TactileImages/TactilePrinterOne-P4/Imprimanta 2 Metal A3/30 Injectomat/syringe-100ml-1.snapshot.1/Syringe_100ml.jpg

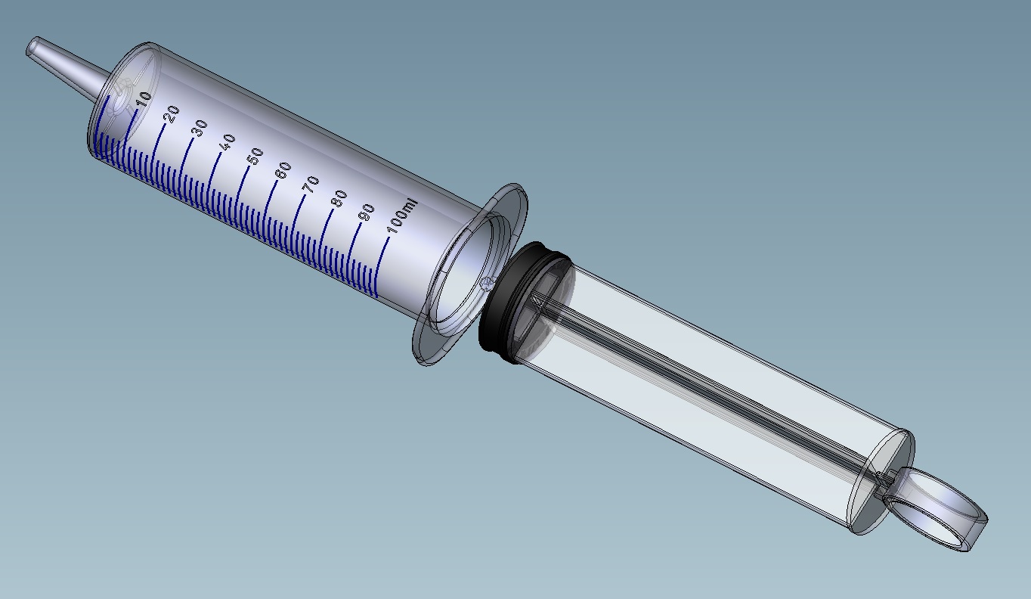
Imprimanta 2 Metal A3/30 Injectomat/syringe-100ml-1.snapshot.1/Syringe_100ml.jpg
