TactileImages/TactilePrinterOne-P4/Imprimanta 2 Metal A3/10 Mecanic/Seringa/medical-syringe-for-single-use-50ml-1.snapshot.3/Spritze-leer.JPG

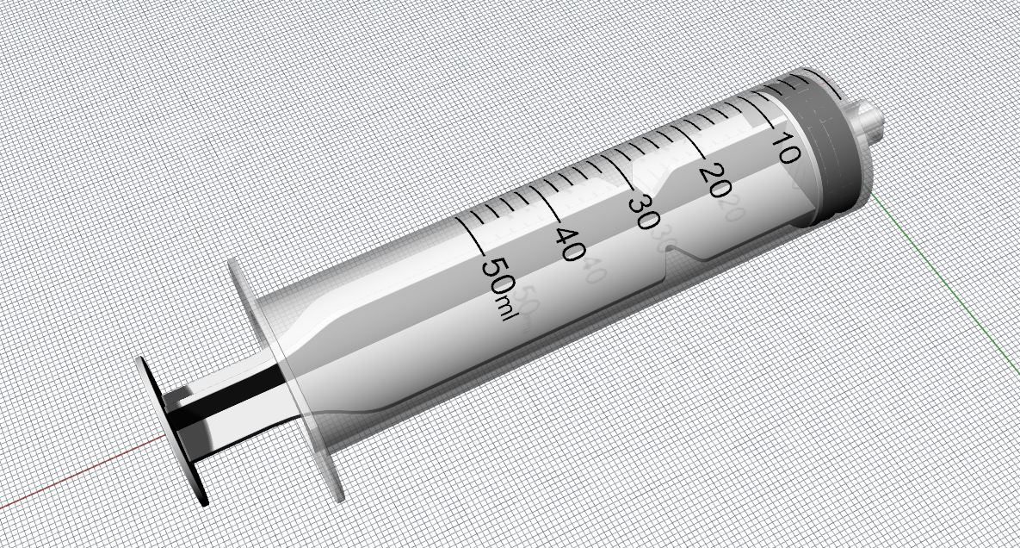
Imprimanta 2 Metal A3/10 Mecanic/Seringa/medical-syringe-for-single-use-50ml-1.snapshot.3/Spritze-leer.JPG
