TactileImages/TactilePrinterOne-P4/Imprimanta 2 Metal A3/10 Mecanic/Seringa/medical-syringe-for-single-use-50ml-1.snapshot.3/Spritze-voll.JPG

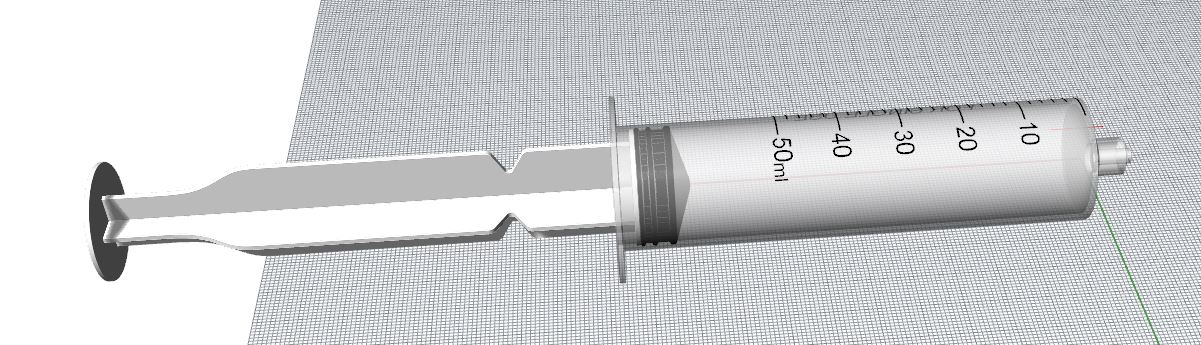
Imprimanta 2 Metal A3/10 Mecanic/Seringa/medical-syringe-for-single-use-50ml-1.snapshot.3/Spritze-voll.JPG
