TactileImages/TactilePrinterOne-P4/Imprimanta 2 Metal A3/10 Mecanic/Seringa/parametric-50ml-single-use-syringe-1.snapshot.1/Syringe 50ml v10.png

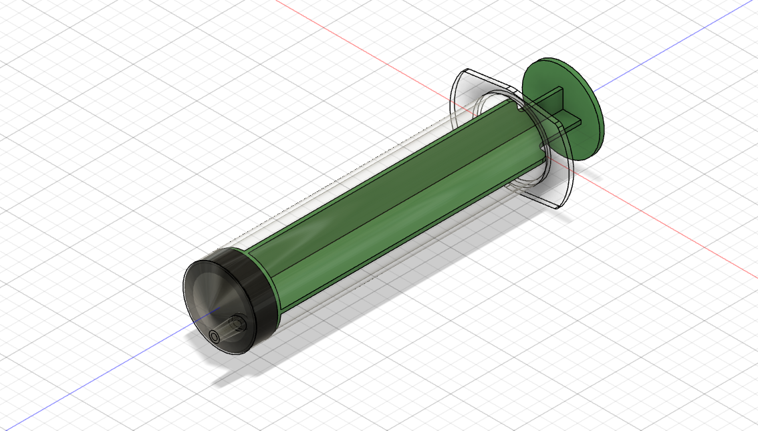
Imprimanta 2 Metal A3/10 Mecanic/Seringa/parametric-50ml-single-use-syringe-1.snapshot.1/Syringe 50ml v10.png
