TactileImages/TactilePrinterOne-P4/Imprimanta_1_Lemn/10 Mecanic/Seringa/21-gauge-needle-1.snapshot.2/Needle.png

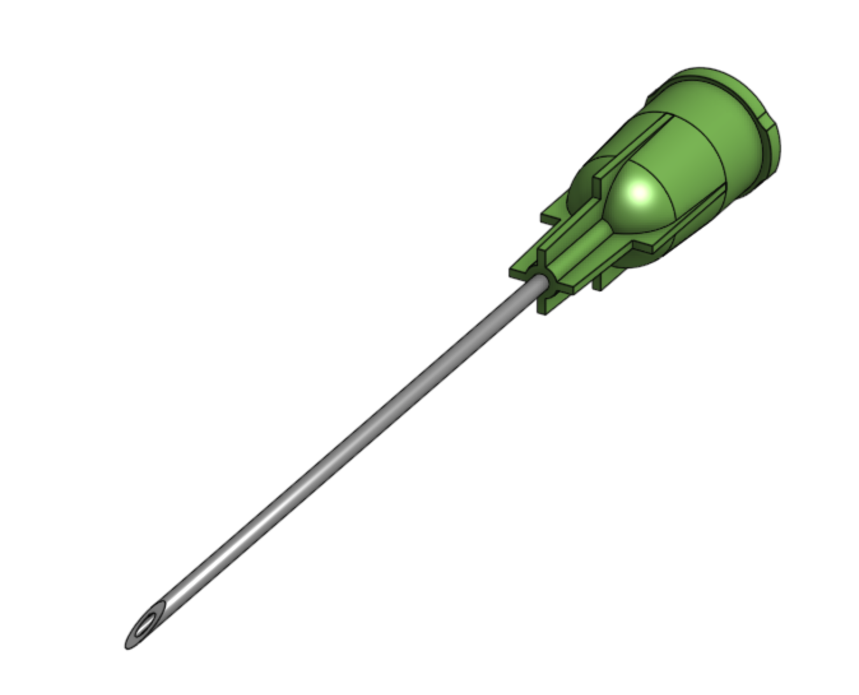
Imprimanta_1_Lemn/10 Mecanic/Seringa/21-gauge-needle-1.snapshot.2/Needle.png
