TactileImages/TactilePrinterOne-P4/Imprimanta_1_Lemn/10 Mecanic/Seringa/Renderings/syringe 20ml plastipak.png

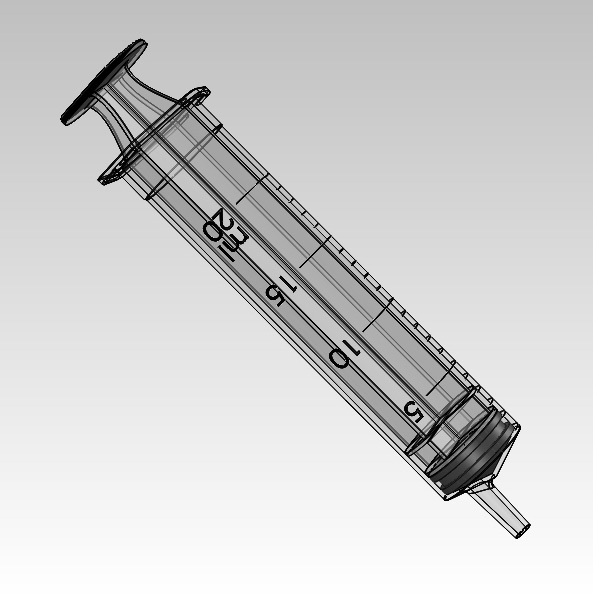
Imprimanta_1_Lemn/10 Mecanic/Seringa/Renderings/syringe 20ml plastipak.png
