TactileImages/TactilePrinterOne-P4/Imprimanta_1_Lemn/10 Mecanic/Seringa/Renderings/Syringe.jpg

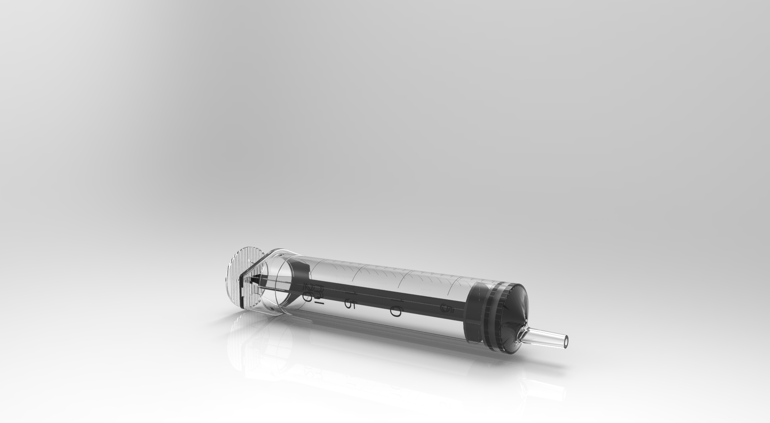
Imprimanta_1_Lemn/10 Mecanic/Seringa/Renderings/Syringe.jpg
