TactileImages/TactilePrinterOne-P4/Imprimanta_1_Lemn/10 Mecanic/Seringa/View 1.JPG

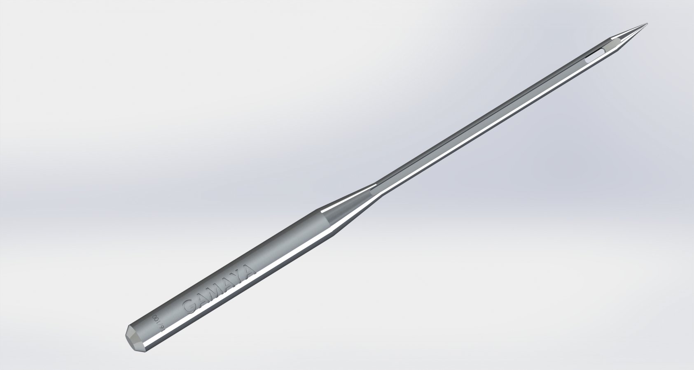
Imprimanta_1_Lemn/10 Mecanic/Seringa/View 1.JPG
