TactileImages/TactilePrinterOne-P4/Imprimanta_1_Lemn/10 Mecanic/Seringa/View 2.JPG

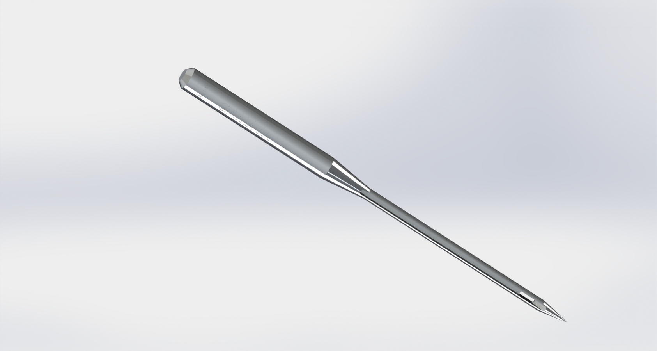
Imprimanta_1_Lemn/10 Mecanic/Seringa/View 2.JPG
