TactileImages/TactilePrinterOne-P4/Imprimanta 3 A4 Lemn Platf Fixa/BOM/BOM 3D Printer Unstructured Parts List.pdf

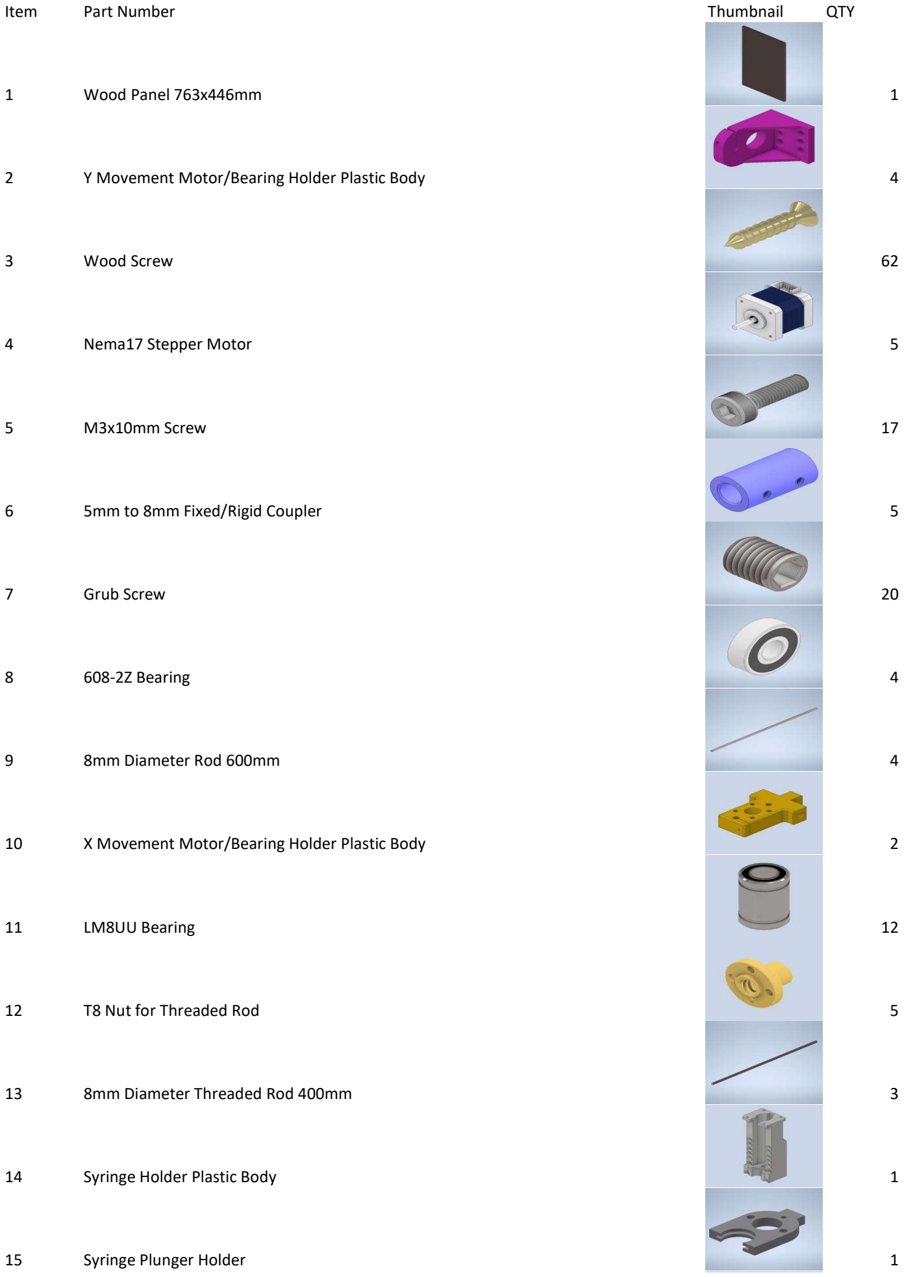
[picture p12: figure]
Item; Part Number; Thumbnail; QTY; Wood Panel 763x446mm; Wood Screw; Nema17 Stepper Motor; M3x10mm Screw; 5mm to 8mm Fixed/Rigid Coupler; Grub Screw; 608-2Z Bearing; 8mm Diameter Rod 600mm; LM8UU Bearing; T8 Nut for Threaded Rod; 8mm Diameter Threaded Rod 400mm; Syringe Holder Plastic Body; Syringe Plunger Holder

2 | Y Movement Motor/Bearing Holder Plastic Body | 4
10 | X Movement Motor/Bearing Holder Plastic Body | 2

16 | Syringe Press | 1
17 | Holder Z Movement Spacer | 1
18 | 8mm Diameter Threaded Rod 90mm | 1
19 | M3x25mm Threaded Rod | 2
20 | M3 Knurled Nut | 3
21 | Holder Z Movement Plastic Body | 1
22 | Extruder Carrier Plastic Body | 1
23 | Stepper Motor Spacer | 1
24 | Plastic Rod Screw Holder | 1
25 | Extruder Carrier Plastic Protective Cover | 1
26 | 8mm Diameter Rod 155mm | 2
27 | 8mm Diameter Threaded Rod 150mm | 1
28 | Long Wood Screw | 4
29 | M3x35mm Threaded Rod | 4
30 | M3 Nylon Lock Nut | 6
31 | M4x10mm Grub Screw | 4

32 | M3 Washer | 18
33 | Z Movement Limit Switch Screw Plastic Body | 1
34 | M3x15mm Internal Thread Spacer | 1
35 | M3x35mm Internal Thread Spacer | 1
36 | M3 Nut | 29
37 | M3x100mm Threaded Rod | 1
38 | M3x12mm Screw | 4
39 | Arduino MEGA 2560 and RAMPS Shield | 1
40 | Arduino Case Body | 1
41 | M3x10mm Internal Thread Plastic Spacer | 6
42 | Arduino Case Cover | 1
43 | 40x40x10mm 12V Fan | 1
44 | Fan Grill for 40mm Fan | 1
45 | M3x16mm Screw | 4
46 | M3 Washer | 12
47 | M3x20mm Screw | 8

48 | M3 Spring Washer | 8
49 | M3x6mm Countersunk Screw | 6
50 | M3x6mm Plastic Screw | 6
51 | Power Supply S-360-12 | 1
52 | Connector Case Body | 1
53 | Connector Case Cover | 1
54 | Power Connector with integrated Switch | 1
55 | M3x10mm Countersunk Screw | 2
56 | 25x25mm Metal Angle Bracket | 1
57 | M3x25mm Screw | 2
58 | M4 Washer | 36
59 | M4 Spring Washer | 6
60 | M4 Nut | 6
61 | M4x12mm Screw | 1
62 | M4x25mm Screw | 5
63 | M4x20mm Screw | 4

64 | Heated Bed Driver | 1
65 | M4x30mm Screw | 4
66 | M4 Nylon Lock Nut | 12
67 | Heating Element Board | 1
68 | Heated Bed Aluminum Plate | 1
69 | Temperature Sensor | 1
70 | Temperature Sensor Bracket/Press | 1
71 | M3 Isolator/Plastic Washer | 17
72 | M3x8mm Screw | 7
73 | M3x6mm Screw | 4
74 | Spring | 4
75 | M4x40mm Screw | 4
76 | M4 Wing Nut | 4
77 | Needle Parking Plastic Body | 1
78 | Bottle Cap | 1
79 | Adhesive Rubber Pad | 6

80 | X Limit Switch Plastic Body | 1
81 | MakerBot Limit Switch Board | 3
82 | Y Limit Switch Plastic Body | 1
83 | M3x30mm Screw | 3
84 | Z Limit Switch Plastic Body | 1
85 | Cable Duct 18x430mm | 1
86 | Cable Duct 18x195mm | 1
87 | Cable Duct 18x394mm | 1
88 | Cable Duct 18x205mm | 1
89 | Cable duct 18x159mm | 1
90 | Cable duct 18x180mm | 1
91 | DRV8825 Stepper Motor Driver | 5
