TactileImages/TactilePrinterOne-P4/Imprimanta 4 A4 Metal/BOM/BOM Aluminum 3D Printer Unstructured Parts List.pdf

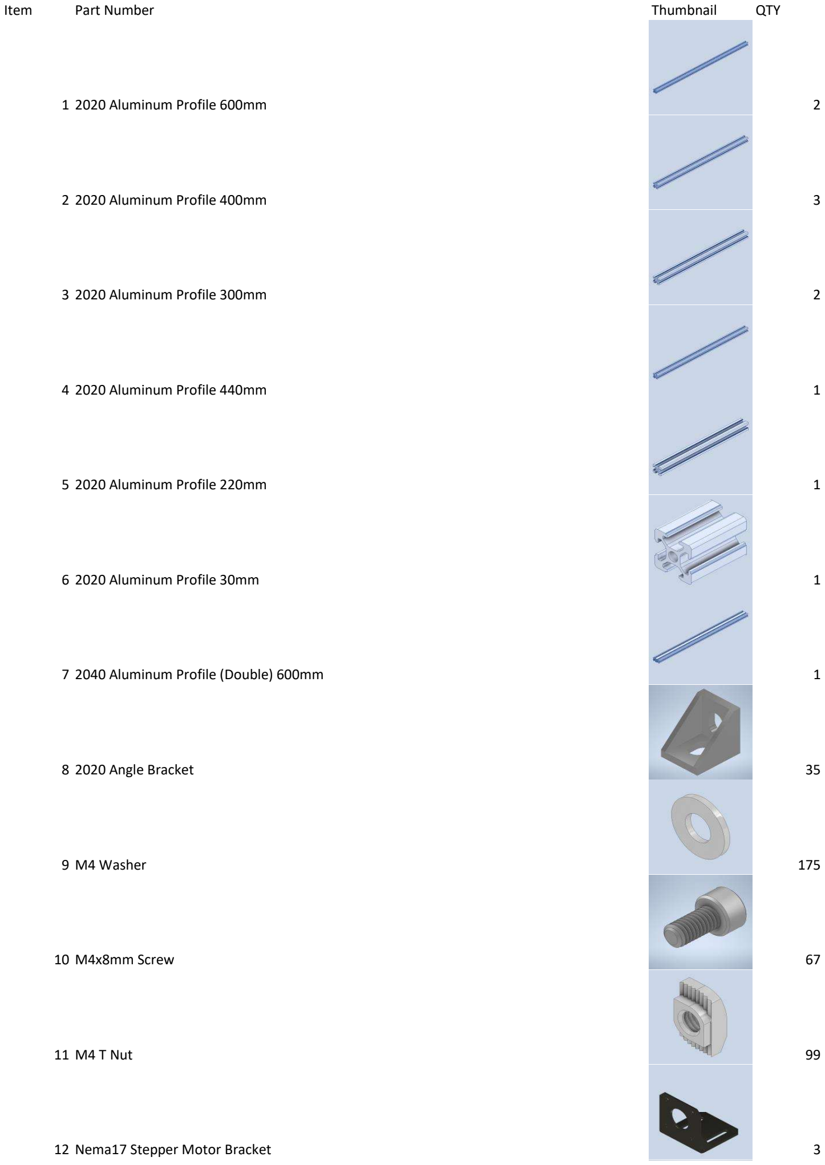
[picture p16: figure]
Item; Part Number; Thumbnail; QTY; 1 2020 Aluminum Profile 600mm; 2 2020 Aluminum Profile 400mm; 3 2020 Aluminum Profile 300mm; 4 2020 Aluminum Profile 440mm; 5 2020 Aluminum Profile 220mm; 6 2020 Aluminum Profile 30mm; 8 2020 Angle Bracket; 9 M4 Washer; 10 M4x8mm Screw; 11 M4 T Nut; 12 Nema17 Stepper Motor Bracket

7 2040 Aluminum Profile (Double) 600mm | 1

13 Nema17 Stepper Motor | 5
14 GT2 Pulley 5mm Bore | 2
15 M3x8mm Screw | 17
16 M4x10mm Grub Screw | 4
17 Arduino MEGA 2560 and RAMPS Shield | 1
18 Arduino Case Body | 1
19 M3x10mm Internal Thread Plastic Spacer | 6
20 Arduino Case Cover | 1
21 40x40x10mm 12V Fan | 1
22 Fan Grill for 40mm Fan | 1
23 Printer Logo Plate | 1
24 M3 Nut | 39

25 M3x16mm Screw | 4
26 M3 x 20mm Screw | 23
27 M3 Spring Washer | 59
28 M3x6mm Countersunk Screw | 6
29 M3x6mm Plastic Screw | 10
30 Connector Case Body | 1
31 Connector Case Cover | 1
32 Power Connector with integrated Switch | 1
33 M3x10mm Countersunk Screw | 6
34 M3 Washer | 80
35 25x25mm Metal Angle Bracket | 14
36 SK8 Vertical Rod Support Fastener | 6

37 8mm Diameter Rod 600mm | 2
38 M4x12mm Screw | 38
39 Heated Bed Aluminum Carrier Plate | 1
40 SC8UU Polyamide Bearing | 6
41 M4x20mm Screw | 23
42 M4 Nylon Lock Nut | 6
43 Y Movement Tensioner Belt Holder | 1
44 30x30mm Metal Angle Bracket | 1
45 Threaded Aluminum Block for Limit Switch Screws | 2
46 M3x10mm Screw | 19
47 M3x40mm Screw | 2
48 M3 Knurled Nut | 4

49 Custom 25x25mm Metal Angle Bracket for Y Movement Belt Tensioner | 2
50 M4x40mm Screw | 11
51 Spring 20h 2p 6d | 2
52 M4 Wing Nut | 4
53 Y Movement Belt Holder on the Motor Side | 1
54 Spring 20h 4p 8d | 4
55 Heating Element Board | 1
56 Heated Bed Aluminum Plate | 1
57 Temperature Sensor | 1
58 Temperature Sensor Bracket/Press | 1
59 M3 Isolator/Plastic Washer | 3
60 M3x6mm Screw | 4

61 M4x35mm Screw | 6
62 M4 Knurled Nut | 4
63 Belt Tensioner Plate (Creality 3D X Axis Passive Block) | 2
64 M5x20mm Washer | 14
65 M5 Nylon Lock Nut | 4
66 GT2 Idler 5mm Bore | 2
67 M5x25 Slotted Screw | 4
68 M5 Nut | 14
69 M4 Spring Washer | 31
70 M4x16mm Screw | 5
71 M4 Nut | 29
72 M4x10mm Screw | 13

73 5mm to 8mm Fixed/Rigid Coupler | 3
74 Grub Screw | 16
75 SK8 Vertical Rod Support Fastener with one mounting hole (the other one is cut) | 4
76 8mm Diameter Rod 250mm | 2
77 8mm Diameter Threaded Rod 200mm | 2
78 KP08 Bearing with one mounting hole (the other one is cut) | 2
79 X Movement Motor Holder Plate | 1
80 T8 Nut Housing | 2
81 T8 Nut for Threaded Rod | 3
82 M4x25mm Screw | 4
83 Z Movement Wheel Holder Plate | 2
84 V Wheel Ø24.4mm | 8

85 M5 Washer | 12
86 Syringe Barrel Press | 1
87 Syringe Barrel Holder | 1
88 Plastic Backplate | 1
89 Syringe Plunger Holder | 1
90 Syringe Barrel Holder Spacer | 1
91 Stepper Motor Holder | 1
92 Stepper Motor Spacer | 1
93 Syringe Barrel Flange Press | 1
94 Wheels Screws Mounting Plate | 1
95 Syringe Plunger Flange Press | 1
96 8mm Rod 136mm | 2

97 8mm Threaded Rod 133mm | 1
98 Wheels Screws Mounting Aluminum Backplate | 1
99 M5x8mm Spacer | 8
100 M3x12mm Screw | 12
101 M3x25mm Screw | 5
102 LM8UU Linear Bearing | 2
103 M3x30mm Screw | 4
104 M3x50mm Threaded Rod | 4
105 M3 Nylon Lock Nut | 4
106 M4x100mm Threaded Rod | 2
107 M4x30mm Screw | 3
108 Wood Screw | 13

109 X Movement Belt Holder | 2
110 M4 Knurled Slim Nut | 2
111 MakerBot Limit Switch Board | 3
112 M3 Plastic Nut | 4
113 M3x6mm Internal and External Thread Plastic Spacer | 4
114 Custom 30x30mm Metal Angle Bracket for X Movement Limit Switch | 1
115 Custom SK8 Plastic Vertical Rod Support Fastener | 1
116 Heated Bed Driver | 1
117 M4 Plastic/Isolator Washer | 4
118 8mm Diameter Rod 85mm | 1
119 Needle Parking Plastic Body | 1
120 Bottle Cap | 1

121 Wire Cover Case Body | 1
122 Wire Cover Case Bracket | 1
123 M3x35mm Internal Thread Spacer | 1
124 Power Supply S-240-12 | 1
125 M5x40mm Screw | 6

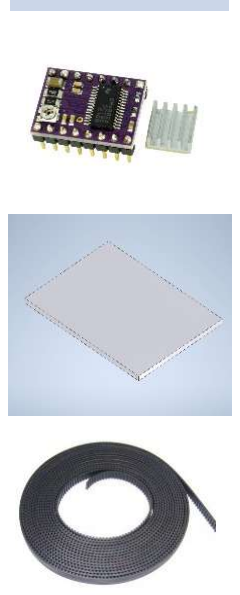
[picture p17: figure]

126 DRV8825 Stepper Motor Driver | 4
127 Wood Panel 600x440mm | 1
128 GT2 Belt 6mm Width, 3m length | 1
