TactileImages/TactilePrinterOne-P4/Imprimanta_1_Lemn/0005-00-00 Partlist.xls

Sheet: 00-00
 |  | General Assemble
Subject | Number Of pce | Description | Weight | Width | Thickness | Length | Material | Produced/Buyed | Status | Price for PCE | Total Price
10–01 | 1 | Skeleton
10-02 | 1 | X axis
10-03 | 1 | Y Axis
10-04 | 1 | Z axis and extruder
20 | 1 | Electric components

Sheet: 10-01
 |  | Skeleton
Subject | Number Of pce | Description | Weight | Width | Thickness | Length | Material | Produced/Buyed | Status | Price for PCE | Total Price
001 | 1 |  | 3.586 kg | 420 | 20 | 640 | wood
017 | 1 |  | 0.667 kg | 380 | 20 | 420 | wood
024 | 2 |  | 1.066 kg | 200 | 20 | 400 | wood
026 | 1 |  | 0.010 kg | 54.5 | 8 | 66 | wood
10-1022 | 21 | Cross recessed countersunk (flat) head tapping screws (common head style) | 0.028 kg
10-1023 | 4 | Hexagon head screws. Product grade C | 0.022 kg
10-1027 | 2 | Cross recessed countersunk (flat) head tapping screws (common head style) | 0.004 kg

Sheet: 10-02
 |  | X axis
Subject | Number Of pce | Description | Weight | Width | Thickness | Length | material | Produced/Buyed | Status | Price for PCE | Total Price
011 | 1 |  | 0.029 kg | 66 | 8 | 89.5 | wood
012 | 2 |  | 0.052 kg | 66 | 8 | 150 | wood
015 | 4 |  | 0.015 kg | 30 | 20 | 45 | Wood
018 | 1 |  | 0.014 kg | 30 | 30 | 30 | Wood
023 | 1 |  | 0.019 kg | 65 | 8 | 80 | Wood
027 | 1 |  | 0.028 kg | 66 | 8 | 87.5 | Wood
10-1001 | 1 | Nema 17 stepper | 0.067 kg
10-1007 | 2 |  | 0.030 kg
10-1009 | 4
10-1010 | 1
10-1011 | 1
10-1013 | 64 | Plain washers - Normal series - Product grade A | 0.000 kg
10-014 | 32 | Hexagon nuts, style 1 - Product grades A and B | 0.001 kg
10-1015 | 1 | GT 2 Belt | 0.005 kg
10-1020 | 4 | Plain washers - Normal series - Product grade A | 0.000 kg
10-1024 | 14 | Hexagon head screws | 0.005 kg
10-1032 | 4 | Cylinder Head Cap Screw | 0.001 kg
10-1033 | 4 | Hexagon Socket Set Screw | 0.001 kg
10-1045 | 16 | Cross recessed countersunk (flat) head tapping screws (common head style) | 0.002 kg
10-1046 | 16 | Hex-Head Bolt | 0.006 kg
10-1047 | 2 | Hex-Head Bolt | 0.007 kg
10-1048 | 1 | Hex-Head Bolt | 0.005 kg

Sheet: 10-03
 |  | Y Axis
Subject | Number Of pce | Description | Weight | Width | Thickness | Length | Material | Produced/Buyed | Status | Price for PCE | Total Price
013 | 1 |  | 0.605 kg | 230 | 3 | 325 | Aluminium
014 | 1 |  | 0.308 kg | 230 | 8 | 325 | Wood
015 | 4 |  | 0.015 kg | 30 | 20 | 45 | Wood
019 | 1 |  | 0.021 kg | 30 | 30 | 30 | Wood
020 | 1 |  | 0.015 kg | 40 | 8 | 50 | Wood
025 | 1 | Sensor activator | 0.009 kg | 25 | 20 | 50 | Wood
10-1001 | 1 |  | 0.067 kg
10-1008 | 2 |  | 0.045 kg
10-1009 | 4
10-1010 | 1 | belt wheel 20 teeth GT2
10-1011 | 1 | belt wheel
10-1013 | 4 | Plain washers - Normal series - Product grade A | 0.000 kg
10-1014 | 2 | Hexagon nuts, style 1 - Product grades A and B | 0.001 kg
10-1016 | 1 |  | 0.007 kg
10-1020 | 4 | Plain washers - Normal series - Product grade A | 0.000 kg
10-1027 | 3 | Cross recessed countersunk (flat) head tapping screws (common head style) | 0.004 kg
10-1032 | 4 | Cylinder Head Cap Screw | 0.001 kg
10-1033 | 4 | Hexagon Socket Set Screw | 0.001 kg
10-1035 | 1 | Hex Nut | 0.001 kg
10-1036 | 2 | Washer | 0.000 kg
10-1037 | 4 | Wing Nut | 0.003 kg
10-1045 | 2 | Cross recessed countersunk (flat) head tapping screws (common head style) | 0.002 kg
10-1047 | 2 | Hex-Head Bolt | 0.007 kg
10-1048 | 1 | Hex-Head Bolt | 0.005 kg
10-1049 | 4 | Hexagon socket countersunk head cap screws | 0.004 kg
10-1040 | 4 | Compress spring | 0.000 kg
wire necklace | 8 |  | 0.001 kg

Sheet: 10-04
 |  | Z axis and extruder
Subject | Number Of pce | Description | Weight | Width | Thickness | Length | Material | Produced/Buyed | Status | Price for PCE | Total Price
002 | 1 |  | 0.012 kg | 32 | 8 | 60 | wood
003 | 1 |  | 0.014 kg | 45 | 8 | 65 | wood
004 | 1 |  | 0.007 kg | 30 | 8 | 45 | wood
005 | 1 |  | 0.026 kg | 60 | 8 | 73 | wood
006 | 2 |  | 0.005 kg | 30 | 8 | 30 | wood
007 | 1 |  | 0.026 kg | 54.5 | 8 | 66 | wood
008 | 2 |  | 0.029 kg | 35 | 8 | 155 | wood
009 | 1 |  | 0.051 kg | 65 | 8 | 97 | wood
010 | 1 |  | 0.037 kg | 73.5 | 8 | 85 | wood
016 | 1 |  | 0.022 kg | 42 | 8 | 66 | wood
021 | 1 |  | 0.009 kg | 30 | 8 | 45 | wood
10-1000 | 1 | Lm 8 Bearing | 0.0 kg
10-1001 | 2 | Nema 17 Stepper | 0.067 kg
10-1002 | 2 | Hub cupling from 5mm to 8 mm | 0.003 kg
10-1003 | 2 | t8 axis | 0.008 kg
10-1004 | 2 | t8 nut | 10.321 g
10-1005 | 2 | Rolling bearings - Instrument precision bearings | 0.012 kg
10-1006 | 2 | 10 mm axis | 0.104 kg
10-1009 | 4 | Lm 10 uu Bearing | 0.013 lbmass
10-1018 | 1 | 8 mm axis | 0.066 kg
10-1019 | 8 | Hexagon Socket Head Cap Screw M3 x 30 | 0.002 kg
10-1020 | 44 | Plain washers - Normal series ISO 7089-3 | 0.000 kg
10-1021 | 20 | Hexagon nuts,ISO 4032-M3 | 0.000 kg
10-1032 | 11 | Cylinder Head Cap Screw DIN 7984-M3x16 | 0.001 kg
10-1033 | 4 | Hexagon Socket Set Screw DIN 914 M5 x 10 | 0.001 kg
10-1043 | 4 | Hexagon socket countersunk head cap screws M3 x 25 | 0.001 kg
10-1045 | 12 | Cross recessed countersunk (flat) head tapping screws (common head style) | 0.002 kg
10-1052 | 4 | Cross recessed countersunk (flat) head tapping screws (common head style) | 0.001 kg
10-1053 | 4 | Hexagon Socket Head Cap Screw M3 x 25 | 0.002 kg
syringe | 1 | Syringe 20 ml
Needle | 1
wire necklace | 8

Sheet: 20 Electric
 |  | Electric components
Subiect | nr Buc | Description | Weight | Width | Thickness | Length | Material | Produced/Buyed | Status | Price for PCE | Total Price
20-1001 | 1 | Arduino mega | 0.102 lbmass |  |  |  | cumparat |  |  |  | 0
20-1003 | 3 | Limit swich | 0.004 lbmass |  |  |  | cumparat |  |  |  | 0
20-1004 | 1 | 12 Volt Power suply |  |  |  |  | cumparat |  |  |  | 0
20-1005 | 1 | AC in |  |  |  |  | cumparat |  |  |  | 0
20-1006 | 1 | Ramps 1.4 |  |  |  |  | cumparat |  |  |  | 0
20-1007 | 4 | Stepper driver A4988 |  |  |  |  | cumparat |  |  |  | 0
20-10008 | 4 | cablu nema |  |  |  |  | cumparat |  |  |  | 0
20-10009 | 2 | Pat cablu |  |  |  | 1000 | cumparat |  |  |  | 0
 |  |  |  |  |  |  |  |  |  | 0
