TactileImages/TactilePrinterOne-P4/Imprimanta 2 Metal A3/0008-00-00 Partlist.xls

Sheet: 00-00
 |  | General Assemble |  |  |  |  |  |  |  |  | total imprimanta | 3925.78
Subject | Number Of pce | Description | Weight | Width | Thickness | Length | Material | Produced/Buyed | Status | Price for PCE | Total Price |  | 79.7
10-01 | 1 | Skeleton |  |  |  |  |  |  |  |  | 2737.55
10-02 | 1 | X axis
10-03 | 1 | Y Axis
10-04 | 1 | Z axis
10-10 | 1 | Injectomat
20-00 | 1 | Electric Part |  |  |  |  |  |  |  |  | 588.23
026 | 1 | Suport cutie Arduino | 0.077 kg |  |  |  |  | Produced
027 | 1 | Cutie Arduino | 0.129 kg |  |  |  |  | Produced | Printare | 16 | 16
028 | 1 | Cutie mofset | 0.068 kg |  |  |  |  | Produced
029 | 1 | Capac Arduino | 0.066 kg |  |  |  |  | Produced
038 | 1 | Carcasa fata Display | 0.022 kg |  |  |  |  | Produced | Printat | 5.5 | 5.5
039 | 1 | Carcasa spate Display | 0.065 kg |  |  |  |  | Produced | Printare | 10.2 | 10.2
040 | 1 | Buton de urgenta | 0.000 kg |  |  |  |  | Produced
41 | 1 | Ciuperca | 0.001 kg |  |  |  |  | Produced
42 | 1 | Joistic | 0.002 kg |  |  |  |  | Produced
43 | 1 | Suport display | 0.020 kg |  |  |  |  | Produced
44 | 1 | Suport display | 0.018 kg |  |  |  |  | Produced
45 | 1 | Suport display | 0.021 kg |  |  |  |  | Produced
49 | 1 | Capac mofset | 0.049 kg |  |  |  |  | Produced
50 | 1 | Capac priza | 0.019 kg |  |  |  |  | Produced
51 | 1 | Cutie priza | 0.165 kg |  |  |  |  | Produced |  | 16 | 16
2001 | 3 | DIN 934 M4 x0,7 | 0.001 kg |  |  |  |  | Buyed
2002 | 6 | DIN 125-A4,3 | 0.000 kg |  |  |  |  | Buyed
2004 | 8 | DIN 7984- M3 x 20 | 0.001 kg |  |  |  |  | Buyed
2005 | 16 | DIN 125 A3,2 | 0.000 kg |  |  |  |  | Buyed
2006 | 8 | DIN 7984 - M3x16 | 0.001 kg |  |  |  |  | Buyed
2010 | 8 | Piulita de canal M5 | 0.004 lbmass |  |  |  |  | Buyed |  | 4 | 32
2011 | 6 | Cylinder Head Cap Screw M5 x16 | 0.004 kg |  |  |  |  | Buyed
2012 | 6 | Washer 5,3 | 0.000 kg |  |  |  |  | Buyed
2015 | 2 | Cylinder Head Cap Screw M5x8 | 0.003 kg |  |  |  |  | Buyed
2028 | 3 | Cylinder Head Cap Screw M4X12 | 0.002 kg |  |  |  |  | Buyed
2029 | 2 | Hex-Head Bolt M8 X55 | 0.027 kg |  |  |  |  | Buyed
2030 | 6 | Wing Nut M8 | 0.017 kg |  |  |  |  | Buyed
2032 | 4 | Washer 8.4 | 0.002 kg |  |  |  |  | Buyed
2033 | 4 | Cylinder Head Cap Screw M8 X80 | 0.036 kg |  |  |  |  | Buyed
2034 | 10 | Hexagon socket countersunk head cap screws M3X25 | 0.001 kg |  |  |  |  | Buyed
2035 | 2 | Hexagon socket countersunk head cap screws M4 X25 | 0.003 kg |  |  |  |  | Buyed
2036 | 2 | Cylinder Head Cap Screw | 0.015 kg |  |  |  |  | Buyed
2037 | 2 | Washer 6.3 | 0.001 kg |  |  |  |  | Buyed
2038 | 2 | Hex Nut M6 | 0.003 kg |  |  |  |  | Buyed

Sheet: 10-01
 |  | Skeleton |  |  |  |  |  |  |  |  | 916.14
Subject | Number Of pce | Description | Weight | Width | Thickness | Length | Material | Produced/Buyed | Status | Price for PCE | Total Price
022 | 1 | Placa rigidizare | 3.962 kg |  |  |  |  | Buyed |  | 130 | 130
023 | 4 | Suport L | 0.030 kg |  |  |  |  | Produced | Printat | 3.5 | 14
024 | 4 | Ranforsare | 0.093 kg |  |  |  |  | Produced | Printare | 10.55 | 42.2
030 | 4 | Suport L | 0.015 kg |  |  |  |  | Produced | printat | 1.75 | 7
031 | 2 | Suport | 0.069 kg |  |  |  |  | Produced | Printat | 8.78 | 17.56
032 | 2 | Suport cadru | 0.043 kg |  |  |  |  | Produced | printat | 7.21 | 14.42
033 | 1 | Suport Axa Z | 0.108 kg |  |  |  |  | Produced | printat | 12.5 | 12.5
035 | 1 | Suport Axa Z | 0.108 kg |  |  |  |  | Produced | Printat | 12.5 | 12.5
053 | 4 | Picior imprimanta | 0.002 kg |  |  |  |  | Produced | Printare | 0.5 | 2
1018 | 3 | Profil Aluminiu | 0.208 kg | 20 | 40 | 700 |  | Buyed | Comandat | 343.96 | 343.96
1019 | 2 | Profil ALuminiu | 0.196 kg | 20 | 40 | 660 |  | Buyed | Comandat
1020 | 2 | Profil ALuminiu | 0.434 kg | 20 | 40 | 540 |  | Buyed | Comandat
1021 | 2 | Profil ALuminiu | 0.056 kg | 20 | 40 | 70 |  | Buyed | Comandat
2010 | 80 | Piulita de canal M5 | 0.004 lbmass |  |  |  |  | Buyed | Comandat | 4 | 320
2011 | 52 | Cylinder Head Cap Screw M5 x16 | 0.004 kg |  |  |  |  | Buyed
2012 | 68 | Washer 5,3 | 0.000 kg |  |  |  |  | Buyed
2013 | 8 | Cylinder Head Cap Screw M5x20 | 0.004 kg |  |  |  |  | Buyed
2014 | 8 | Cylinder Head Cap Screw M5 x25 | 0.005 kg |  |  |  |  | Buyed
2015 | 12 | Cylinder Head Cap Screw M5 x8 | 0.003 kg |  |  |  |  | Buyed

Sheet: 10-02
 |  | X axis |  |  |  |  |  |  |  |  | 486.49
Subject | Number Of pce | Description | Weight | Width | Thickness | Length | material | Produced/Buyed | Status | Price for PCE | Total Price
006 | 1 | Suport Injectomat | 0.330 kg |  |  |  |  | Produced
007 | 1 | Contra suport | 0.602 kg |  |  |  |  | Produced
008 | 1 | Suport Axa X | 0.328 kg |  |  |  |  | Produced | Printat | 40 | 40
009 | 1 | Supăort Axa X | 0.295 kg |  |  |  |  | Produced | Printare | 31.13 | 31.13
010 | 6 | Fixare Axa | 0.009 kg |  |  |  |  | Produced | Printare | 1.2 | 7.2
011 | 2 | Fixare Axa mijloc | 0.016 kg |  |  |  |  | Produced | Printat | 1.2 | 2.4
012 | 1 | Intinzator X | 0.009 kg |  |  |  |  | Produced |  |  | 0
013 | 2 | Suport Piulita Z | 0.017 kg |  |  |  |  | Produced | Printat | 2.5 | 5
046 | 1 | Fixare Axa si portcablu | 0.038 kg |  |  |  |  | Produced | Printare | 5 | 5
1001 | 1 | Motor Nema 17 | 0.180 kg |  |  |  |  | Buyed |  | 45.76 | 45.76
1011 | 1 | Roata curea Motor | 0.010 lbmass |  |  |  |  | Buyed |  | 17.67 | 17.67
1004 | 2 | Piulita T8 | 10.321 g |  |  |  |  | Buyed |  | Inclus in axa Z
1008 | 3 | Bara 10 | 0.351 kg |  |  | 600 |  | Buyed |  | 28.56 | 85.68
1009 | 5 | Rulment LM 10 | 0.013 lbmass |  |  |  |  | Buyed |  | 8.84 | 44.2
1012 | 1 | Roata curea intinzator | 0.001 lbmass |  |  |  |  | Buyed |  | 9.9 | 9.9
1013 | 4 | Rulment LMK 10 | 0.019 lbmass |  |  |  |  | Buyed |  | 23.99 | 95.96
1023 | 2 | Arc intinzator |  |  |  |  |  | Buyed |  | 1.18 | 2.36
1024 | 1 | Curea GT2 | 0.002 kg |  |  |  |  | Buyed |  | 14.73 | 14.73
1025 | 2 | Lant Portcablu | 0.034 kg |  |  |  |  | Buyed |  | 39.75 | 79.5
2000 | 16 | DIN6912 M4x25 | 0.003 kg |  |  |  |  | Buyed
2002 | 120 | DIN 125-A4,3 | 0.000 kg |  |  |  |  | Buyed
2001 | 60 | DIN 934 M4 x0,7 | 0.001 kg |  |  |  |  | Buyed
2003 | 10 | DIN 6912 - M4x35 | 0.004 kg |  |  |  |  | Buyed
2005 | 10 | DIN 125 A3,2 | 0.000 kg |  |  |  |  | Buyed
2004 | 4 | DIN 7984- M3 x 20 | 0.001 kg |  |  |  |  | Buyed
2006 | 10 | DIN 7984 – M3x16 Cap innecat | 0.001 kg |  |  |  |  | Buyed
2009 | 14 | DIN 555-5 M3x0,5 | 0.000 kg |  |  |  |  | Buyed
2012 | 1 | Washer 5,3 | 0.000 kg |  |  |  |  | Buyed
2018 | 24 | DIN 912 - M4 x 40 | 0.005 kg |  |  |  |  | Buyed
2019 | 10 | DIN 6912 - M4 x 50 | 0.006 kg |  |  |  |  | Buyed
2020 | 6 | DIN 7991 - M3 x 16 | 0.001 kg |  |  |  |  | Buyed
2021 | 1 | DIN 7984 - M5 x 30 | 0.006 kg |  |  |  |  | Buyed
2022 | 1 | DIN 934 - M5 | 0.001 kg |  |  |  |  | Buyed
20-1003 | 1 | STEP AP214 | 0.004 lbmass |  |  |  |  | Buyed

Sheet: 10-03
 |  | Y Axis |  |  |  |  |  |  |  |  | 661.84
Subject | Number Of pce | Description | Weight | Width | Thickness | Length | Material | Produced/Buyed | Status | Price for PCE | Total Price
017 | 1 | Pat incalzit | 1.129 kg |  |  |  |  | Produced |  | 120 | 120
018 | 1 | SUport Pat | 0.813 kg |  |  |  |  | Produced |  | 120 | 120
019 | 2 | Suport Axa | 0.017 kg |  |  |  |  | Produced
020 | 3 | Suport Axa | 0.016 kg |  |  |  |  | Produced
036 | 1 | Intinzator Y | 0.010 kg |  |  |  |  | Produced
037 | 1 | Suport Intinzator | 0.059 kg |  |  |  |  | Produced
047 | 1 | Suport rulment si CUrea | 0.028 kg |  |  |  |  | Produced
048 | 1 | Suport Nema | 0.032 kg |  |  |  |  | Produced
052 | 1 | Suport Axa + Senzor | 0.030 kg |  |  |  |  | Produced
054 | 1 | Suport Doking | 0.030 kg |  |  |  |  | Produced
055 | 1 | Doking | 0.086 kg |  |  |  |  | Produced
1001 | 1 | Motor Nema 17 | 0.180 kg |  |  |  |  | Buyed |  | 45.76 | 45.76
20-1007 | 2 | Element incalzitor | 0.202 lbmass |  |  |  |  | Buyed | Comandat | Vezi electric
1011 | 1 | Roata curea Motor | 0.010 lbmass |  |  |  |  | Buyed |  | 17.67 | 17.67
1012 | 1 | Roata curea intinzator | 0.001 lbmass |  |  |  |  | Buyed |  | 13.12 | 13.12
1016 | 5 | Rulment SC 10 UU | 0.063 lbmass |  |  |  |  | Buyed |  | 19.7 | 98.5
1017 | 3 | Bara 10 | 0.432 kg |  |  | 700 |  | Buyed |  | 33.32 | 99.96
1023 | 6 | Arc intinzator | 0.000 kg |  |  |  |  | Buyed |  | 1.18 | 7.08
1026 | 1 | Lant Portcablu | 0.047 kg |  |  |  |  | Buyed |  | 39.75 | 39.75
1027 | 1 | Curea Gt2 x 6 mm | 0.003 kg |  |  |  |  | Buyed |  | 28 | 28
2000 | 26 | DIN6912 M4x25 | 0.003 kg |  |  |  |  | Buyed
2001 | 5 | DIN 934 M4 x0,7 | 0.001 kg |  |  |  |  | Buyed
2002 | 30 | DIN 125-A4,3 | 0.000 kg |  |  |  |  | Buyed
2005 | 4 | DIN 125 A3,2 | 0.000 kg |  |  |  |  | Buyed
2006 | 4 | DIN 7984 - M3x16 | 0.001 kg |  |  |  |  | Buyed
2010 | 18 | Piulita de canal M5 | 0.004 lbmass |  |  |  |  | Buyed | Comandat | 4 | 72
2011 | 16 | Cylinder Head Cap Screw M5 x16 | 0.004 kg |  |  |  |  | Buyed
2012 | 18 | Washer 5,3 | 0.000 kg |  |  |  |  | Buyed
2016 | 8 | Wing Nut | 0.003 kg |  |  |  |  | Buyed
2017 | 2 | DIN 7991 - M4x20 | 0.002 kg |  |  |  |  | Buyed
2018 | 3 | DIN 912 - M4 x 40 | 0.005 kg |  |  |  |  | Buyed
2024 | 4 | DIN 7991 - M4 x 35 | 0.004 kg |  |  |  |  | Buyed
20-1003 | 1 | STEP AP214 Lim it sweich | 0.004 lbmass |  |  |  |  | Buyed

Sheet: 10-04
 |  | Z axis |  |  |  |  |  |  |  |  | 326.32
Subject | Number Of pce | Description | Weight | Width | Thickness | Length | Material | Produced/Buyed | Status | Price for PCE | Total Price
015 | 2 | Roata GT2 | 0.071 kg |  |  |  |  | Produced
016 | 1 | Suport Motor Z L | 0.086 kg |  |  |  |  | Produced
021 | 1 | Suport Motor Z R | 0.086 kg |  |  |  |  | Produced
034 | 2 | Suport Rulment | 0.007 kg |  |  |  |  | Produced
056 | 1 | Suport Senzor | 0.012 kg |  |  |  |  | Produced
1001 | 2 | Motor Nema 17 | 0.180 kg |  |  |  |  | Buyed |  | 45.76 | 91.52
1005 | 4 | Rolling bearings - Instrument precision bearings | 0.006 kg |  |  |  |  | Buyed |  | 7.07 | 28.28
1010 | 2 | Bara 10 | 0.364 kg |  |  | 600 |  | Buyed |  | 28.56 | 57.12
1011 | 2 | Roata curea Motor | 0.010 lbmass |  |  |  |  | Buyed |  | 17.67 | 35.34
1014 | 2 | Surub T8 | 0.197 kg |  |  |  |  | Buyed |  | 29.99 | 59.98
1015 | 2 | Curea Inchisa GT 2 | 0.000 kg |  |  |  |  | Buyed |  | 11 | 22
1022 | 4 | SHF10 | 0.011 lbmass |  |  |  |  | Buyed |  |  | 0
2000 | 4 | DIN6912 M4x25 | 0.003 kg |  |  |  |  | Buyed |  |  | 0
2001 | 16 | DIN 934 M4 x0,7 | 0.001 kg |  |  |  |  | Buyed |  |  | 0
2002 | 24 | DIN 125-A4,3 | 0.000 kg |  |  |  |  | Buyed |  |  | 0
2003 | 8 | DIN 6912 - M4x35 | 0.004 kg |  |  |  |  | Buyed |  |  | 0
2005 | 8 | DIN 125 A3,2 | 0.000 kg |  |  |  |  | Buyed |  |  | 0
2006 | 10 | DIN 7984 - M3x16 | 0.001 kg |  |  |  |  | Buyed |  |  | 0
2010 | 8 | Piulita de canal M5 | 0.004 lbmass |  |  |  |  | Buyed |  | 4.01 | 32.08
2011 | 8 | Cylinder Head Cap Screw M5 x16 | 0.004 kg |  |  |  |  | Buyed |  |  | 0
2012 | 8 | Washer 5,3 | 0.000 kg |  |  |  |  | Buyed |  |  | 0
2025 | 4 | Cylinder Head Cap Screw M4X20 | 0.003 kg |  |  |  |  | Buyed |  |  | 0
2026 | 8 | DIN 916 - M4 x 10 | 0.001 kg |  |  |  |  | Buyed |  |  | 0
20-1003 | 1 | STEP AP214 Limit sweich | 0.004 lbmass |  |  |  |  | Buyed |  |  | 0

Sheet: 10-10
 |  | Injectomat |  |  |  |  |  |  |  |  | 267.06
Subject | Number Of pce | Description | Weight | Width | Thickness | Length | Material | Produced/Buyed | Status | Price for PCE | Total Price
001 | 1 | Actionator seringa | 0.061 kg |  |  |  |  | Produce | Printat | 7 | 7
002 | 1 | Corp Injectomat | 0.610 kg |  |  |  |  | Produce | Printat | 99 | 99
003 | 1 | Fixare Cap seringa | 0.005 kg |  |  |  |  | Produce | printat | 2 | 2
004 | 1 | Fixare Seringa | 0.013 kg |  |  |  |  | Produce | printat
005 | 1 | Suport_Rulment | 0.007 kg |  |  |  |  | Produce
1000 | 2 | Rulment LML 8UU | 0.127 lbmass |  |  |  |  | Buyed | Buyed | 19.99 | 39.98
1001 | 1 | Motor Nema 17 | 0.180 kg |  |  |  |  | Buyed |  | 45.76 | 45.76
1002 | 1 | Hub 5-8 | 0.008 kg |  |  |  |  | Buyed |  | 6.45 | 6.45
1003 | 1 | Surub T8 | 0.073 kg |  |  |  |  | Buyed | buyed | 20 | 20
1004 | 1 | Piulita T8 | 10.321 g |  |  |  |  | Buyed | buyed | 8.84 | 8.84
1005 | 1 | Rolling bearings - Instrument precision bearings | 0.006 kg |  |  |  |  | Buyed |  | 7.07 | 7.07
1006 | 4 | STEP AP203 | 0.012 lbmass |  |  |  |  | Buyed | Printare | 1.5 | 6
1007 | 2 | Bara 8 | 0.011 kg |  |  |  |  | Buyed | buyed | 12.48 | 24.96
2000 | 6 | DIN6912 M4x25 | 0.003 kg |  |  |  |  | Buyed |  |  | 0
2001 | 24 | DIN 934 M4 x0,7 | 0.001 kg |  |  |  |  | Buyed |  |  | 0
2002 | 24 | DIN 125-A4,3 | 0.000 kg |  |  |  |  | Buyed |  |  | 0
2003 | 10 | DIN 6912 - M4x35 | 0.004 kg |  |  |  |  | Buyed |  |  | 0
2005 | 12 | DIN 125 A3,2 | 0.000 kg |  |  |  |  | Buyed |  |  | 0
2006 | 8 | DIN 7984 - M3x16 | 0.001 kg |  |  |  |  | Buyed |  |  | 0
2007 | 8 | Cylinder Head Cap Screw M4X16 | 0.002 kg |  |  |  |  | Buyed |  |  | 0
2008 | 4 | Cylinder Head Cap Screw M3X25 | 0.002 kg |  |  |  |  | Buyed |  |  | 0
2009 | 8 | DIN 555-5 M3x0,5 | 0.000 kg |  |  |  |  | Buyed |  |  | 0

Sheet: 20 Electric
 |  | Electric components |  |  |  |  |  |  |  |  | 588.23
Subiect | nr Buc | Description | Weight | Width | Thickness | Length | Material | Produced/Buyed | Status | Price for PCE | Total Price
20-1001 | 1 | Arduino mega | 0.102 lbmass |  |  |  | cumparat | Buyed | for buy | 52.77 | 52.77
20-1003 | 3 | Limit swich | 0.004 lbmass |  |  |  | cumparat | Buyed | buyed | 8.65 | 25.95
20-1004 | 2 | 12 Volt Power suply |  |  |  |  | cumparat | Buyed | for buy | 99 | 198
20-1005 | 2 | Mofset |  |  |  |  | cumparat | Buyed | for buy | 22.28 | 44.56
20-1006 | 1 | Ac in |  |  |  |  | cumparat | Buyed | for buy | 13 | 13
20-1007 | 2 | Rep rap heated bed |  |  |  |  | cumparat | Buyed | Comandat | 45 | 90
20-1010 | 1 | 40 mm Fan |  |  |  |  | cumparat | Buyed | for buy | 12.76 | 12.76
20-1011 | 1 | ReprapDiscountFullGraphicSmartControlle |  |  |  | 1000 | cumparat | Buyed | Comandat | 80 | 80
20-1012 | 1 | Ramps 1.4 |  |  |  |  |  | Buyed | for buy | 28.99 | 28.99
20-1013 | 4 | Stepper driver A4988 |  |  |  |  |  | Buyed | for buy | 10.55 | 42.2
20-2014 | 1 | Spliter nema 17 |  |  |  |  |  | Buyed | For Buy
