TactileImages/TactilePrinterOne-P4/Imprimanta 2 Metal A3/30 Injectomat/0008-30-00 Partlist.xls

 |  | General Assemble |  |  |  |  |  |  |  |  | total imprimanta | 600
Subject | Number Of pce | Description | Weight | Width | Thickness | Length | Material | Produced/Buyed | Status | Price for PCE | Total Price |  | 0
001 | 1 | Actionator seringa | 0.032 kg
002 | 1 | Corp Injectomat | 0.565 kg
004 | 1 |  | 0.022 kg
005 | 1 |  | 0.095 kg
006 | 1 |  | 0.006 kg
007 | 1 |  | 0.003 kg
008 | 2 |  | 0.002 kg
009 | 1 |  | 0.014 kg
010 | 1 |  | 0.037 kg
011 | 1 |  | 0.203 kg
012 | 1 |  | 0.126 kg
013 | 1 |  | 0.027 kg
014 | 1 |  | 0.132 kg
015 | 1 | Roata GT2 | 0.056 kg
1000 | 2 | Rulment LML 8UU | 0.127 lbmass
1001 | 1 | Motor Nema 17 | 0.180 kg
1003 | 1 | Surub T8 | 0.083 kg
1004 | 1 | Piulita T8 | 10.321 g
1005 | 2 | Rolling bearings - Instrument precision bearings | 0.004 kg
1006 | 2 | STEP AP203 | 0.012 lbmass
1007 | 2 | Bara 8 | 0.013 kg
1008 | 1 |  | 0.001 kg
1009 | 1 |  | 0.038 kg
1011 | 1 | Roata curea Motor | 0.010 lbmass
1012 | 1 | Roata curea intinzator | 0.001 lbmass
1100 | 1 | Sincronization Belt
2000 | 4 | DIN6912 M4x25 | 0.003 kg
2001 | 14 | DIN 934 M4 x0,7 | 0.001 kg
2002 | 23 | DIN 125-A4,3 | 0.000 kg
2003 | 6 | Hexagon socket countersunk head cap screws | 0.002 kg
2004 | 6 | DIN 7984- M3 x 20 | 0.001 kg
2005 | 26 | DIN 125 A3,2 | 0.000 kg
2006 | 18 | DIN 7984 - M3x16 | 0.001 kg
2008 | 2 | Cylinder Head Cap Screw | 0.002 kg
2009 | 24 | DIN 555-5 M3x0,5 | 0.000 kg
2016 | 1 | Wing Nut | 0.003 kg
2019 | 5 | DIN 6912 - M4 x 50 | 0.006 kg
2030 | 1 | Hexagon socket set screw with cup point | 0.000 kg
