TactileImages/TactilePrinterOne-P4/Imprimanta 2 Metal A3/10 Mecanic/Seringa/syringe-57.snapshot.2/SYRINGE (SOLIDWORK)/Assembly Syringe.SLDASM

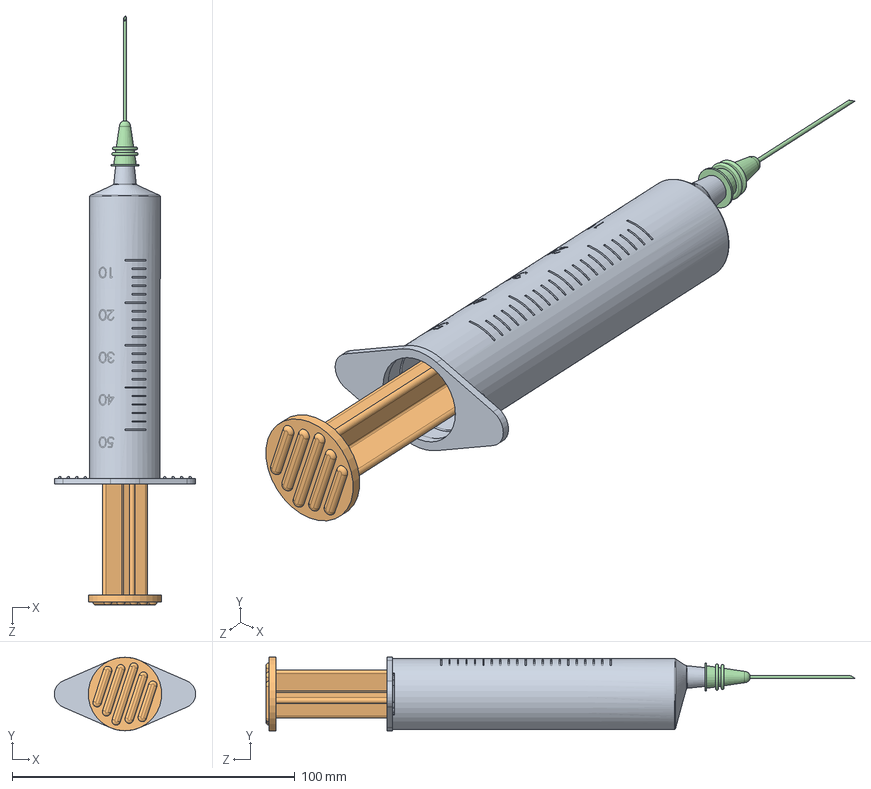
[picture p18: CAD file, 2021-09-20]
Imprimanta 2 Metal A3/10 Mecanic/Seringa/syringe-57.snapshot.2/SYRINGE (SOLIDWORK)/Assembly Syringe.SLDASM
50.0 x 26.0 x 208.2 mm
