TactileImages/TactilePrinterOne-P4/Imprimanta 2 Metal A3/10 Mecanic/Prelucrari/0008-10-058.stl

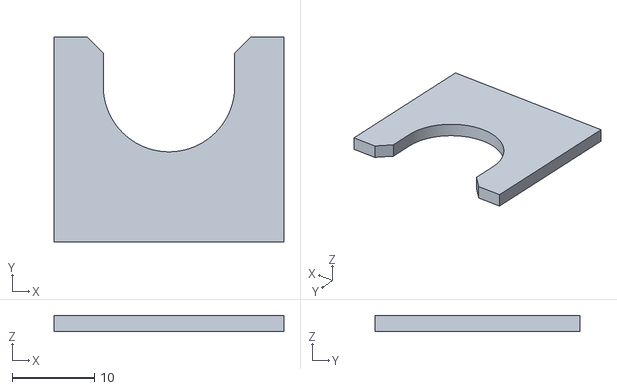
[picture p19: CAD file, 2021-09-20]
Imprimanta 2 Metal A3/10 Mecanic/Prelucrari/0008-10-058.stl
28.0 x 25.0 x 2.00
