TactileImages/TactilePrinterOne-P4/Imprimanta 2 Metal A3/10 Mecanic/Prelucrari/New folder/0008-10-033.stl

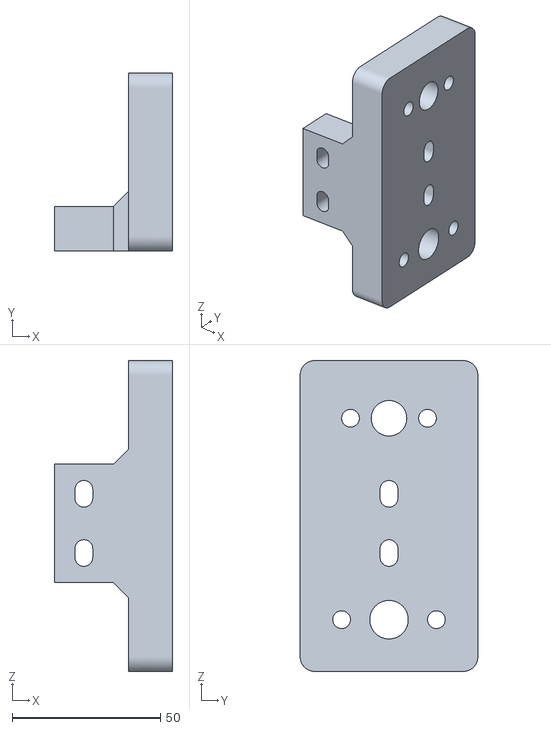
[picture p20: CAD file, 2021-09-20]
Imprimanta 2 Metal A3/10 Mecanic/Prelucrari/New folder/0008-10-033.stl
40.0 x 60.0 x 105.0
