TactileImages/TactilePrinterOne-P4/Imprimanta 2 Metal A3/10 Mecanic/Seringa/medical-syringe-for-single-use-50ml-1.snapshot.3/Syringe-50ml.stp

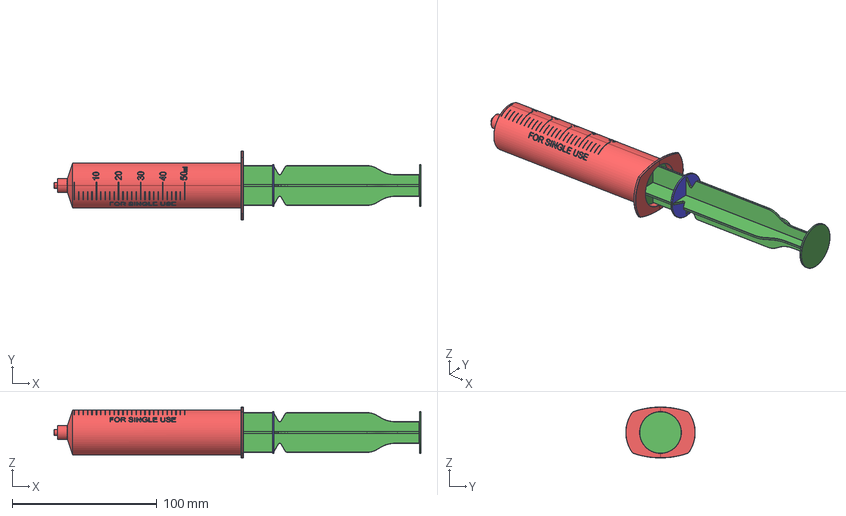
[picture p21: CAD file, 2021-09-20]
Imprimanta 2 Metal A3/10 Mecanic/Seringa/medical-syringe-for-single-use-50ml-1.snapshot.3/Syringe-50ml.stp
253.4 x 48.0 x 35.2 mm
