TactileImages/TactilePrinterOne-P4/Imprimanta 2 Metal A3/10 Mecanic/Seringa/syringe-57.snapshot.2/SYRINGE (SOLIDWORK)/Plunger Rubber.SLDPRT

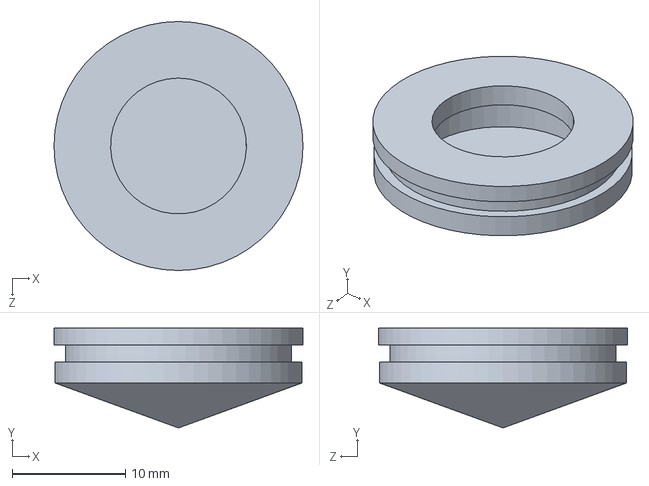
[picture p22: CAD file, 2021-09-20]
Imprimanta 2 Metal A3/10 Mecanic/Seringa/syringe-57.snapshot.2/SYRINGE (SOLIDWORK)/Plunger Rubber.SLDPRT
22.0 x 8.83 x 22.0 mm
