TactileImages/TactilePrinterOne-P4/Imprimanta 2 Metal A3/30 Injectomat/Prelucrari/0008-30-007.stl

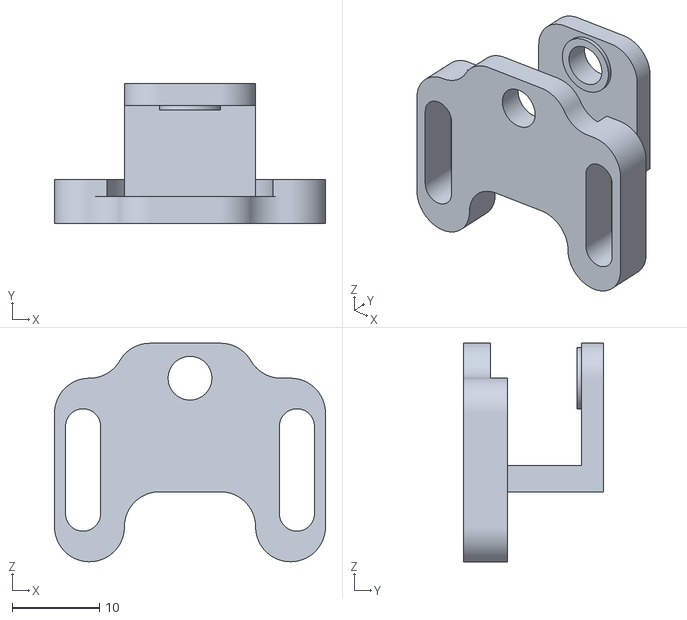
[picture p23: CAD file, 2021-09-20]
Imprimanta 2 Metal A3/30 Injectomat/Prelucrari/0008-30-007.stl
31.0 x 16.0 x 25.0
