TactileImages/TactilePrinterOne-P4/Imprimanta 2 Metal A3/30 Injectomat/syringe-100ml-1.snapshot.1/Syringe_100ml.STP

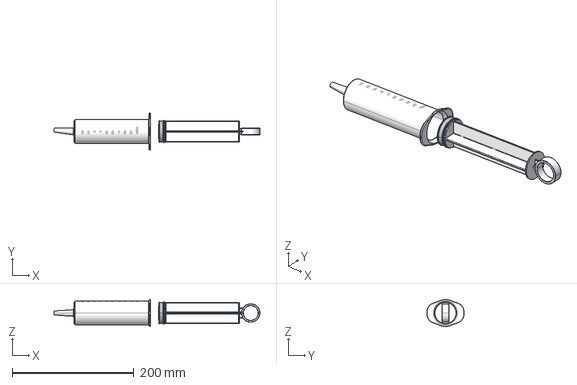
[picture p24: CAD file, 2021-09-20]
Imprimanta 2 Metal A3/30 Injectomat/syringe-100ml-1.snapshot.1/Syringe_100ml.STP
339.1 x 61.3 x 44.5 mm
