TactileImages/TactilePrinterOne-P4/Imprimanta 2 Metal A3/Software/Piese Test/Buna SUnt Metal.stl

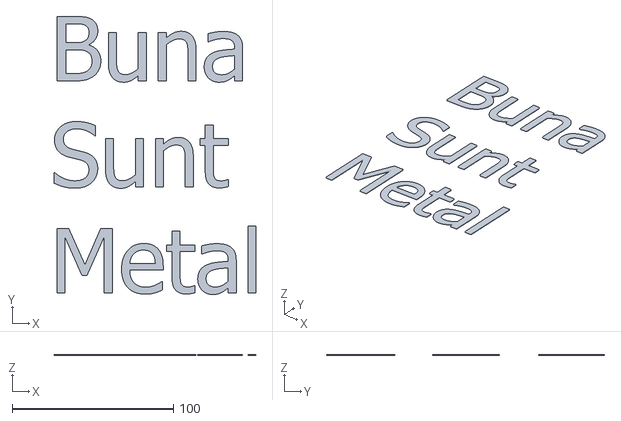
[picture p25: CAD file, 2021-09-20]
Imprimanta 2 Metal A3/Software/Piese Test/Buna SUnt Metal.stl
125.4 x 172.6 x 0.8
