TactileImages/TactilePrinterOne-P4/Imprimanta 3 A4 Lemn Platf Fixa/Exported STL files/Arduino Case/Arduino Case.stl

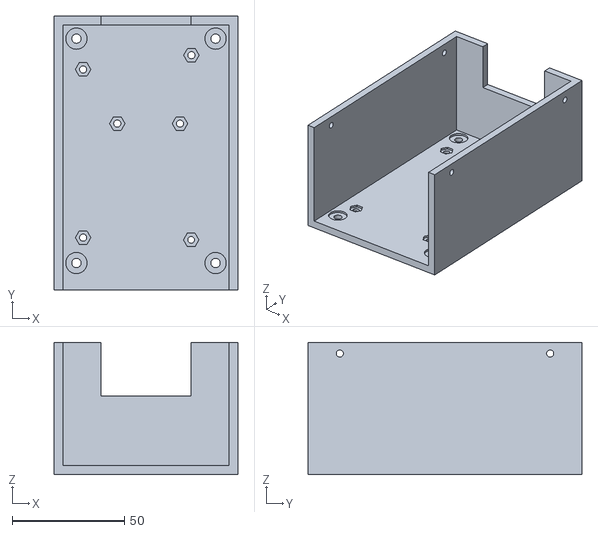
[picture p26: CAD file, 2021-09-20]
Imprimanta 3 A4 Lemn Platf Fixa/Exported STL files/Arduino Case/Arduino Case.stl
82.0 x 121.9 x 59.0
