TactileImages/TactilePrinterOne-P4/Imprimanta 3 A4 Lemn Platf Fixa/Exported STL files/Extruder/Holder Z Movement Plastic Body.stl

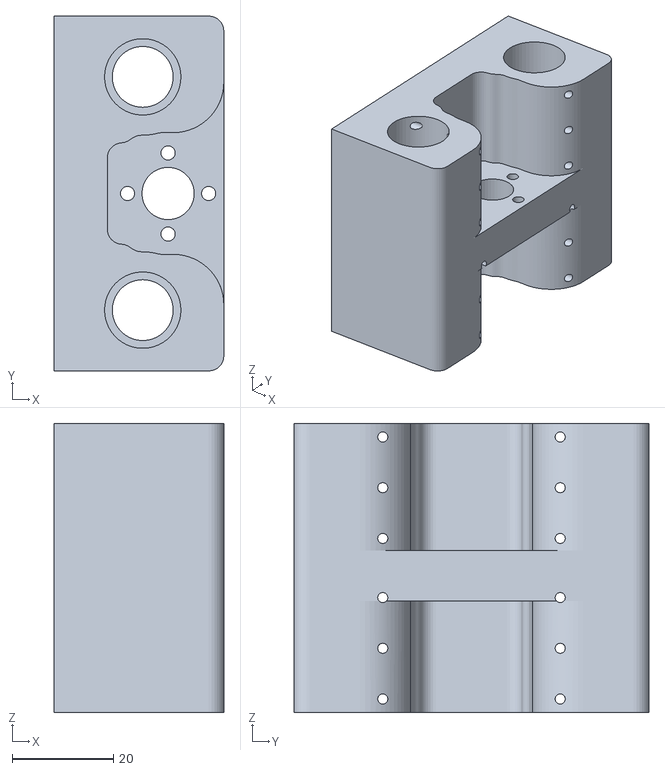
[picture p27: CAD file, 2021-09-20]
Imprimanta 3 A4 Lemn Platf Fixa/Exported STL files/Extruder/Holder Z Movement Plastic Body.stl
33.5 x 70.0 x 57.0
