TactileImages/TactilePrinterOne-P4/Imprimanta 3 A4 Lemn Platf Fixa/Exported STL files/Limit Switches/X Limit Switch Plastic Body.stl

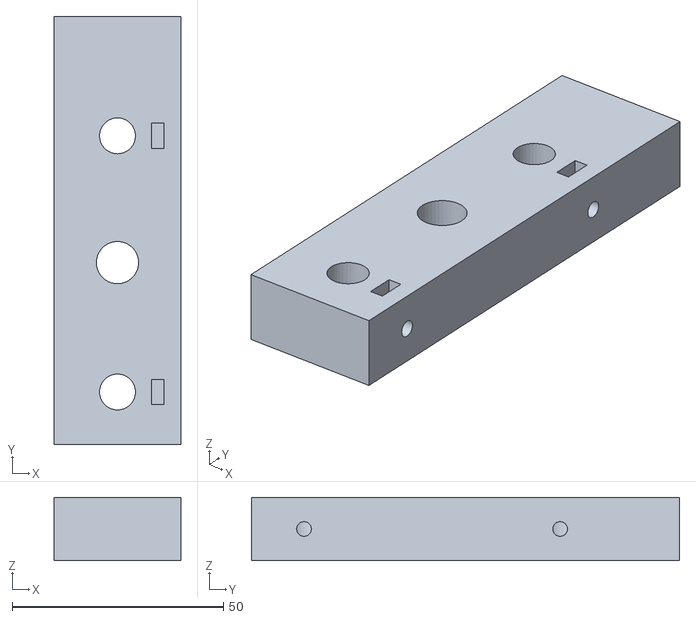
[picture p28: CAD file, 2021-09-20]
Imprimanta 3 A4 Lemn Platf Fixa/Exported STL files/Limit Switches/X Limit Switch Plastic Body.stl
30.0 x 101.3 x 15.0
