TactileImages/TactilePrinterOne-P4/Imprimanta 3 A4 Lemn Platf Fixa/Exported STL files/Motor and Bearing Holders/X Movement Motor or Bearing Holder Plastic Body.stl

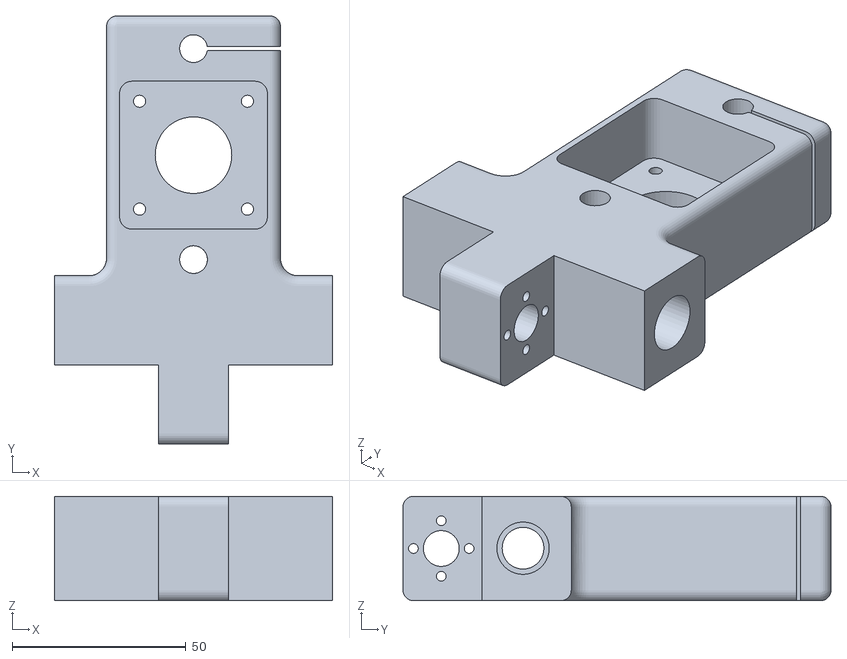
[picture p29: CAD file, 2021-09-20]
Imprimanta 3 A4 Lemn Platf Fixa/Exported STL files/Motor and Bearing Holders/X Movement Motor or Bearing Holder Plastic Body.stl
80.0 x 123.0 x 30.0
