TactileImages/TactilePrinterOne-P4/Imprimanta 3 A4 Lemn Platf Fixa/Exported STL files/Needle Parking/Needl Parking Plastic Body.stl

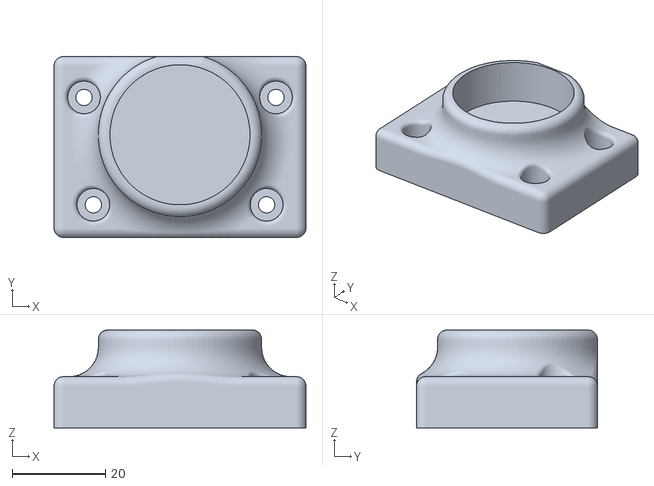
[picture p30: CAD file, 2021-09-20]
Imprimanta 3 A4 Lemn Platf Fixa/Exported STL files/Needle Parking/Needl Parking Plastic Body.stl
54.0 x 38.8 x 21.0
