TactileImages/TactilePrinterOne-P4/Imprimanta 3 A4 Lemn Platf Fixa/Exported STL files/Power Connector and Switch Case/Connector Case.stl

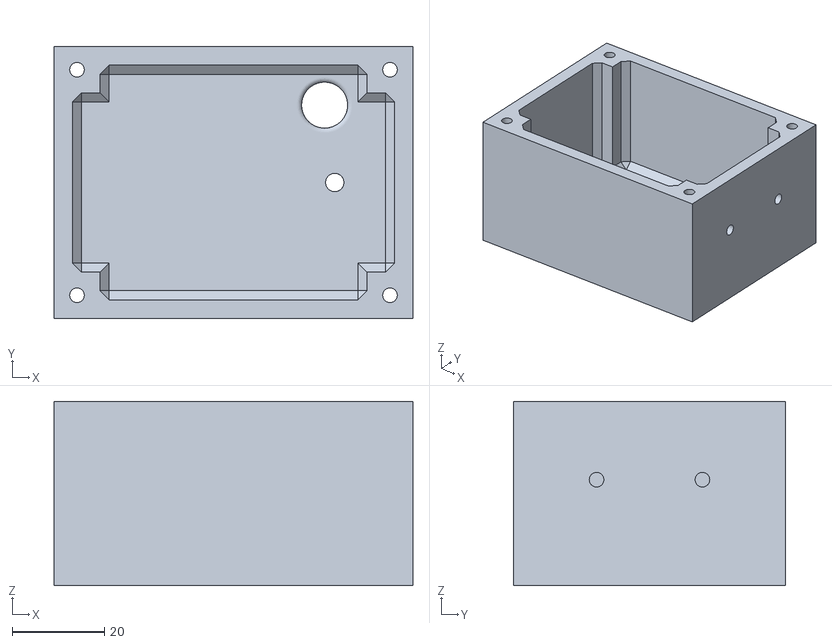
[picture p31: CAD file, 2021-09-20]
Imprimanta 3 A4 Lemn Platf Fixa/Exported STL files/Power Connector and Switch Case/Connector Case.stl
78.0 x 59.0 x 40.0
