TactileImages/TactilePrinterOne-P4/Imprimanta 4 A4 Metal/Exported STL files/Arduino Case/Wire Cover Case Bracket.stl

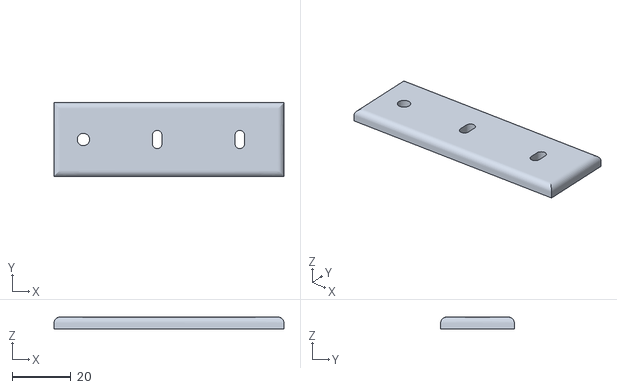
[picture p32: CAD file, 2021-09-20]
Imprimanta 4 A4 Metal/Exported STL files/Arduino Case/Wire Cover Case Bracket.stl
78.0 x 25.0 x 4.00
