TactileImages/TactilePrinterOne-P4/Imprimanta 4 A4 Metal/Exported STL files/Extruder/Syringe Plunger Holder.stl

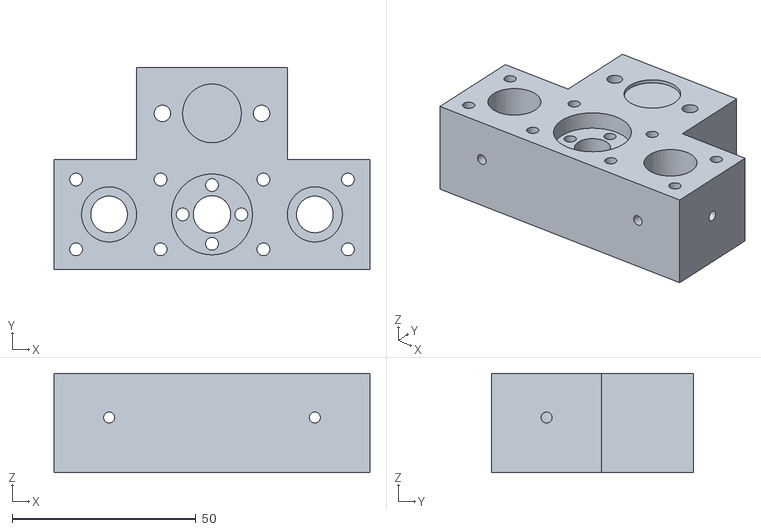
[picture p33: CAD file, 2021-09-20]
Imprimanta 4 A4 Metal/Exported STL files/Extruder/Syringe Plunger Holder.stl
86.0 x 55.0 x 27.0
