TactileImages/TactilePrinterOne-P4/Imprimanta 4 A4 Metal/Exported STL files/Needle Parking/Needle Parking Plastic Body.stl

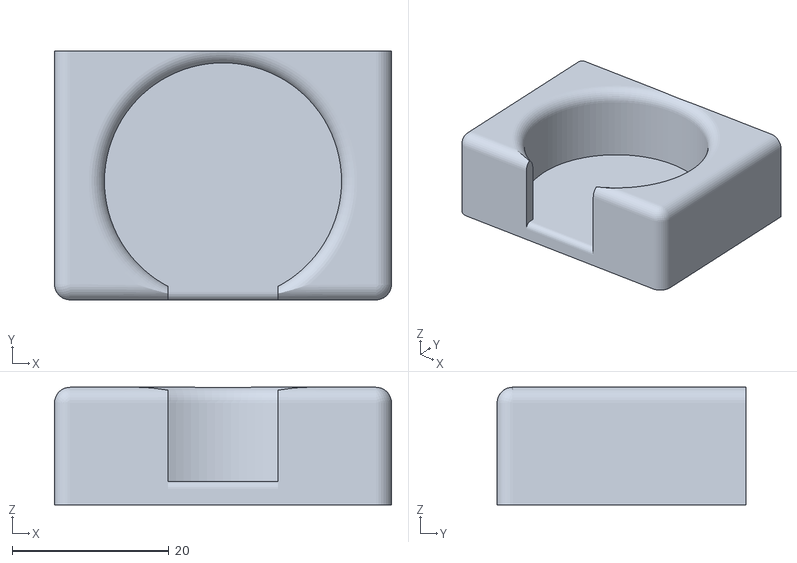
[picture p34: CAD file, 2021-09-20]
Imprimanta 4 A4 Metal/Exported STL files/Needle Parking/Needle Parking Plastic Body.stl
43.0 x 31.8 x 15.0
