TactileImages/TactilePrinterOne-P4/Imprimanta 4 A4 Metal/Exported STL files/Z Movement/Z Movement Wheel Holder Plate.stl

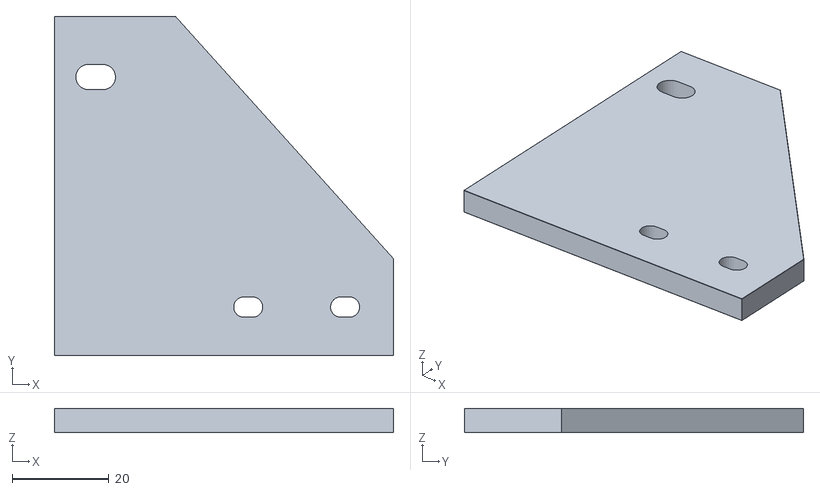
[picture p35: CAD file, 2021-09-20]
Imprimanta 4 A4 Metal/Exported STL files/Z Movement/Z Movement Wheel Holder Plate.stl
70.0 x 70.0 x 5.00
