TactileImages/TactilePrinterOne-P4/Imprimanta_1_Lemn/10 Mecanic/Seringa/21-gauge-needle-1.snapshot.2/Needle.step

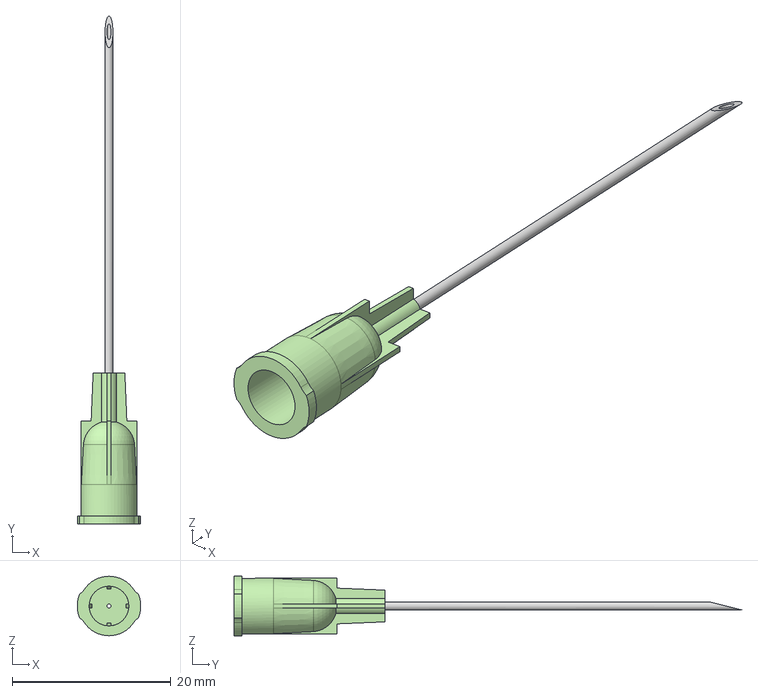
[picture p36: CAD file, 2021-09-20]
Imprimanta_1_Lemn/10 Mecanic/Seringa/21-gauge-needle-1.snapshot.2/Needle.step
7.99 x 64.0 x 7.50 mm
