TactileImages/TactilePrinterOne-P4/Imprimanta_1_Lemn/Teste/Patrat.stl

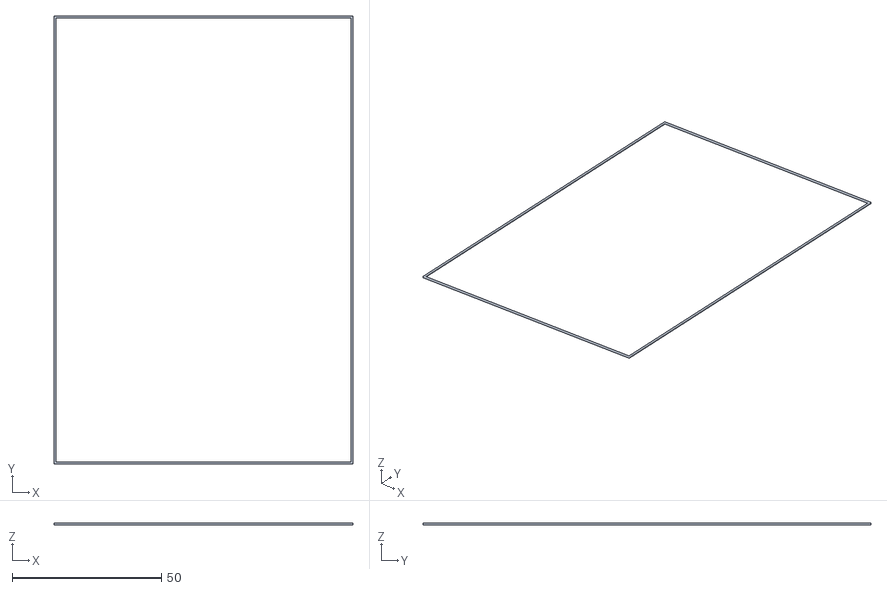
[picture p37: CAD file, 2021-09-20]
Imprimanta_1_Lemn/Teste/Patrat.stl
100.0 x 150.0 x 0.6
