TactileImages/TactilePrinterOne-P4/Imprimanta 2 Metal A3/10 Mecanic/Prelucrari/0008-10-005 Suport_Rulment.stl

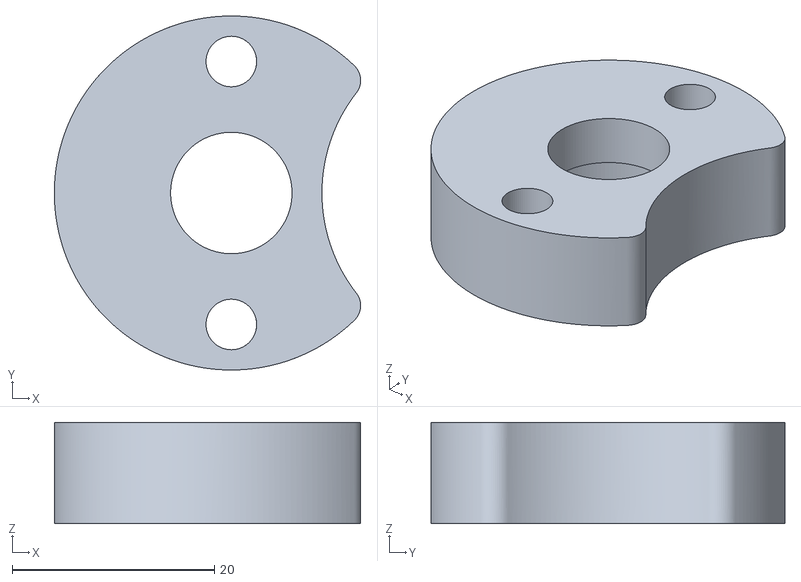
[picture p38: CAD file, 2021-09-20]
Imprimanta 2 Metal A3/10 Mecanic/Prelucrari/0008-10-005 Suport_Rulment.stl
30.3 x 35.0 x 10.0
