TactileImages/TactilePrinterOne-P4/Imprimanta 2 Metal A3/10 Mecanic/Seringa/syringe-57.snapshot.2/SYRINGE (SOLIDWORK)/Plunger.SLDPRT

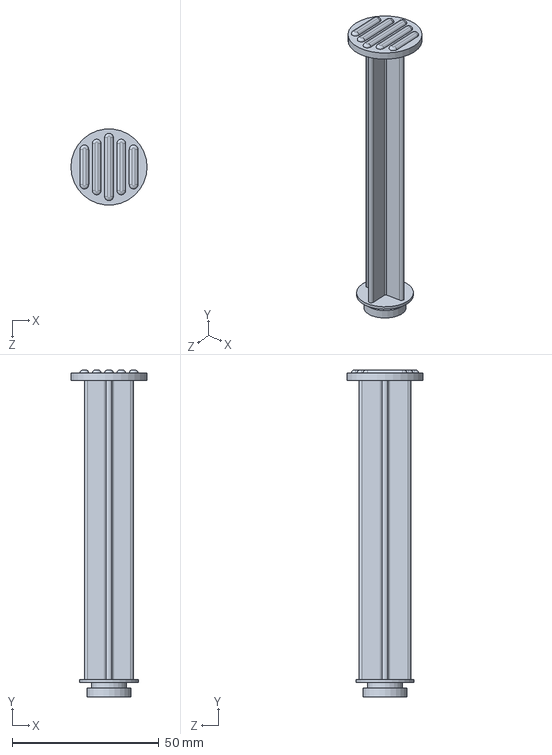
[picture p39: CAD file, 2021-09-20]
Imprimanta 2 Metal A3/10 Mecanic/Seringa/syringe-57.snapshot.2/SYRINGE (SOLIDWORK)/Plunger.SLDPRT
26.0 x 111.5 x 25.9 mm
