TactileImages/TactilePrinterOne-P4/Imprimanta 2 Metal A3/30 Injectomat/Prelucrari/0008-30-012.stl

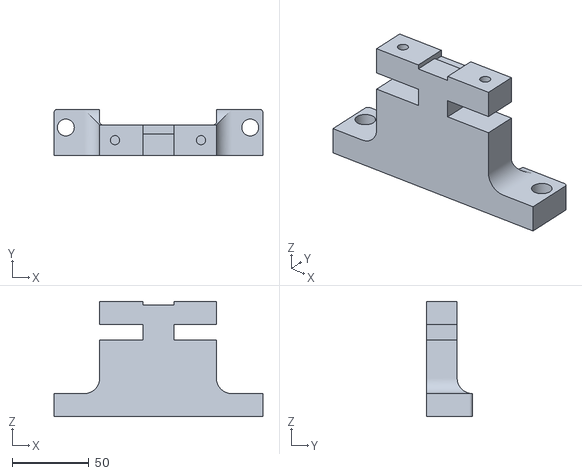
[picture p40: CAD file, 2021-09-20]
Imprimanta 2 Metal A3/30 Injectomat/Prelucrari/0008-30-012.stl
136.0 x 30.0 x 75.0
