TactileImages/TactilePrinterOne-P4/Imprimanta 2 Metal A3/Software/Piese Test/Orange.stl

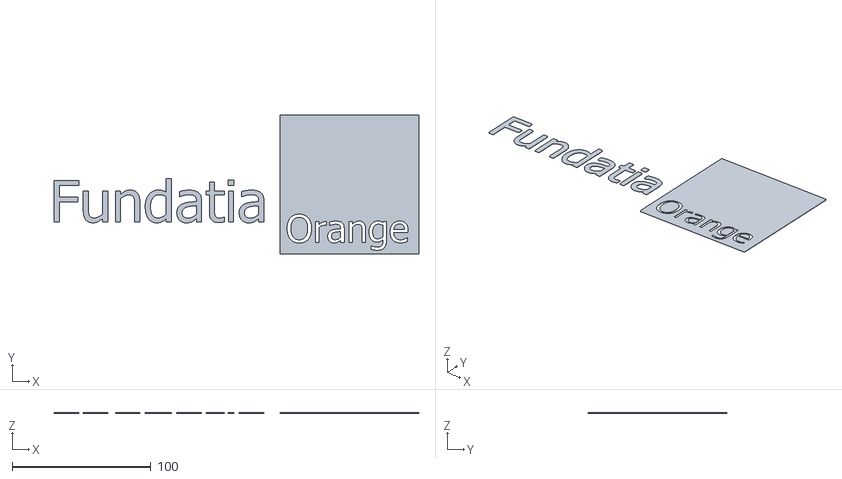
[picture p41: CAD file, 2021-09-20]
Imprimanta 2 Metal A3/Software/Piese Test/Orange.stl
263.0 x 100.0 x 0.8
