TactileImages/TactilePrinterOne-P4/Imprimanta 3 A4 Lemn Platf Fixa/Exported STL files/Arduino Case/Arduino Case Cover.stl

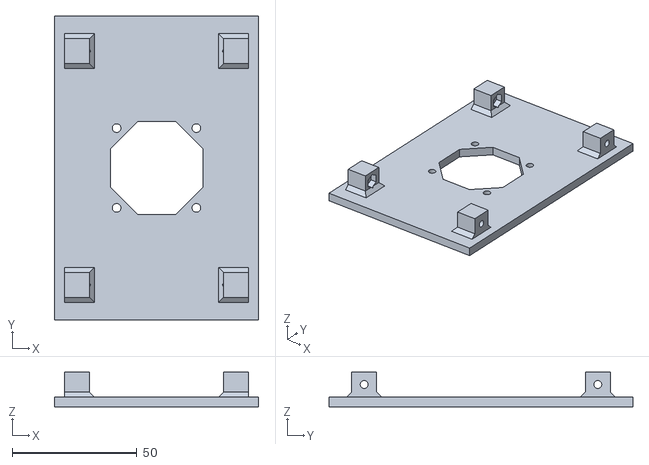
[picture p42: CAD file, 2021-09-20]
Imprimanta 3 A4 Lemn Platf Fixa/Exported STL files/Arduino Case/Arduino Case Cover.stl
82.0 x 121.9 x 14.0
