TactileImages/TactilePrinterOne-P4/Imprimanta 3 A4 Lemn Platf Fixa/Exported STL files/Limit Switches/Z Limit Switch Plastic Body.stl

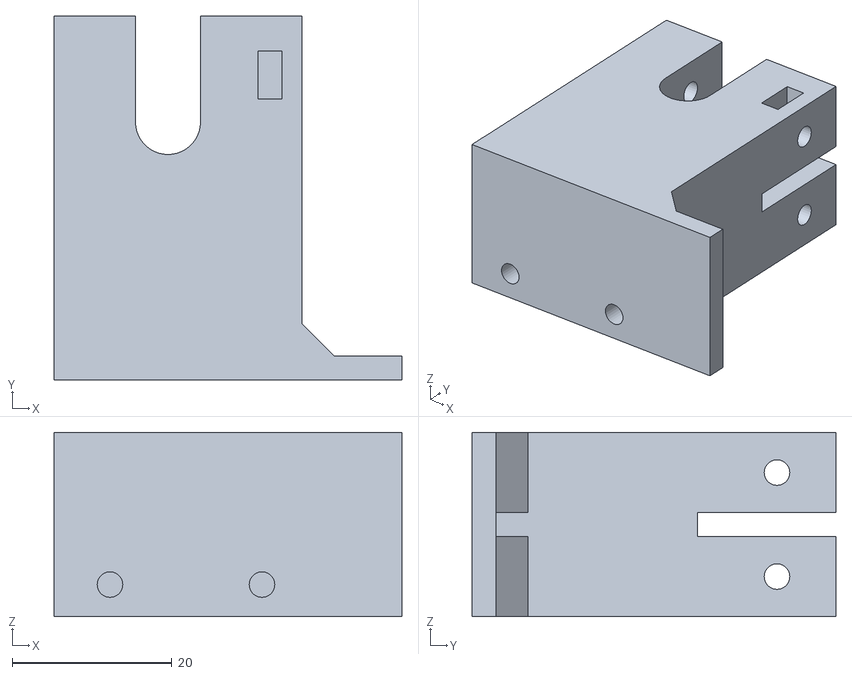
[picture p43: CAD file, 2021-09-20]
Imprimanta 3 A4 Lemn Platf Fixa/Exported STL files/Limit Switches/Z Limit Switch Plastic Body.stl
43.5 x 45.5 x 23.0
