TactileImages/TactilePrinterOne-P4/Imprimanta 3 A4 Lemn Platf Fixa/Exported STL files/Motor and Bearing Holders/Y Movement Motor or Bearing Holder Plastic Body.stl

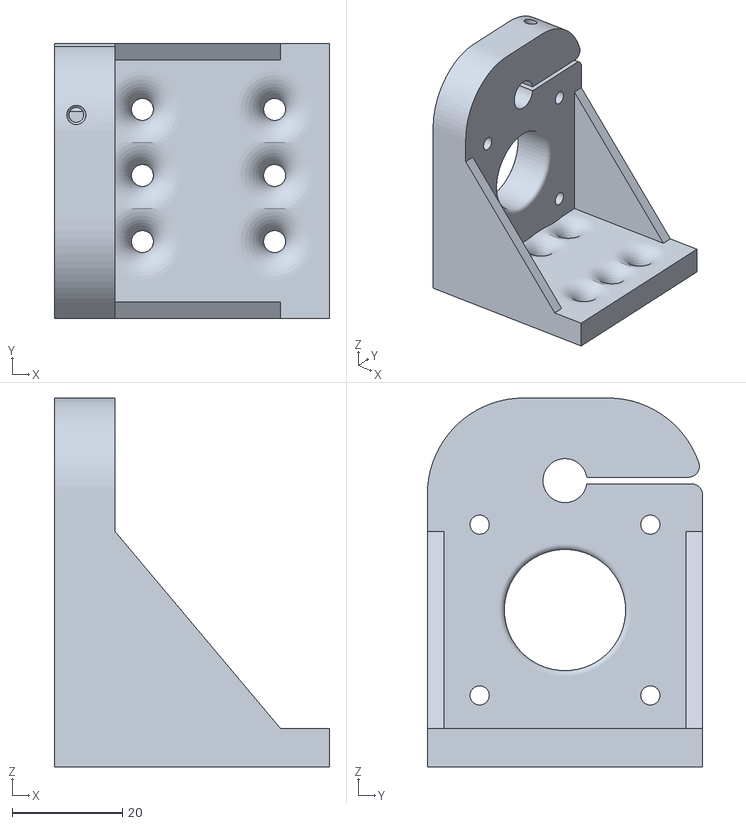
[picture p44: CAD file, 2021-09-20]
Imprimanta 3 A4 Lemn Platf Fixa/Exported STL files/Motor and Bearing Holders/Y Movement Motor or Bearing Holder Plastic Body.stl
50.0 x 50.0 x 67.0
