TactileImages/TactilePrinterOne-P4/Imprimanta 3 A4 Lemn Platf Fixa/Exported STL files/Power Connector and Switch Case/Connector Case Cover.stl

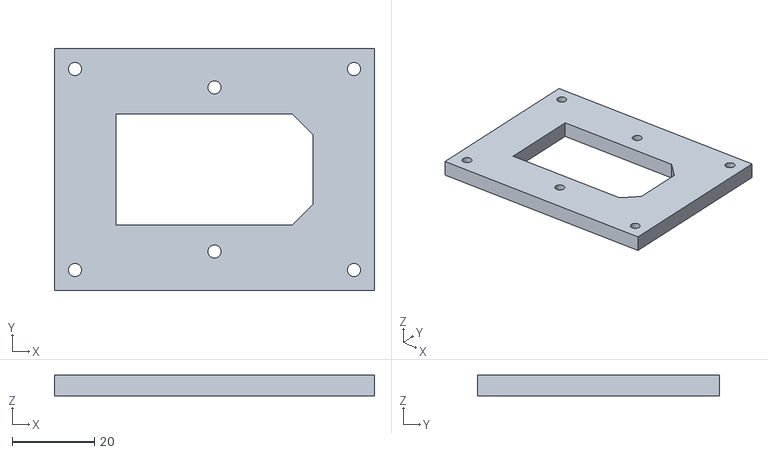
[picture p45: CAD file, 2021-09-20]
Imprimanta 3 A4 Lemn Platf Fixa/Exported STL files/Power Connector and Switch Case/Connector Case Cover.stl
78.0 x 59.0 x 5.00
