TactileImages/TactilePrinterOne-P4/Imprimanta 4 A4 Metal/Exported STL files/Extruder/Plastic Backplate.stl

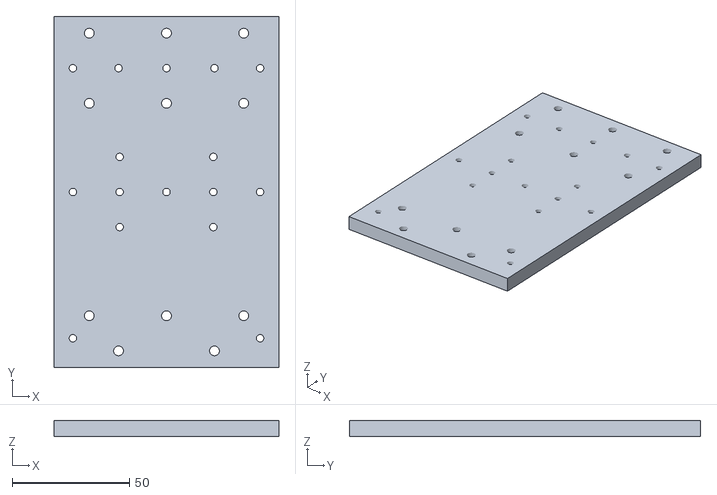
[picture p46: CAD file, 2021-09-20]
Imprimanta 4 A4 Metal/Exported STL files/Extruder/Plastic Backplate.stl
96.0 x 150.0 x 7.00
