TactileImages/TactilePrinterOne-P4/Imprimanta_1_Lemn/Teste/Tactile image.stl

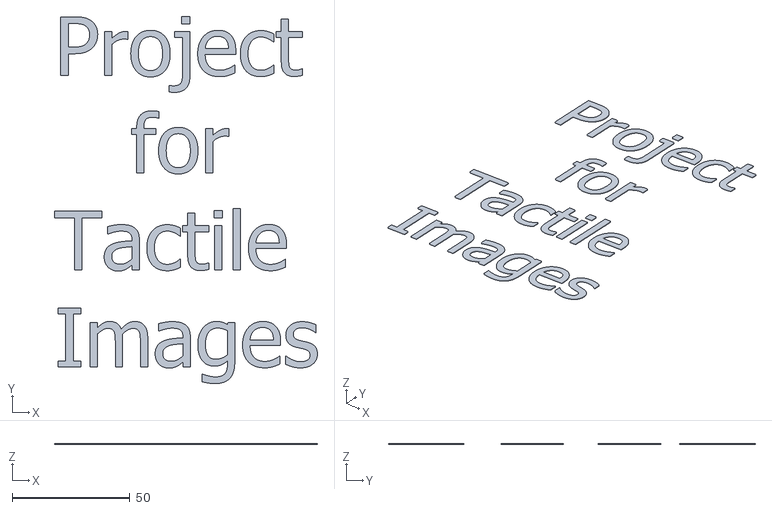
[picture p47: CAD file, 2021-09-20]
Imprimanta_1_Lemn/Teste/Tactile image.stl
111.5 x 155.7 x 0.6
