TactileImages/TactilePrinterOne-P4/Imprimanta 2 Metal A3/10 Mecanic/Prelucrari/0008-10-011 Fixare AxaX Mijloc.stl

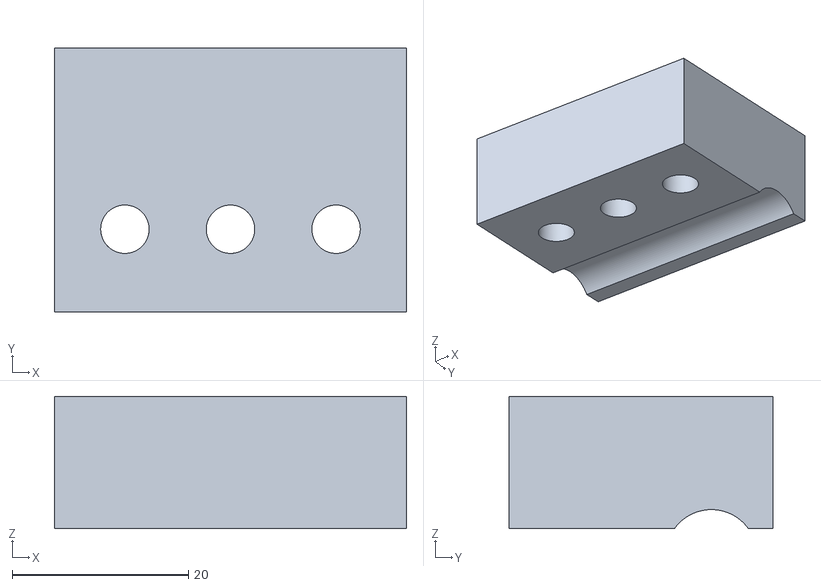
[picture p48: CAD file, 2021-09-20]
Imprimanta 2 Metal A3/10 Mecanic/Prelucrari/0008-10-011 Fixare AxaX Mijloc.stl
40.0 x 30.0 x 15.0
