TactileImages/TactilePrinterOne-P4/Imprimanta 2 Metal A3/10 Mecanic/Prelucrari/New folder/0008-10-013 Supaort Piulita Axa Z.stl

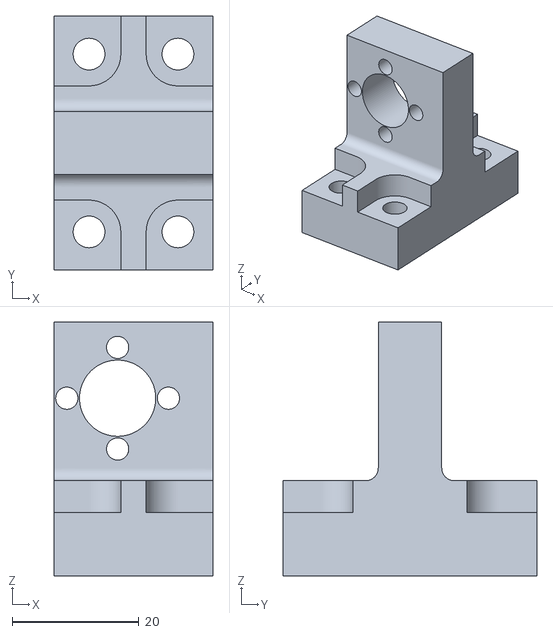
[picture p49: CAD file, 2021-09-20]
Imprimanta 2 Metal A3/10 Mecanic/Prelucrari/New folder/0008-10-013 Supaort Piulita Axa Z.stl
25.0 x 40.0 x 40.0
