TactileImages/TactilePrinterOne-P4/Imprimanta 2 Metal A3/10 Mecanic/Seringa/syringe-57.snapshot.2/SYRINGE (SOLIDWORK)/Body Syringe.SLDPRT

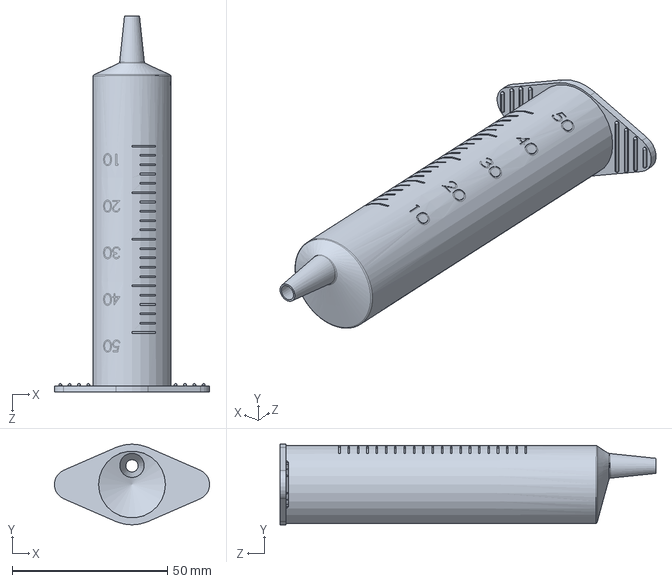
[picture p50: CAD file, 2021-09-20]
Imprimanta 2 Metal A3/10 Mecanic/Seringa/syringe-57.snapshot.2/SYRINGE (SOLIDWORK)/Body Syringe.SLDPRT
49.9 x 26.0 x 121.0 mm
