TactileImages/TactilePrinterOne-P4/Imprimanta 2 Metal A3/30 Injectomat/Prelucrari/0008-30-005.stl

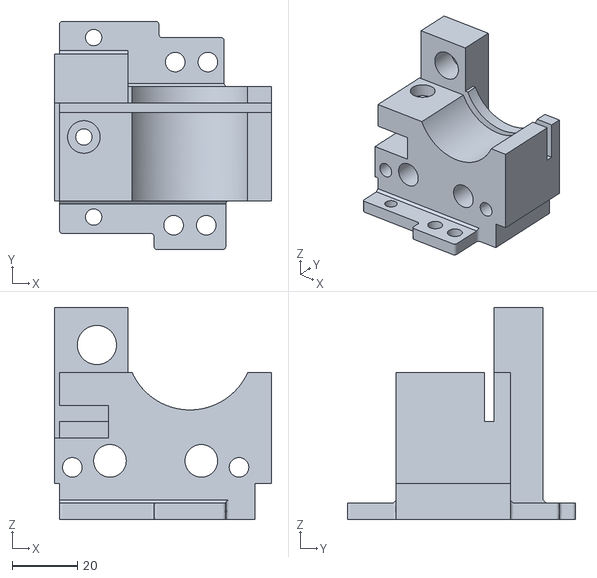
[picture p51: CAD file, 2021-09-20]
Imprimanta 2 Metal A3/30 Injectomat/Prelucrari/0008-30-005.stl
66.5 x 70.0 x 65.0
