TactileImages/TactilePrinterOne-P4/Imprimanta 3 A4 Lemn Platf Fixa/Exported STL files/Extruder/Extruder Carrier Plastic Body.stl

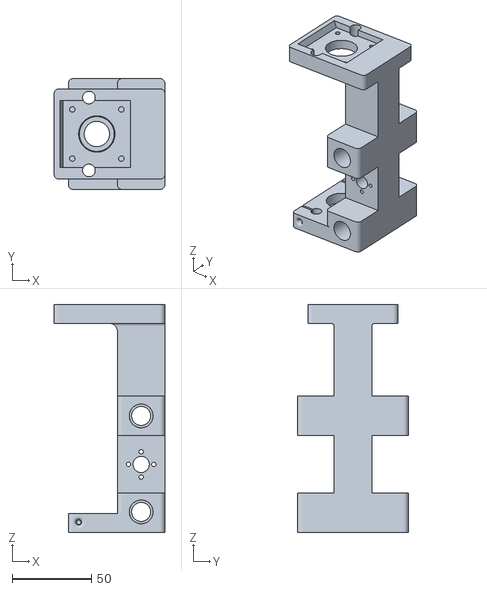
[picture p52: CAD file, 2021-09-20]
Imprimanta 3 A4 Lemn Platf Fixa/Exported STL files/Extruder/Extruder Carrier Plastic Body.stl
70.0 x 70.0 x 144.0
