TactileImages/TactilePrinterOne-P4/Imprimanta 3 A4 Lemn Platf Fixa/Exported STL files/Limit Switches/Y Limit Switch Plastic Body.stl

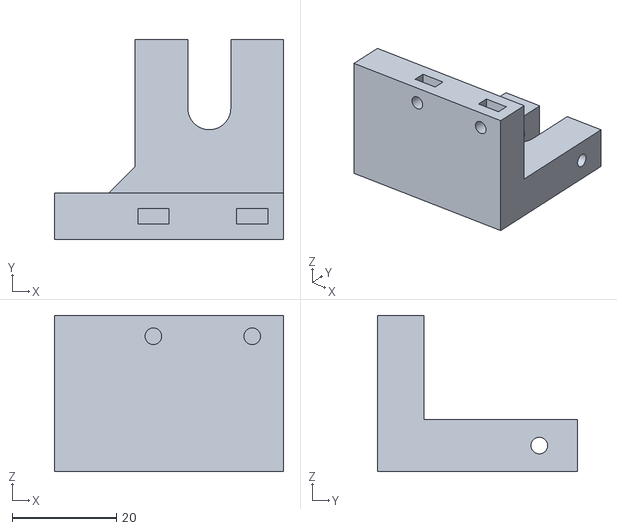
[picture p53: CAD file, 2021-09-20]
Imprimanta 3 A4 Lemn Platf Fixa/Exported STL files/Limit Switches/Y Limit Switch Plastic Body.stl
44.0 x 38.5 x 30.0
