TactileImages/TactilePrinterOne-P4/Imprimanta 4 A4 Metal/Exported STL files/Arduino Case/Printer Logo Plate.stl

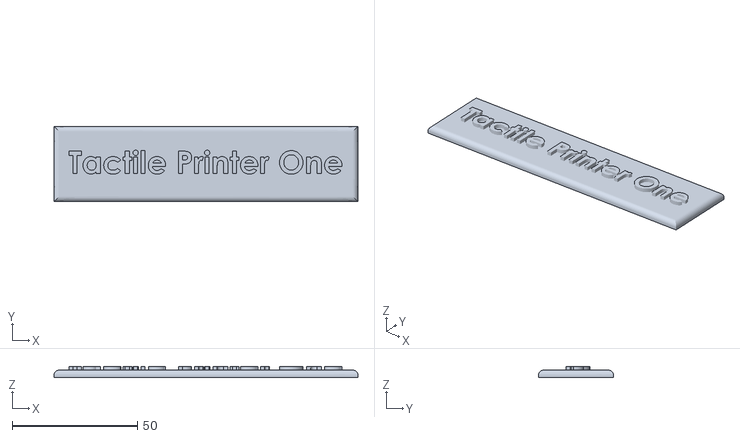
[picture p54: CAD file, 2021-09-20]
Imprimanta 4 A4 Metal/Exported STL files/Arduino Case/Printer Logo Plate.stl
121.4 x 30.0 x 4.50
