TactileImages/TactilePrinterOne-P4/Imprimanta_1_Lemn/Teste/Fundatia orange.stl

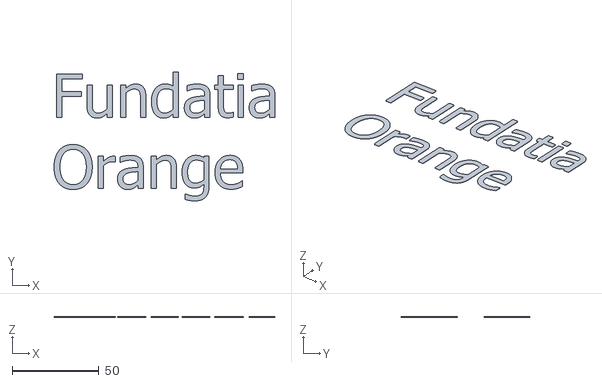
[picture p55: CAD file, 2021-09-20]
Imprimanta_1_Lemn/Teste/Fundatia orange.stl
127.5 x 74.4 x 0.6
