TactileImages/TactilePrinterOne-P4/Imprimanta 2 Metal A3/10 Mecanic/Prelucrari/0008-10-045.stl

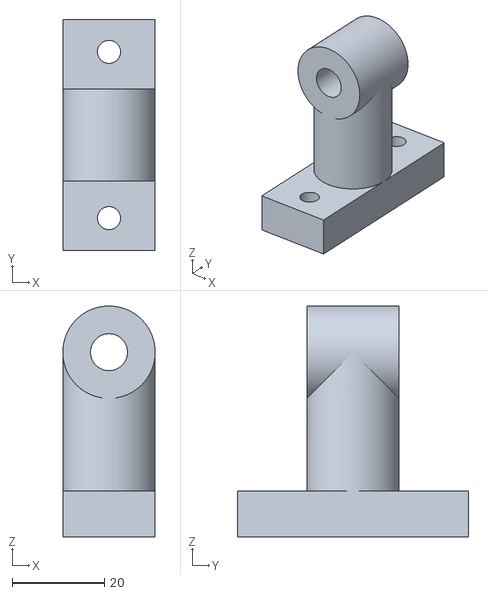
[picture p56: CAD file, 2021-09-20]
Imprimanta 2 Metal A3/10 Mecanic/Prelucrari/0008-10-045.stl
20.0 x 50.0 x 50.0
