TactileImages/TactilePrinterOne-P4/Imprimanta 2 Metal A3/30 Injectomat/Prelucrari/0008-30-1006 SHF8.stl

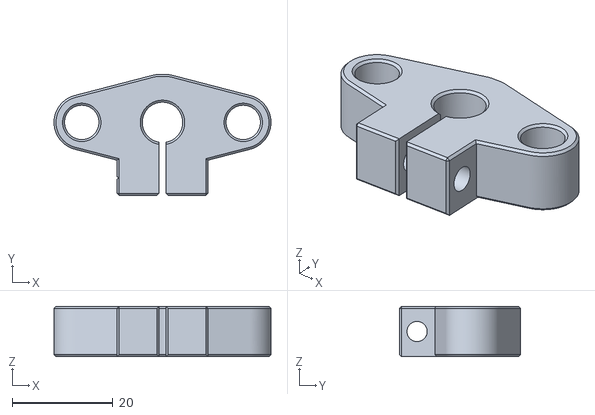
[picture p57: CAD file, 2021-09-20]
Imprimanta 2 Metal A3/30 Injectomat/Prelucrari/0008-30-1006 SHF8.stl
43.0 x 24.0 x 10.0
