TactileImages/TactilePrinterOne-P4/Imprimanta 3 A4 Lemn Platf Fixa/Exported STL files/Extruder/Syringe Plunger Holder.stl

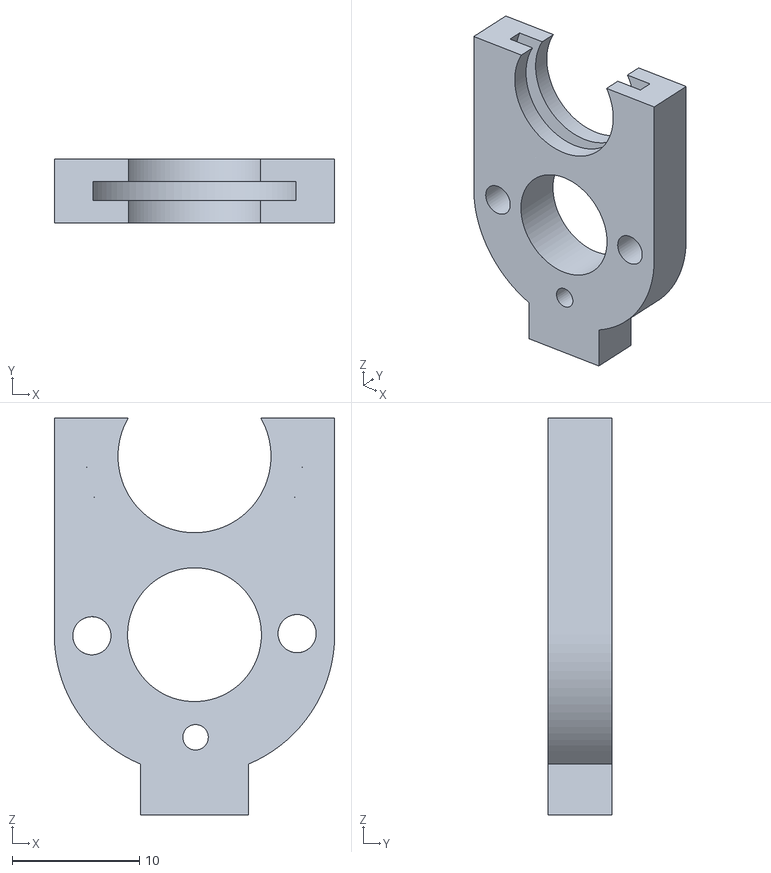
[picture p58: CAD file, 2021-09-20]
Imprimanta 3 A4 Lemn Platf Fixa/Exported STL files/Extruder/Syringe Plunger Holder.stl
22.0 x 5.00 x 31.1
