TactileImages/TactilePrinterOne-P4/Imprimanta 4 A4 Metal/Exported STL files/Arduino Case/Wire Cover Case Body.stl

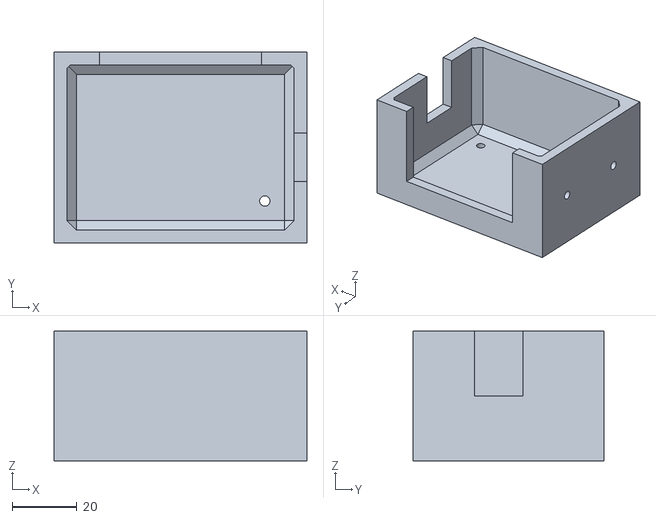
[picture p59: CAD file, 2021-09-20]
Imprimanta 4 A4 Metal/Exported STL files/Arduino Case/Wire Cover Case Body.stl
78.0 x 59.0 x 40.0
