TactileImages/TactilePrinterOne-P4/Imprimanta 4 A4 Metal/Exported STL files/Extruder/Syringe Plunger Flange Press.stl

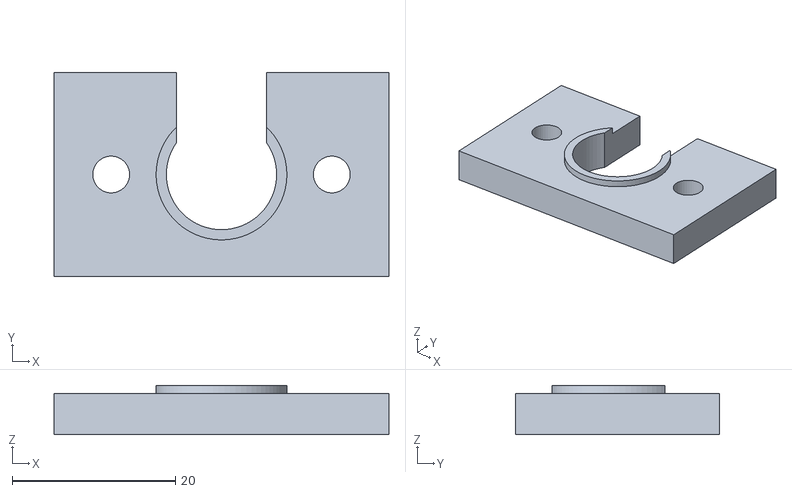
[picture p60: CAD file, 2021-09-20]
Imprimanta 4 A4 Metal/Exported STL files/Extruder/Syringe Plunger Flange Press.stl
41.0 x 25.0 x 6.00
