TactileImages/TactilePrinterOne-P4/Imprimanta_1_Lemn/Teste/Vintage.stl

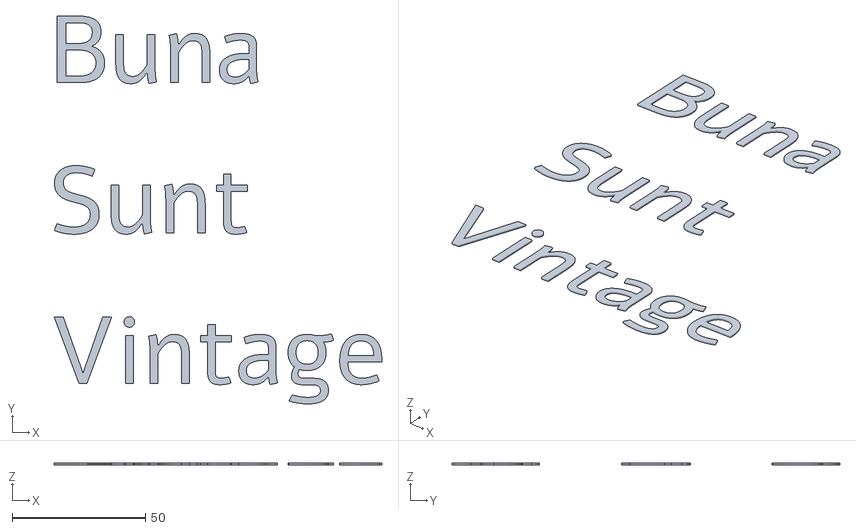
[picture p61: CAD file, 2021-09-20]
Imprimanta_1_Lemn/Teste/Vintage.stl
123.0 x 145.6 x 0.6
