TactileImages/TactilePrinterOne-P4/Imprimanta 2 Metal A3/10 Mecanic/Prelucrari/0008-10-041 Ciuperca.stl

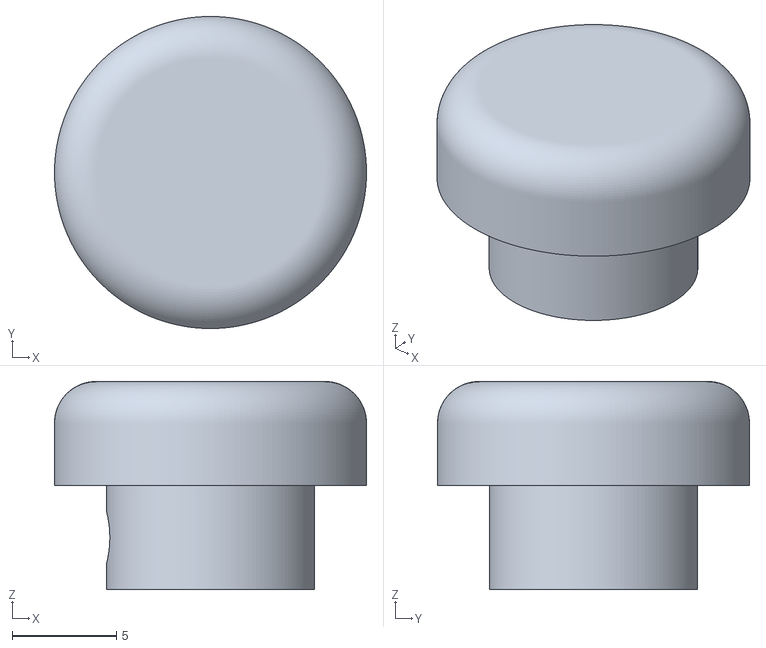
[picture p62: CAD file, 2021-09-20]
Imprimanta 2 Metal A3/10 Mecanic/Prelucrari/0008-10-041 Ciuperca.stl
15.0 x 15.0 x 10.0
