TactileImages/TactilePrinterOne-P4/Imprimanta 2 Metal A3/10 Mecanic/Seringa/syringe-57.snapshot.2/SYRINGE (SOLIDWORK)/Needle.SLDPRT

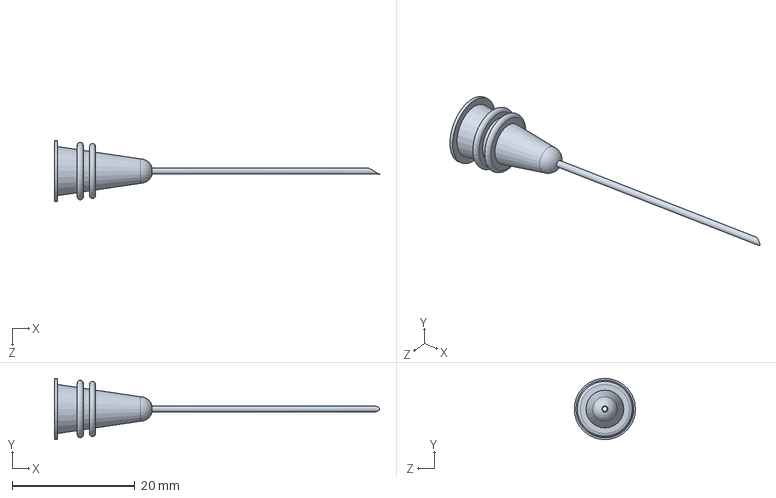
[picture p63: CAD file, 2021-09-20]
Imprimanta 2 Metal A3/10 Mecanic/Seringa/syringe-57.snapshot.2/SYRINGE (SOLIDWORK)/Needle.SLDPRT
53.0 x 9.98 x 9.97 mm
