TactileImages/TactilePrinterOne-P4/Imprimanta 2 Metal A3/30 Injectomat/Prelucrari/0008-30-008.stl

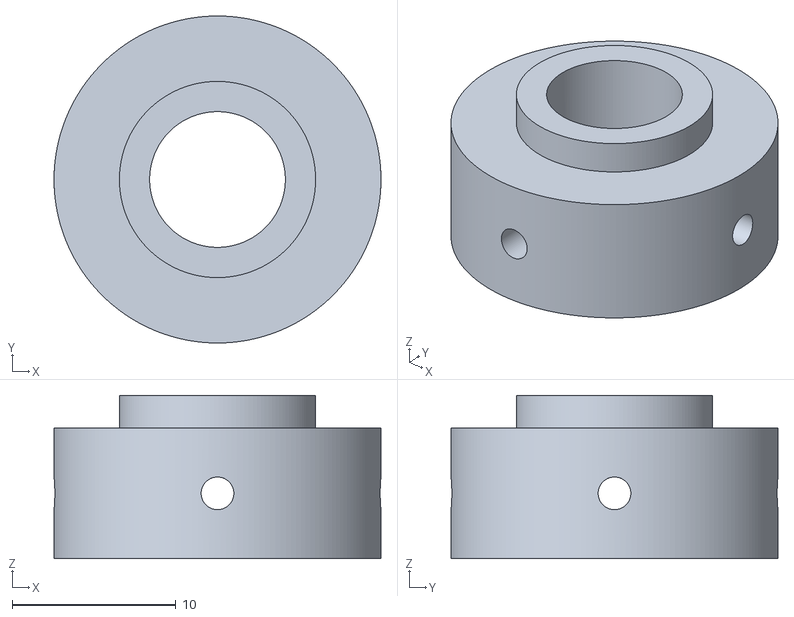
[picture p64: CAD file, 2021-09-20]
Imprimanta 2 Metal A3/30 Injectomat/Prelucrari/0008-30-008.stl
20.0 x 20.0 x 10.0
