TactileImages/TactilePrinterOne-P4/Imprimanta 3 A4 Lemn Platf Fixa/Exported STL files/Extruder/Syringe Press.stl

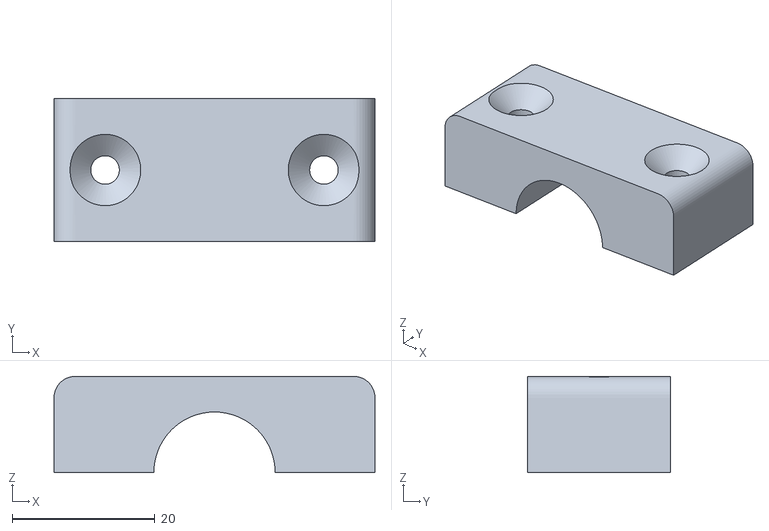
[picture p65: CAD file, 2021-09-20]
Imprimanta 3 A4 Lemn Platf Fixa/Exported STL files/Extruder/Syringe Press.stl
45.0 x 20.0 x 13.5
