TactileImages/TactilePrinterOne-P4/Imprimanta 4 A4 Metal/Exported STL files/Extruder/Syringe Barrel Press.stl

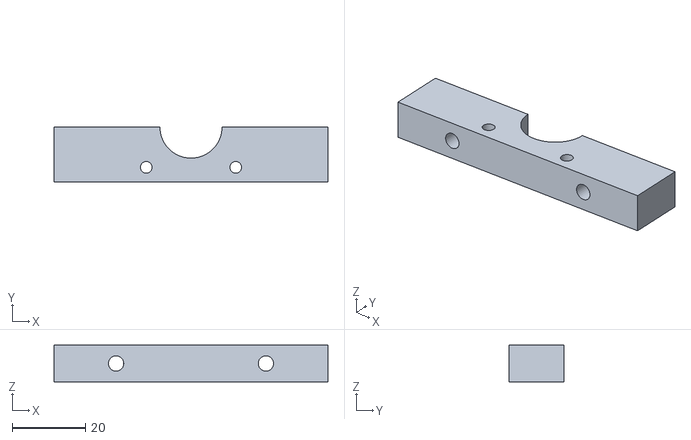
[picture p66: CAD file, 2021-09-20]
Imprimanta 4 A4 Metal/Exported STL files/Extruder/Syringe Barrel Press.stl
75.0 x 15.0 x 10.0
