TactileImages/TactilePrinterOne-P4/Imprimanta 2 Metal A3/30 Injectomat/Prelucrari/0008-30-002 Corp_Injectomat1.stl

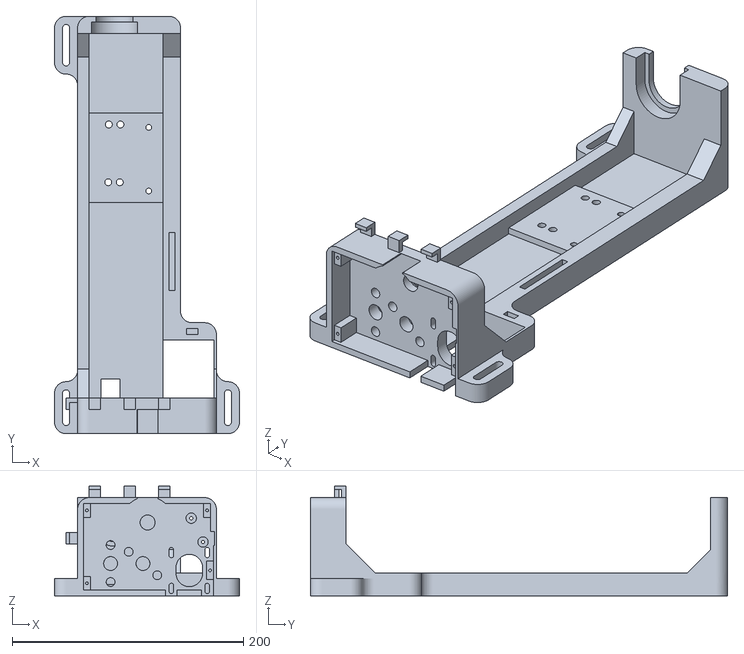
[picture p68: CAD file, 2021-09-20]
Imprimanta 2 Metal A3/30 Injectomat/Prelucrari/0008-30-002 Corp_Injectomat1.stl
160.0 x 361.0 x 95.0
