TactileImages/TactilePrinterOne-P4/Imprimanta 3 A4 Lemn Platf Fixa/Exported STL files/Extruder/Holder Z Movement Spacer.stl

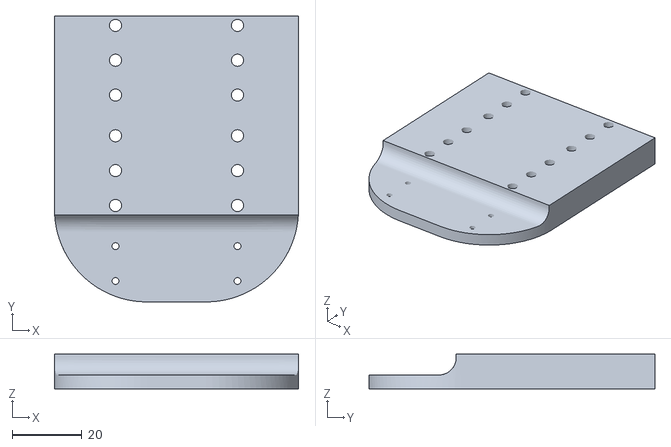
[picture p69: CAD file, 2021-09-20]
Imprimanta 3 A4 Lemn Platf Fixa/Exported STL files/Extruder/Holder Z Movement Spacer.stl
70.0 x 82.0 x 10.0
