TactileImages/TactilePrinterOne-P4/Imprimanta 4 A4 Metal/Exported STL files/Extruder/Syringe Barrel Holder Spacer.stl

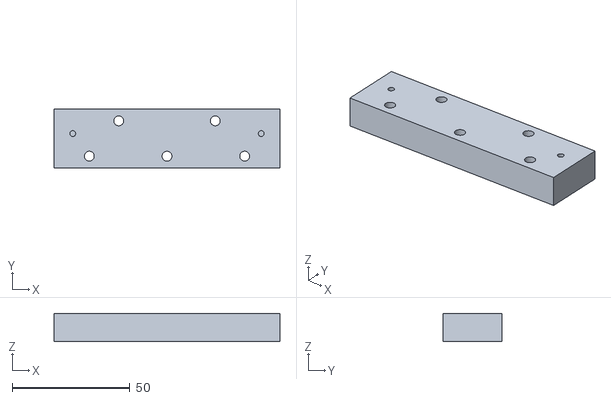
[picture p70: CAD file, 2021-09-20]
Imprimanta 4 A4 Metal/Exported STL files/Extruder/Syringe Barrel Holder Spacer.stl
96.0 x 25.0 x 12.0
