TactileImages/TactilePrinterOne-P4/Imprimanta 3 A4 Lemn Platf Fixa/Exported STL files/Extruder/Extruder Carrier Plastic Protective Cover.stl

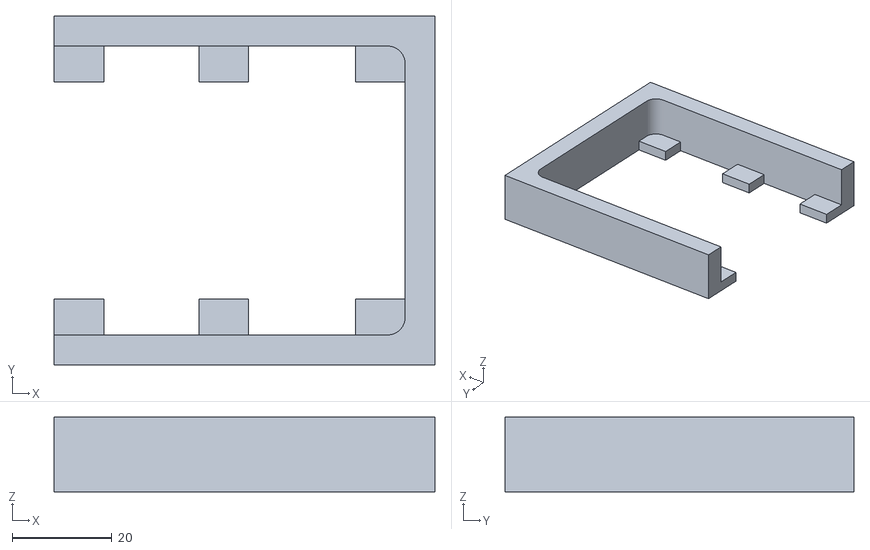
[picture p73: CAD file, 2021-09-20]
Imprimanta 3 A4 Lemn Platf Fixa/Exported STL files/Extruder/Extruder Carrier Plastic Protective Cover.stl
76.5 x 70.0 x 15.0
