TactileImages/TactilePrinterOne-P4/Imprimanta 4 A4 Metal/Exported STL files/Extruder/Syringe Barrel Holder.stl

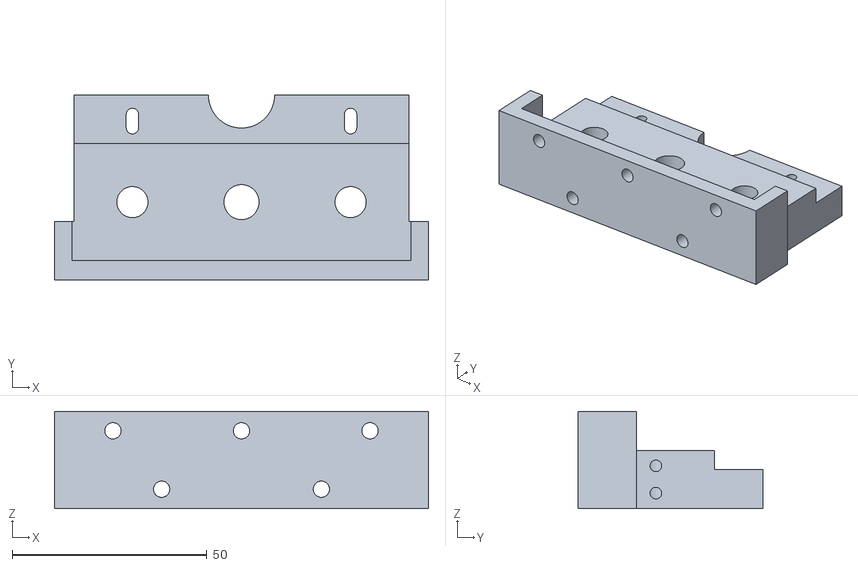
[picture p74: CAD file, 2021-09-20]
Imprimanta 4 A4 Metal/Exported STL files/Extruder/Syringe Barrel Holder.stl
96.0 x 47.5 x 25.0
