TactileImages/TactilePrinterOne-P4/Imprimanta 2 Metal A3/10 Mecanic/Prelucrari/0008-10-038  carcasa Fata.stl

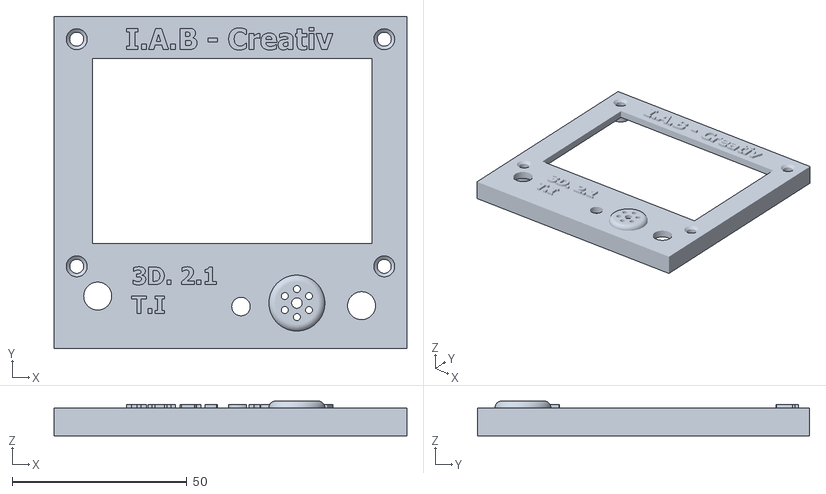
[picture p75: CAD file, 2021-09-20]
Imprimanta 2 Metal A3/10 Mecanic/Prelucrari/0008-10-038 carcasa Fata.stl
101.0 x 95.0 x 10.0
