TactileImages/TactilePrinterOne-P4/Imprimanta 4 A4 Metal/Exported STL files/Extruder/Syringe Barrel Flange Press.stl

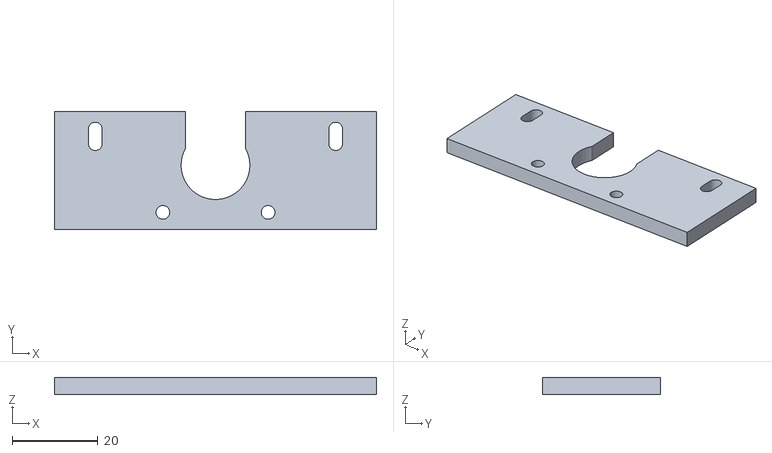
[picture p77: CAD file, 2021-09-20]
Imprimanta 4 A4 Metal/Exported STL files/Extruder/Syringe Barrel Flange Press.stl
75.0 x 27.5 x 4.00
