TactileImages/TactilePrinterOne-P4/Imprimanta 3 A4 Lemn Platf Fixa/Exported STL files/Extruder/Syringe Holder Plastic Body.stl

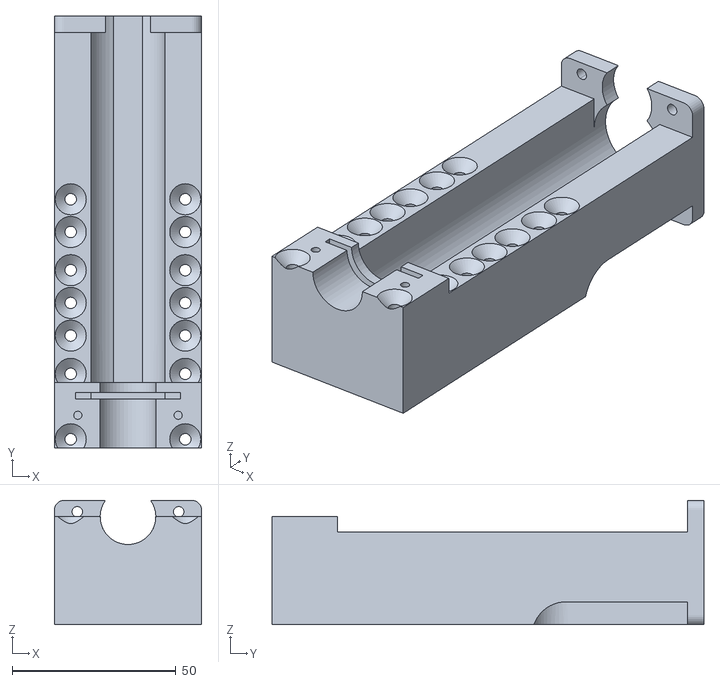
[picture p79: CAD file, 2021-09-20]
Imprimanta 3 A4 Lemn Platf Fixa/Exported STL files/Extruder/Syringe Holder Plastic Body.stl
45.0 x 132.0 x 38.0
