TactileImages/TactilePrinterOne-P4/Imprimanta 4 A4 Metal/Exported STL files/Extruder/Stepper Motor Holder.stl

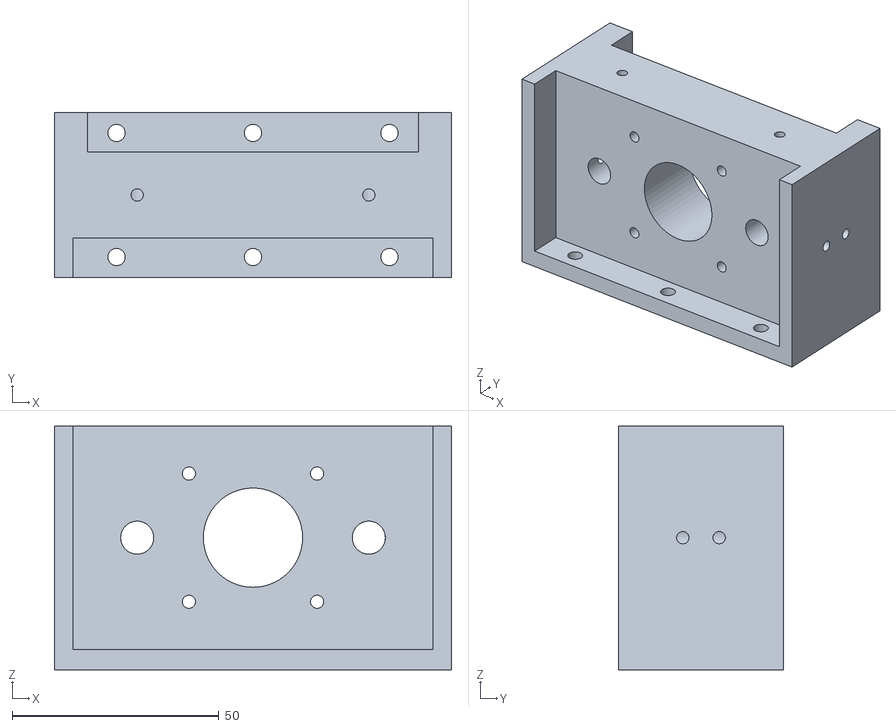
[picture p80: CAD file, 2021-09-20]
Imprimanta 4 A4 Metal/Exported STL files/Extruder/Stepper Motor Holder.stl
96.0 x 40.0 x 59.0
