TactileImages/TactilePrinterOne-P4/Imprimanta 2 Metal A3/10 Mecanic/Prelucrari/0008-10-029 Capac Arduino.stl

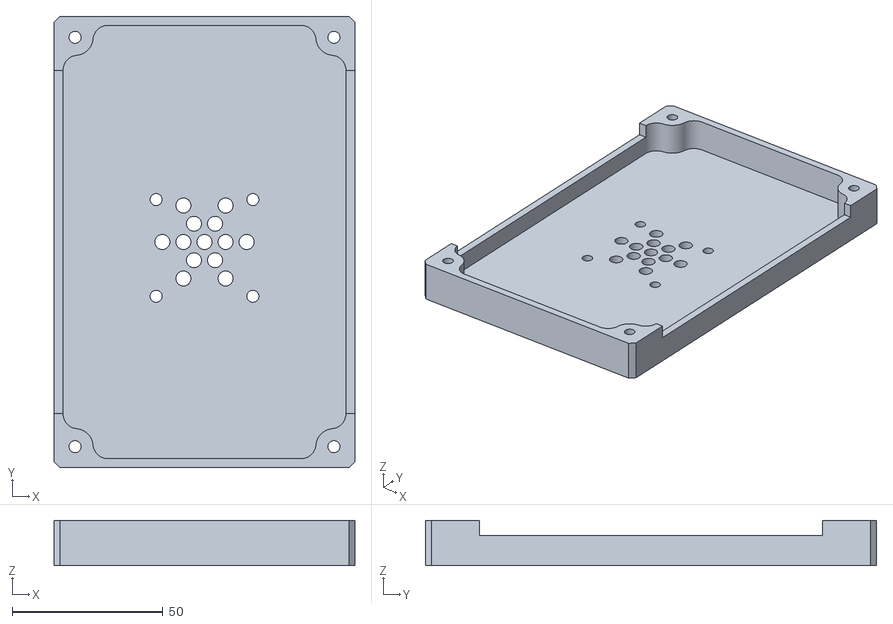
[picture p81: CAD file, 2021-09-20]
Imprimanta 2 Metal A3/10 Mecanic/Prelucrari/0008-10-029 Capac Arduino.stl
100.0 x 150.0 x 15.0
