TactileImages/TactilePrinterOne-P4/Imprimanta 3 A4 Lemn Platf Fixa/Exported STL files/Extruder/Stepper Motor Spacer.stl

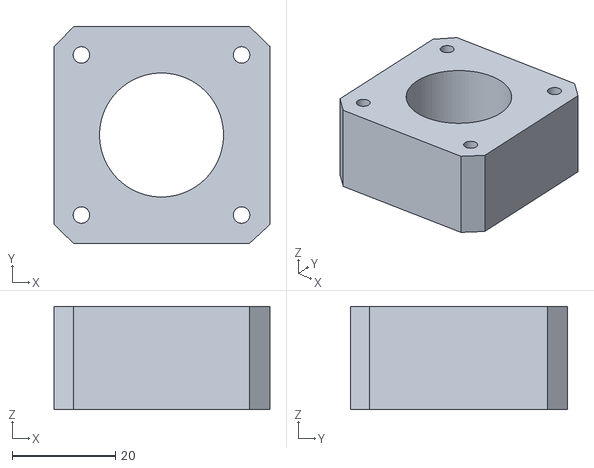
[picture p83: CAD file, 2021-09-20]
Imprimanta 3 A4 Lemn Platf Fixa/Exported STL files/Extruder/Stepper Motor Spacer.stl
41.8 x 42.0 x 20.0
