TactileImages/TactilePrinterOne-P4/Imprimanta 2 Metal A3/10 Mecanic/Prelucrari/0008-10-032 Suport cadru si axa Z.stl

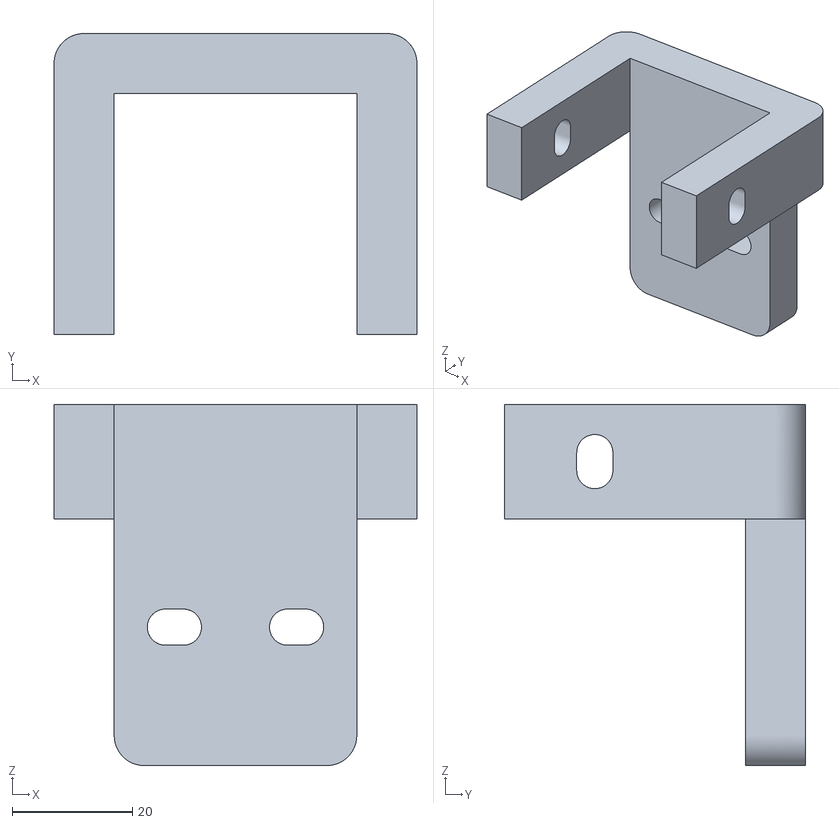
[picture p84: CAD file, 2021-09-20]
Imprimanta 2 Metal A3/10 Mecanic/Prelucrari/0008-10-032 Suport cadru si axa Z.stl
60.3 x 50.0 x 60.0
