TactileImages/TactilePrinterOne-P4/Imprimanta 2 Metal A3/30 Injectomat/Prelucrari/0008-30-015 roata condusa GT2_V2.stl

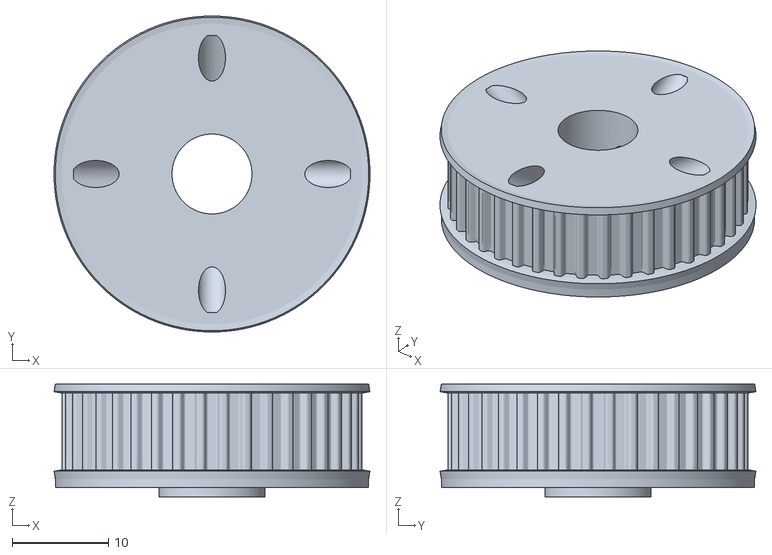
[picture p85: CAD file, 2021-09-20]
Imprimanta 2 Metal A3/30 Injectomat/Prelucrari/0008-30-015 roata condusa GT2_V2.stl
32.8 x 32.8 x 11.7
