TactileImages/TactilePrinterOne-P4/Imprimanta 2 Metal A3/10 Mecanic/Prelucrari/0008-10-019 Suport Axa Y.stl

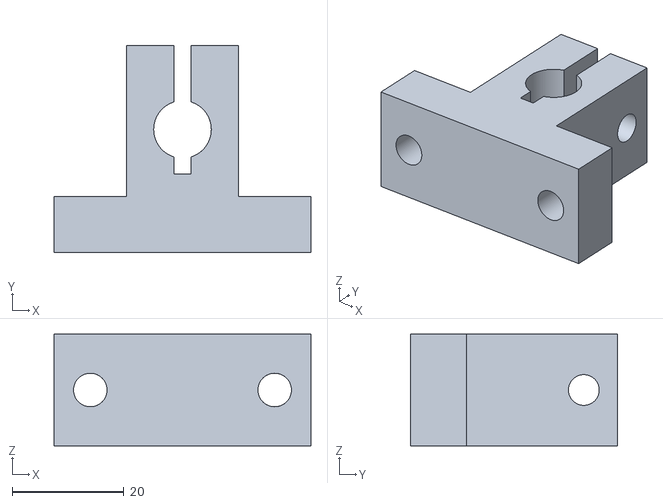
[picture p86: CAD file, 2021-09-20]
Imprimanta 2 Metal A3/10 Mecanic/Prelucrari/0008-10-019 Suport Axa Y.stl
46.0 x 37.0 x 20.0
