TactileImages/TactilePrinterOne-P4/Imprimanta 2 Metal A3/30 Injectomat/Prelucrari/0008-30-015 roata condusa GT2.stl

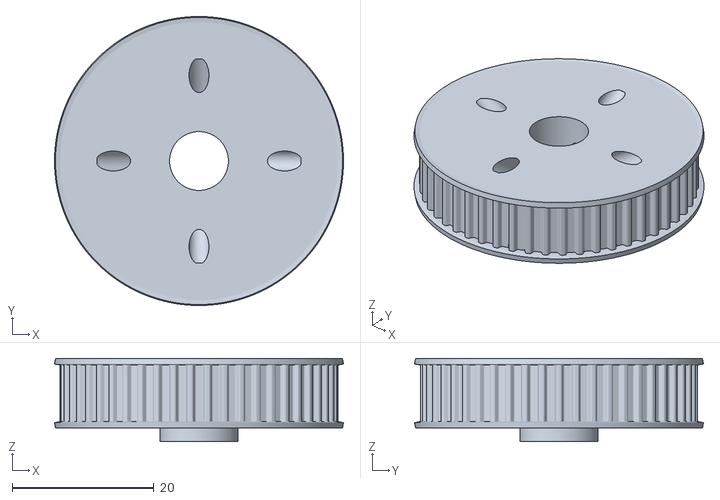
[picture p87: CAD file, 2021-09-20]
Imprimanta 2 Metal A3/30 Injectomat/Prelucrari/0008-30-015 roata condusa GT2.stl
40.8 x 40.8 x 11.7
