TactileImages/TactilePrinterOne-P4/Imprimanta 2 Metal A3/10 Mecanic/Prelucrari/0008-10-009 X Axis suport.stl

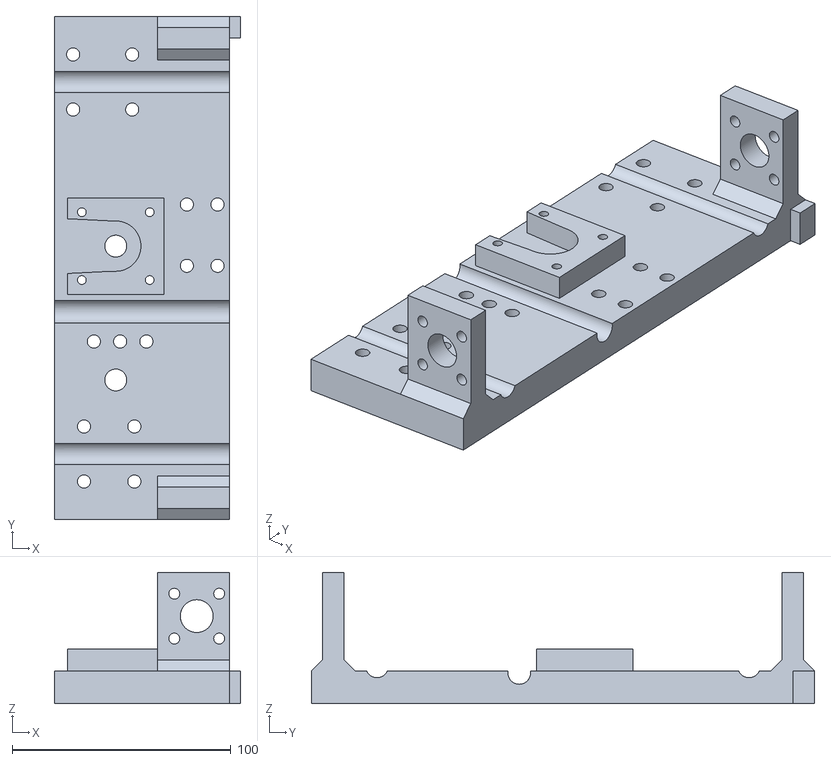
[picture p88: CAD file, 2021-09-20]
Imprimanta 2 Metal A3/10 Mecanic/Prelucrari/0008-10-009 X Axis suport.stl
85.0 x 230.0 x 60.0
