TactileImages/TactilePrinterOne-P4/Imprimanta 2 Metal A3/10 Mecanic/Prelucrari/0008-10-027 Cutie Arduino.stl

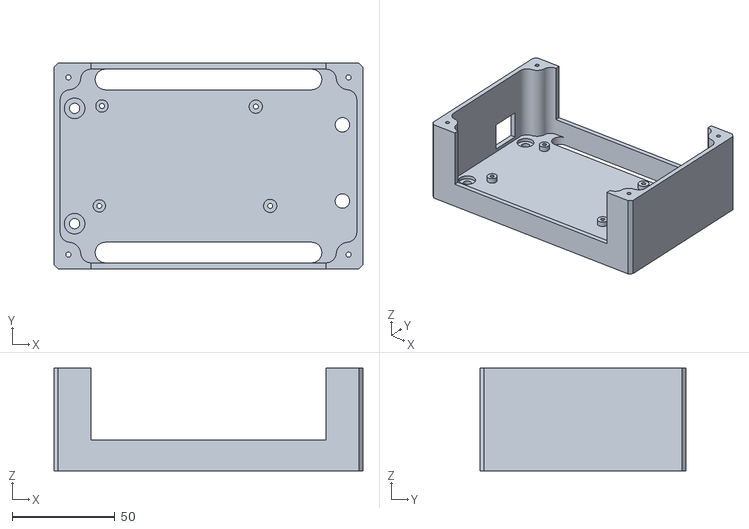
[picture p90: CAD file, 2021-09-20]
Imprimanta 2 Metal A3/10 Mecanic/Prelucrari/0008-10-027 Cutie Arduino.stl
150.0 x 100.0 x 50.0
