TactileImages/TactilePrinterOne-P4/Imprimanta 2 Metal A3/10 Mecanic/Prelucrari/0008-10-024 Ranforsare.stl

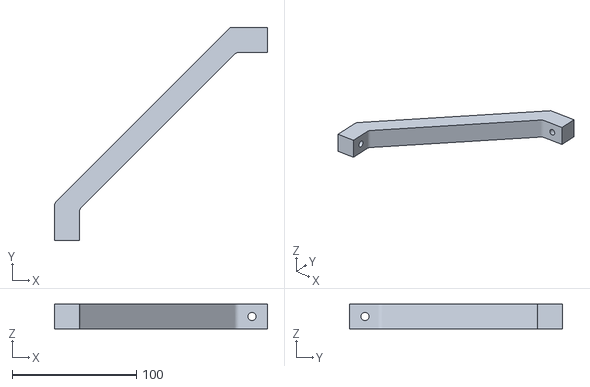
[picture p92: CAD file, 2021-09-20]
Imprimanta 2 Metal A3/10 Mecanic/Prelucrari/0008-10-024 Ranforsare.stl
171.4 x 171.4 x 20.0
