TactileImages/TactilePrinterOne-P4/Imprimanta 2 Metal A3/10 Mecanic/Prelucrari/0008-10-040 Buotn_Urgenta.stl

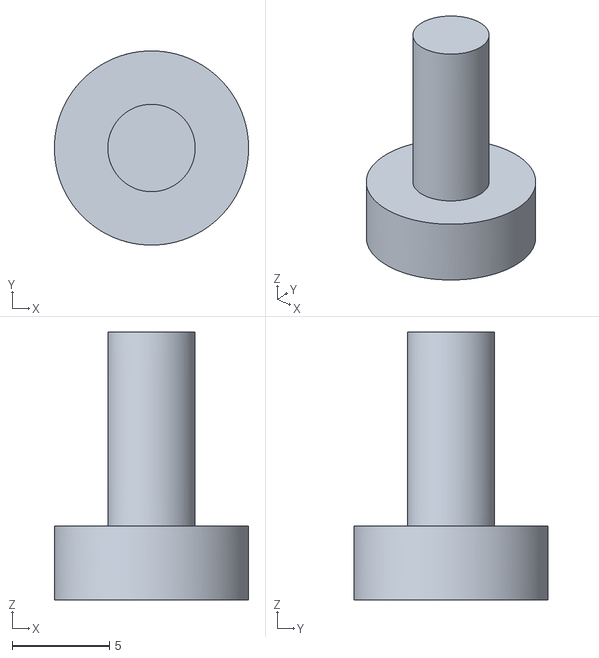
[picture p94: CAD file, 2021-09-20]
Imprimanta 2 Metal A3/10 Mecanic/Prelucrari/0008-10-040 Buotn_Urgenta.stl
10.0 x 10.00 x 13.8
