TactileImages/TactilePrinterOne-P4/(list of files, cad)

Other CAD files:
Imprimanta 2 Metal A3/10 Mecanic/0008-10-033.stl
Imprimanta 2 Metal A3/30 Injectomat/Drawings/30-01.dwg
Imprimanta 2 Metal A3/Drawings/0008-10-014.dwg
Imprimanta 2 Metal A3/Drawings/New folder/0008-10-058P.dwg
Imprimanta 2 Metal A3/Drawings/Prelucrari ELectric Steel/0008-10-022 Tabla suport.dwg
Imprimanta 4 A4 Metal/Exported STL files/Power Connector Case/Connector Case Body.stl
Imprimanta_1_Lemn/20 Electric/Templates/English/ANSI (in).dwg
Imprimanta_1_Lemn/20 Electric/Templates/Metric/DIN.dwg
Imprimanta_1_Lemn/20 Electric/Templates/Standard.dwg
Imprimanta_1_Lemn/Drawings/0005-00-05.dwg
Imprimanta 2 Metal A3/10 Mecanic/Prelucrari/New folder/0008-10-035.stl
Imprimanta 2 Metal A3/30 Injectomat/Drawings/30-11 Piece parts.dwg
Imprimanta 2 Metal A3/Drawings/0008-10-037.dwg
Imprimanta 2 Metal A3/Drawings/New folder/0008-10-059P.dwg
Imprimanta 2 Metal A3/Drawings/Prelucrari ELectric Steel/0008-10-017 Heated bed_Pentru DWG.dwg
Imprimanta 4 A4 Metal/Exported STL files/Arduino Case/Arduino Case Body.stl
Imprimanta_1_Lemn/20 Electric/Templates/Metric/GB.dwg
Imprimanta 2 Metal A3/30 Injectomat/Drawings/30-08 Piece parts.dwg
Imprimanta 2 Metal A3/Drawings/New folder/0008-10-066P.dwg
Imprimanta 2 Metal A3/Drawings/Prelucrari ELectric Steel/0008-10-018 Suport Heated Bed.dwg
Imprimanta_1_Lemn/20 Electric/Templates/Metric/ANSI (mm).dwg
Imprimanta_1_Lemn/Drawings/0005-00-11.dwg
Imprimanta 2 Metal A3/30 Injectomat/Drawings/30-15 Piece parts.dwg
Imprimanta 2 Metal A3/Drawings/0008-10-060.dwg
Imprimanta 2 Metal A3/Drawings/New folder/0008-10-063P.dwg
Imprimanta_1_Lemn/20 Electric/Templates/Metric/JIS.dwg
Imprimanta_1_Lemn/Drawings/0005-20-00 Electric 1.dwg
Imprimanta 2 Metal A3/30 Injectomat/Drawings/30-07 Piece parts.dwg
Imprimanta 2 Metal A3/Drawings/0008-10-018.dwg
Imprimanta 2 Metal A3/Drawings/New folder/0008-10-060P.dwg
Imprimanta_1_Lemn/20 Electric/Templates/Metric/GOST.dwg
Imprimanta_1_Lemn/Drawings/0005-00-07.dwg
Imprimanta 2 Metal A3/30 Injectomat/Drawings/30-12 Piece parts.dwg
Imprimanta 2 Metal A3/Drawings/0008-10-032.dwg
Imprimanta 2 Metal A3/Drawings/New folder/0008-10-062P.dwg
Imprimanta_1_Lemn/20 Electric/Templates/Metric/ISO.dwg
Imprimanta_1_Lemn/Drawings/0005-00-00 Ansamblu General.dwg
Imprimanta 2 Metal A3/30 Injectomat/Drawings/30-00 Injectomat suplimentar Asamblare imprimanta.dwg
Imprimanta 2 Metal A3/Drawings/0008-10-058.dwg
Imprimanta 2 Metal A3/Drawings/New folder/0008-10-061P.dwg
Imprimanta_1_Lemn/20 Electric/Templates/Metric/BSI.dwg
Imprimanta_1_Lemn/Drawings/0005-00-03.dwg
Imprimanta 2 Metal A3/30 Injectomat/Drawings/30-09 Piece parts.dwg
Imprimanta 2 Metal A3/Drawings/0008-10-071.dwg
Imprimanta 2 Metal A3/Drawings/New folder/0008-10-064P.dwg
Imprimanta_1_Lemn/Drawings/0005-00-01.dwg
Imprimanta 2 Metal A3/10 Mecanic/Prelucrari/0008-10-035.stl
Imprimanta 2 Metal A3/30 Injectomat/Drawings/30-14 Piece parts.dwg
Imprimanta 2 Metal A3/Drawings/New folder/0008-10-057P.dwg
Imprimanta_1_Lemn/Drawings/0005-00-17.dwg
Imprimanta 2 Metal A3/30 Injectomat/Drawings/30-13 Piece parts.dwg
Imprimanta 2 Metal A3/Drawings/0008-10-017.dwg
Imprimanta 2 Metal A3/Drawings/New folder/0008-10-065P.dwg
Imprimanta_1_Lemn/Drawings/0005-00-06.dwg
Imprimanta 2 Metal A3/30 Injectomat/Drawings/30-04 Piece parts.dwg
Imprimanta 2 Metal A3/Drawings/0008-10-047.dwg
Imprimanta_1_Lemn/Drawings/0005-00-09.dwg
Imprimanta 2 Metal A3/30 Injectomat/Drawings/30-06 Piece parts.dwg
Imprimanta 2 Metal A3/Drawings/0008-10-002.dwg
Imprimanta 2 Metal A3/30 Injectomat/Drawings/30-05 Piece parts.dwg
Imprimanta_1_Lemn/Drawings/0005-00-04.dwg
Imprimanta 2 Metal A3/Drawings/0008-10-030.dwg
Imprimanta_1_Lemn/Drawings/0005-00-21.dwg
Imprimanta 2 Metal A3/30 Injectomat/Drawings/30-02 Piece parts.dwg
Imprimanta 2 Metal A3/Drawings/0008-10-013.dwg
Imprimanta_1_Lemn/Drawings/0005-00-12.dwg
Imprimanta 2 Metal A3/30 Injectomat/Drawings/30-10 Piece parts.dwg
Imprimanta 2 Metal A3/10 Mecanic/0008-10-001.ipt
Imprimanta 2 Metal A3/10 Mecanic/0008-10-002 Corp_Injectomat1.ipt
Imprimanta 2 Metal A3/10 Mecanic/0008-10-003.ipt
Imprimanta 2 Metal A3/10 Mecanic/0008-10-004 Fixare seringa.ipt
Imprimanta 2 Metal A3/10 Mecanic/0008-10-005 Suport_Rulment.ipt
Imprimanta 2 Metal A3/10 Mecanic/0008-10-006 suport injectomat.ipt
Imprimanta 2 Metal A3/10 Mecanic/0008-10-007 Contra suport injectomat.ipt
Imprimanta 2 Metal A3/10 Mecanic/0008-10-008 X Axis suport.ipt
Imprimanta 2 Metal A3/10 Mecanic/0008-10-009 X Axis suport.ipt
Imprimanta 2 Metal A3/10 Mecanic/0008-10-01 Sckeleton.iam
Imprimanta 2 Metal A3/10 Mecanic/0008-10-01 Sckeleton.ipn
Imprimanta 2 Metal A3/10 Mecanic/0008-10-010 Fixare AxaX.ipt
Imprimanta 2 Metal A3/10 Mecanic/0008-10-011 Fixare AxaX Mijloc.ipt
Imprimanta 2 Metal A3/10 Mecanic/0008-10-012 Intinzator X.ipt
Imprimanta 2 Metal A3/10 Mecanic/0008-10-013 Supaort Piulita Axa Z.ipt
Imprimanta 2 Metal A3/10 Mecanic/0008-10-013 Supaort Piulita Axa Z1.ipt
Imprimanta 2 Metal A3/10 Mecanic/0008-10-013 Supaort Piulita Axa Z2.ipt
Imprimanta 2 Metal A3/10 Mecanic/0008-10-015 roata condusa GT2.ipt
Imprimanta 2 Metal A3/10 Mecanic/0008-10-016 Suport Motor Z.ipt
Imprimanta 2 Metal A3/10 Mecanic/0008-10-017 Heated bed.ipt
Imprimanta 2 Metal A3/10 Mecanic/0008-10-018 Suport Heated Bed.ipt
Imprimanta 2 Metal A3/10 Mecanic/0008-10-019 Suport Axa Y.ipt
Imprimanta 2 Metal A3/10 Mecanic/0008-10-02 X Axis.iam
Imprimanta 2 Metal A3/10 Mecanic/0008-10-02 X Axis.ipn
Imprimanta 2 Metal A3/10 Mecanic/0008-10-02 X Axis/Design Accelerator/OldVersions/Synchronous Belt1.0001.ipt
Imprimanta 2 Metal A3/10 Mecanic/0008-10-02 X Axis/Design Accelerator/Synchronous Belt1.ipt
Imprimanta 2 Metal A3/10 Mecanic/0008-10-020 Suport Axa Y.ipt
Imprimanta 2 Metal A3/10 Mecanic/0008-10-021 Suport Motor Z R.ipt
Imprimanta 2 Metal A3/10 Mecanic/0008-10-022 Tabla suport.ipt
Imprimanta 2 Metal A3/10 Mecanic/0008-10-023 Suport L.ipt
Imprimanta 2 Metal A3/10 Mecanic/0008-10-024 Ranforsare.ipt
Imprimanta 2 Metal A3/10 Mecanic/0008-10-025 Ranforsare 2.ipt
Imprimanta 2 Metal A3/10 Mecanic/0008-10-026 Suport cutie.ipt
Imprimanta 2 Metal A3/10 Mecanic/0008-10-027 Cutie Arduino.ipt
Imprimanta 2 Metal A3/10 Mecanic/0008-10-028 Cutie Elemente incalzire.ipt
Imprimanta 2 Metal A3/10 Mecanic/0008-10-029 Capac Arduino.ipt
Imprimanta 2 Metal A3/10 Mecanic/0008-10-03 YAxis.iam
Imprimanta 2 Metal A3/10 Mecanic/0008-10-03 YAxis.ipn
Imprimanta 2 Metal A3/10 Mecanic/0008-10-03 YAxis/Design Accelerator/OldVersions/Synchronous Belt1.0001.ipt
Imprimanta 2 Metal A3/10 Mecanic/0008-10-03 YAxis/Design Accelerator/OldVersions/Synchronous Belts Transmission1.0002.iam
Imprimanta 2 Metal A3/10 Mecanic/0008-10-03 YAxis/Design Accelerator/Synchronous Belt1.ipt
Imprimanta 2 Metal A3/10 Mecanic/0008-10-03 YAxis/Design Accelerator/Synchronous Belts Transmission1.iam
Imprimanta 2 Metal A3/10 Mecanic/0008-10-030 Suport L.ipt
Imprimanta 2 Metal A3/10 Mecanic/0008-10-031 Suport L + placa.ipt
Imprimanta 2 Metal A3/10 Mecanic/0008-10-032 Suport cadru si axa Z.ipt
Imprimanta 2 Metal A3/10 Mecanic/0008-10-033.ipt
Imprimanta 2 Metal A3/10 Mecanic/0008-10-034 Suport_Rulment.ipt
Imprimanta 2 Metal A3/10 Mecanic/0008-10-035.ipt
Imprimanta 2 Metal A3/10 Mecanic/0008-10-036.ipt
Imprimanta 2 Metal A3/10 Mecanic/0008-10-037.ipt
Imprimanta 2 Metal A3/10 Mecanic/0008-10-038 carcasa Fata.ipt
Imprimanta 2 Metal A3/10 Mecanic/0008-10-039 carcasa spate.ipt
Imprimanta 2 Metal A3/10 Mecanic/0008-10-04 Z axis.iam
Imprimanta 2 Metal A3/10 Mecanic/0008-10-04 Z axis.ipn
Imprimanta 2 Metal A3/10 Mecanic/0008-10-040 Buotn_Urgenta.ipt
Imprimanta 2 Metal A3/10 Mecanic/0008-10-041 Ciuperca.ipt
Imprimanta 2 Metal A3/10 Mecanic/0008-10-042 Joistic.ipt
Imprimanta 2 Metal A3/10 Mecanic/0008-10-043.ipt
Imprimanta 2 Metal A3/10 Mecanic/0008-10-044.ipt
Imprimanta 2 Metal A3/10 Mecanic/0008-10-045.ipt
Imprimanta 2 Metal A3/10 Mecanic/0008-10-046 Fixare axa si port cablu.ipt
Imprimanta 2 Metal A3/10 Mecanic/0008-10-047 Suport Rulment Sc si curea.ipt
Imprimanta 2 Metal A3/10 Mecanic/0008-10-048.ipt
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
