TactileImages/TactilePrinterOne-P4/Imprimanta 3 A4 Lemn Platf Fixa/Drawings/Extuder Assembly.pdf

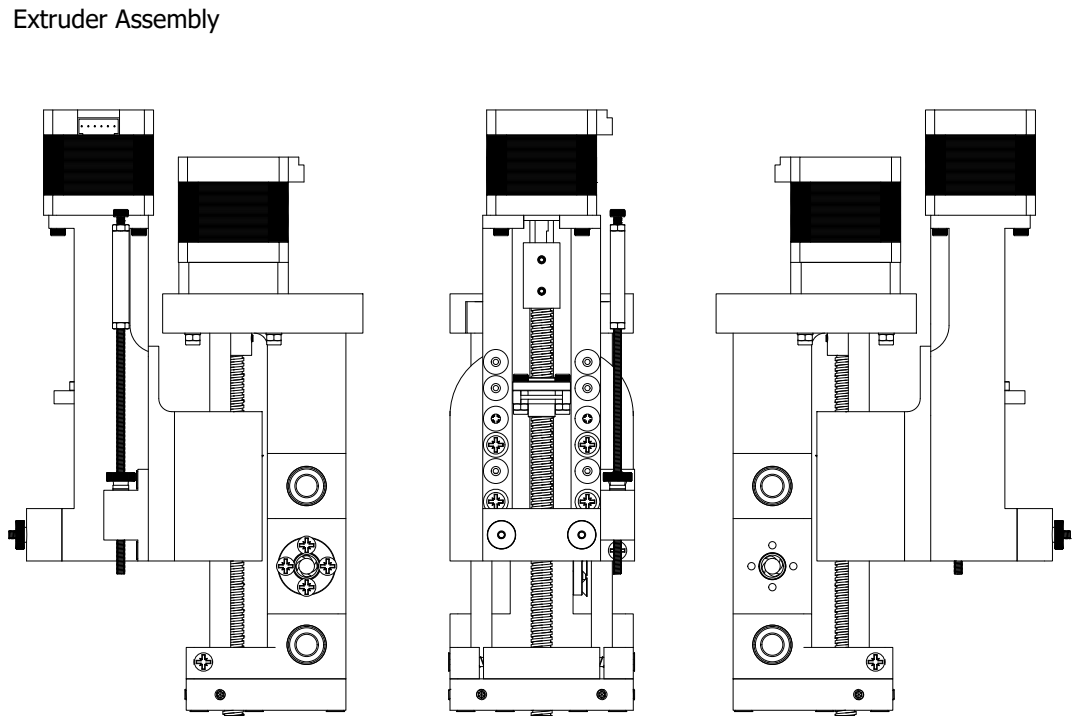
[picture p95: page 1]
Extruder Assembly

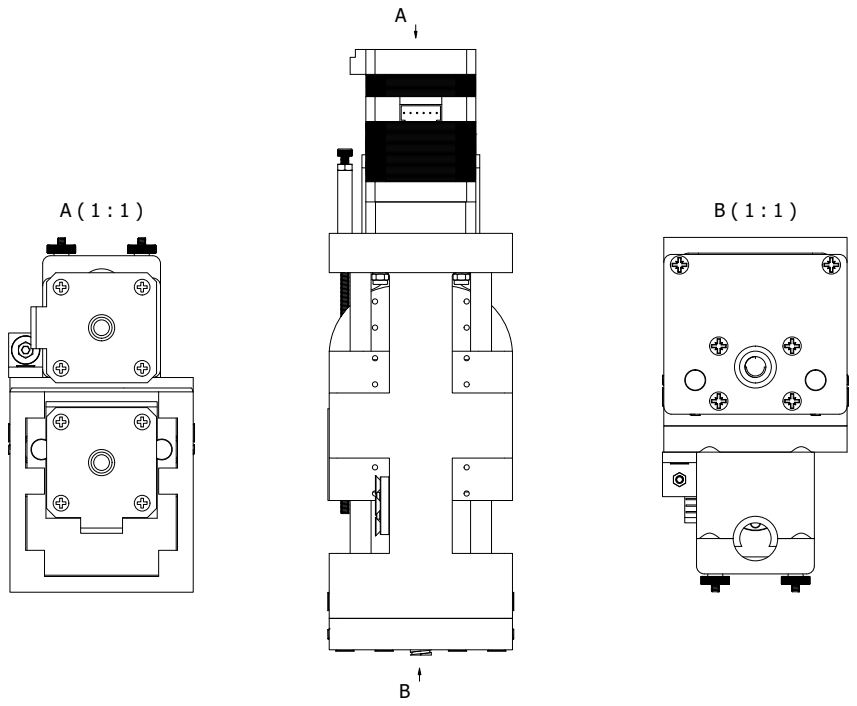
[picture p96: page 2]

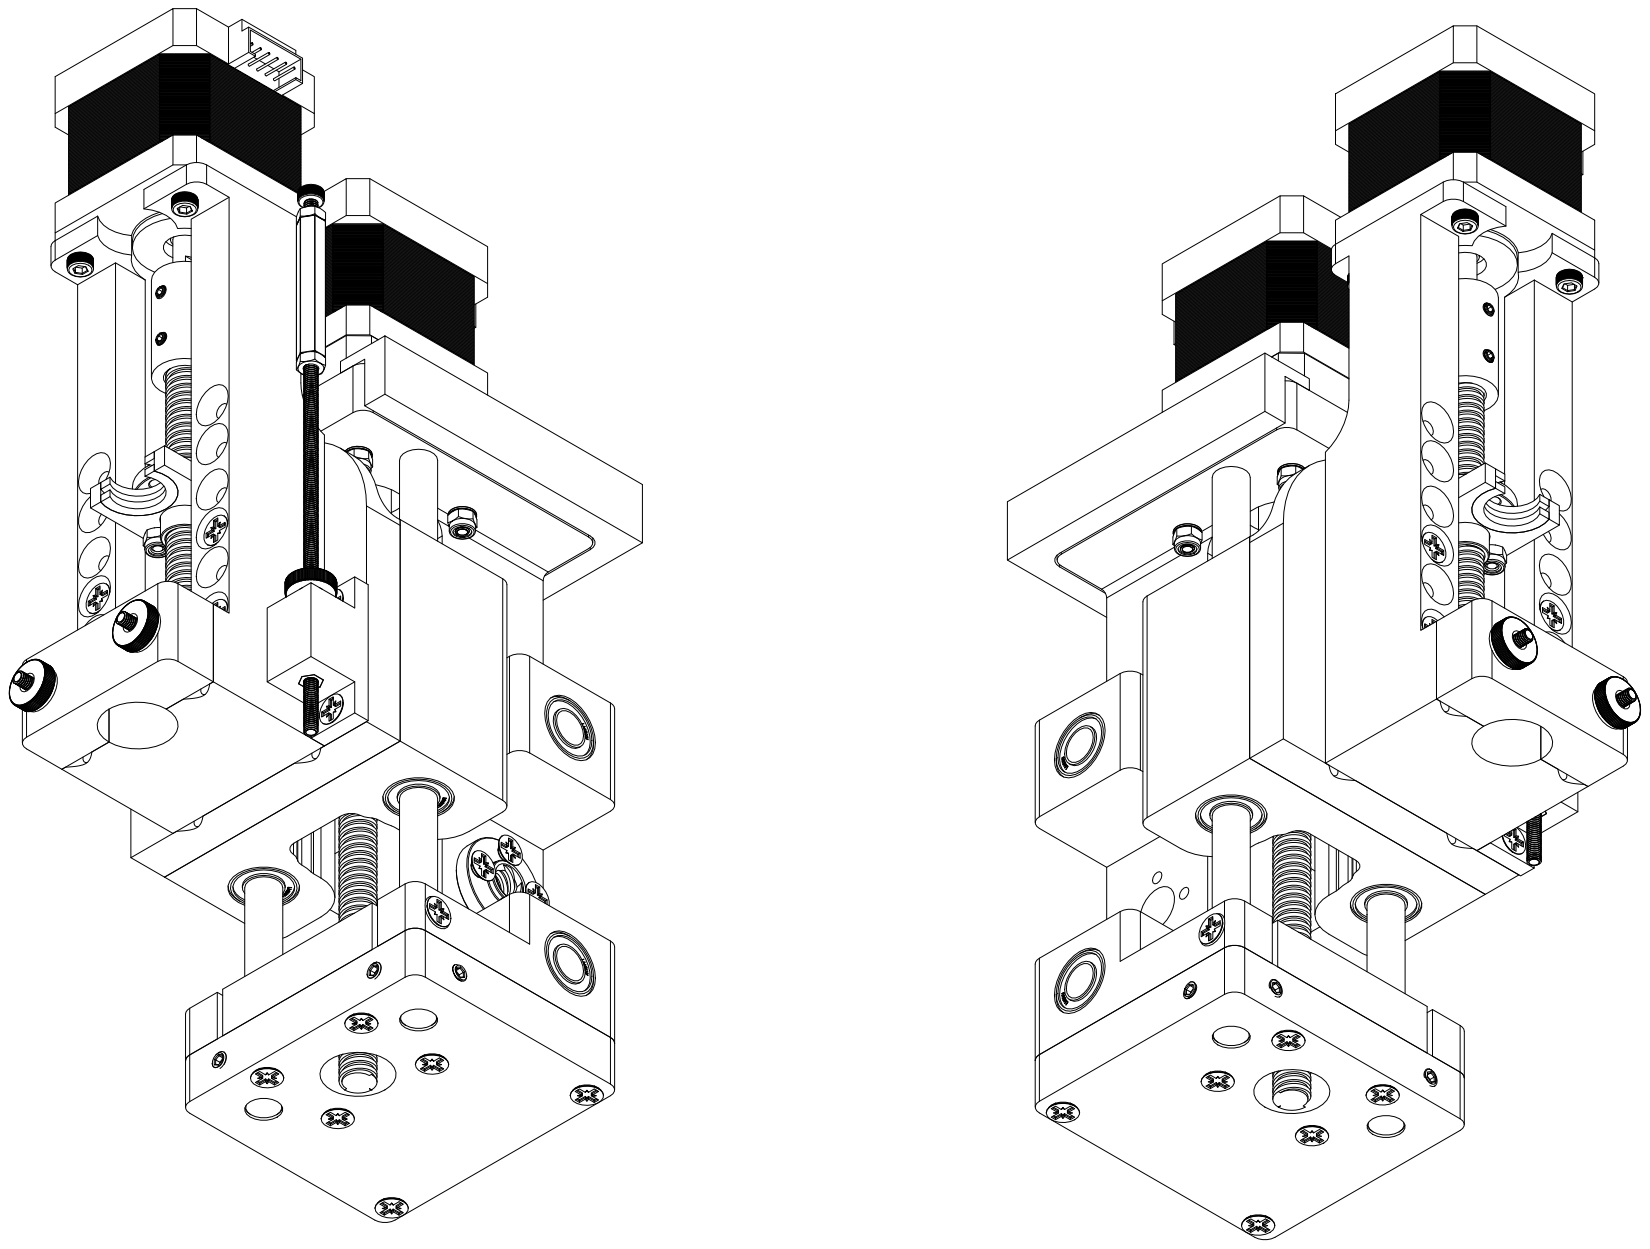
[picture p97: page 3]

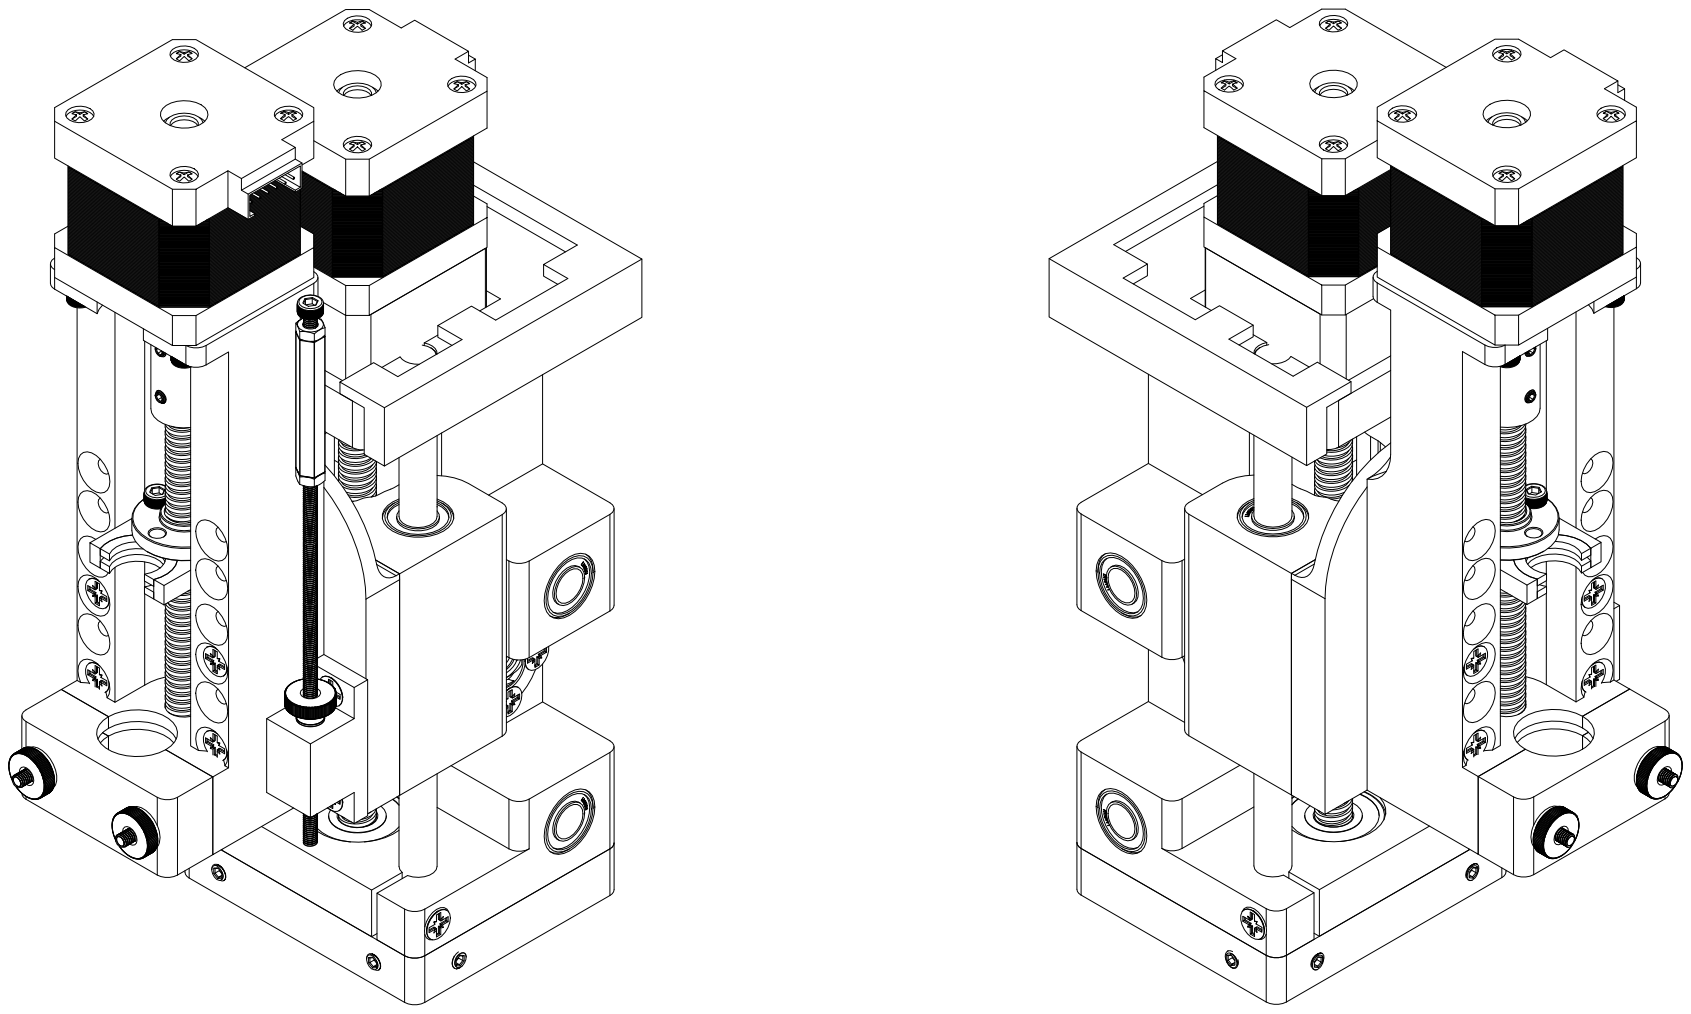
[picture p98: page 4]

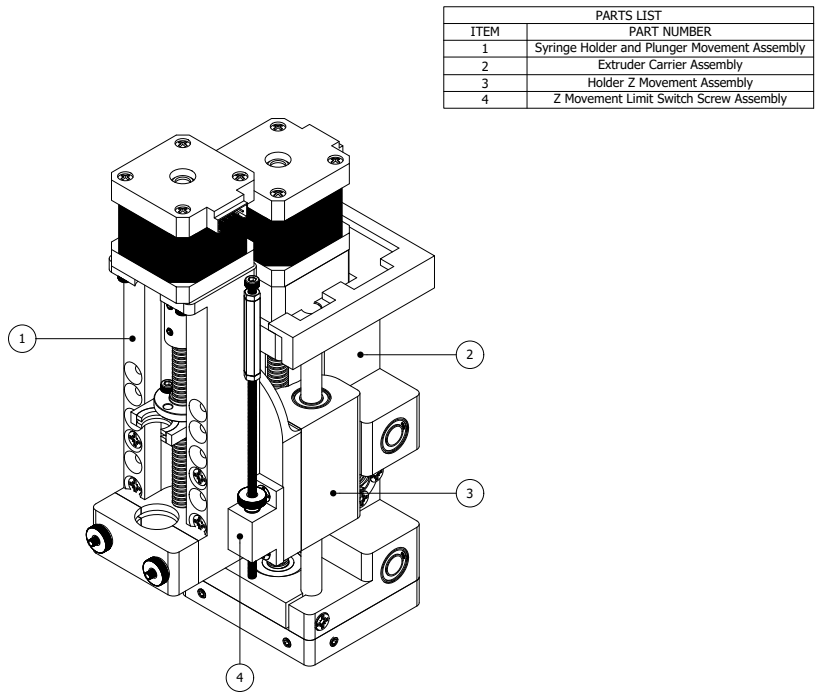
[picture p99: page 5]
PARTS LIST; ITEM; PART NUMBER; Syringe Holder and Plunger Movement Assembly; Extruder Carrier Assembly; Holder Z Movement Assembly; Z Movement Limit Switch Screw Assembly

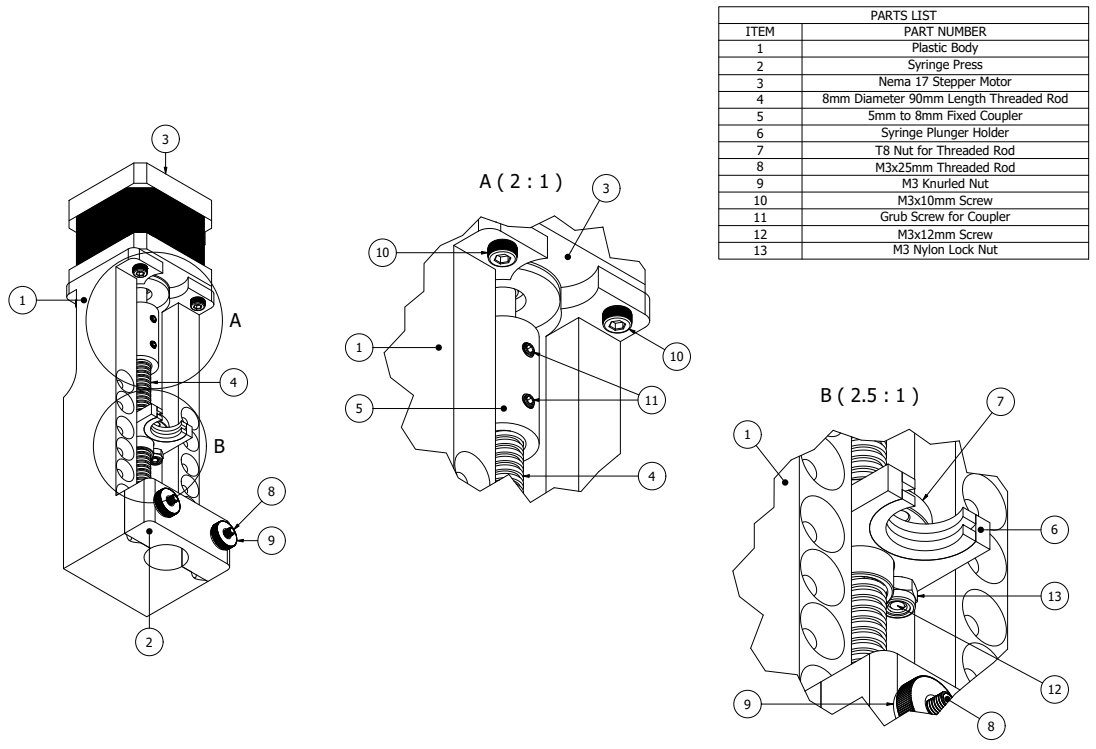
[picture p100: page 6]

Pla s t i c B o d y

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

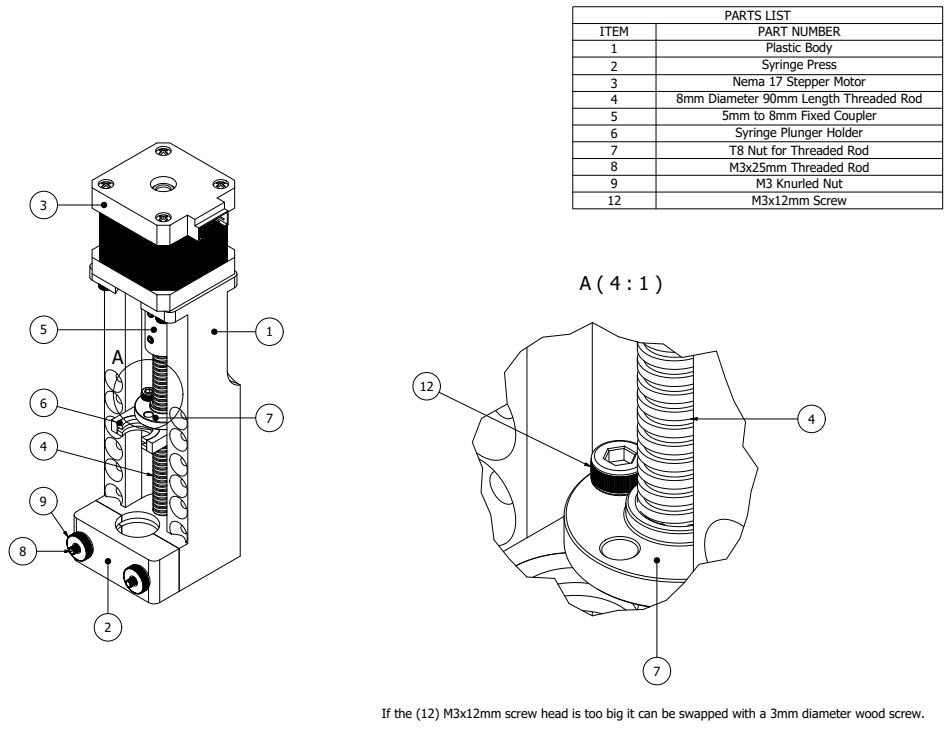
[picture p101: page 7]
PARTS LIST

ITEM | PART NUMBER
1 | Plastic Body
2 | Syringe Press
3 | Nema 17 Stepper Motor
4 | 8mm Diameter 90mm Length Threaded Rod
5 | 5mm to 8mm Fixed Coupler
6 | Syringe Plunger Holder
7 | T8 Nut for Threaded Rod
8 | M3x25mm Threaded Rod
9 | M3 Knurled Nut
12 | M3x12mm Screw

If the (12) M3x12mm screw head is too big it can be swapped with a 3mm diameter wood screw.

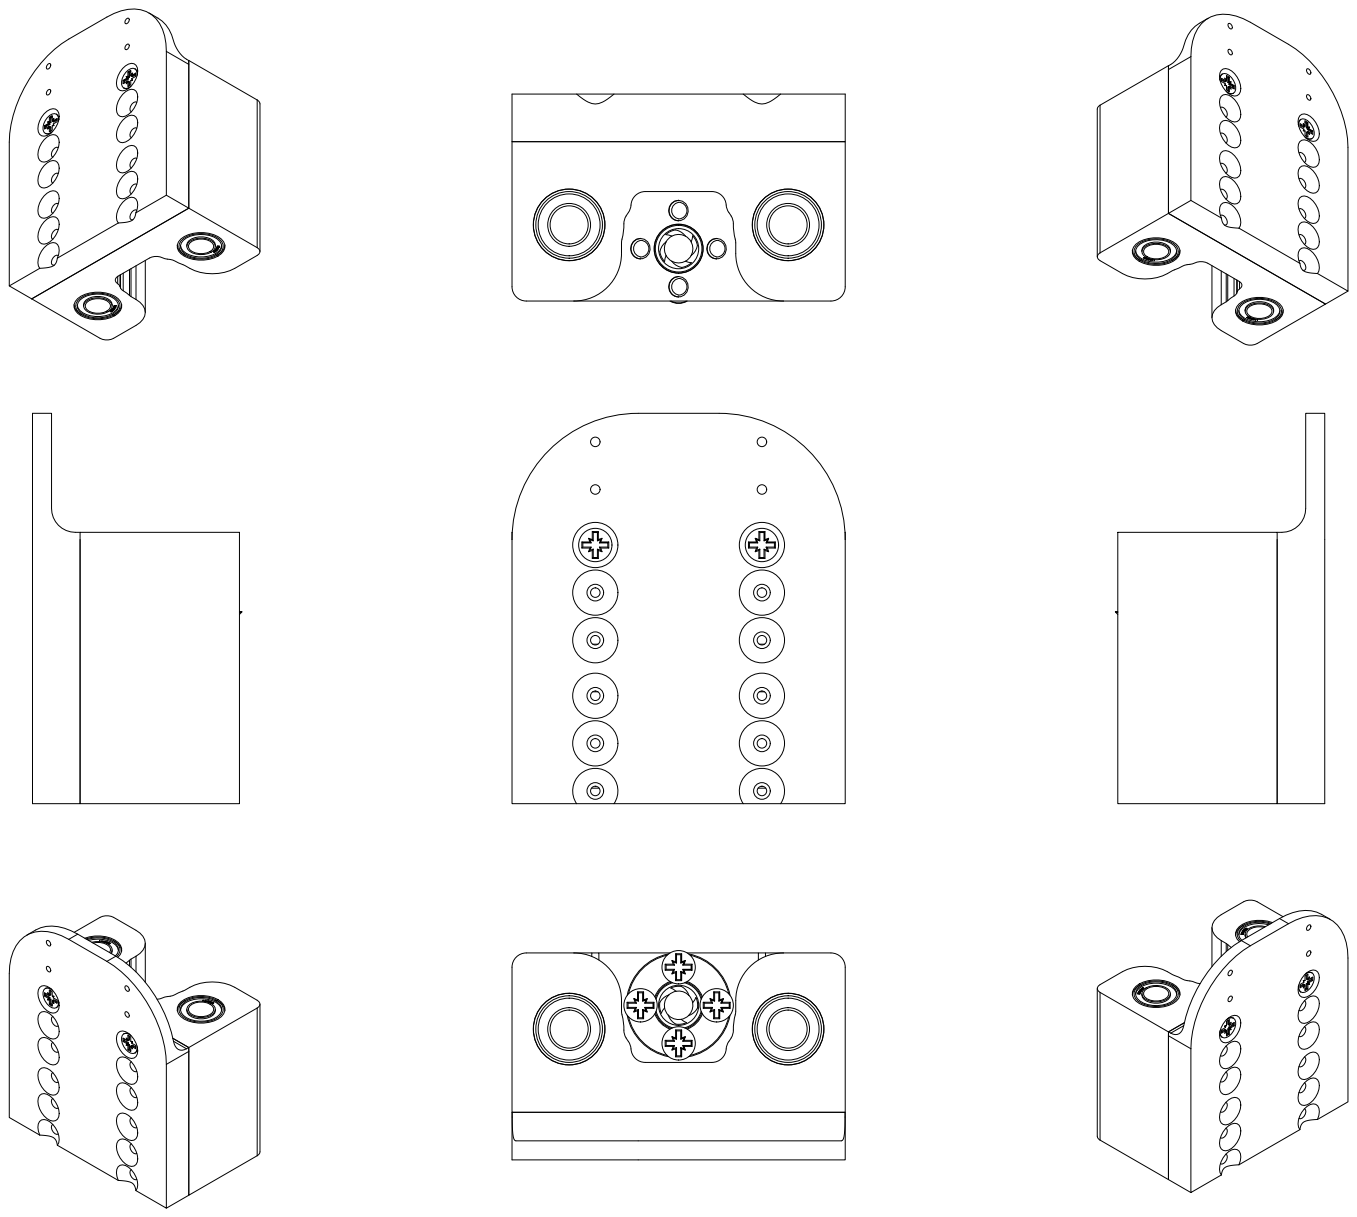
[picture p102: page 8]

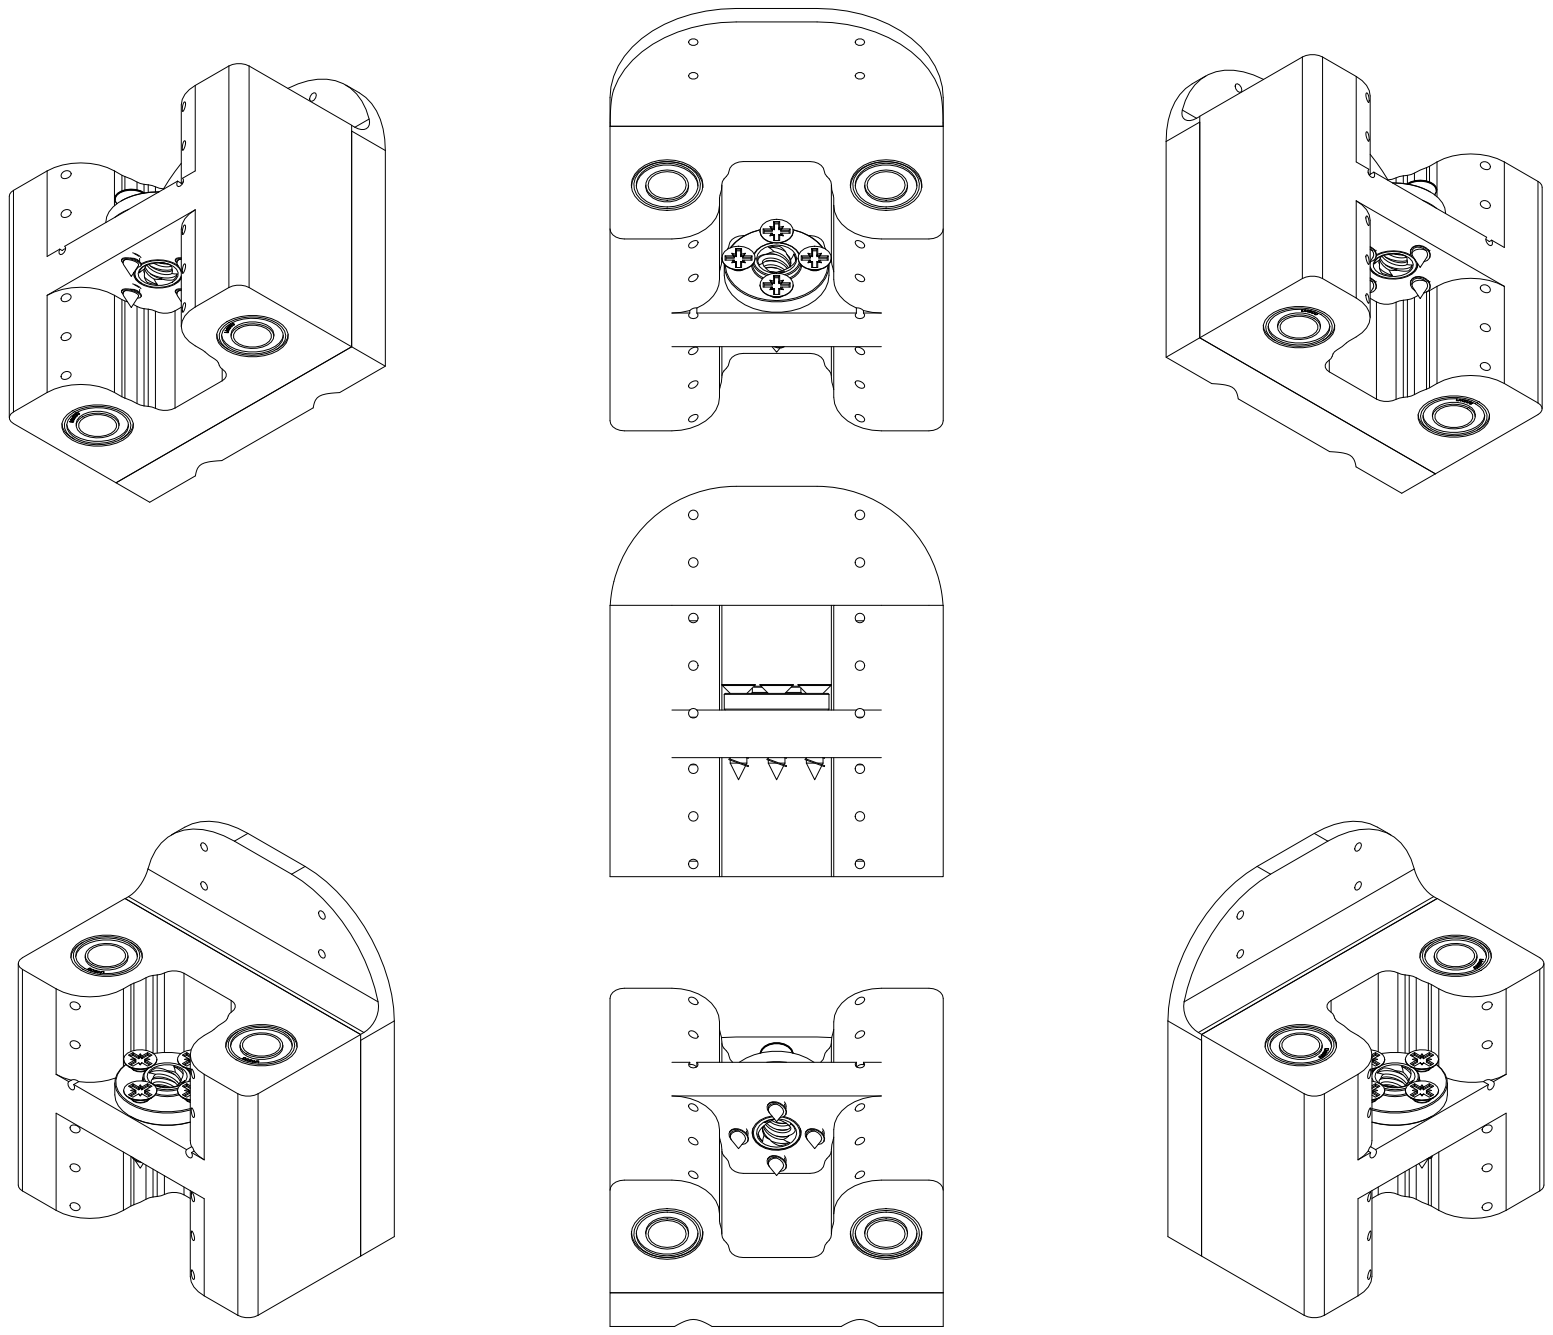
[picture p103: page 9]

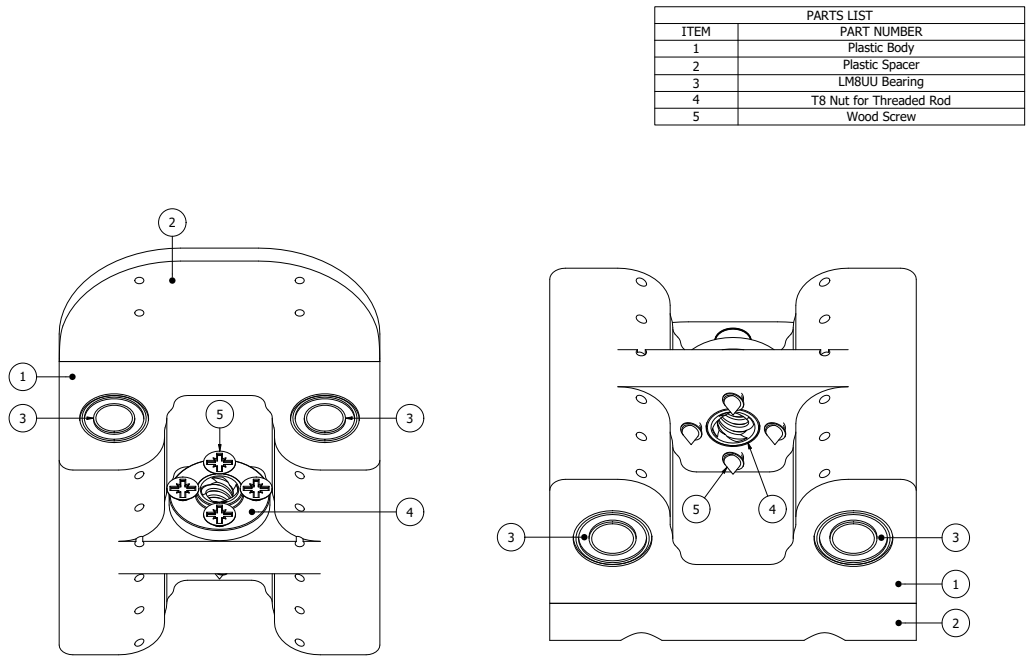
[picture p104: page 10]

Pla s t i c B o d y

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

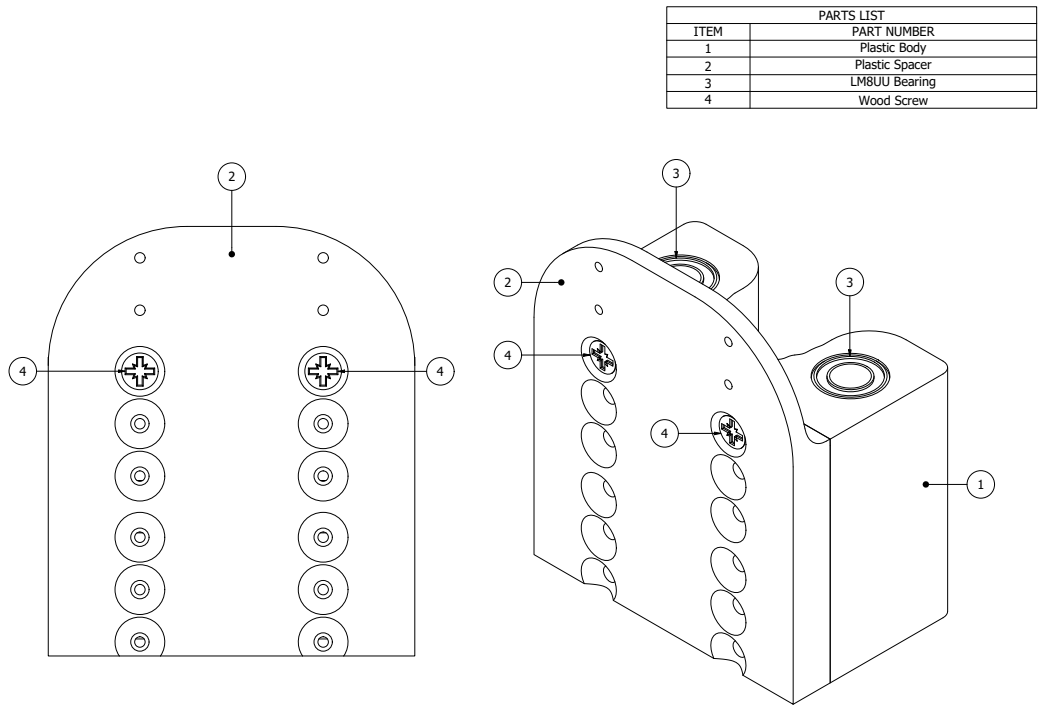
[picture p105: page 11]

Pla s t i c B o d y

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

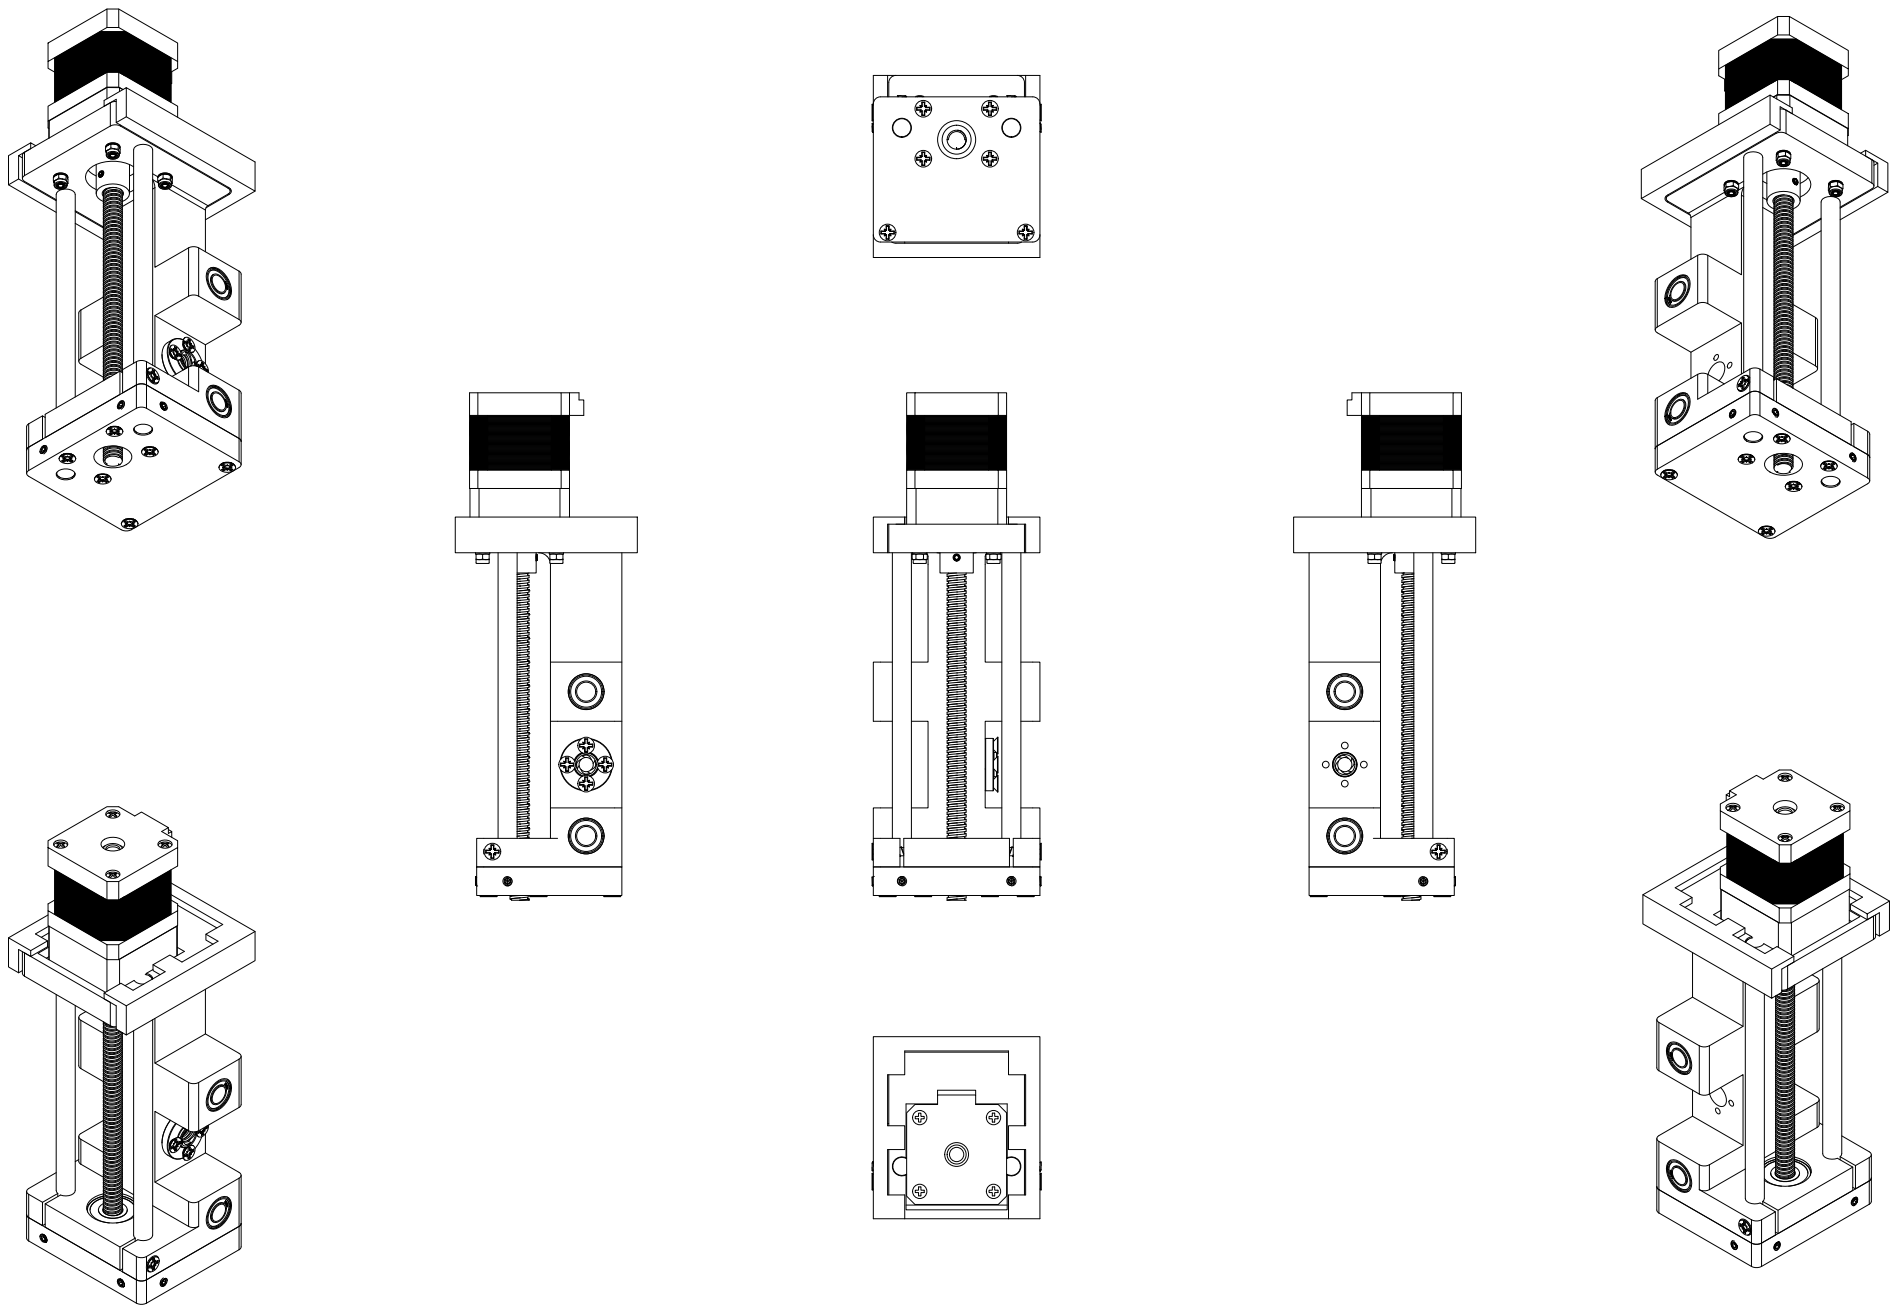
[picture p106: page 12]

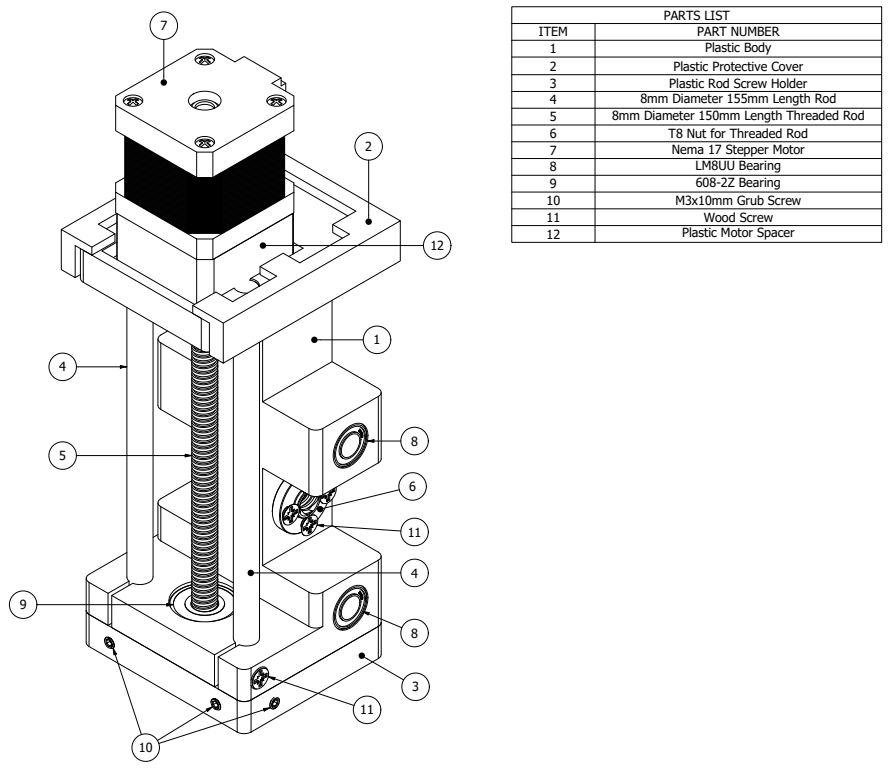
[picture p107: page 13]
PARTS LIST

ITEM | PART NUMBER
1 | Plastic Body
2 | Plastic Protective Cover
3 | Plastic Rod Screw Holder
4 | 8mm Diameter 155mm Length Rod
5 | 8mm Diameter 150mm Length Threaded Rod
6 | T8 Nut for Threaded Rod
7 | Nema 17 Stepper Motor
8 | LM8UU Bearing
9 | 608-2Z Bearing
10 | M3x10mm Grub Screw
11 | Wood Screw
12 | Plastic Motor Spacer

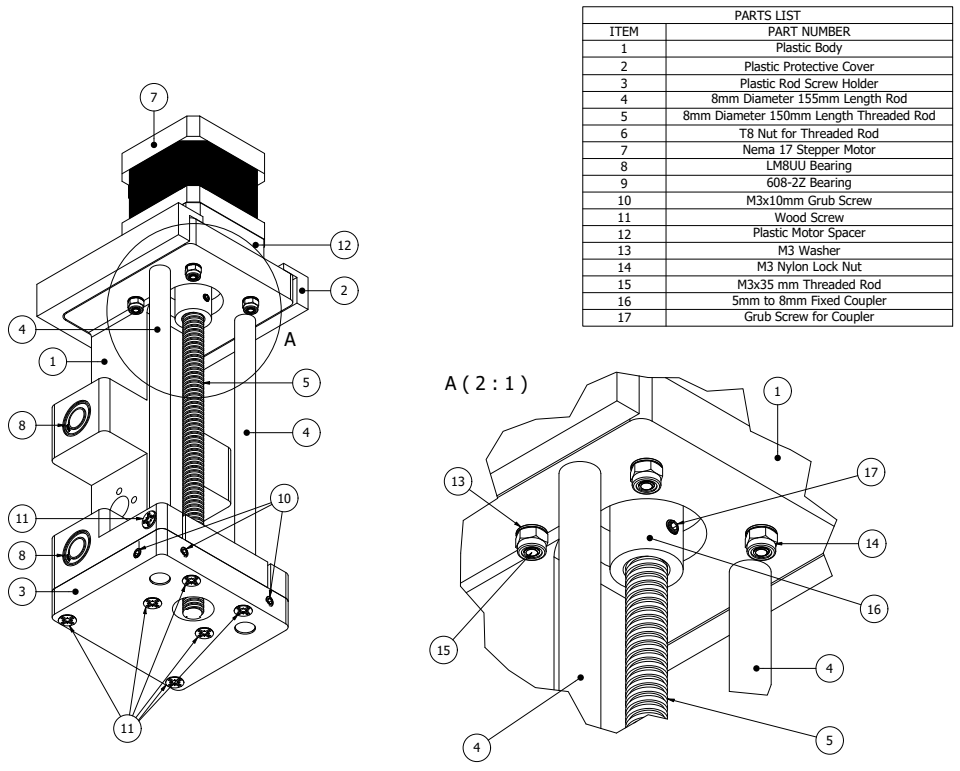
[picture p108: page 14]

Pla s t i c B o d y

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

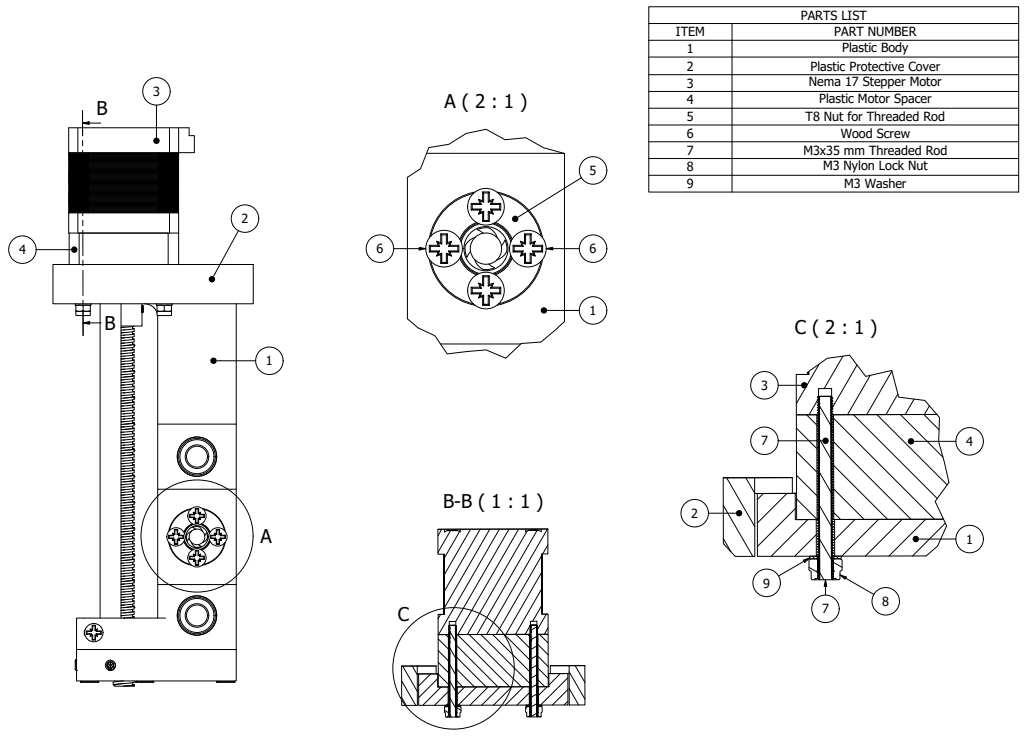
[picture p109: page 15]

Pla s t i c B o d y

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

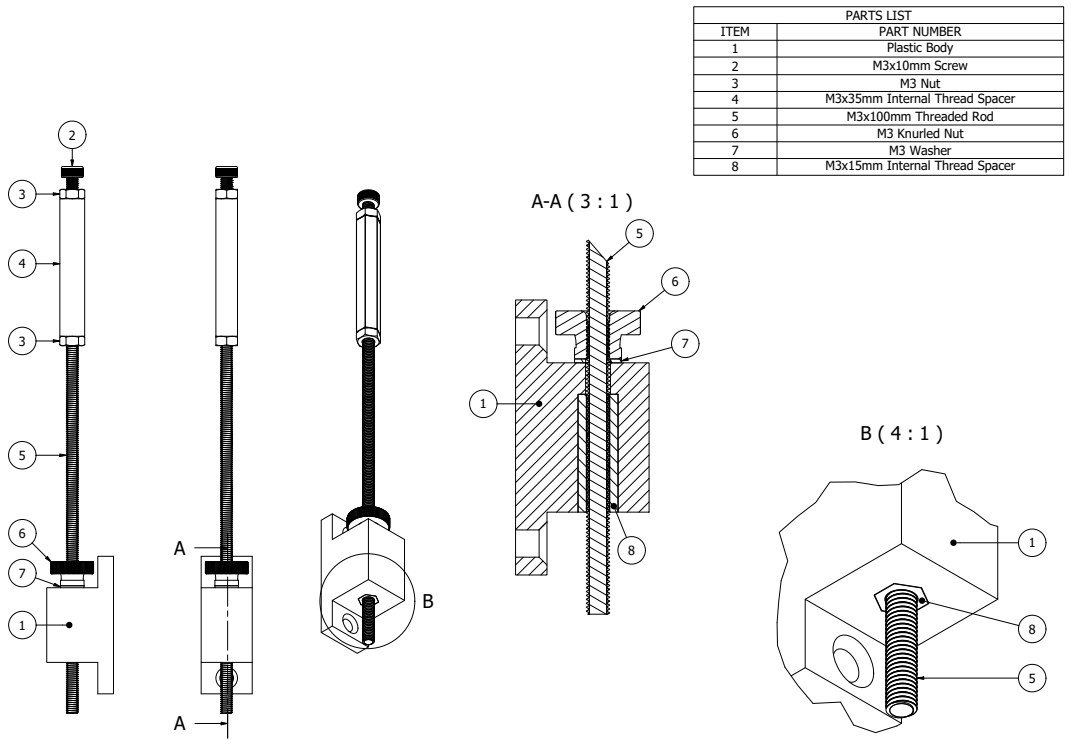
[picture p110: page 16]

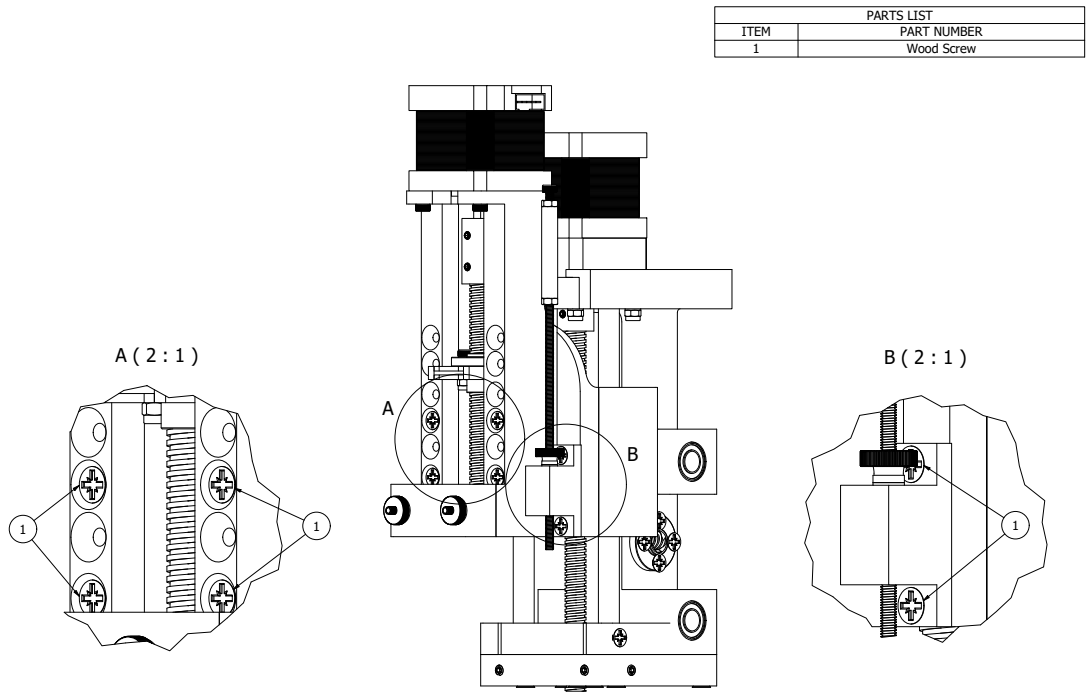
[picture p111: page 17]
PARTS LIST; ITEM; PART NUMBER; Wood Screw
