TactileImages/TactilePrinterOne-P4/Imprimanta 4 A4 Metal/Drawings/Heated Bed Assembly.pdf

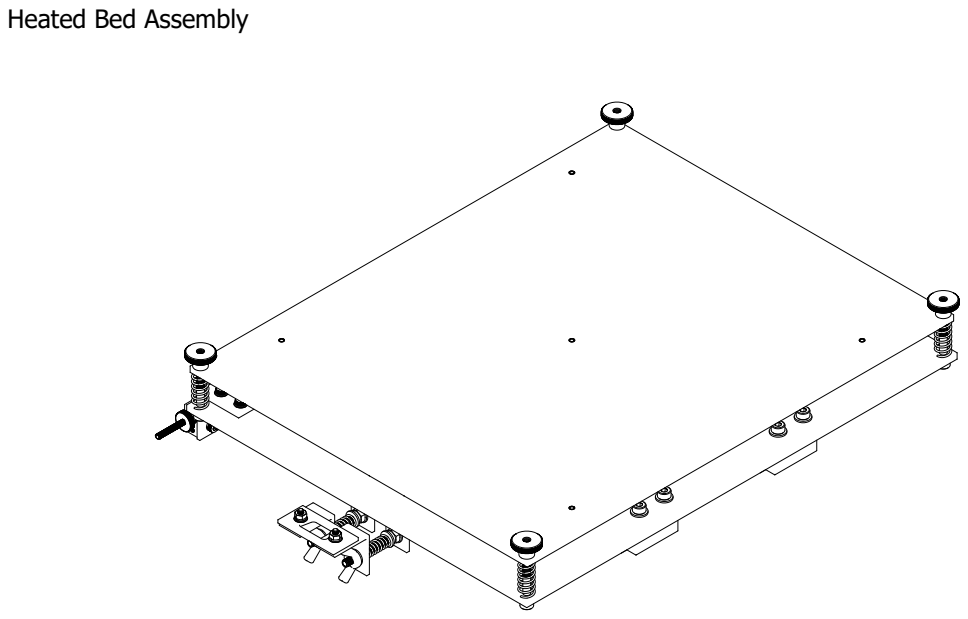
[picture p112: page 1]

Heated Bed Assembly

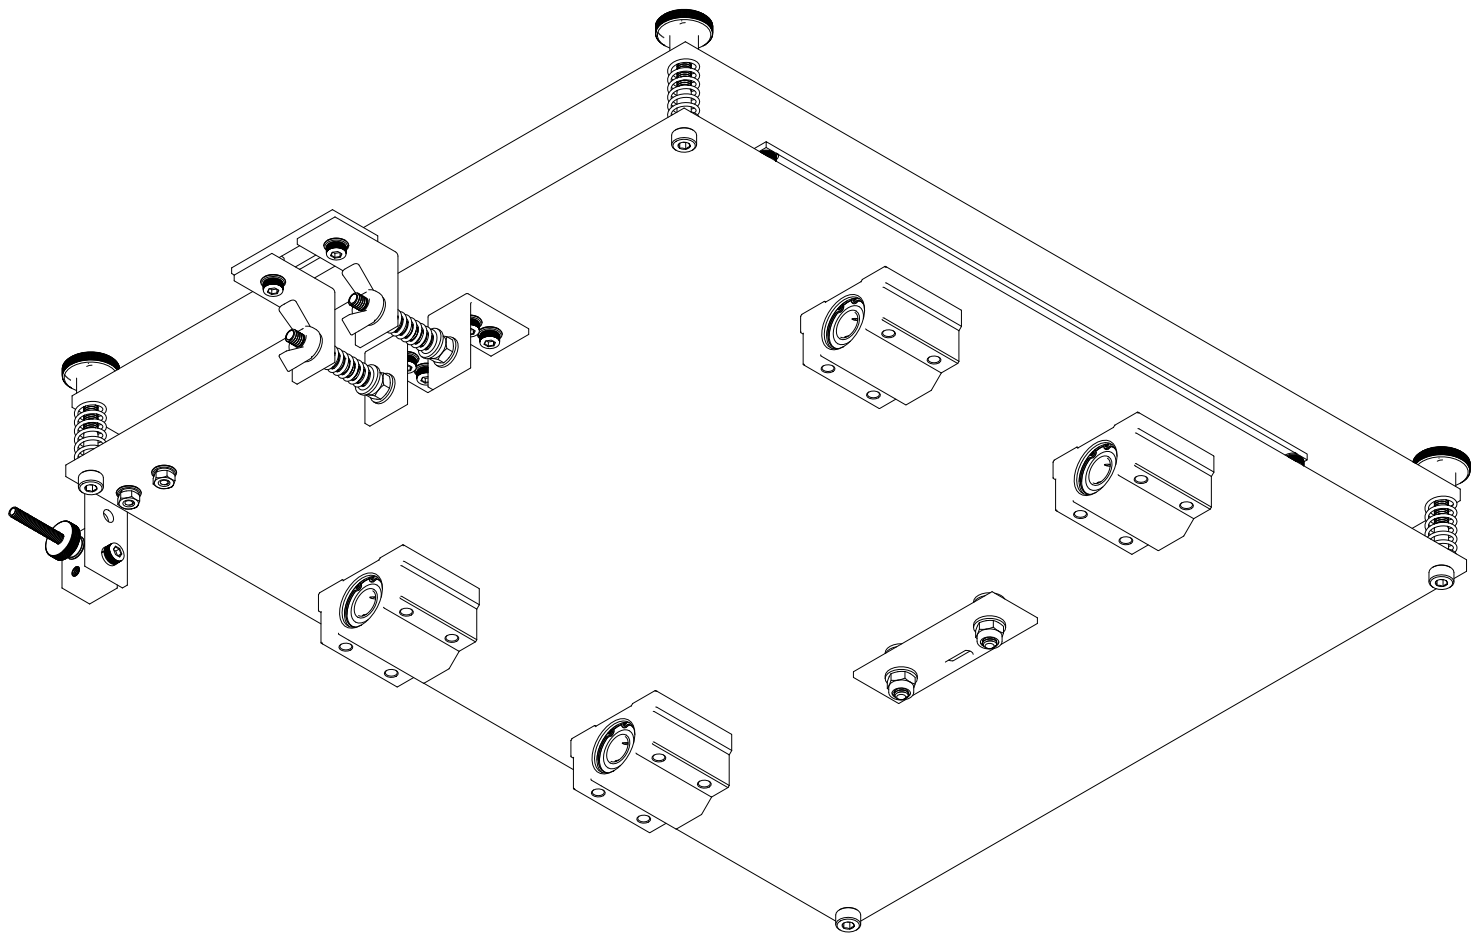
[picture p113: page 2]

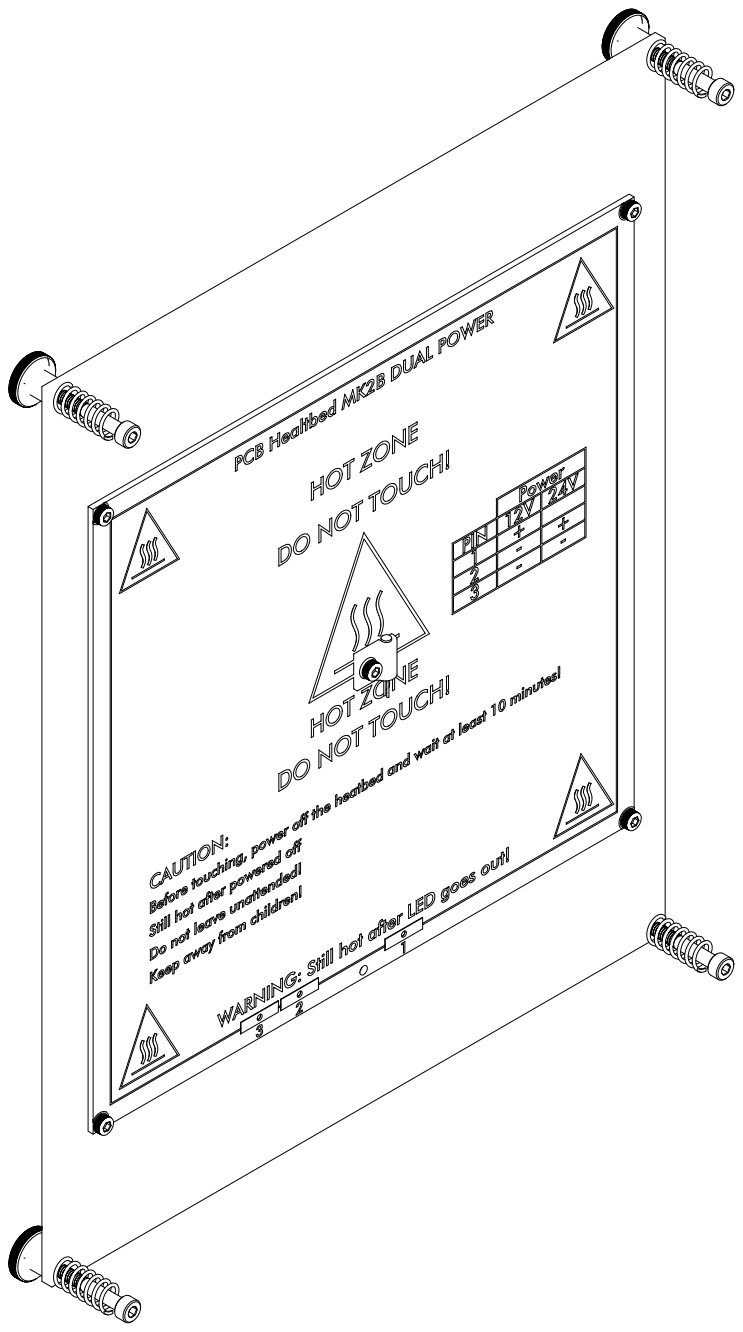
[picture p114: page 3]

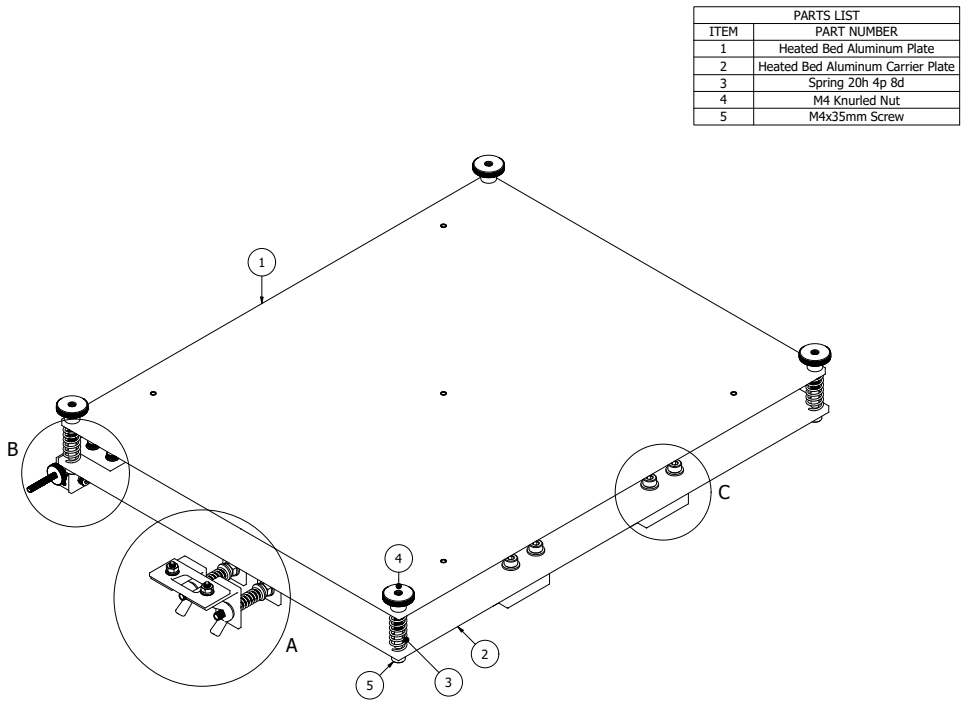
[picture p115: page 4]
PARTS LIST

ITEM | PART NUMBER
1 | Heated Bed Aluminum Plate
2 | Heated Bed Aluminum Carrier Plate
3 | Spring 20h 4p 8d
4 | M4 Knurled Nut
5 | M4x35mm Screw

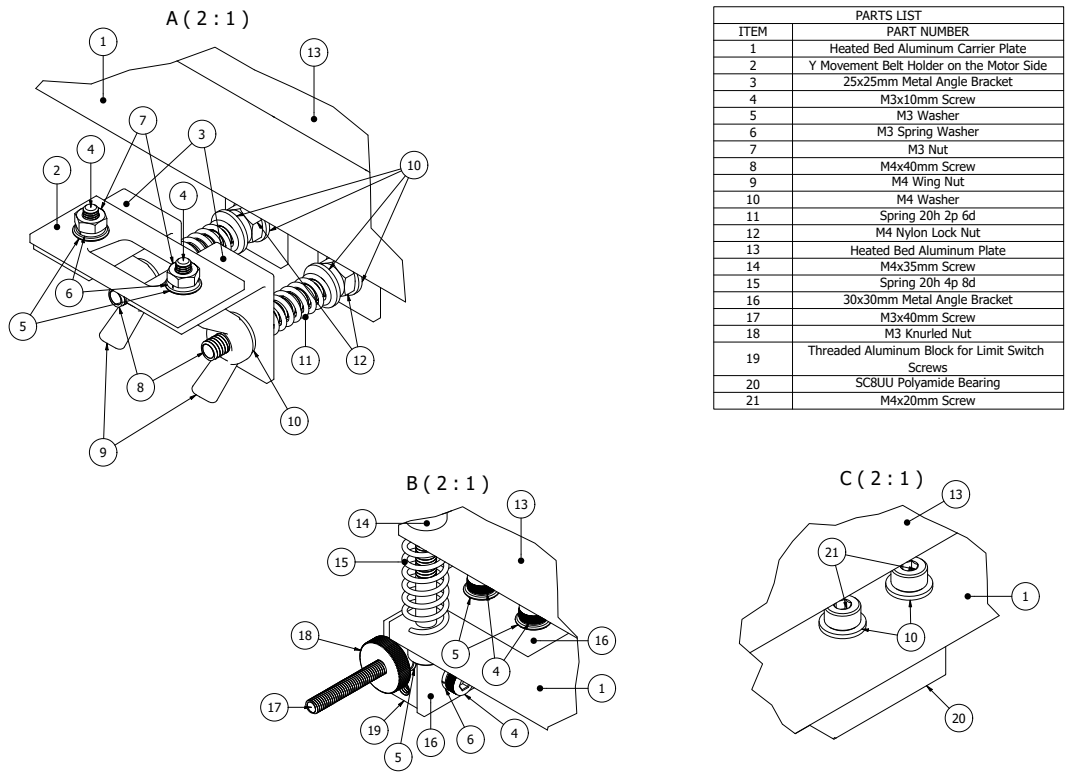
[picture p116: page 5]
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

2 0 | S C 8 U U P oly a m i d e B e a r i n g
2 1 | M 4 x 2 0 m m S c r e w

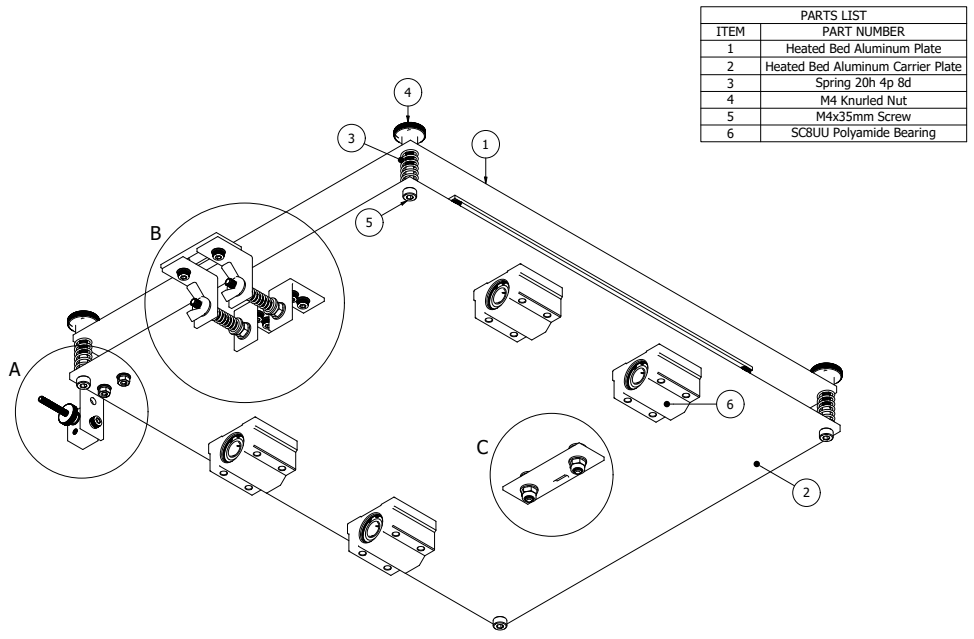
[picture p117: page 6]

H e a t e d B e d Alu m i n u m Pla t e

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

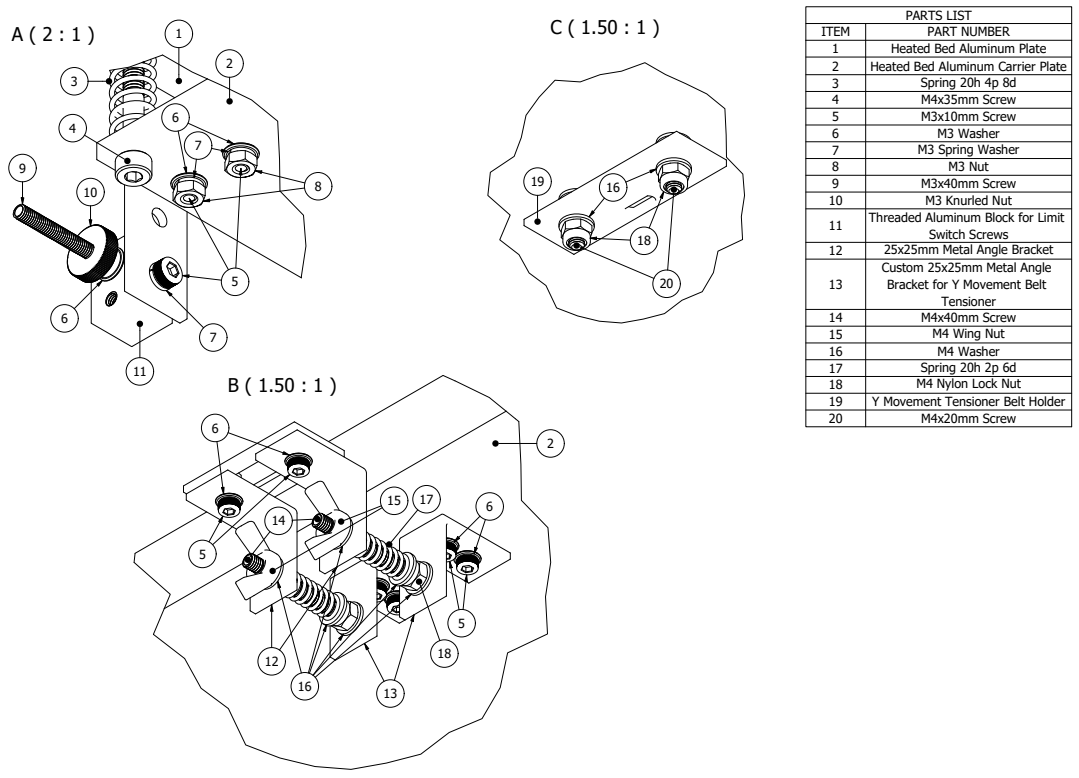
[picture p118: page 7]

H e a t e d B e d Alu m i n u m Pla t e

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

1 4 | M 4 x 4 0 m m S c r e w
1 5 | M 4 W i n g N u t
1 6 | M 4 W a s h e r
1 7 | S p r i n g 2 0 h 2 p 6 d
1 8 | M 4 N ylo n L o c k N u t
1 9 | Y M o v e m e n t T e n s i o n e r B elt H old e r
2 0 | M 4 x 2 0 m m S c r e w

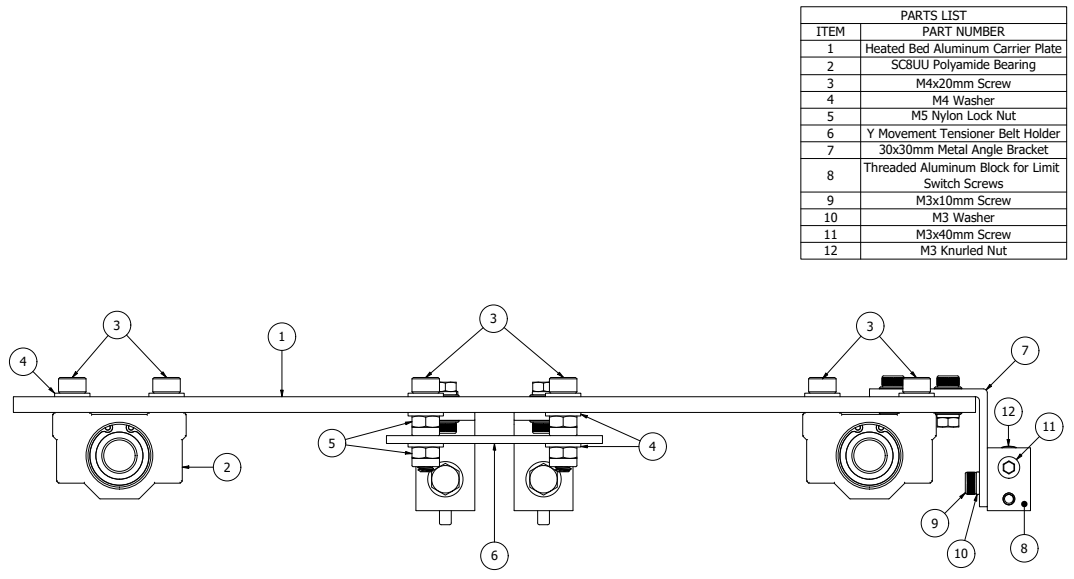
[picture p119: page 8]
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

9 | M 3 x 1 0 m m S c r e w
1 0 | M 3 W a s h e r
1 1 | M 3 x 4 0 m m S c r e w
1 2 | M 3 K n u rle d N u t

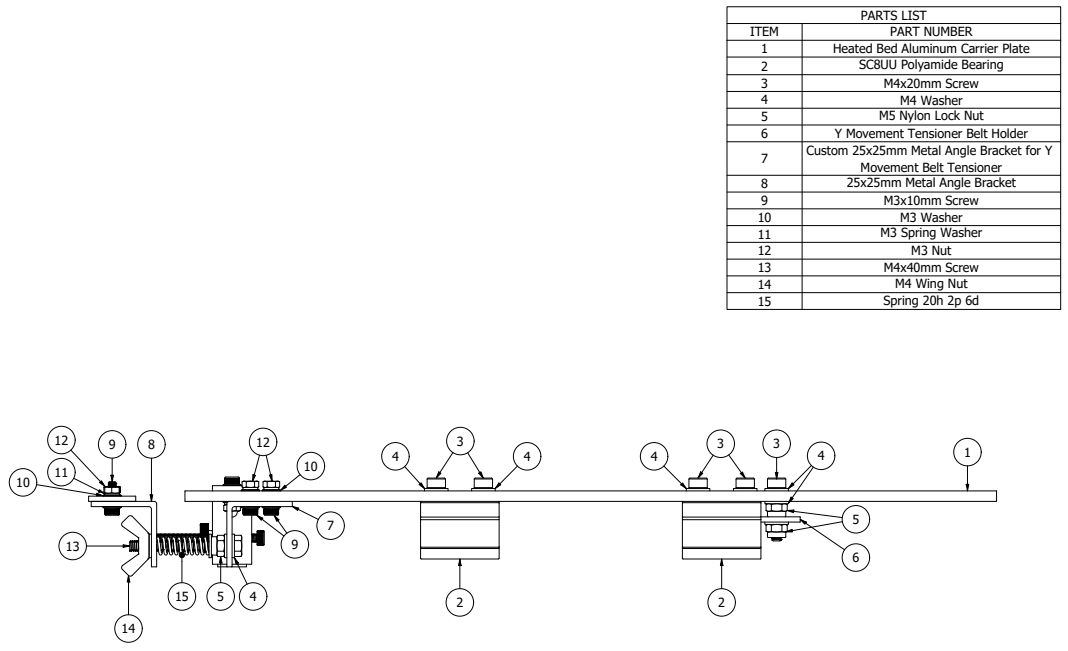
[picture p120: page 9]
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

8 | 2 5 x 2 5 m m M e t al A n gle B r a c k e t
9 | M 3 x 1 0 m m S c r e w
1 0 | M 3 W a s h e r
1 1 | M 3 S p r i n g W a s h e r
1 2 | M 3 N u t
1 3 | M 4 x 4 0 m m S c r e w
1 4 | M 4 W i n g N u t
1 5 | S p r i n g 2 0 h 2 p 6 d

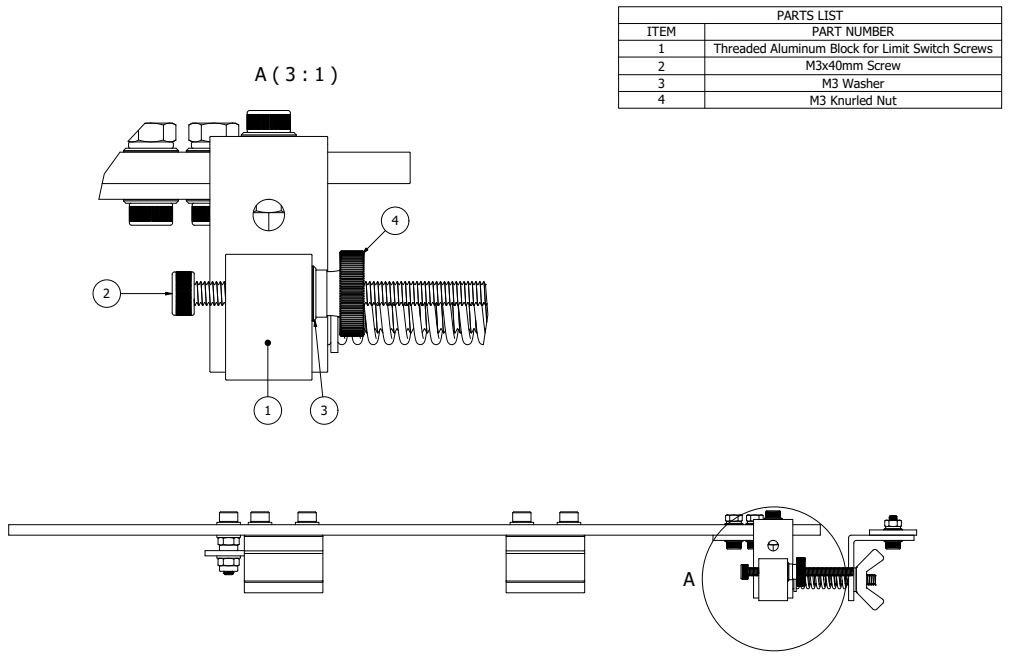
[picture p121: page 10]
PARTS LIST

ITEM | PART NUMBER
1 | Threaded Aluminum Block for Limit Switch Screws
2 | M3x40mm Screw
3 | M3 Washer
4 | M3 Knurled Nut

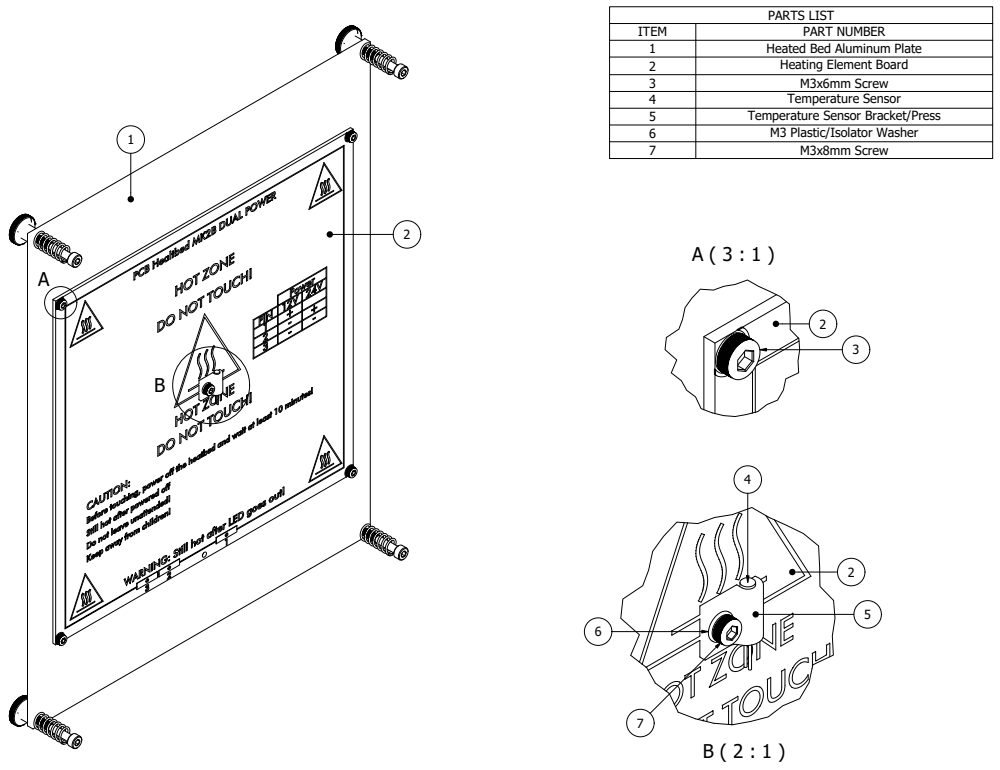
[picture p122: page 11]
PARTS LIST

ITEM | PART NUMBER
1 | Heated Bed Aluminum Plate
2 | Heating Element Board
3 | M3x6mm Screw
4 | Temperature Sensor
5 | Temperature Sensor Bracket/Press
6 | M3 Plastic/Isolator Washer
7 | M3x8mm Screw

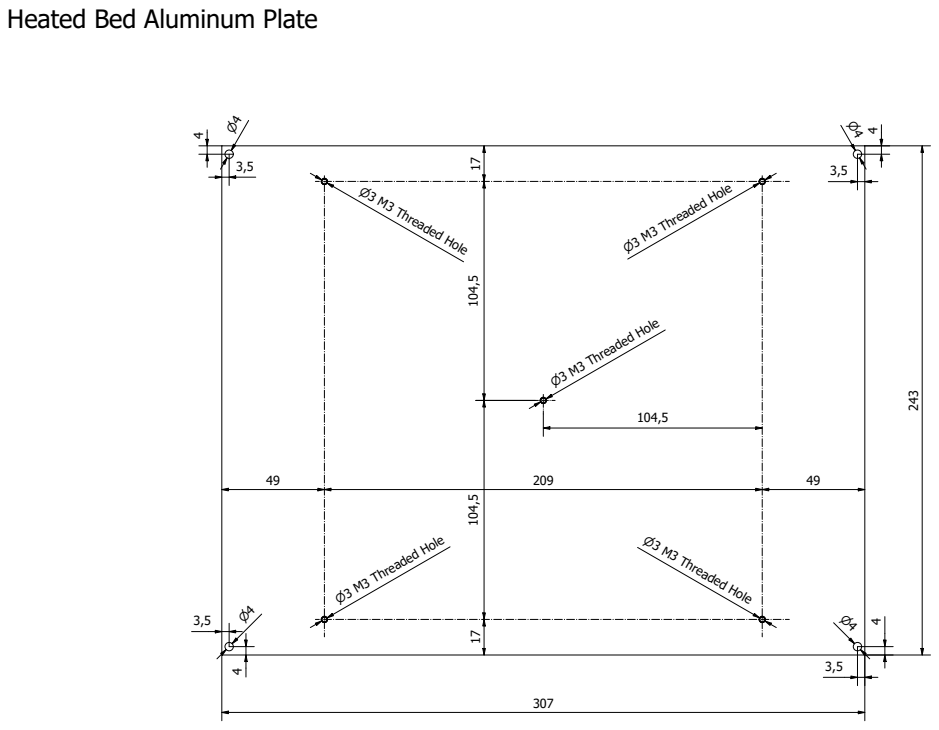
[picture p123: page 12]
⌀3 M3 Threaded Hole

Heated Bed Aluminum Plate

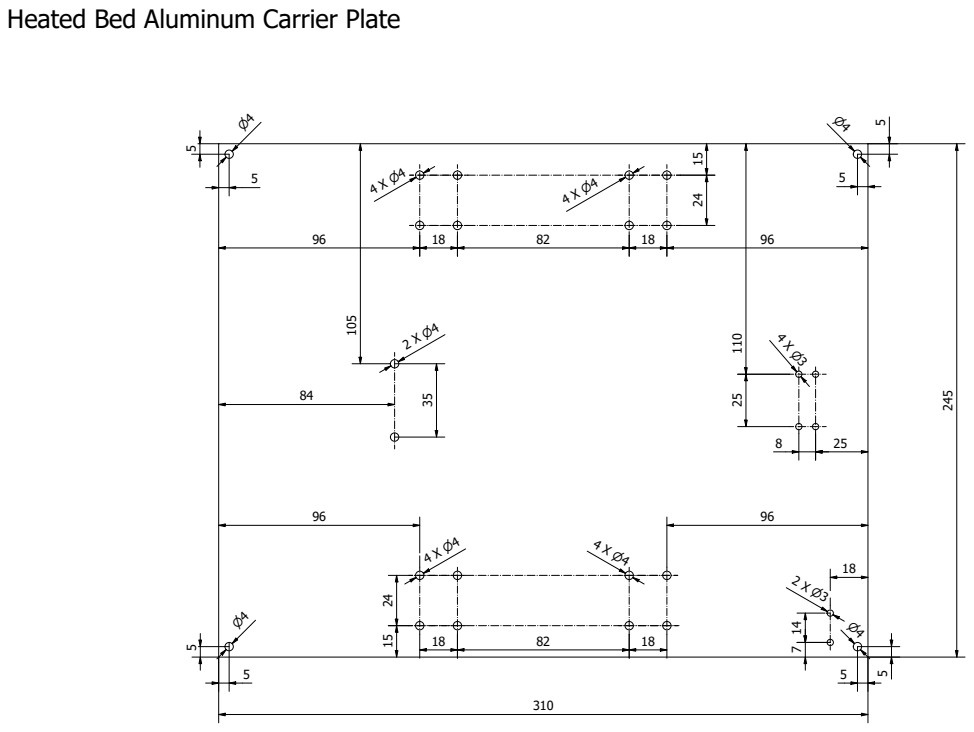
[picture p124: page 13]

Heated Bed Aluminum Carrier Plate

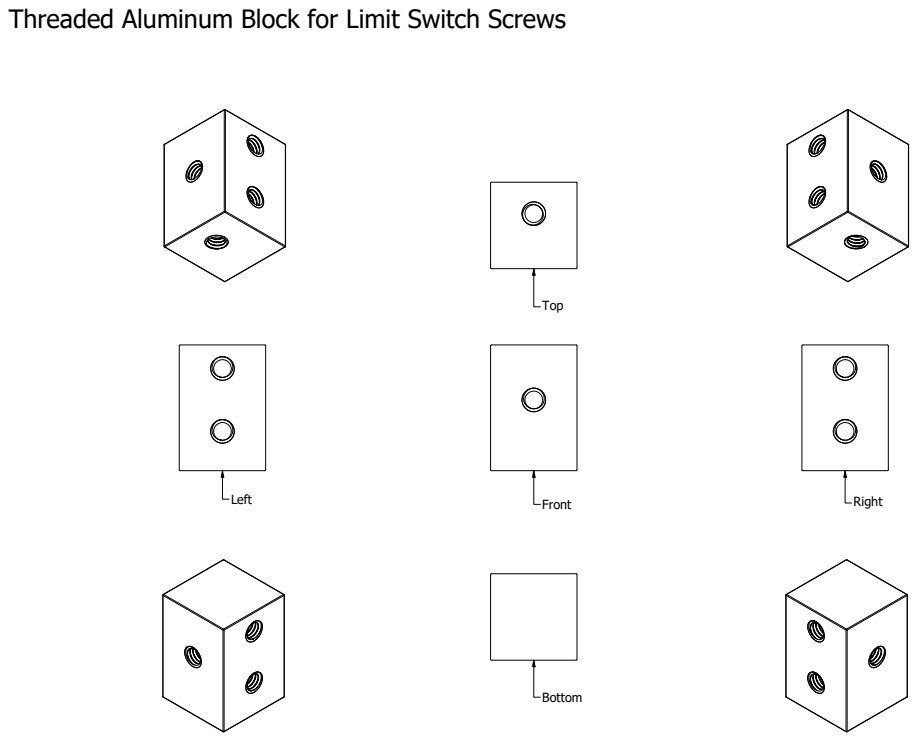
[picture p125: page 14]

Threaded Aluminum Block for Limit Switch Screws

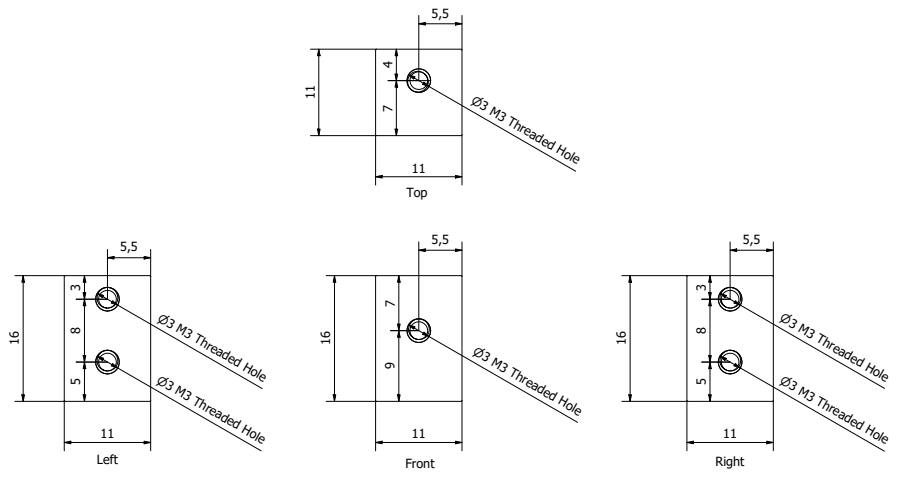
[picture p126: page 15]
M3 Threaded

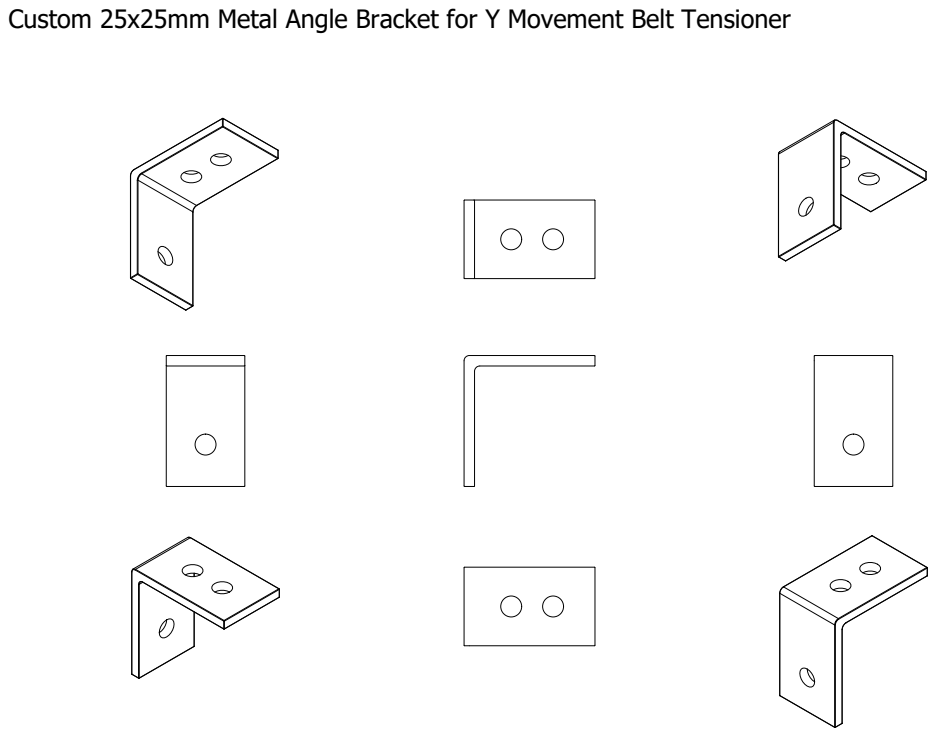
[picture p127: page 16]

Custom 25x25mm Metal Angle Bracket for Y Movement Belt Tensioner

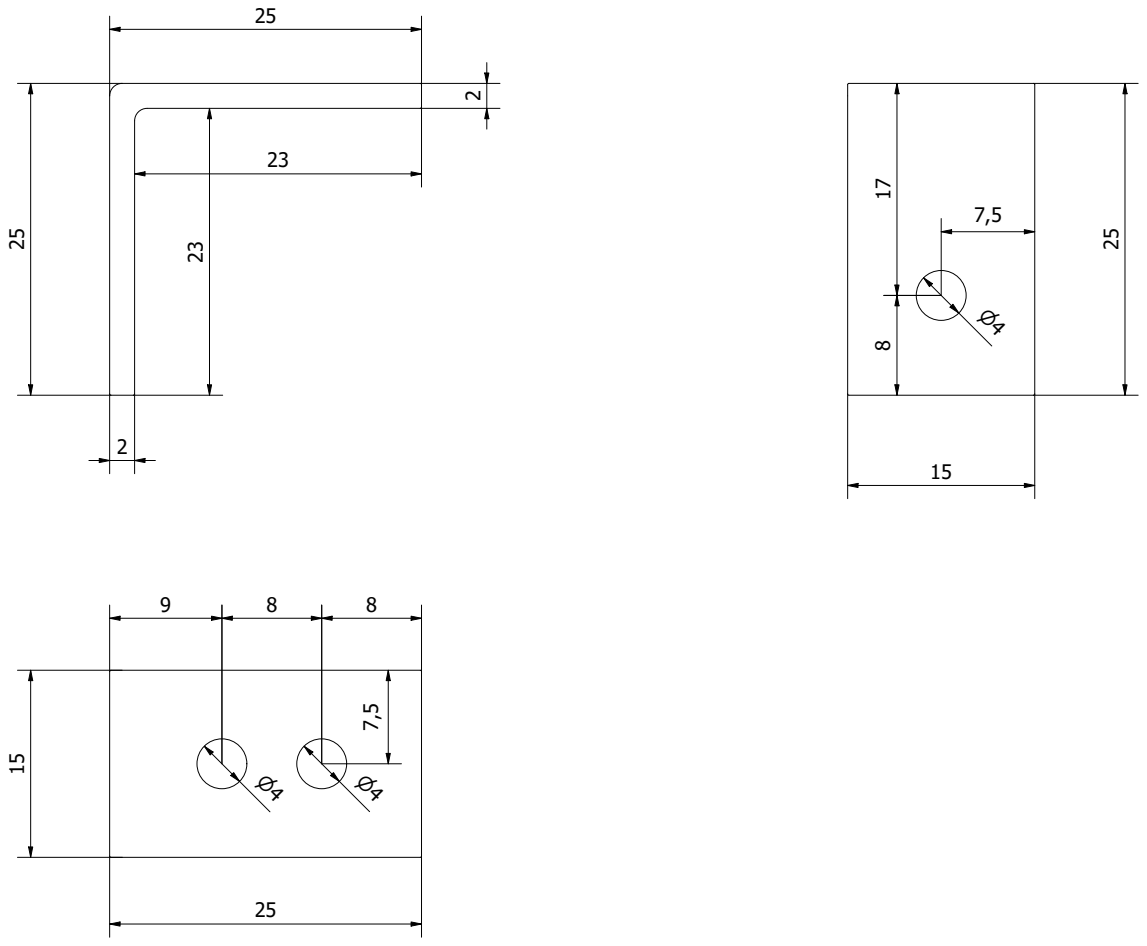
[picture p128: page 17]
