TactileImages/TactilePrinterOne-P4/Imprimanta 3 A4 Lemn Platf Fixa/Drawings/Heated Bed Assembly.pdf

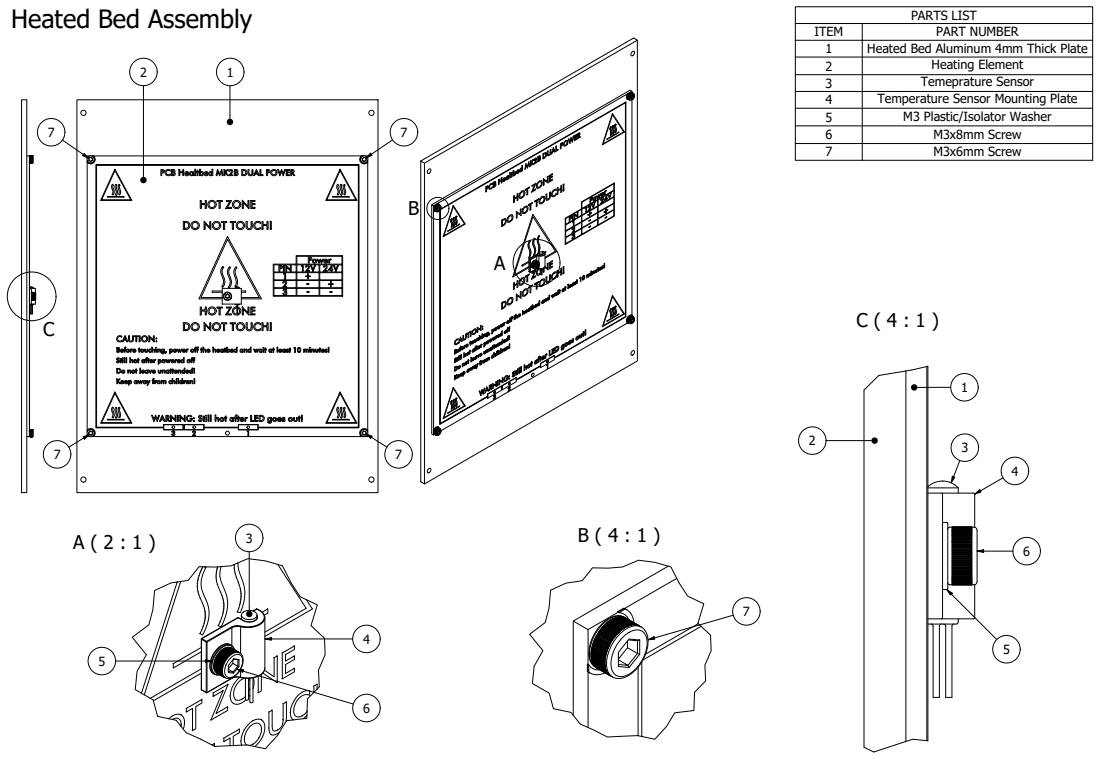
[picture p129: page 1]
PARTS LIST; ITEM; PART NUMBER; Heated Bed Aluminum 4mm Thick Plate; Heating Element; Temeprature Sensor; Temperature Sensor Mounting Plate; M3 Plastic/Isolator Washer; M3x8mm Screw; M3x6mm Screw

Heated Bed Assembly
