TactileImages/TactilePrinterOne-P4/Imprimanta 3 A4 Lemn Platf Fixa/Drawings/Power Connector and Switch Assembly.pdf

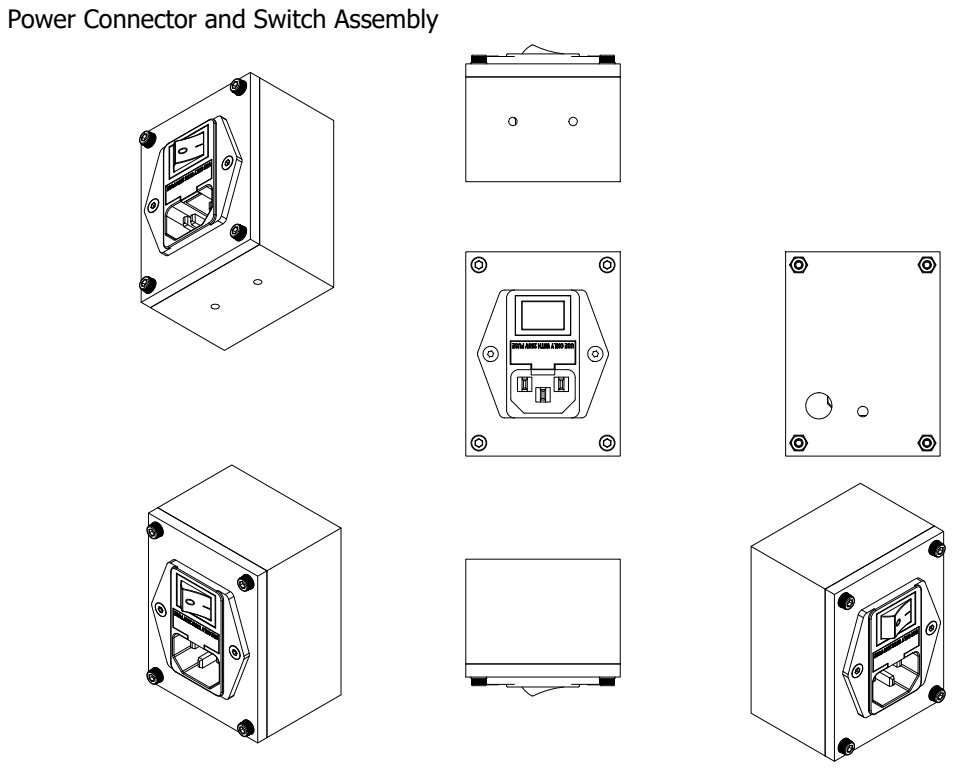
[picture p130: page 1]

Power Connector and Switch Assembly

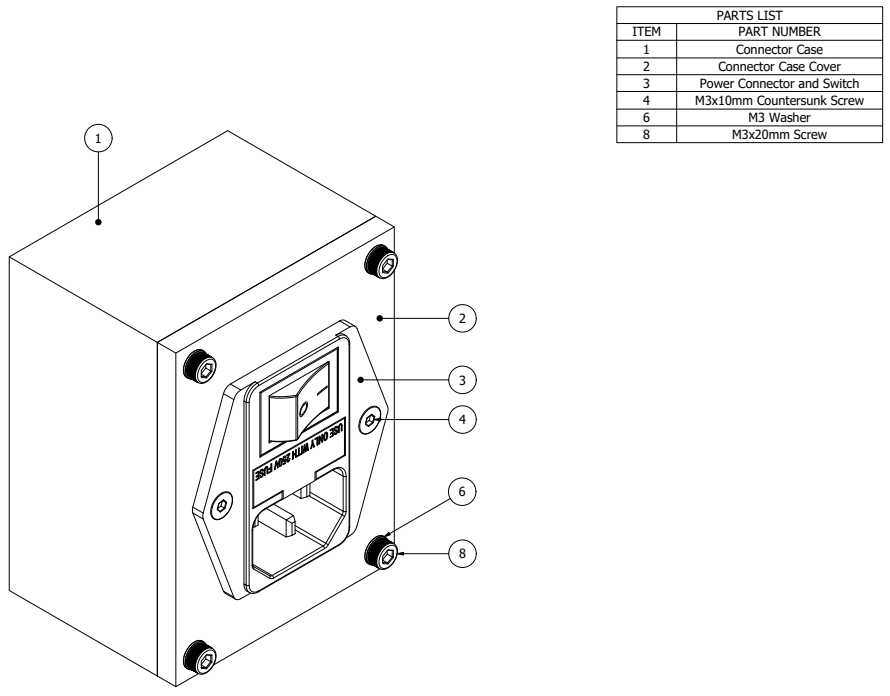
[picture p131: page 2]
PARTS LIST

ITEM | PART NUMBER
1 | Connector Case
2 | Connector Case Cover
3 | Power Connector and Switch
4 | M3x10mm Countersunk Screw
6 | M3 Washer
8 | M3x20mm Screw

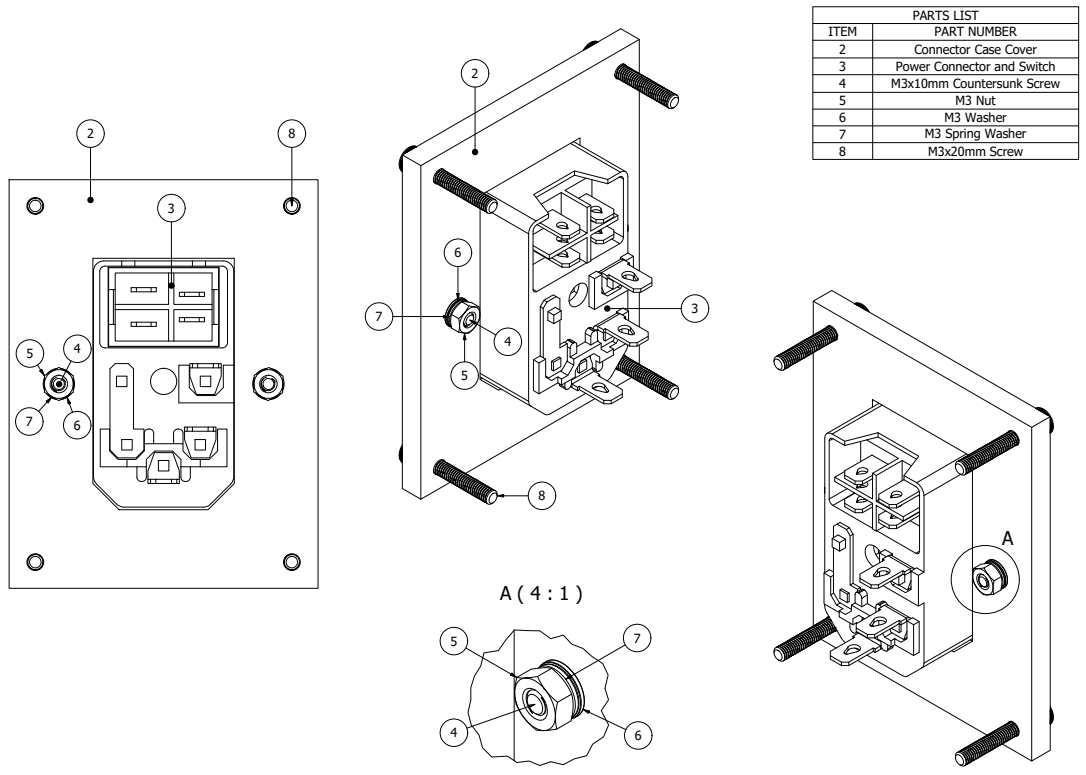
[picture p132: page 3]
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

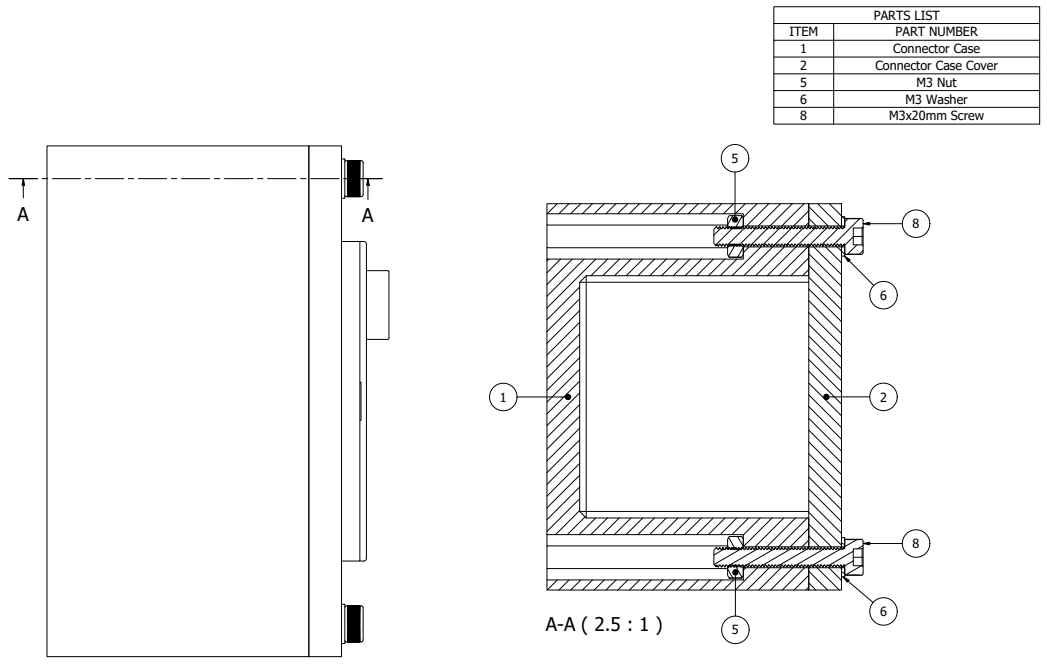
[picture p133: page 4]
PARTS LIST

ITEM | PART NUMBER
1 | Connector Case
2 | Connector Case Cover
5 | M3 Nut
6 | M3 Washer
8 | M3x20mm Screw
