TactileImages/TactilePrinterOne-P4/Imprimanta 3 A4 Lemn Platf Fixa/Drawings/X Limit Switch Assembly.pdf

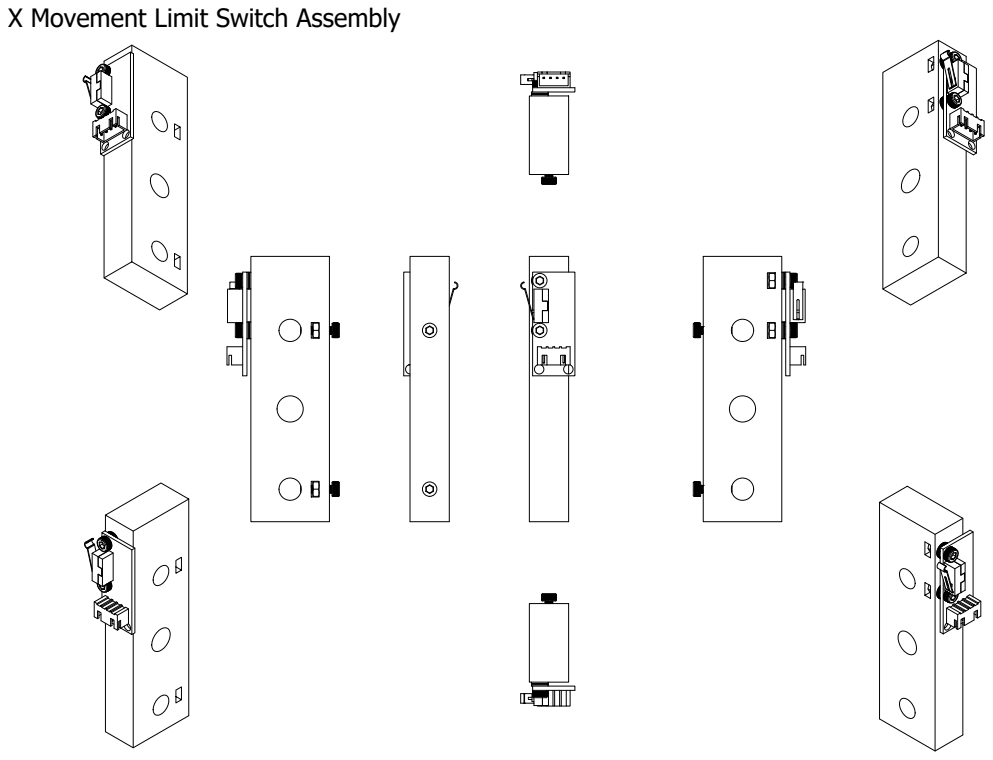
[picture p134: page 1]

X Movement Limit Switch Assembly

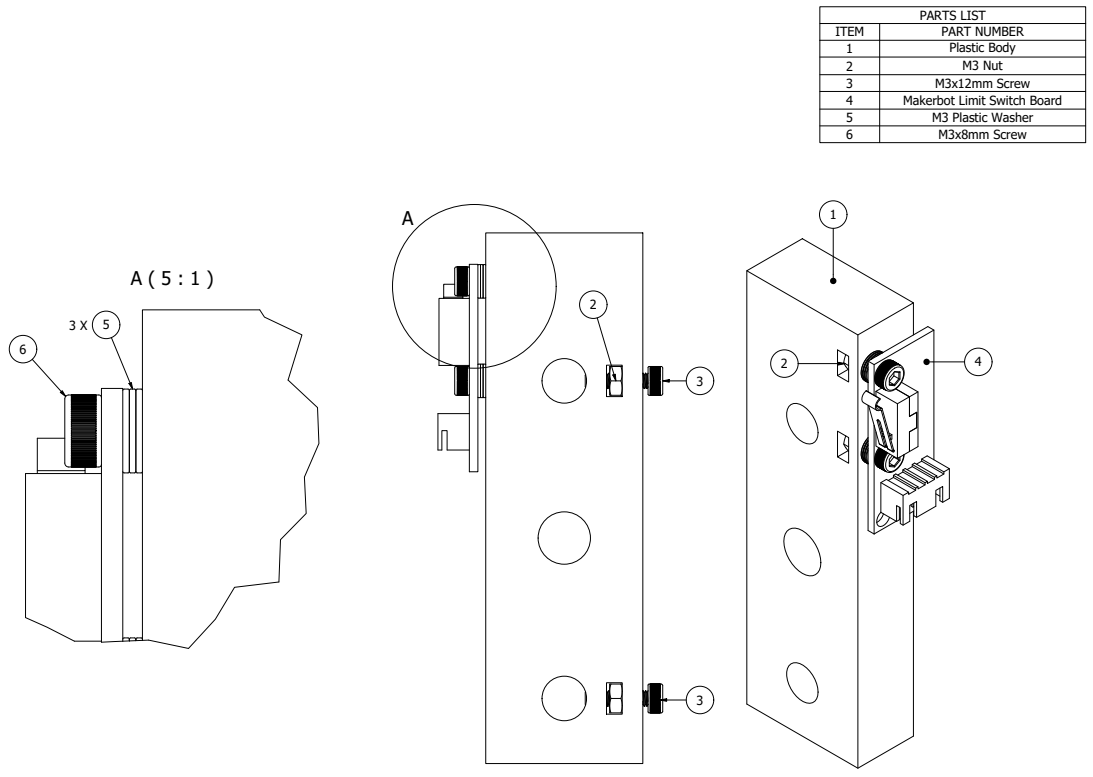
[picture p135: page 2]
PARTS LIST

ITEM | PART NUMBER
1 | Plastic Body
2 | M3 Nut
3 | M3x12mm Screw
4 | Makerbot Limit Switch Board
5 | M3 Plastic Washer
6 | M3x8mm Screw
