TactileImages/TactilePrinterOne-P4/Imprimanta 3 A4 Lemn Platf Fixa/Drawings/X Movement Bearing Assembly.pdf

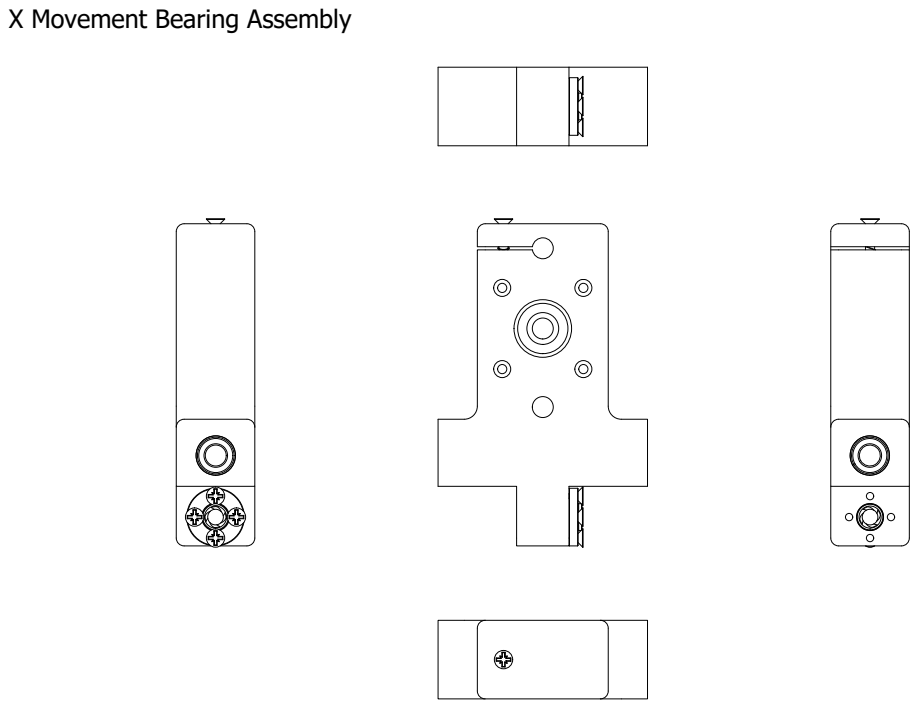
[picture p136: page 1]

X Movement Bearing Assembly

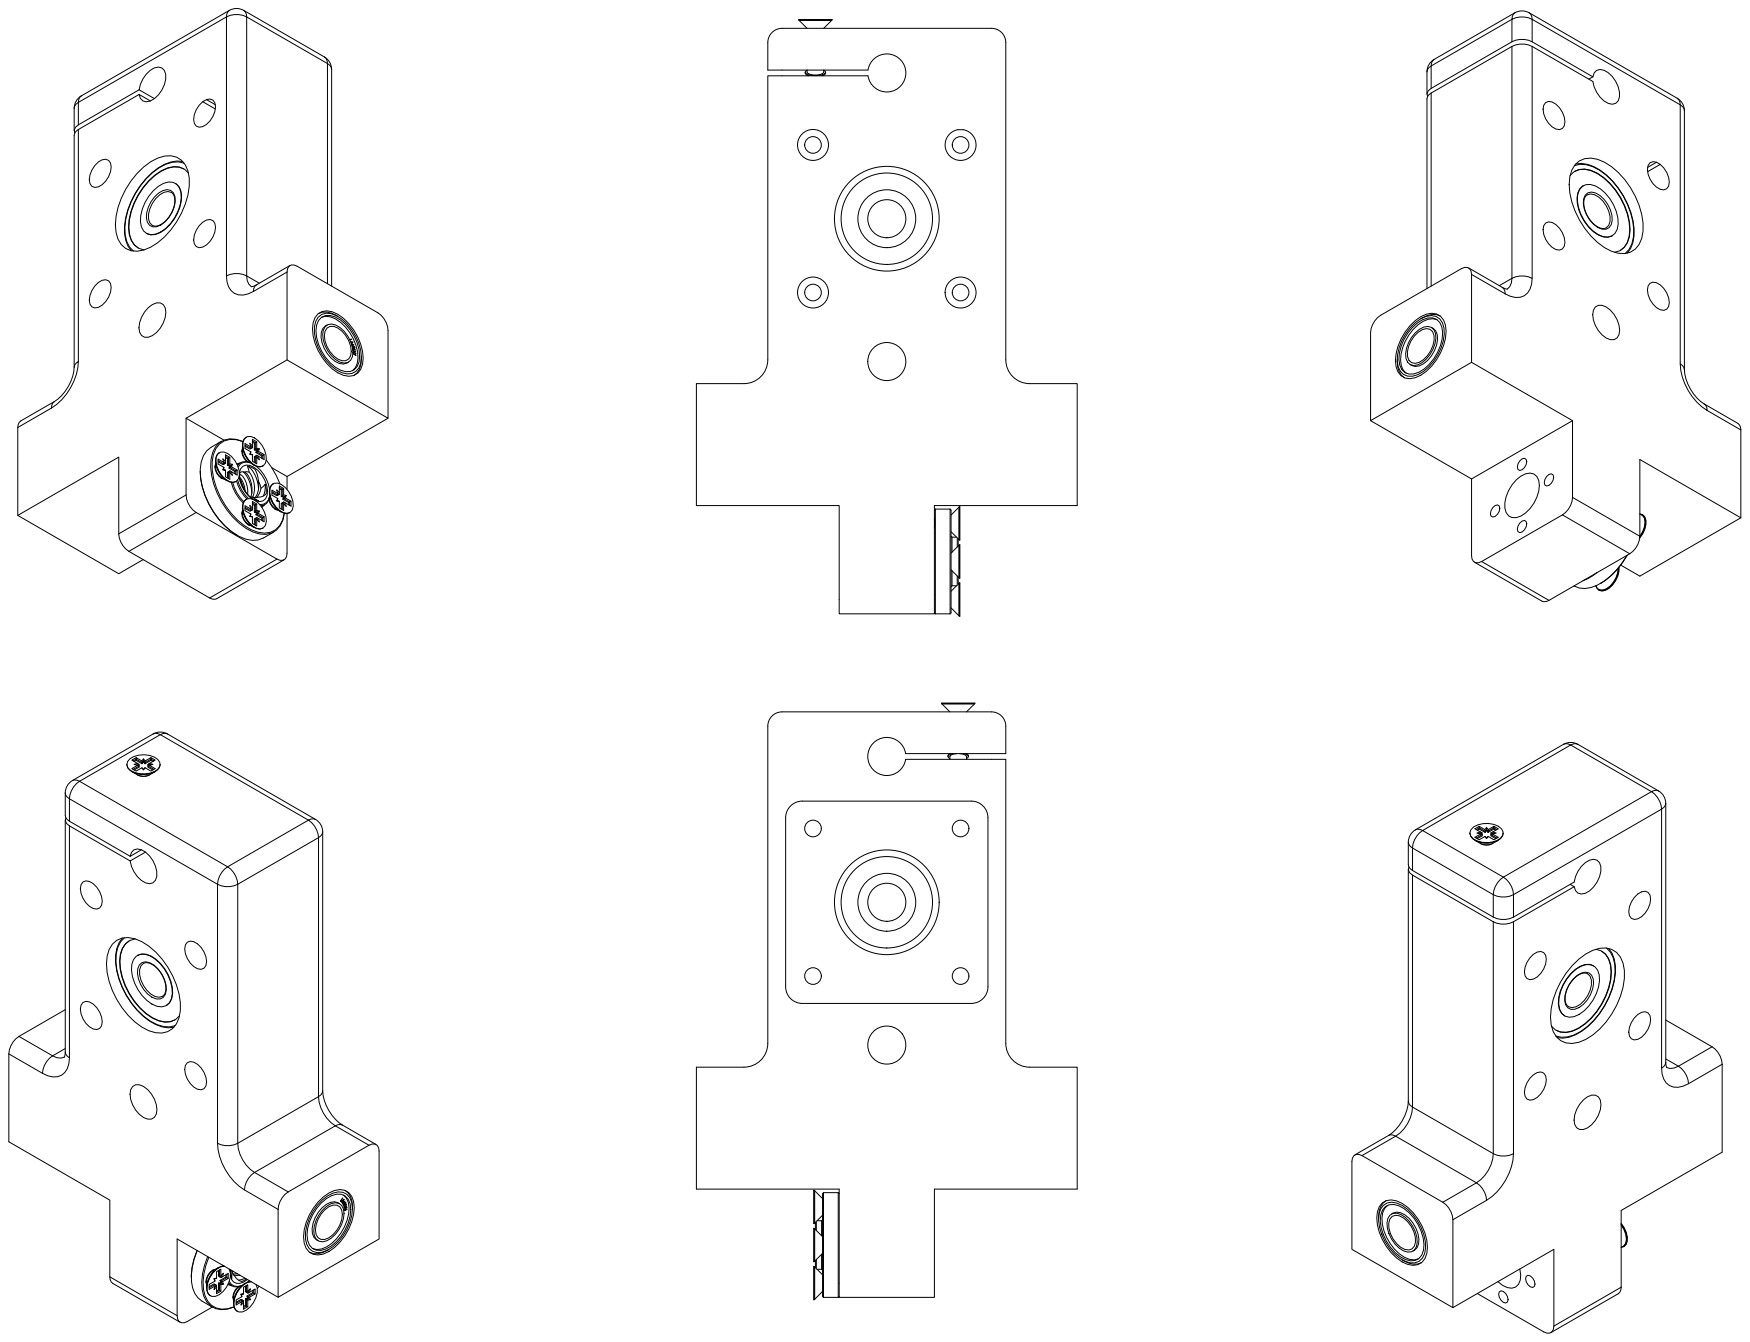
[picture p137: page 2]

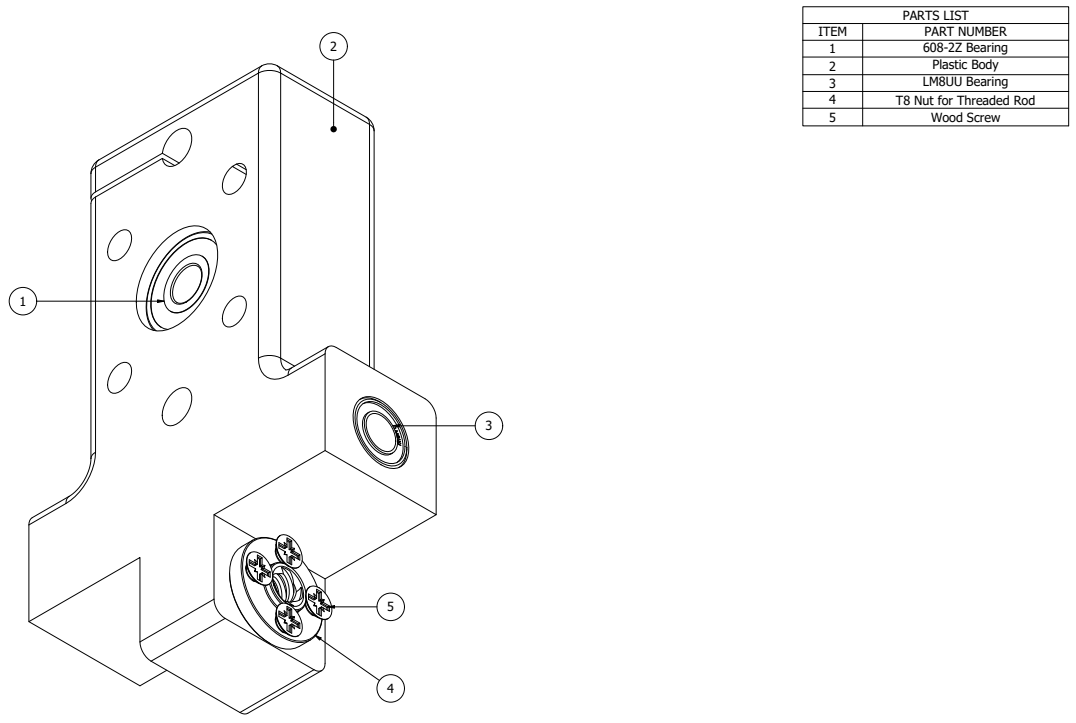
[picture p138: page 3]
PARTS LIST

ITEM | PART NUMBER
1 | 608-2Z Bearing
2 | Plastic Body
3 | LM8UU Bearing
4 | T8 Nut for Threaded Rod
5 | Wood Screw

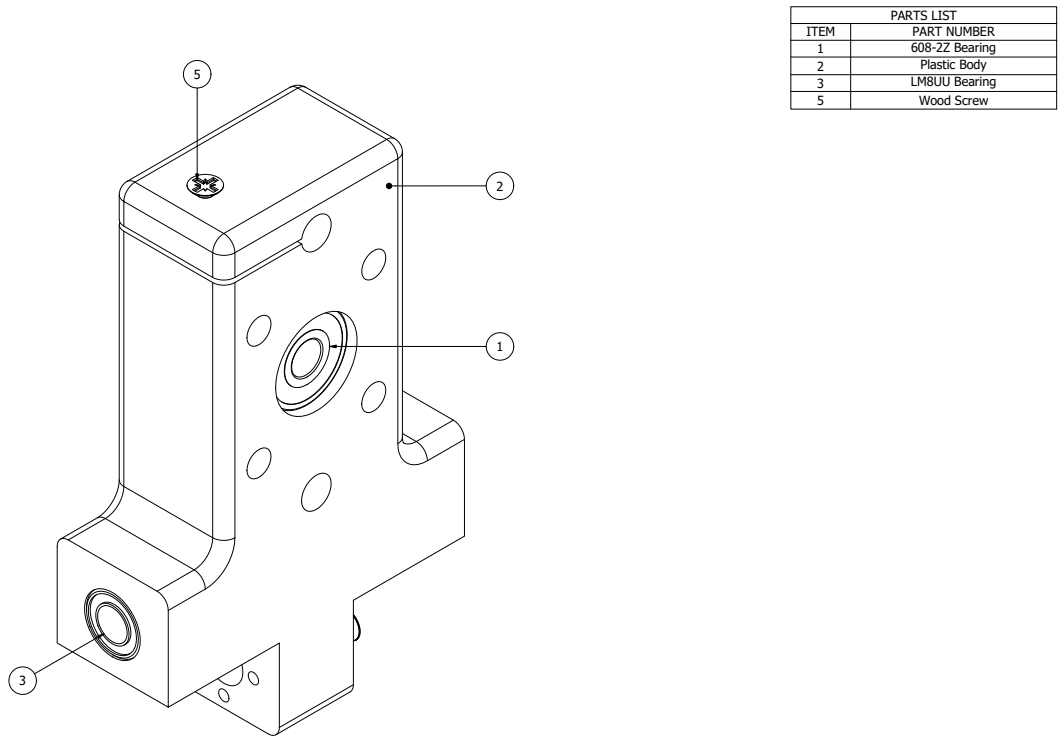
[picture p139: page 4]
PARTS LIST

ITEM | PART NUMBER
1 | 608-2Z Bearing
2 | Plastic Body
3 | LM8UU Bearing
5 | Wood Screw
