TactileImages/TactilePrinterOne-P4/Imprimanta 3 A4 Lemn Platf Fixa/Drawings/X Movement Motor Assembly.pdf

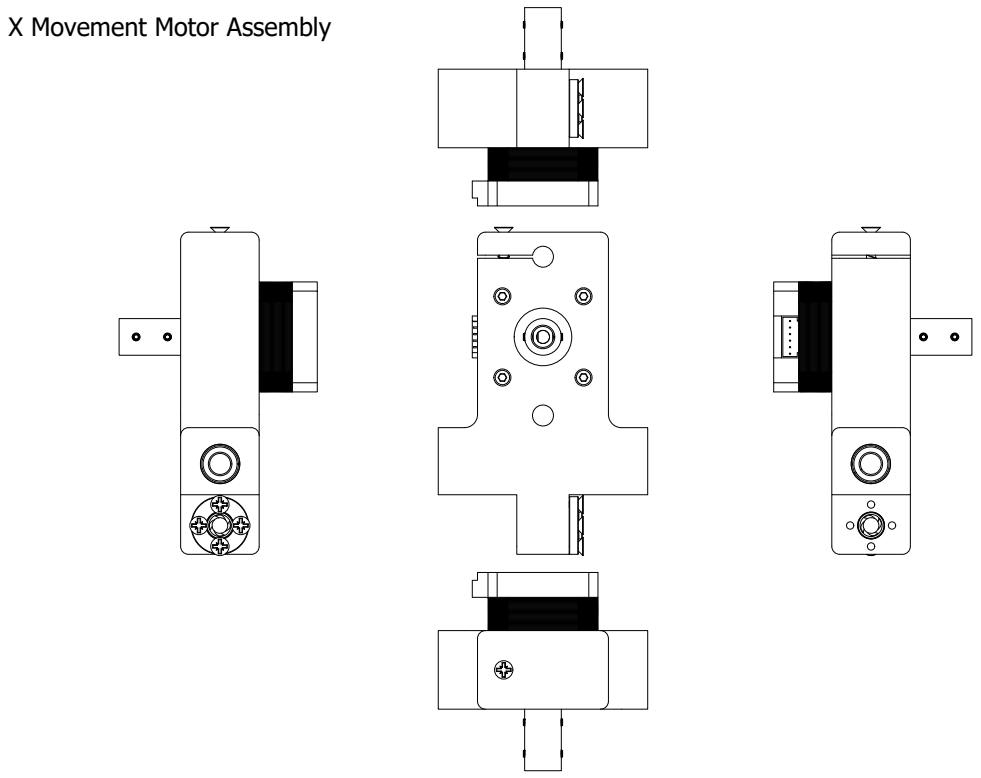
[picture p140: page 1]

X Movement Motor Assembly

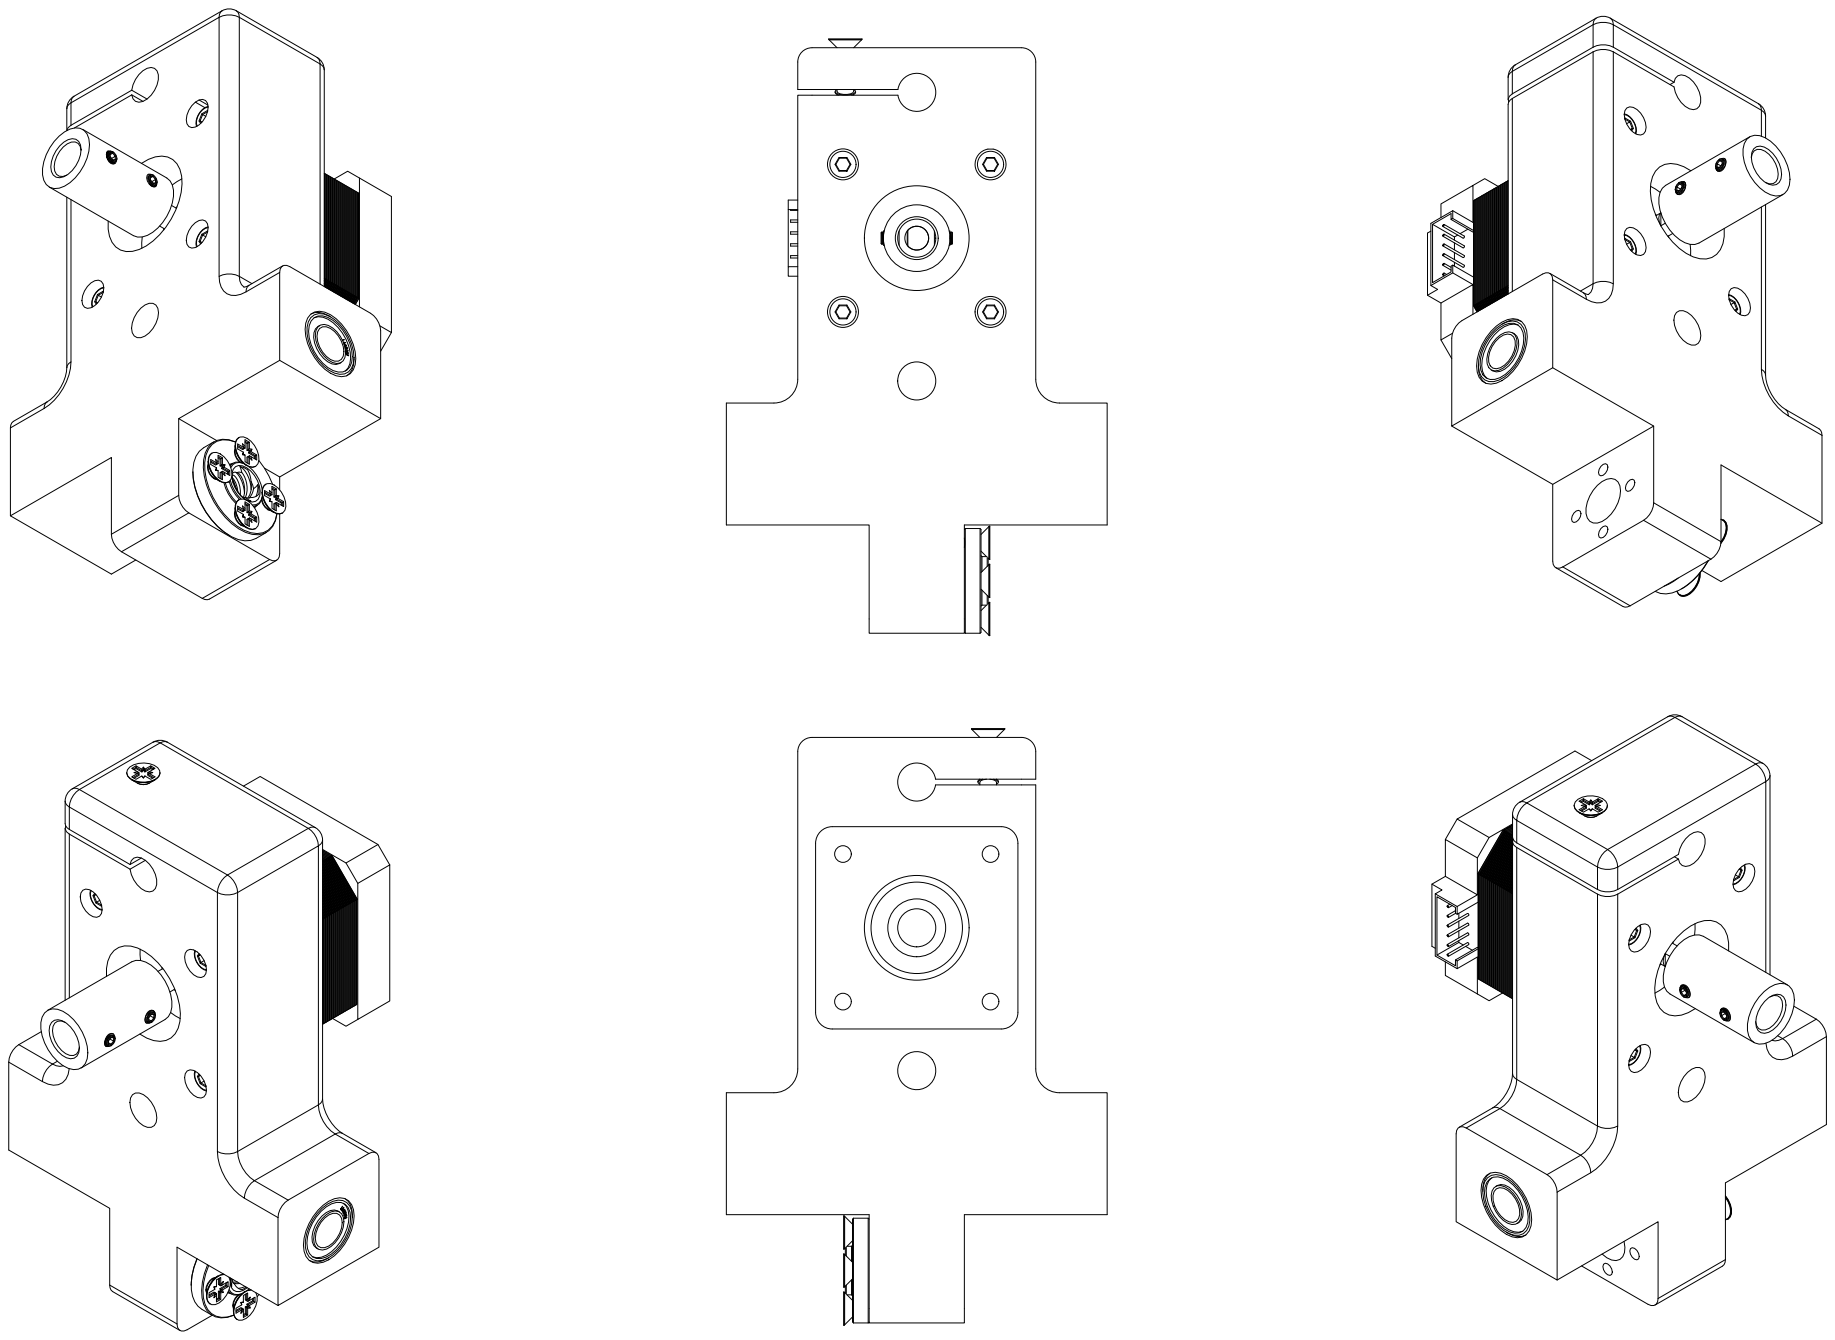
[picture p141: page 2]

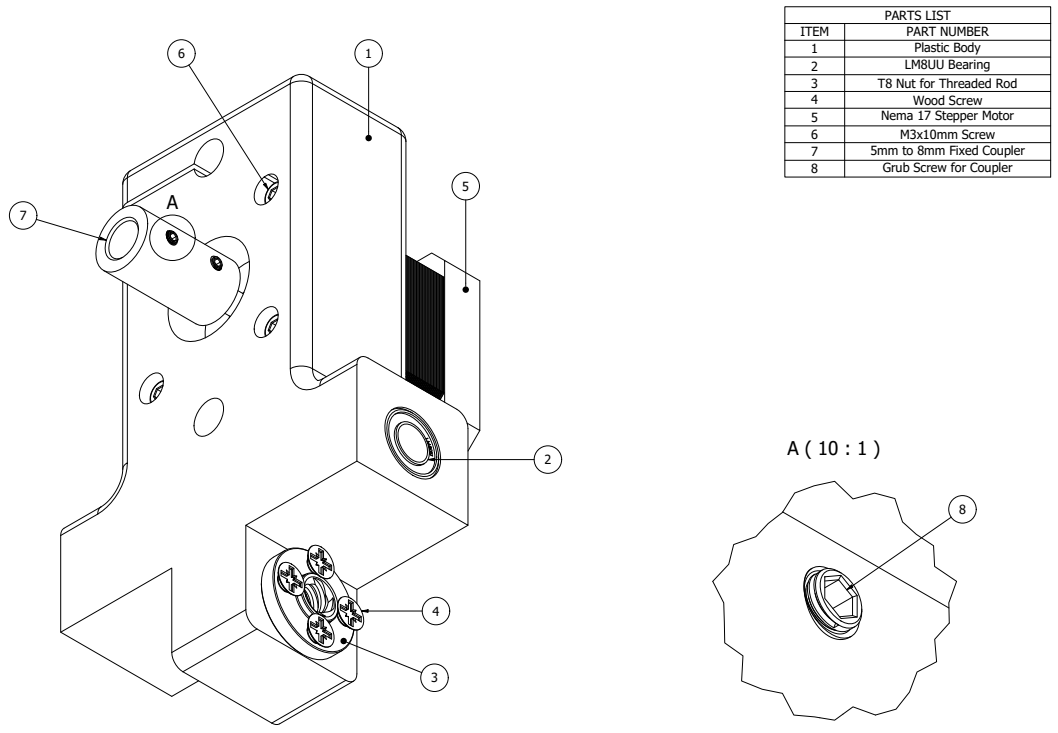
[picture p142: page 3]
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

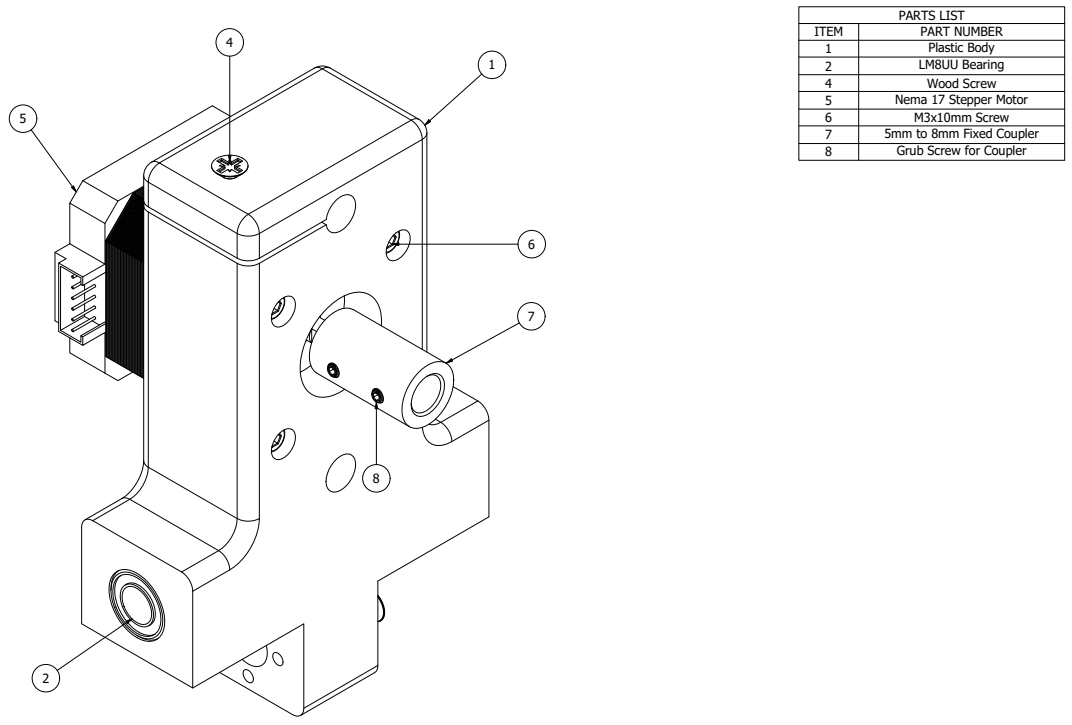
[picture p143: page 4]
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
