TactileImages/TactilePrinterOne-P4/Imprimanta 3 A4 Lemn Platf Fixa/Drawings/Y Limit Switch Assembly.pdf

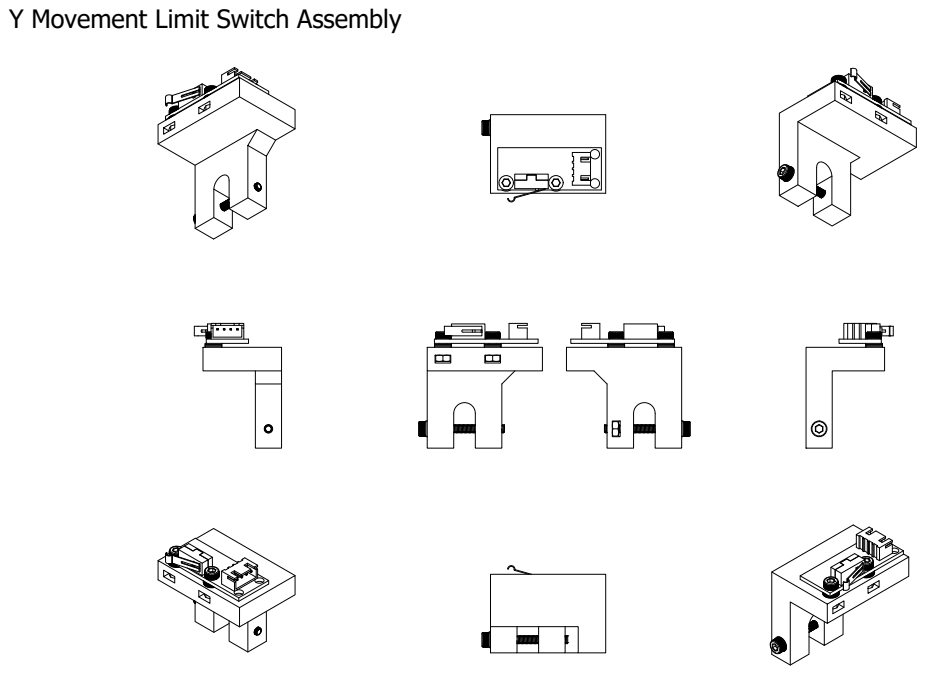
[picture p144: page 1]

Y Movement Limit Switch Assembly

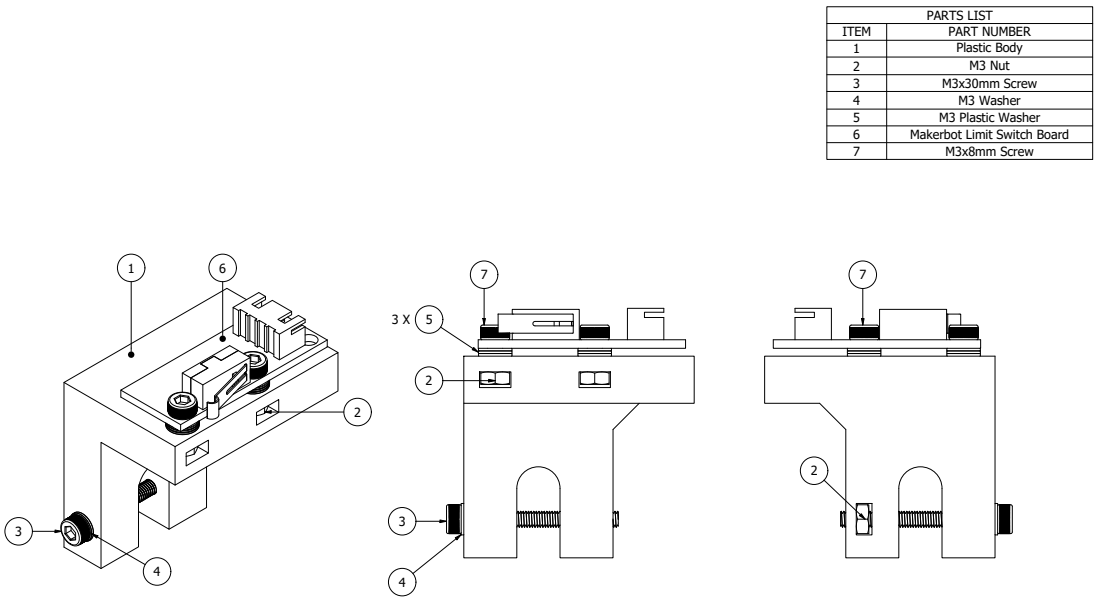
[picture p145: page 2]
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
