TactileImages/TactilePrinterOne-P4/Imprimanta 3 A4 Lemn Platf Fixa/Drawings/Y Movement Bearing Assembly.pdf

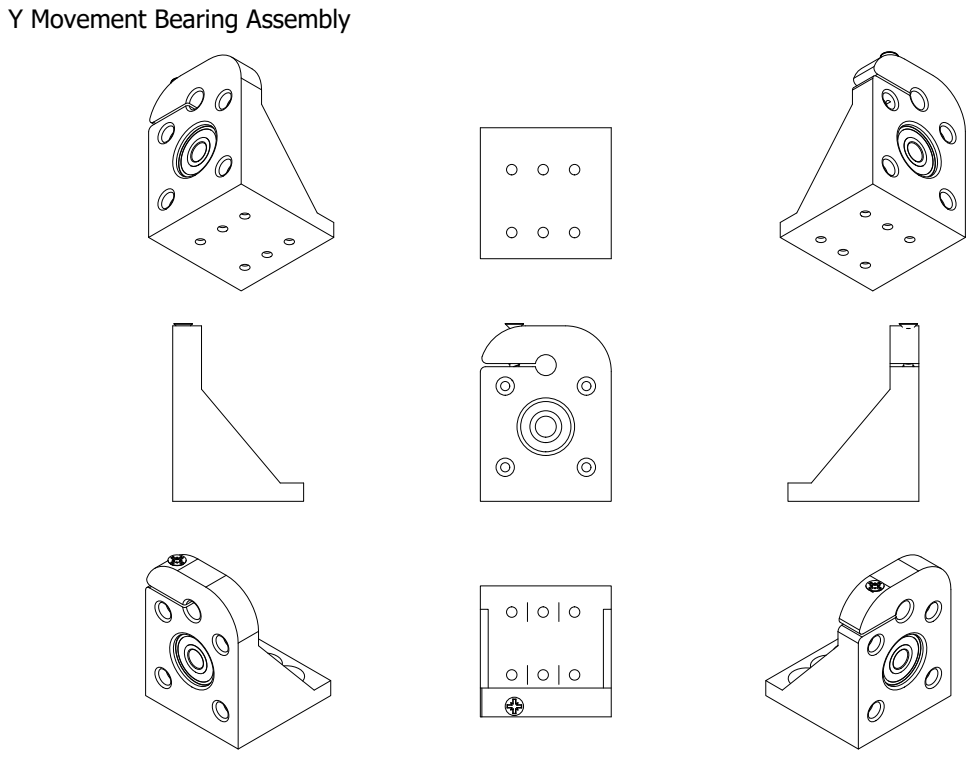
[picture p146: page 1]

Y Movement Bearing Assembly

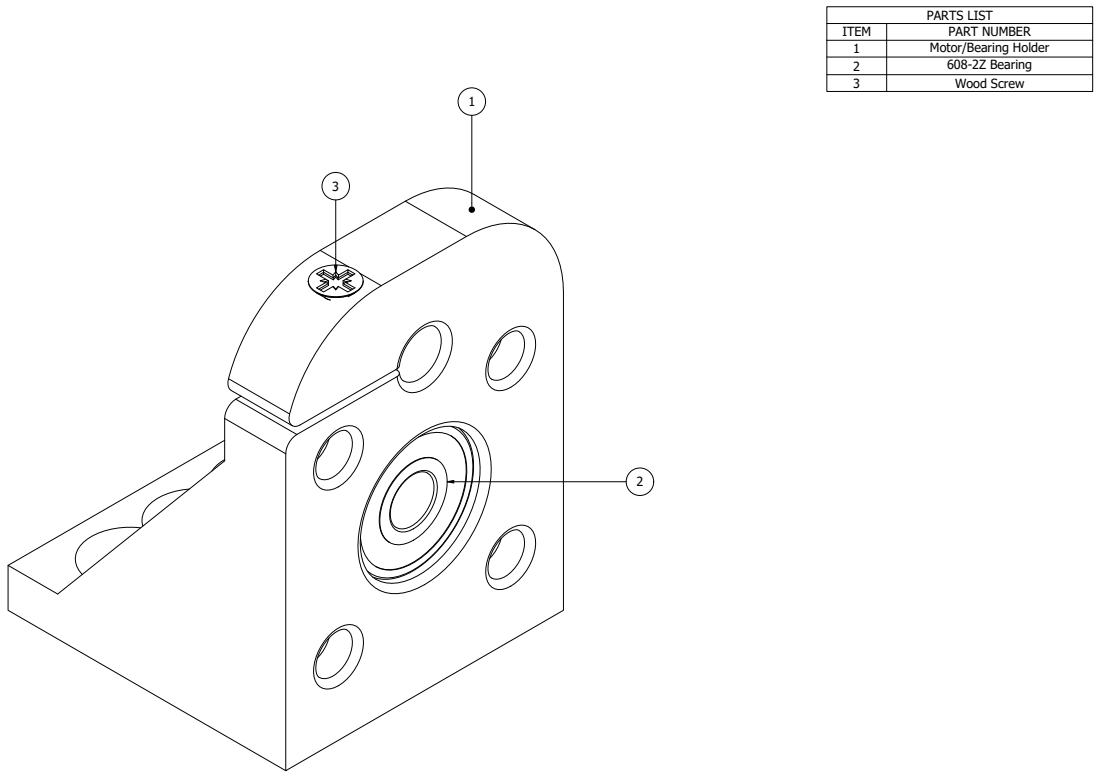
[picture p147: page 2]
PARTS LIST

ITEM | PART NUMBER
1 | Motor/Bearing Holder
2 | 608-2Z Bearing
3 | Wood Screw
