TactileImages/TactilePrinterOne-P4/Imprimanta 3 A4 Lemn Platf Fixa/Drawings/Y Movement Motor Assembly.pdf

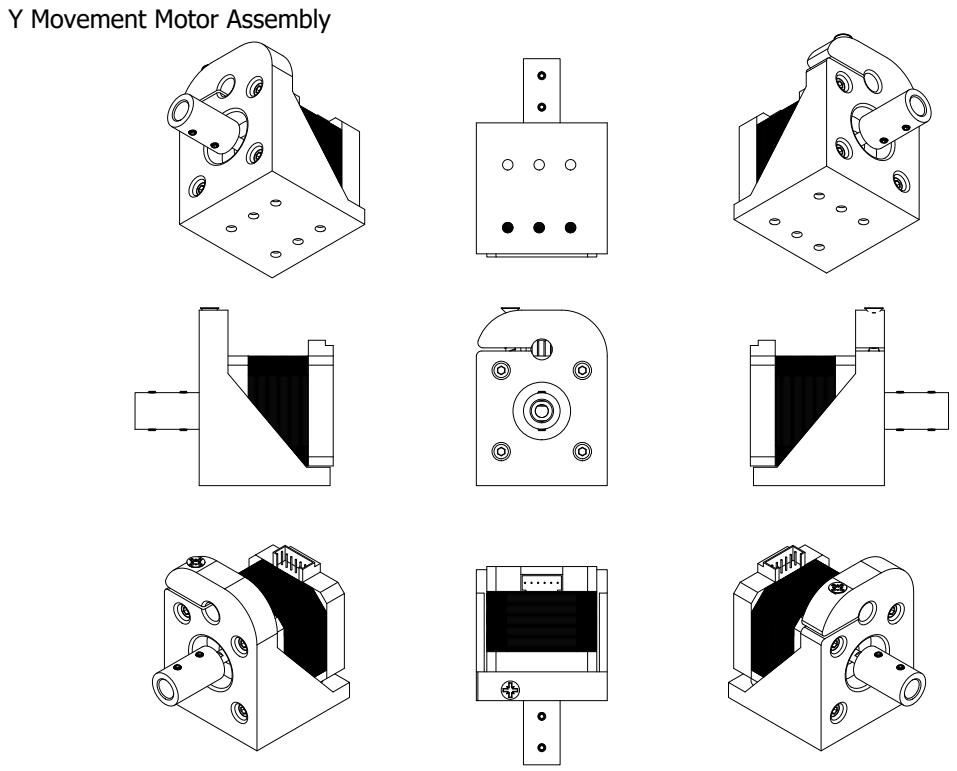
[picture p148: page 1]

Y Movement Motor Assembly

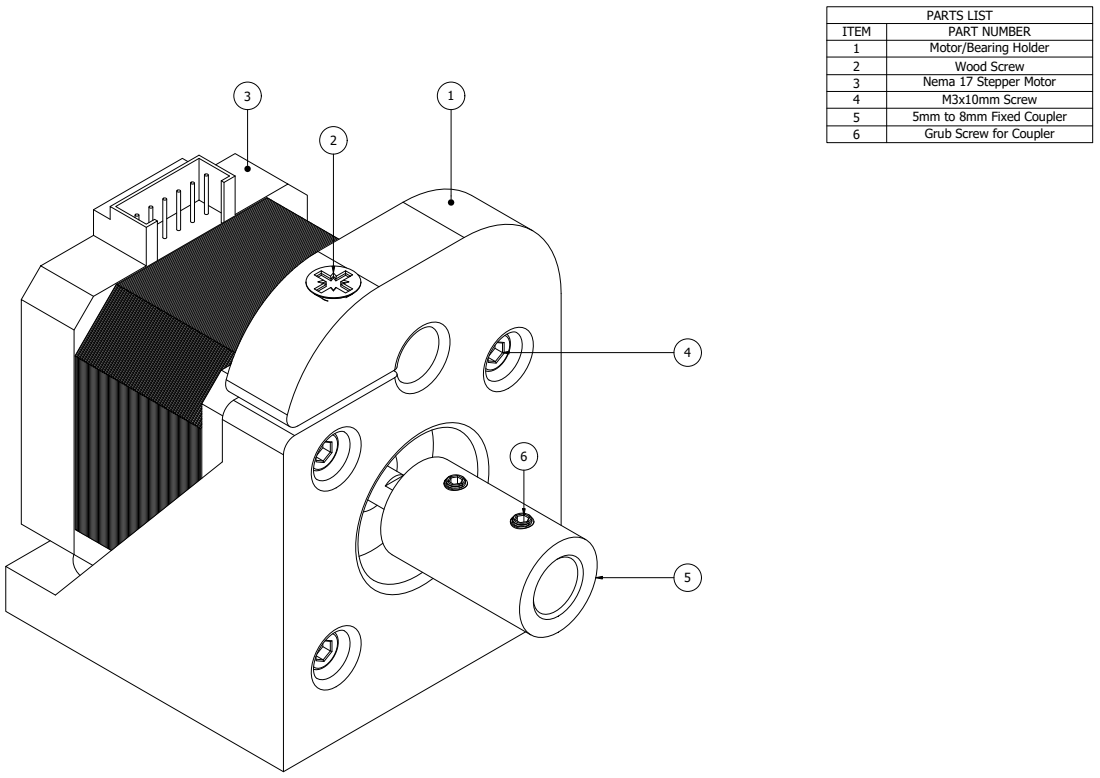
[picture p149: page 2]
PARTS LIST

ITEM | PART NUMBER
1 | Motor/Bearing Holder
2 | Wood Screw
3 | Nema 17 Stepper Motor
4 | M3x10mm Screw
5 | 5mm to 8mm Fixed Coupler
6 | Grub Screw for Coupler
