TactileImages/TactilePrinterOne-P4/Imprimanta 3 A4 Lemn Platf Fixa/Drawings/Z Limit Switch Assembly.pdf

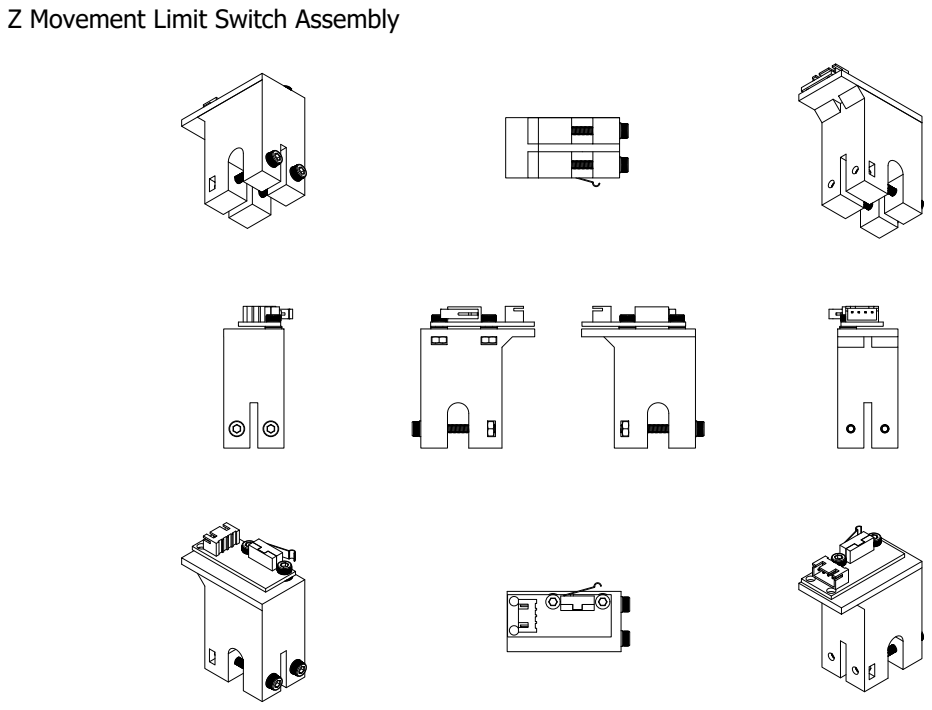
[picture p150: page 1]

Z Movement Limit Switch Assembly

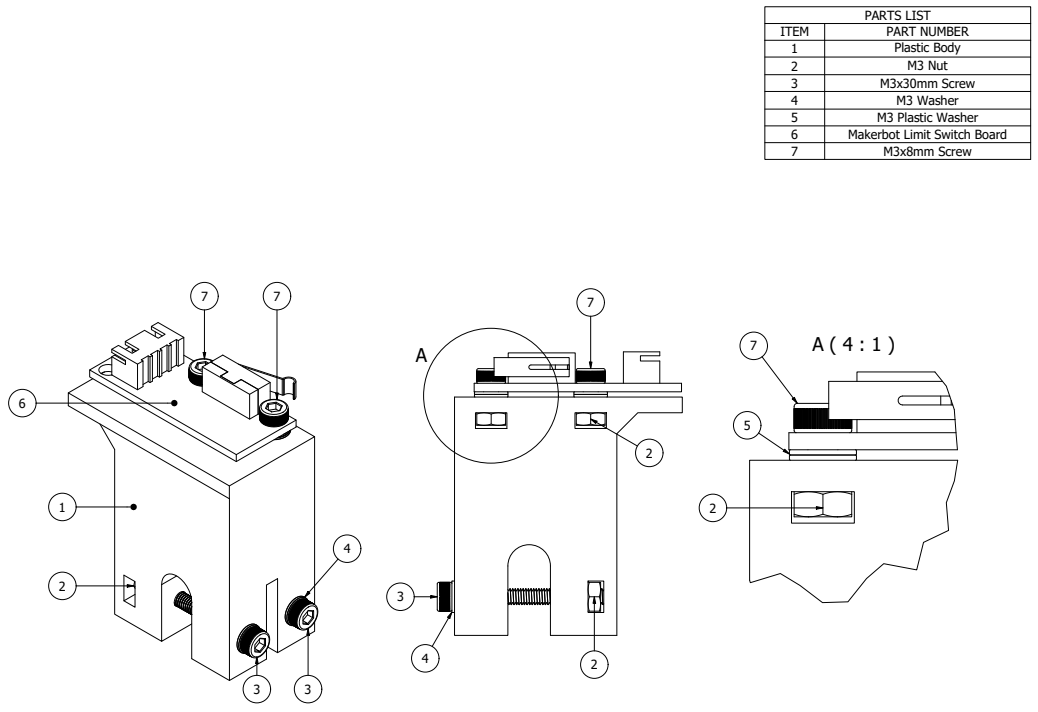
[picture p151: page 2]
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
