TactileImages/TactilePrinterOne-P4/Imprimanta 4 A4 Metal/Drawings/Needle Parking Assembly.pdf

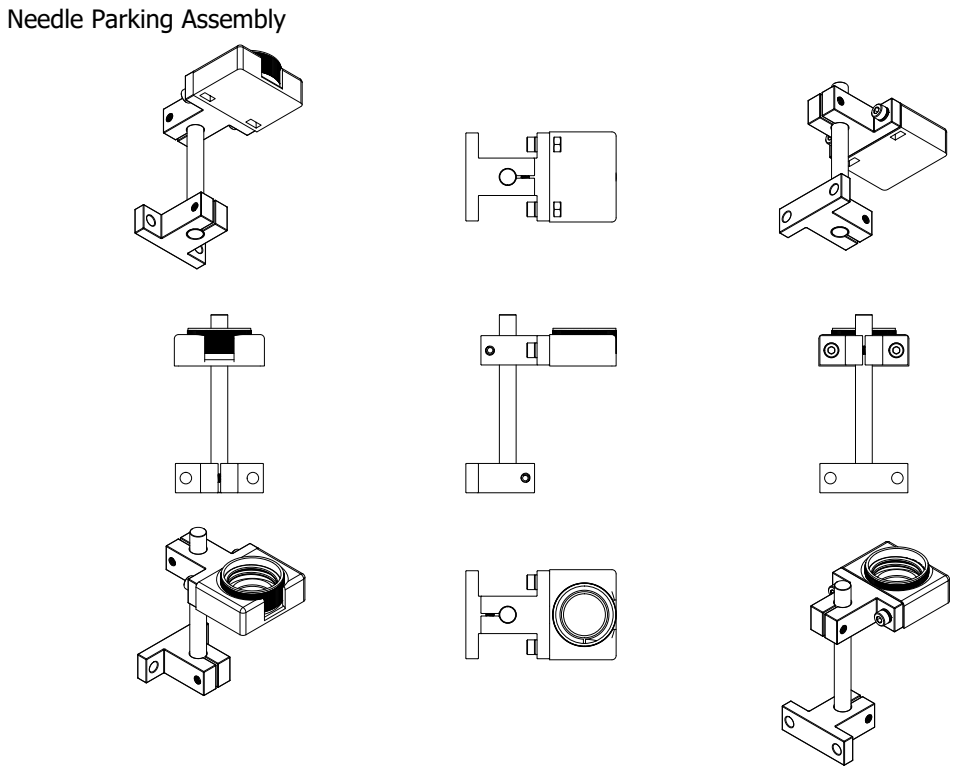
[picture p152: page 1]

Needle Parking Assembly

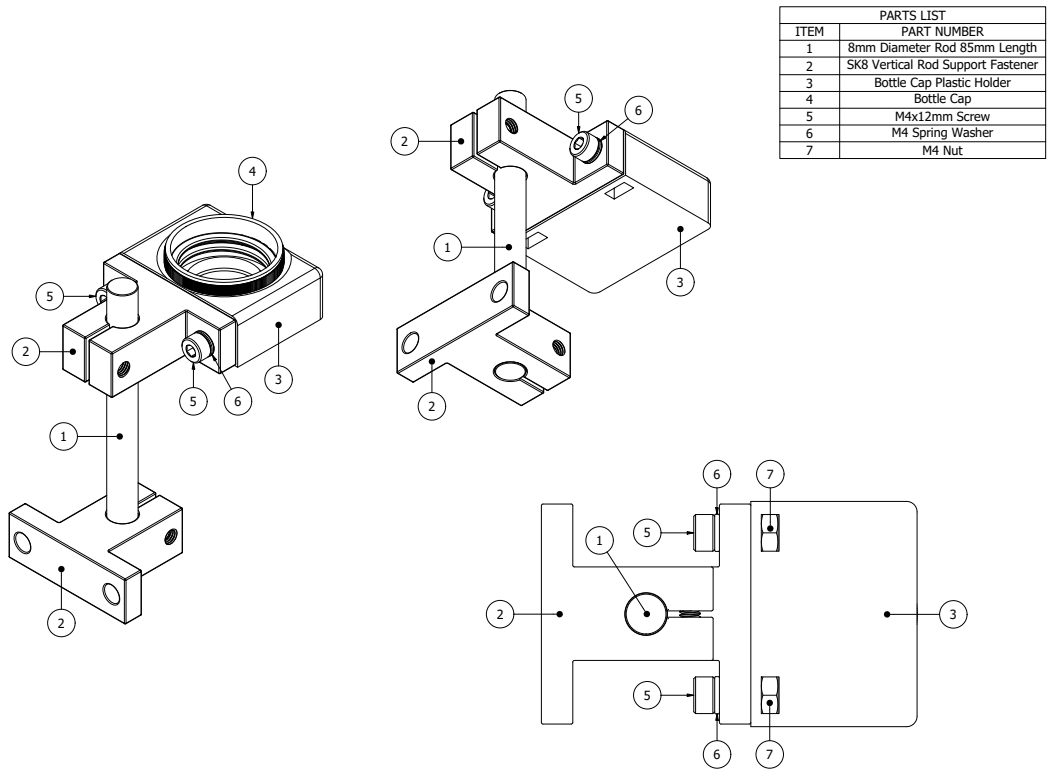
[picture p153: page 2]
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
