TactileImages/TactilePrinterOne-P4/Imprimanta 4 A4 Metal/Drawings/Power Connector and Switch Assembly.pdf

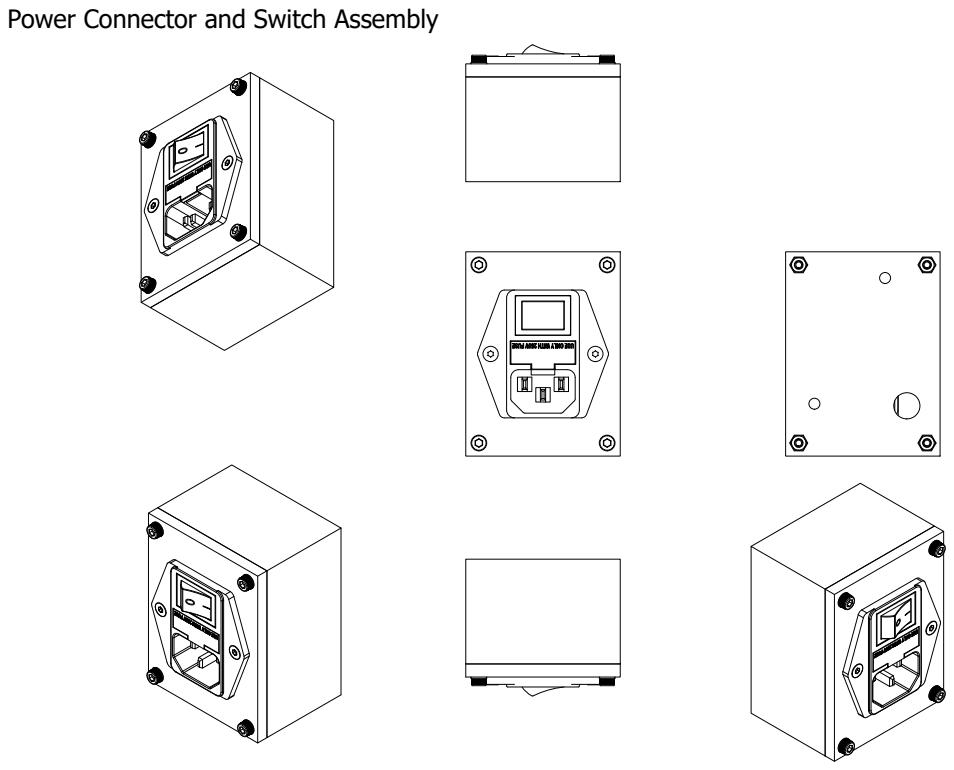
[picture p154: page 1]

Power Connector and Switch Assembly

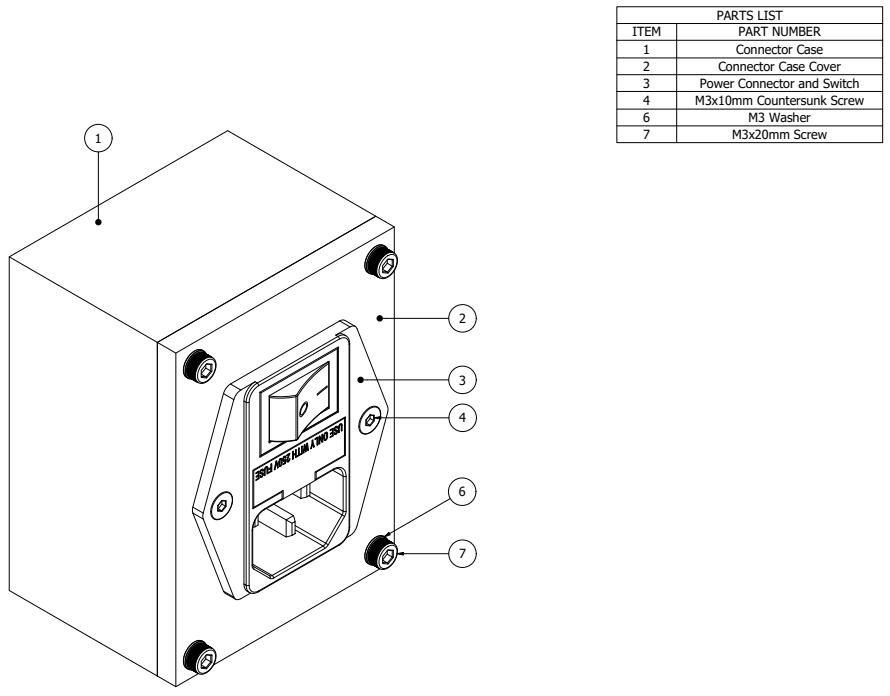
[picture p155: page 2]
PARTS LIST

ITEM | PART NUMBER
1 | Connector Case
2 | Connector Case Cover
3 | Power Connector and Switch
4 | M3x10mm Countersunk Screw
6 | M3 Washer
7 | M3x20mm Screw

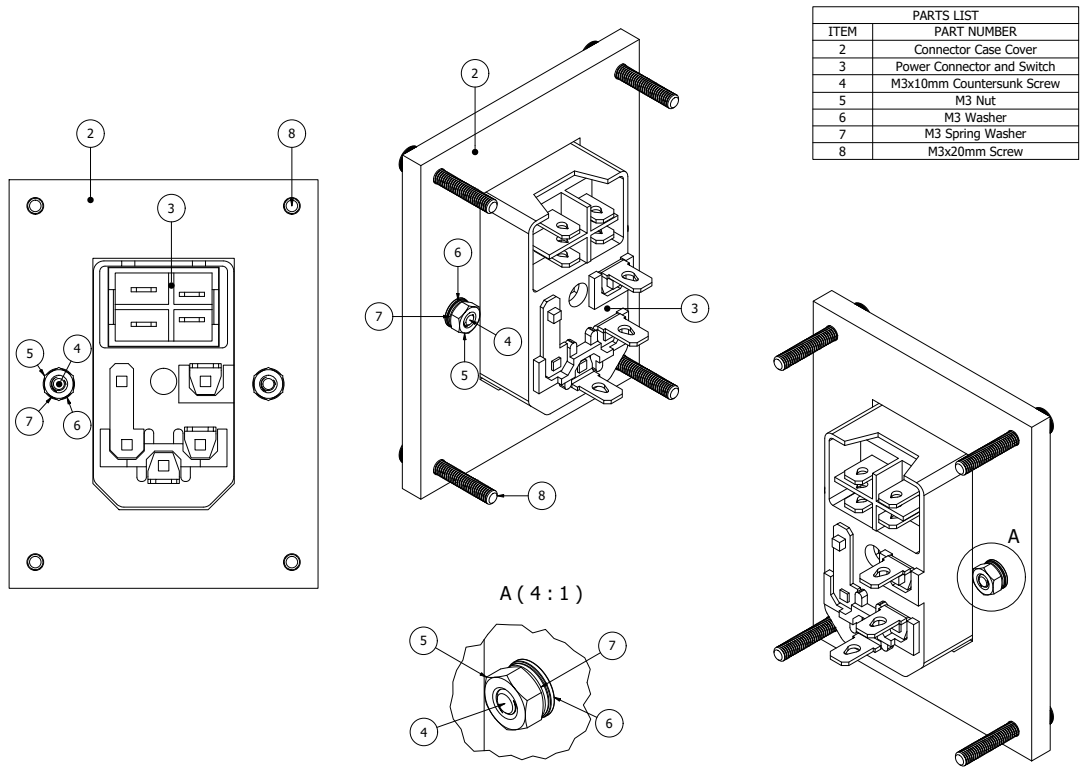
[picture p156: page 3]
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

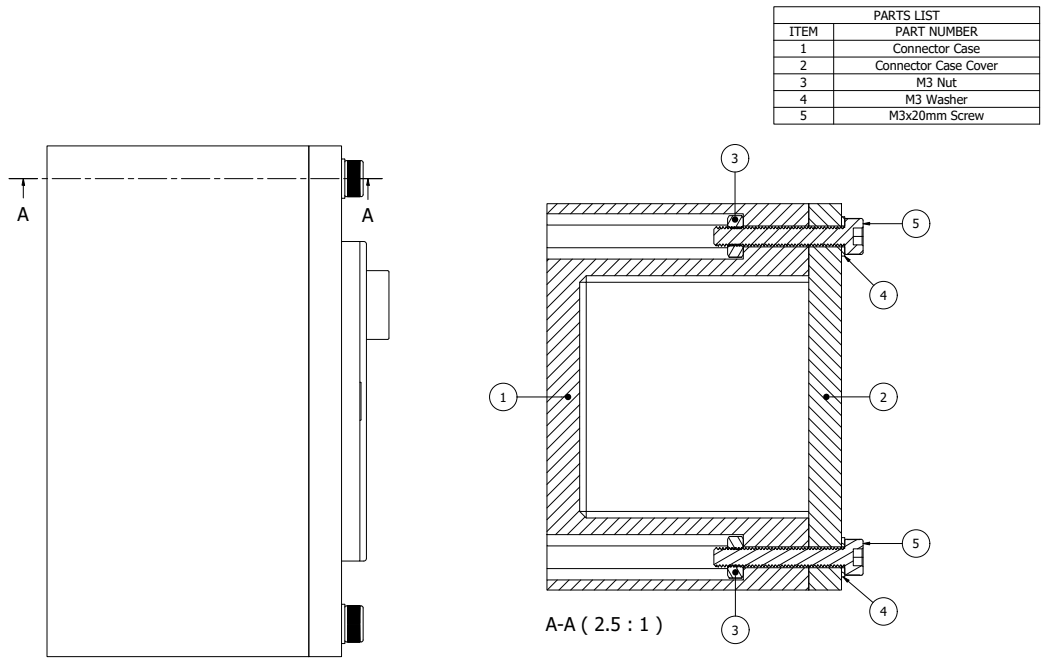
[picture p157: page 4]

1 | Connector Case
2 | Connector Case Cover
3 | M3 Nut
4 | M3 Washer
5 | M3x20mm Screw

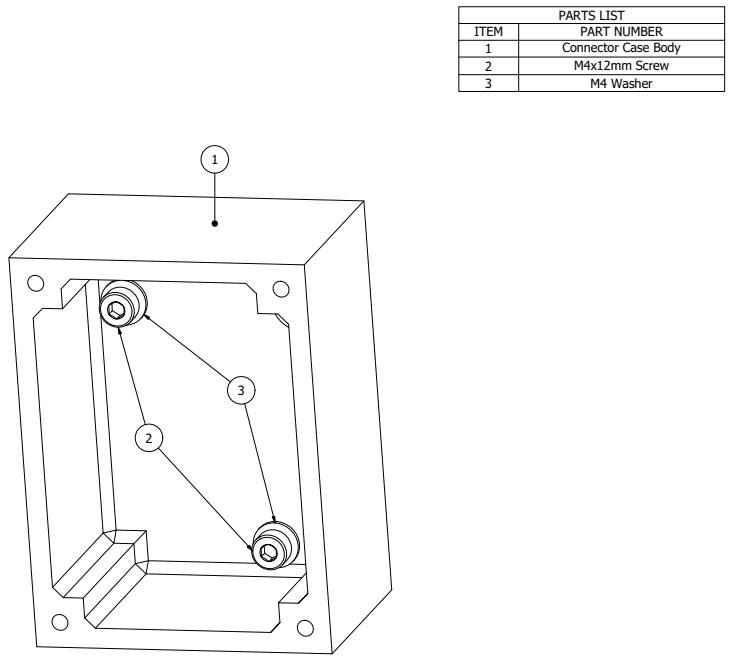
[picture p158: page 5]

1 | Connector Case Body
2 | M4x12mm Screw
3 | M4 Washer

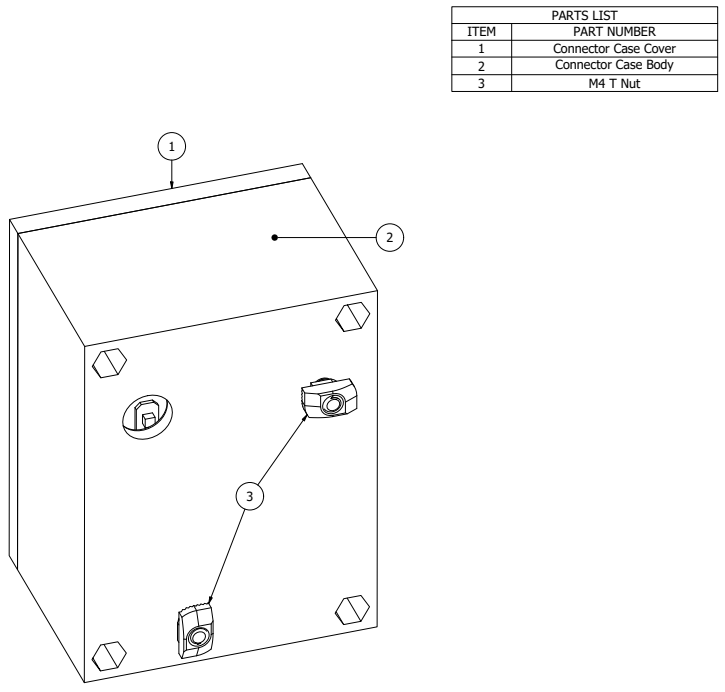
[picture p159: page 6]

1 | Connector Case Cover
2 | Connector Case Body
3 | M4 T Nut
