TactileImages/TactilePrinterOne-P4/Imprimanta 4 A4 Metal/Drawings/Printer Assembly.pdf

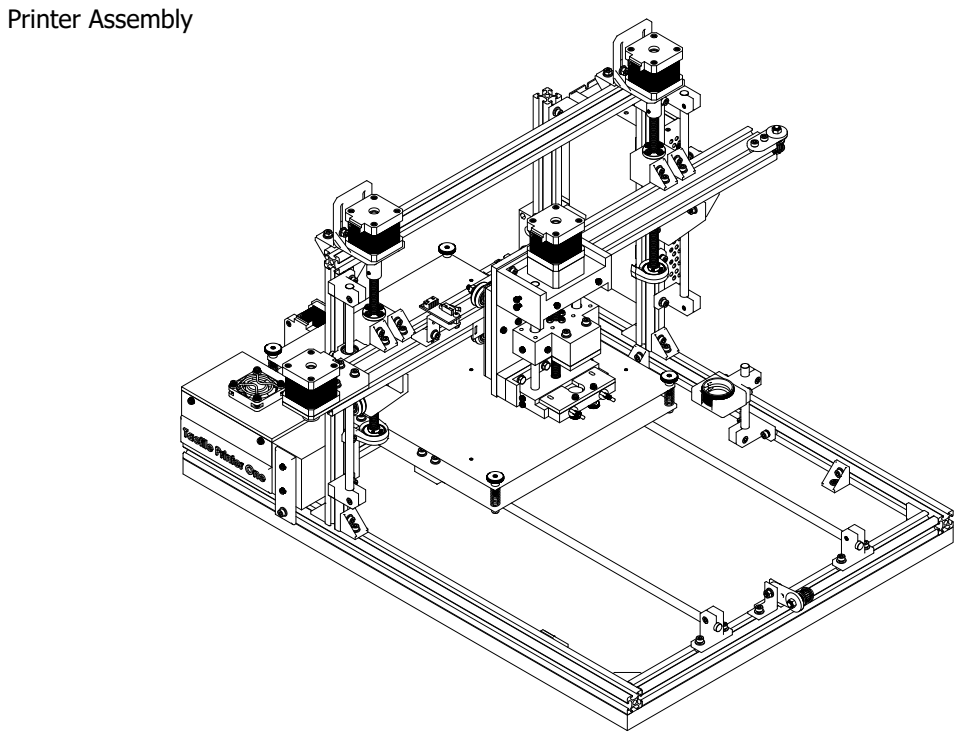
[picture p160: page 1]
Printer Assembly

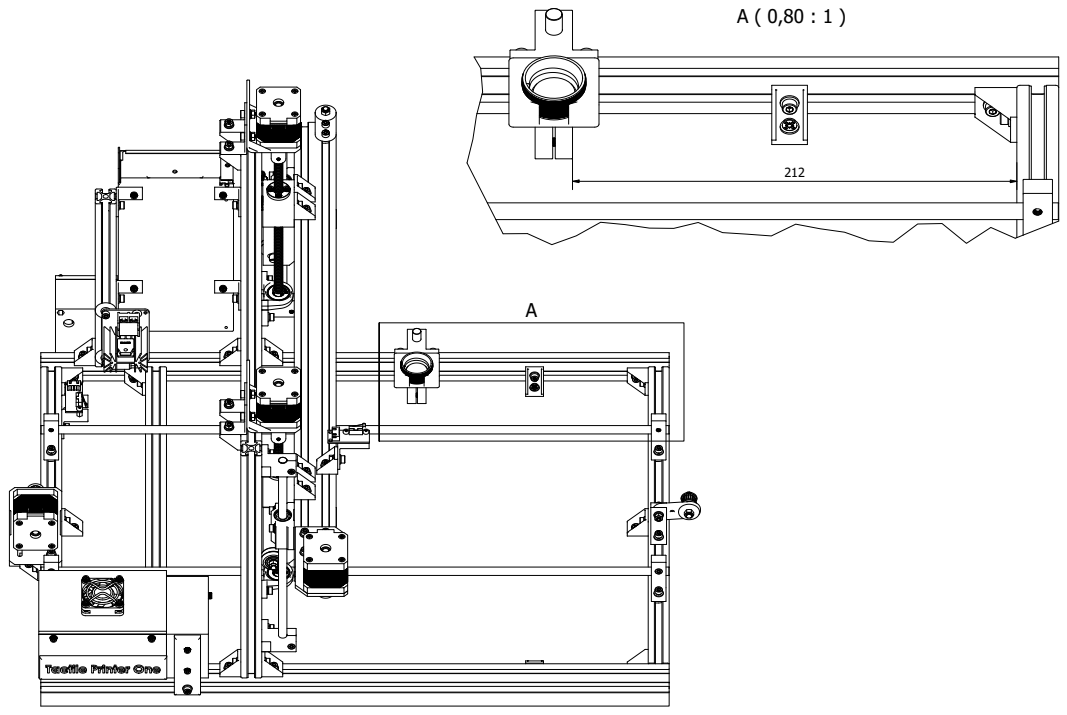
[picture p161: page 2]

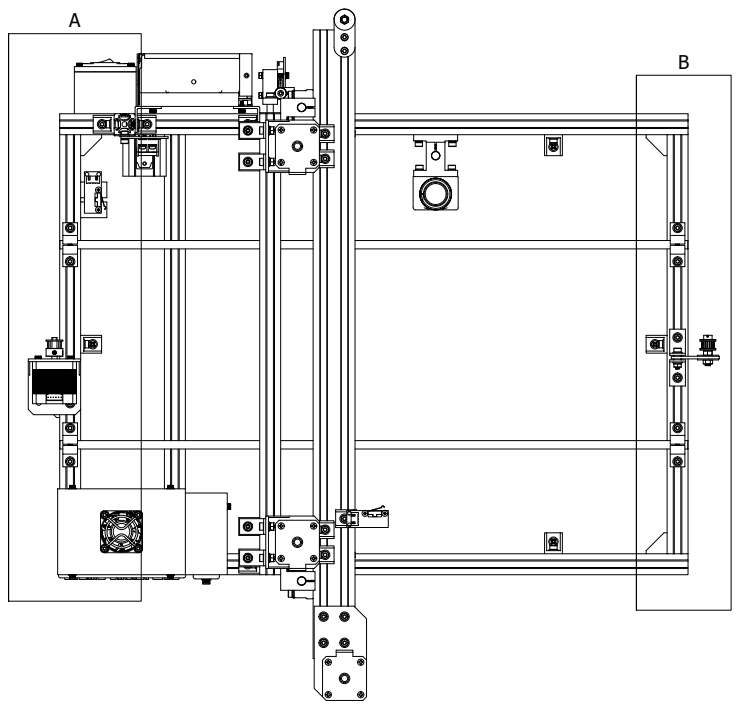
[picture p162: page 3]

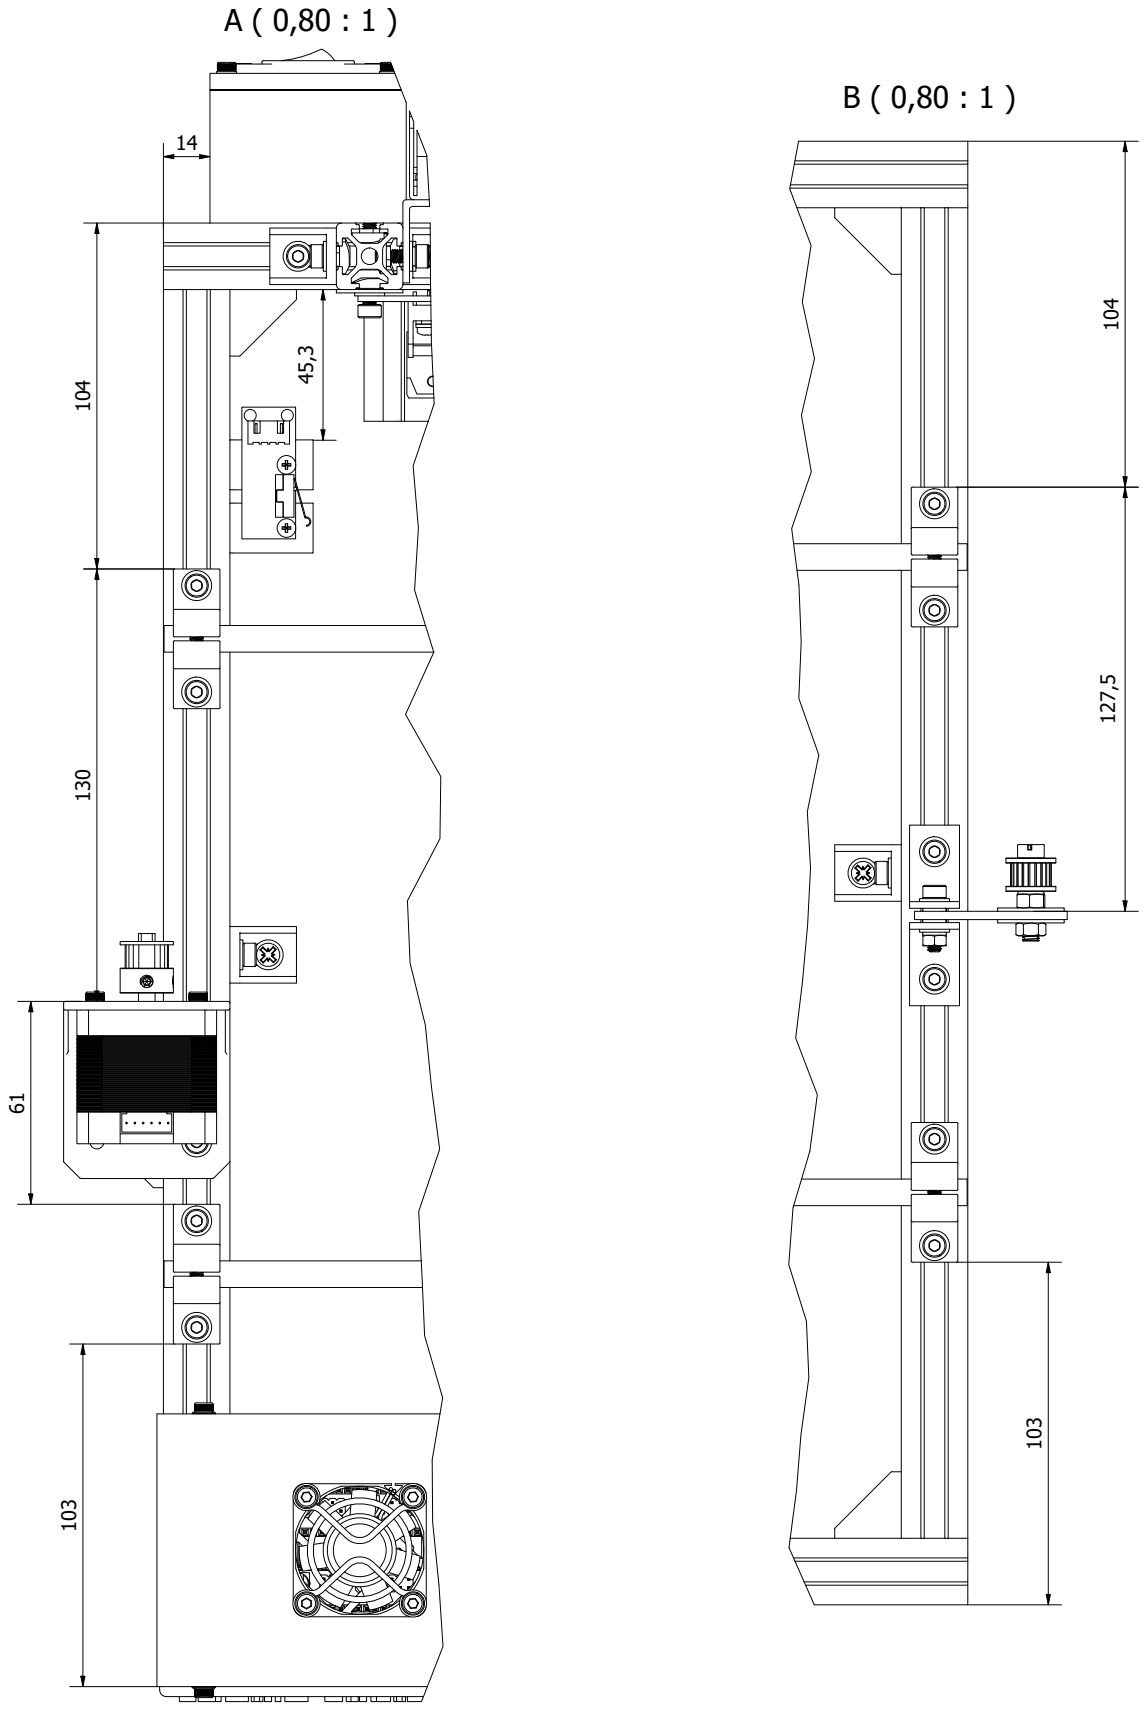
[picture p163: page 4]

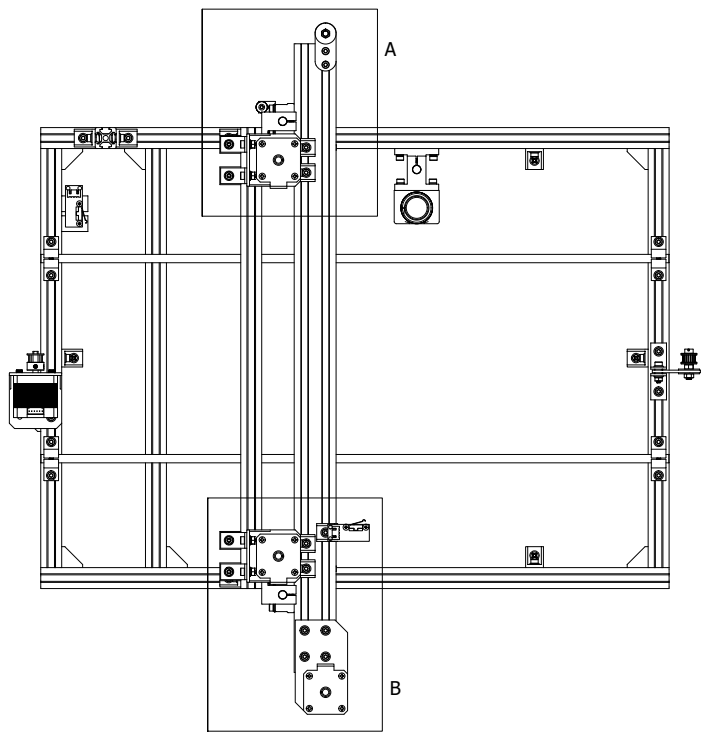
[picture p164: page 5]

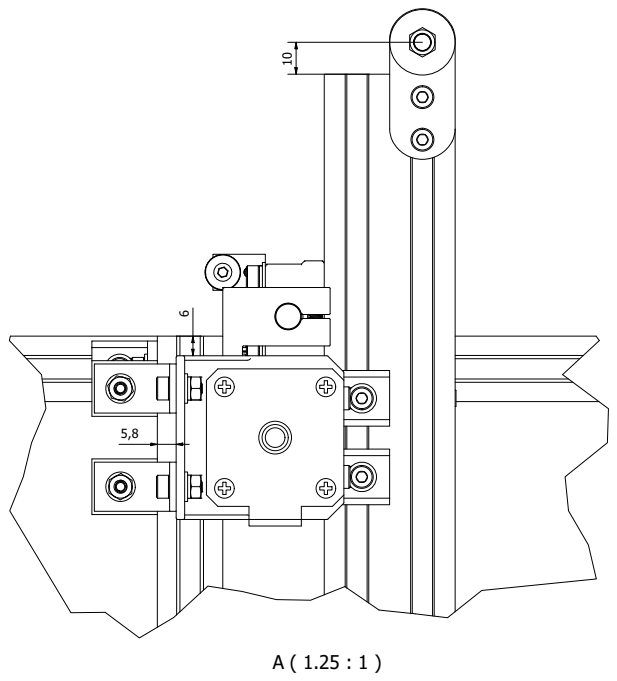
[picture p165: page 6]

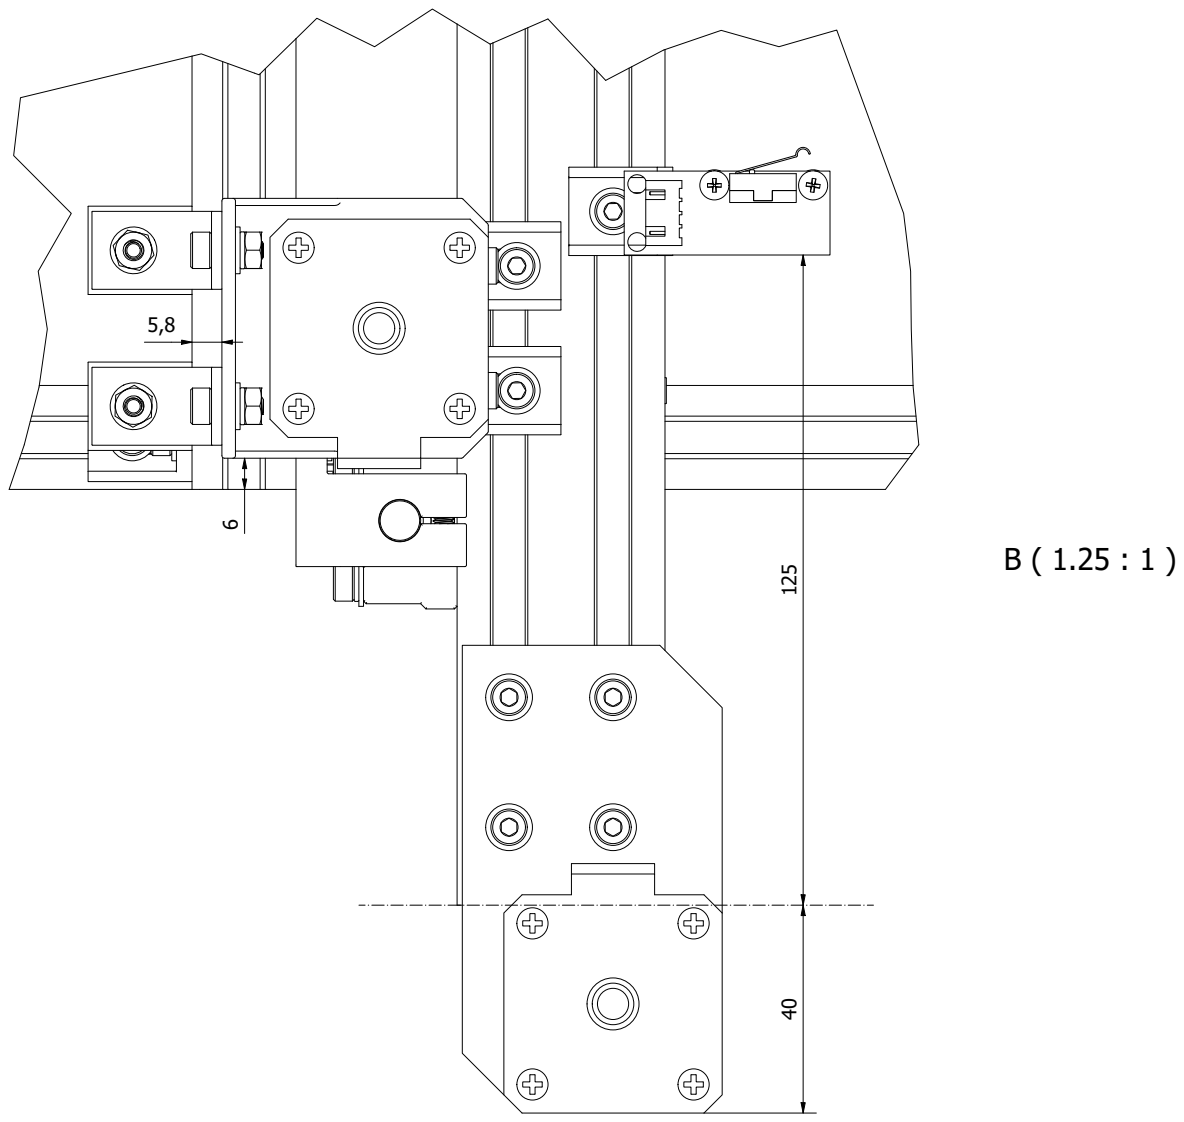
[picture p166: page 7]

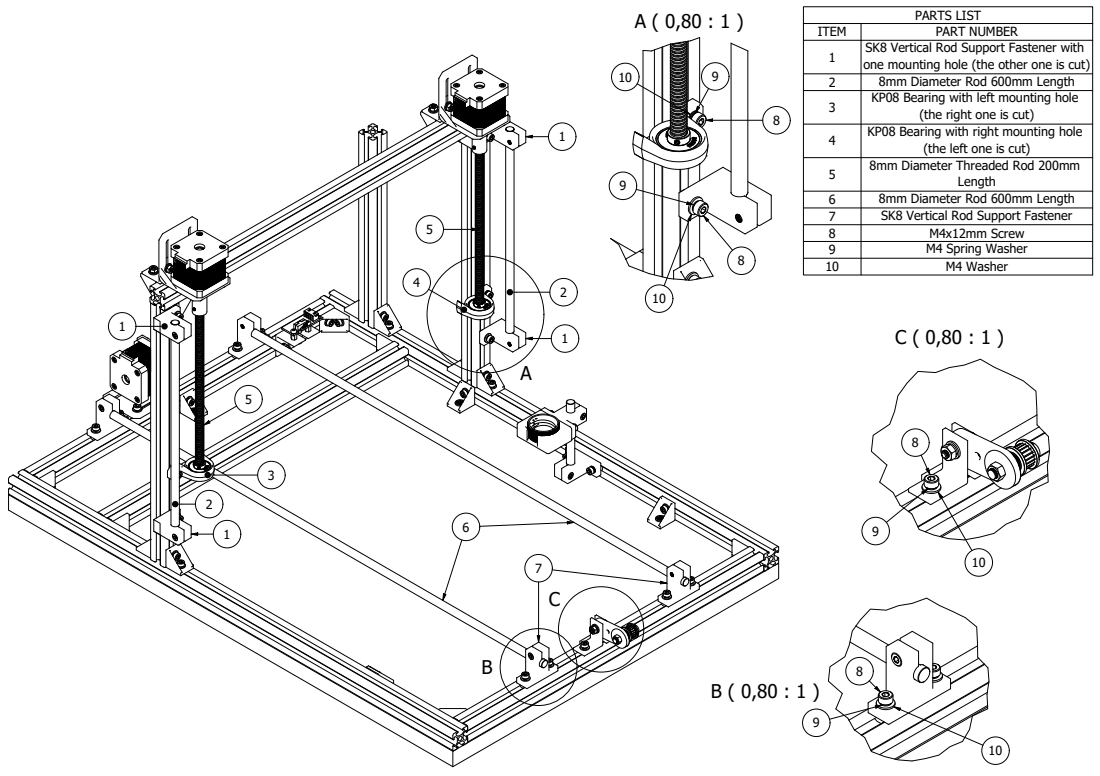
[picture p167: page 8]

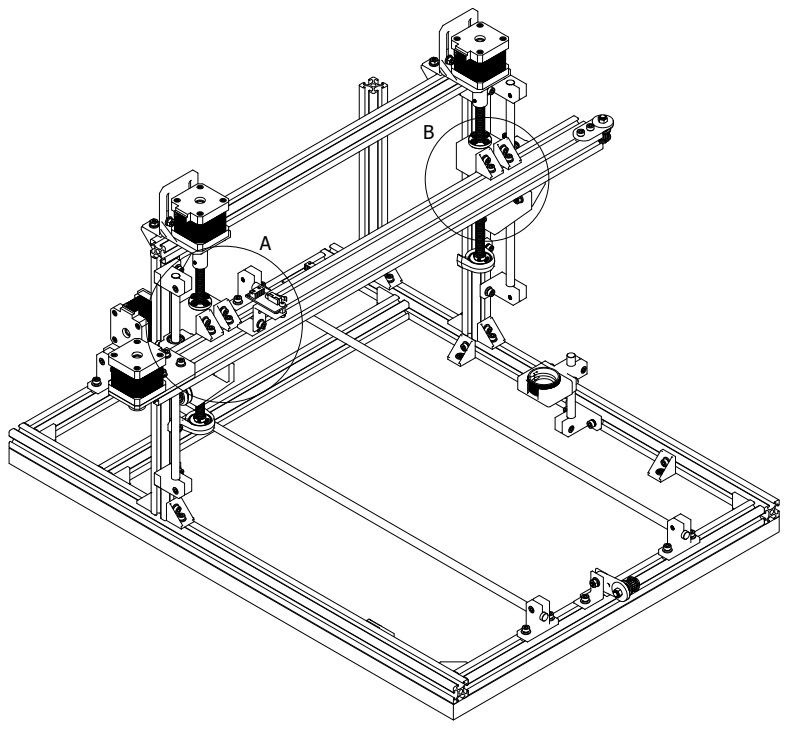
[picture p168: page 9]

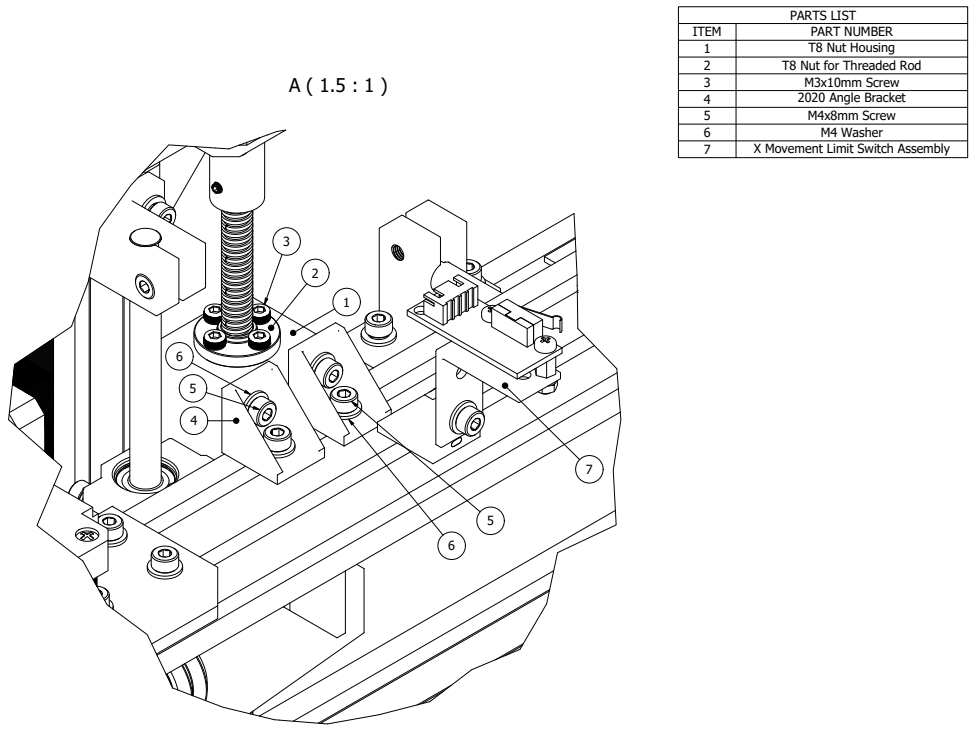
[picture p169: page 10]
PARTS LIST

ITEM | PART NUMBER
1 | T8 Nut Housing
2 | T8 Nut for Threaded Rod
3 | M3x10mm Screw
4 | 2020 Angle Bracket
5 | M4x8mm Screw
6 | M4 Washer
7 | X Movement Limit Switch Assembly

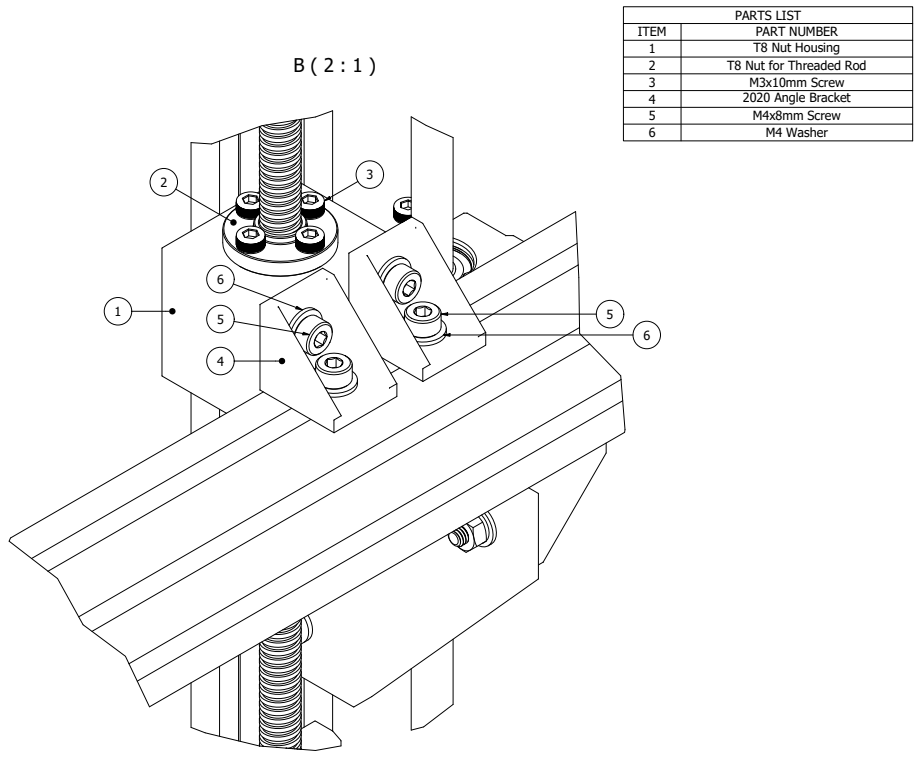
[picture p170: page 11]

I T E M | P A RT N U M B E R
1 | T 8 N u t H o u s i n g
2 | T 8 N u t fo r T h r e a d e d R o d
3 | M 3 x 1 0 m m S c r e w
4 | 2 0 2 0 A n gle B r a c k e t
5 | M 4 x 8 m m S c r e w
6 | M 4 W a s h e r

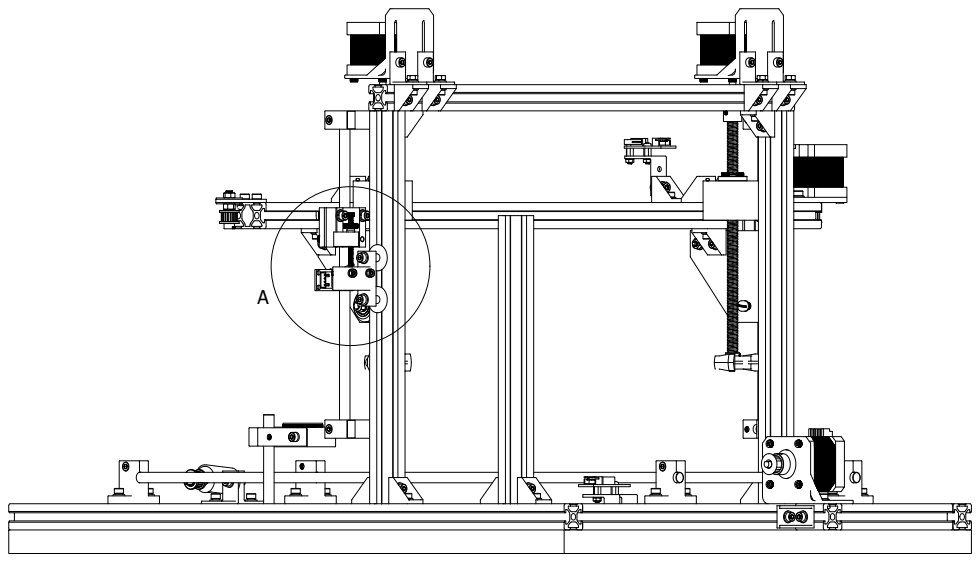
[picture p171: page 12]

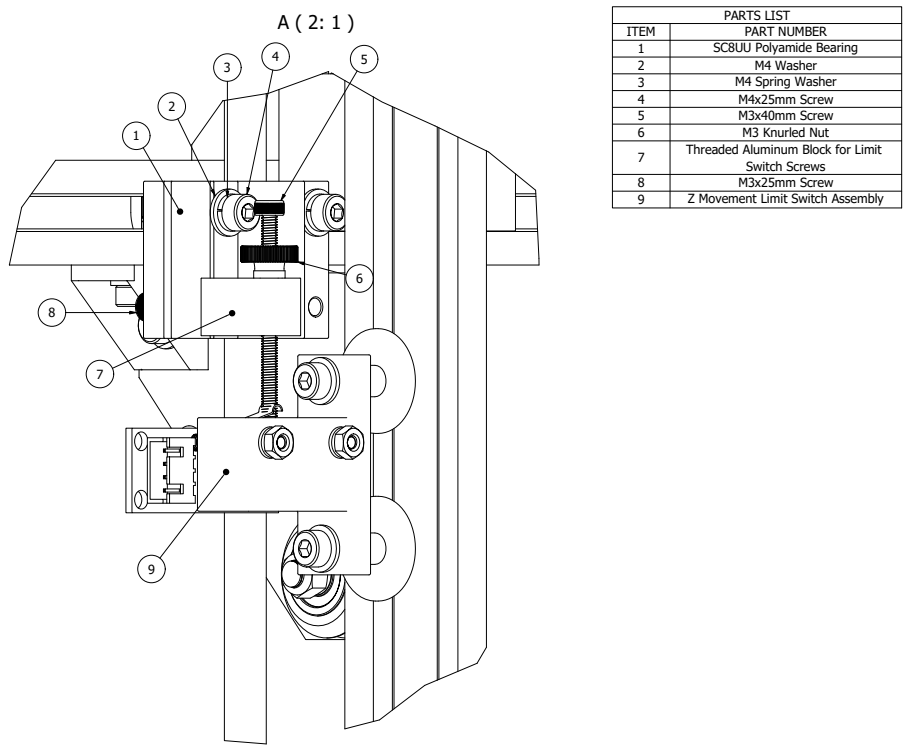
[picture p172: page 13]
PARTS LIST

ITEM | PART NUMBER
1 | SC8UU Polyamide Bearing
2 | M4 Washer
3 | M4 Spring Washer
4 | M4x25mm Screw
5 | M3x40mm Screw
6 | M3 Knurled Nut
7 | Threaded Aluminum Block for Limit Switch Screws

8 | M3x25mm Screw
9 | Z Movement Limit Switch Assembly

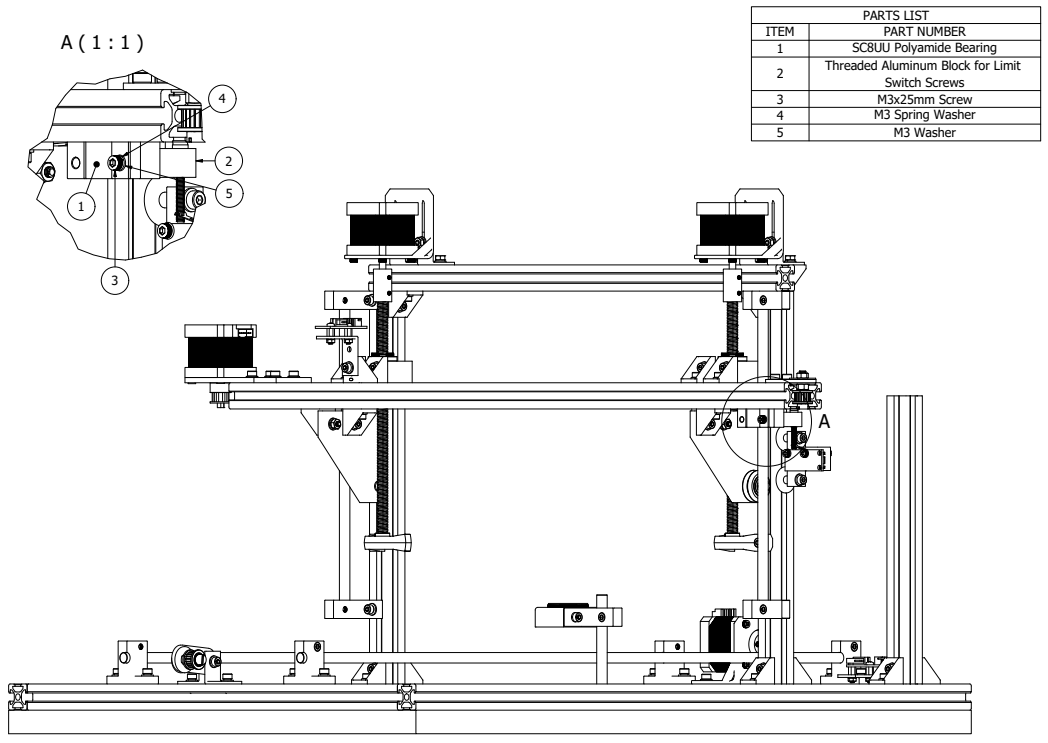
[picture p173: page 14]

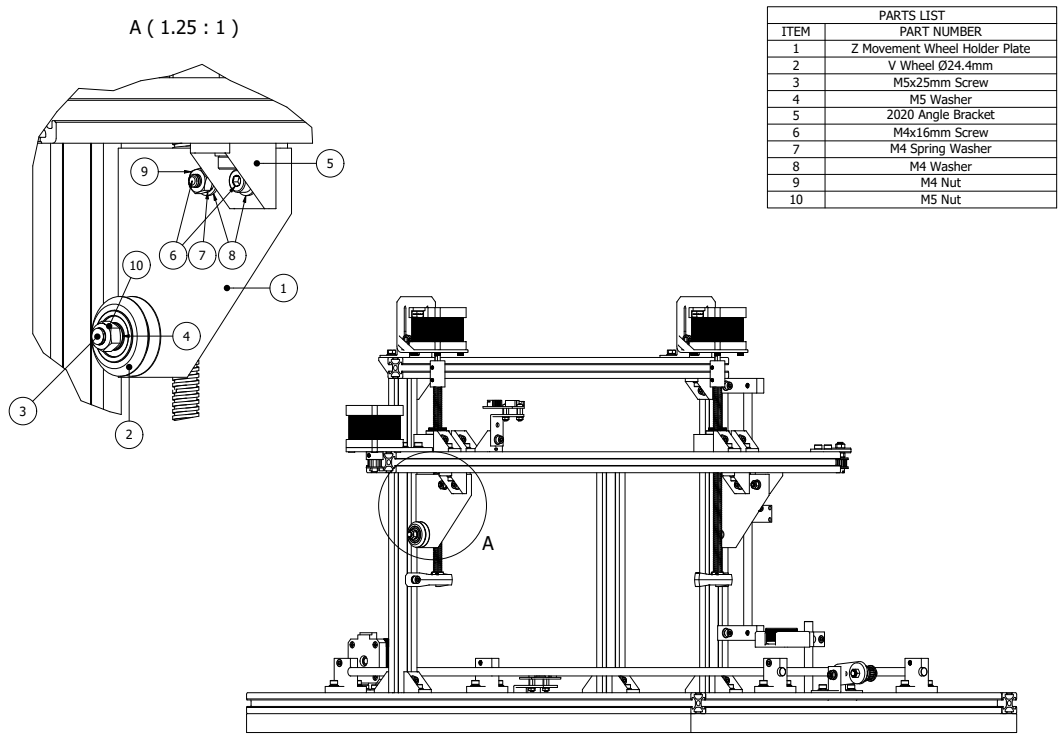
[picture p174: page 15]

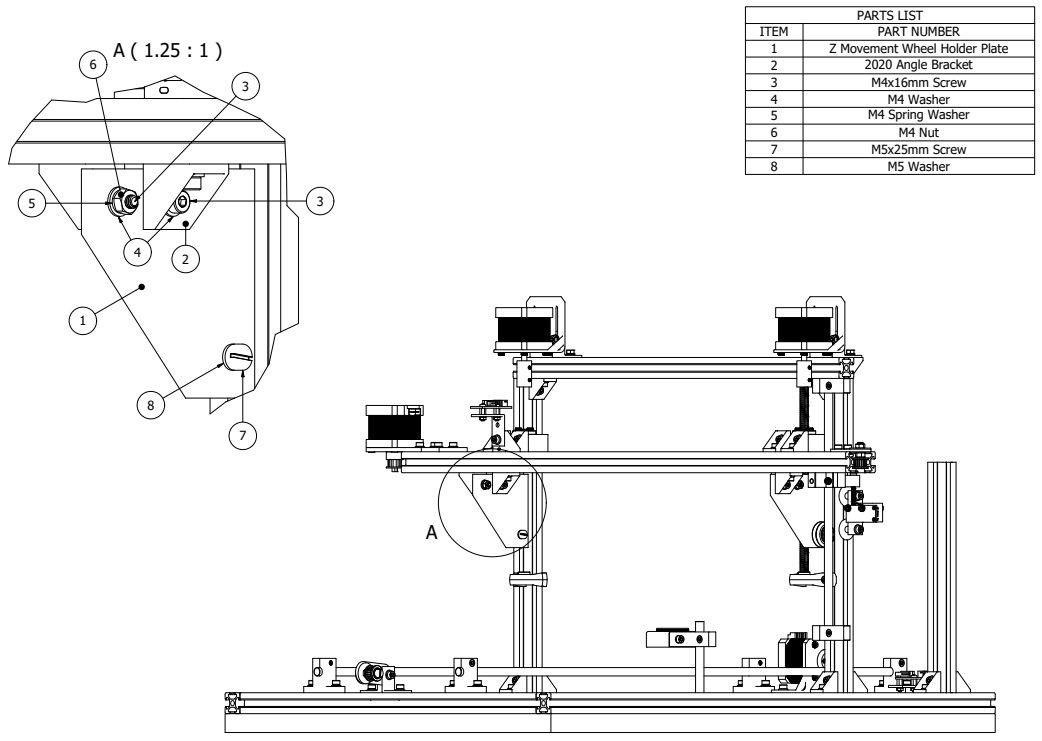
[picture p175: page 16]

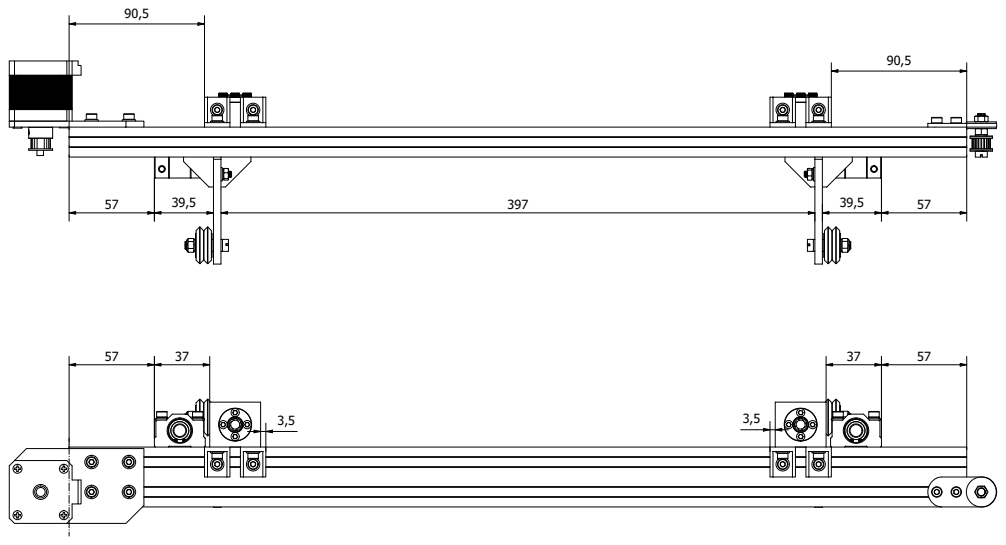
[picture p176: page 17]

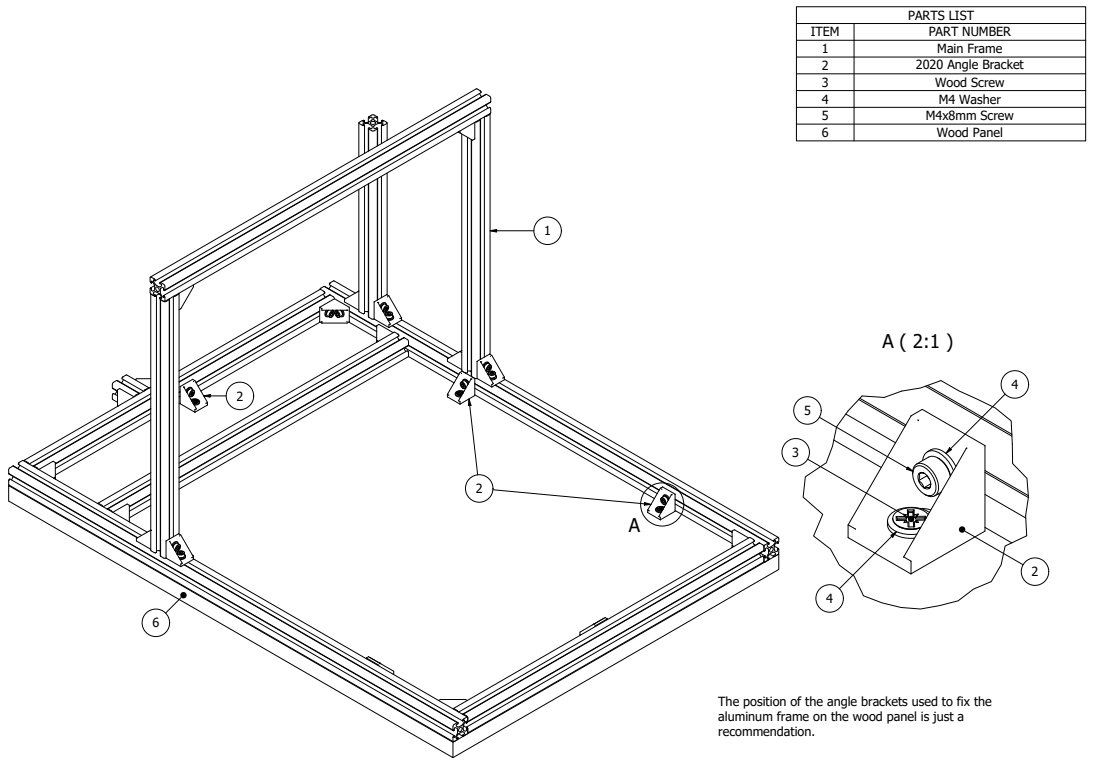
[picture p177: page 18]
PARTS LIST

ITEM | PART NUMBER
1 | Main Frame
2 | 2020 Angle Bracket
3 | Wood Screw
4 | M4 Washer
5 | M4x8mm Screw
6 | Wood Panel

The position of the angle brackets used to fix the
aluminum frame on the wood panel is just a
recommendation.

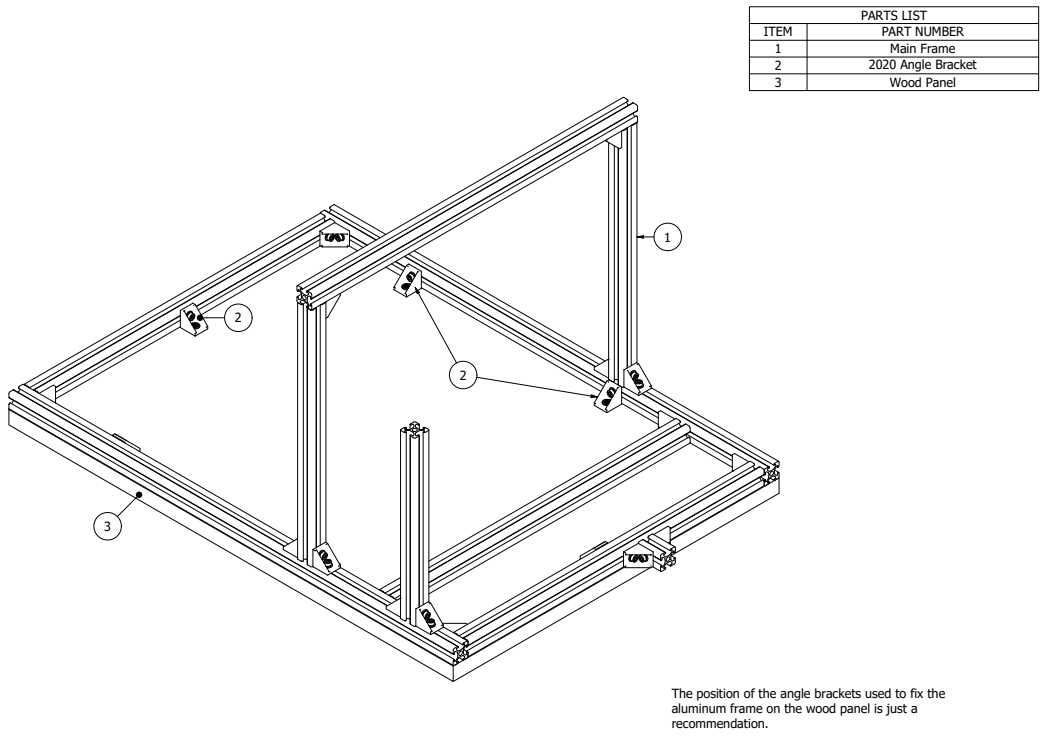
[picture p178: page 19]
PARTS LIST

ITEM | PART NUMBER
1 | Main Frame
2 | 2020 Angle Bracket
3 | Wood Panel

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
