TactileImages/TactilePrinterOne-P4/Imprimanta 4 A4 Metal/Drawings/X Movement Motor Assembly.pdf

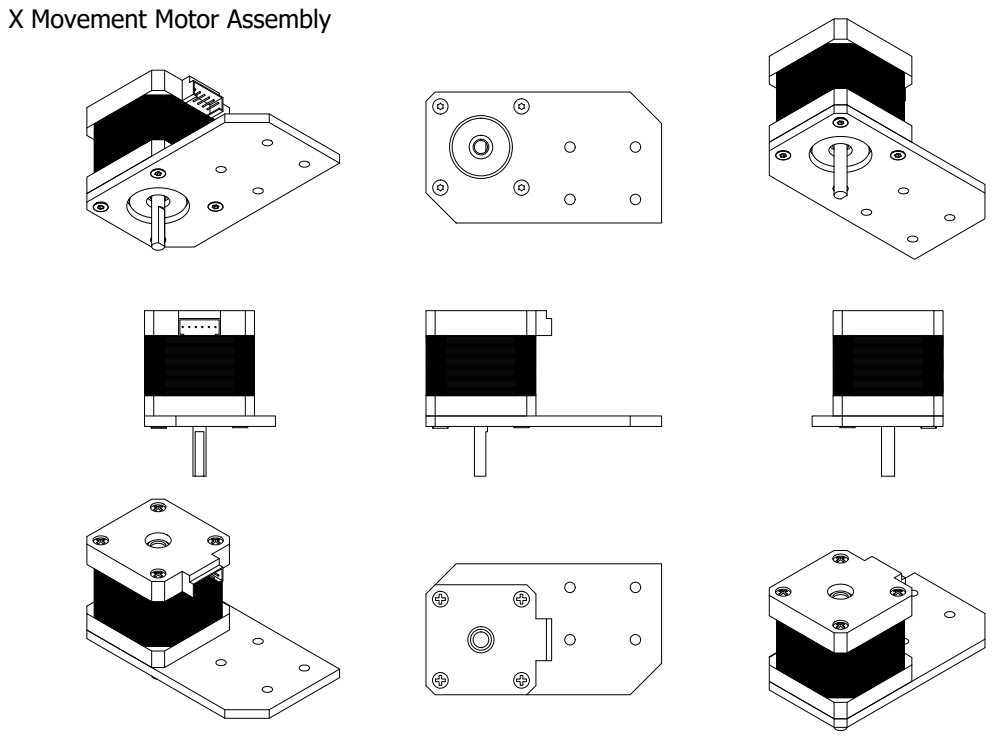
[picture p179: page 1]

X Movement Motor Assembly

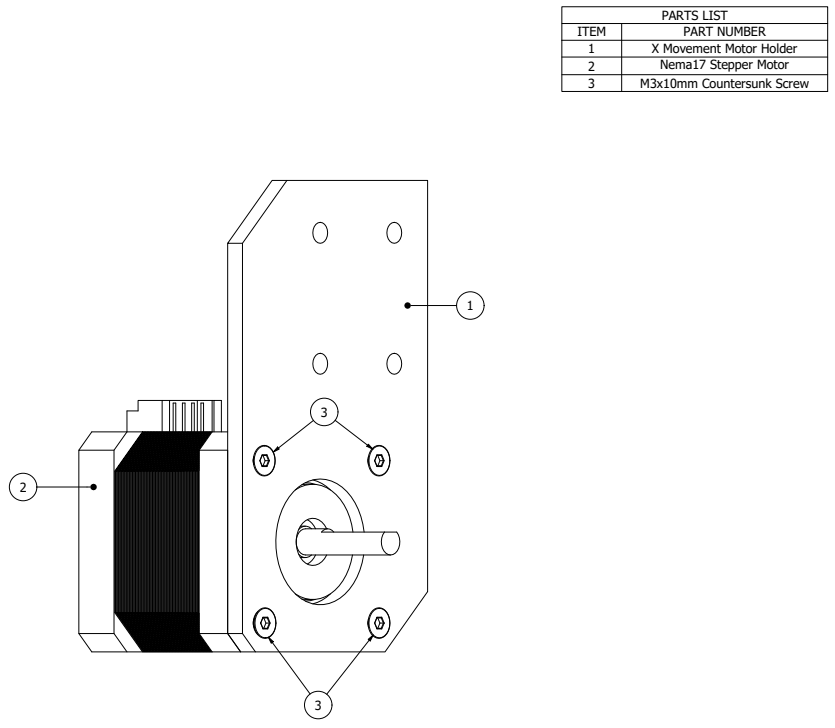
[picture p180: page 2]
PARTS LIST

ITEM | PART NUMBER
1 | X Movement Motor Holder
2 | Nema17 Stepper Motor
3 | M3x10mm Countersunk Screw

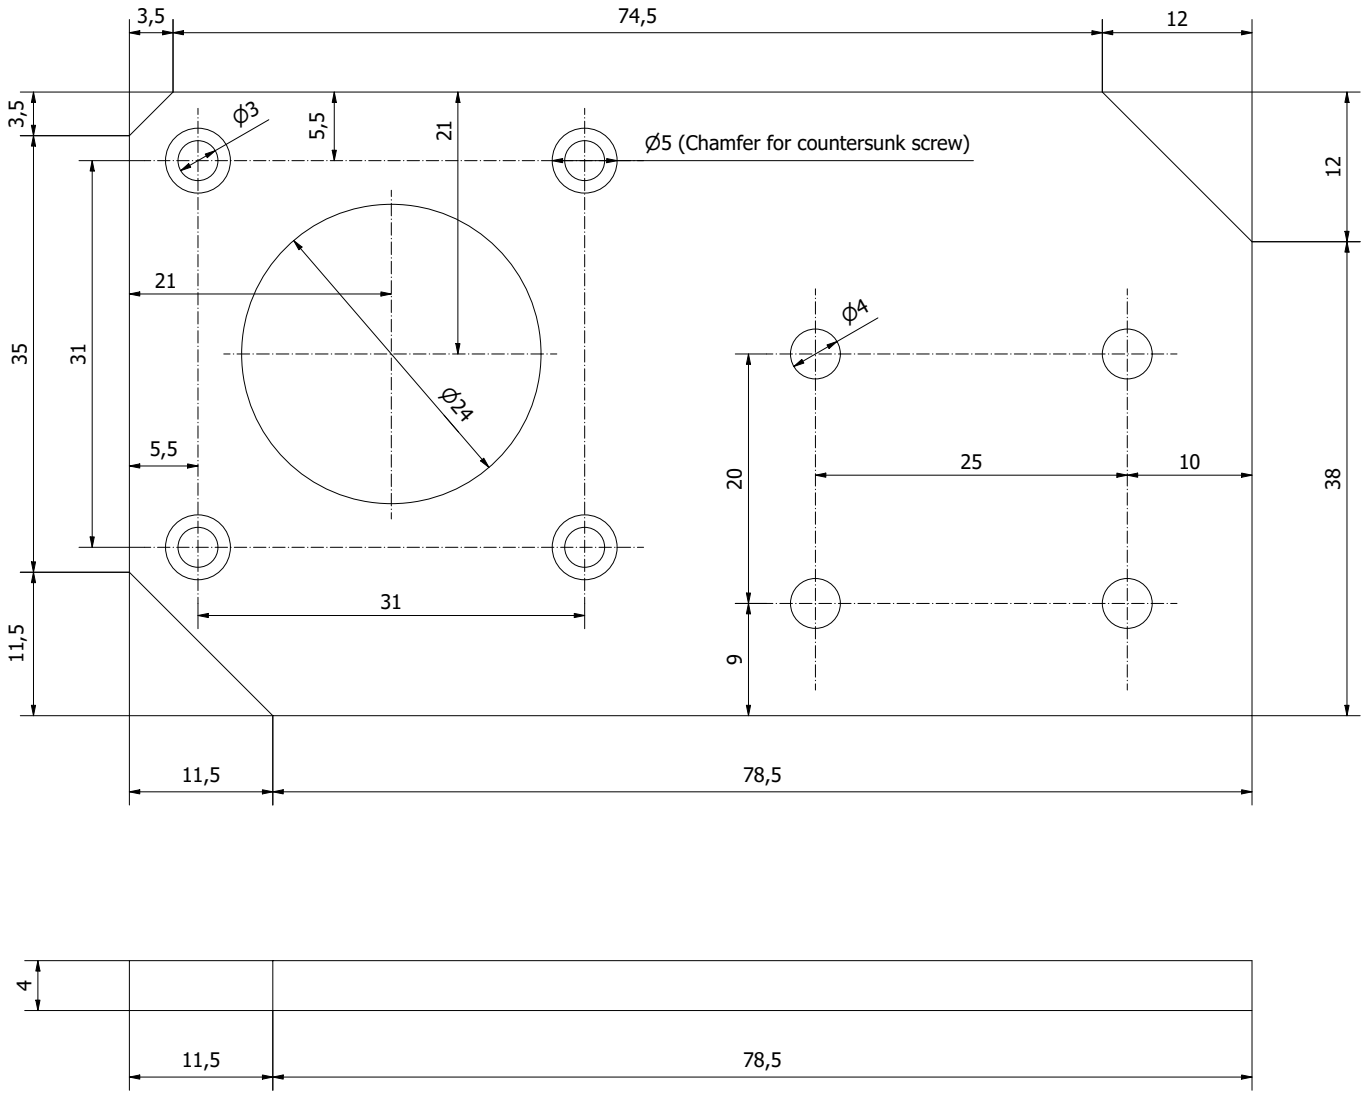
[picture p181: page 3]

⌀5 (Chamfer for countersunk screw)
