TactileImages/TactilePrinterOne-P4/Imprimanta 4 A4 Metal/Drawings/Y Movement Motor Assembly.pdf

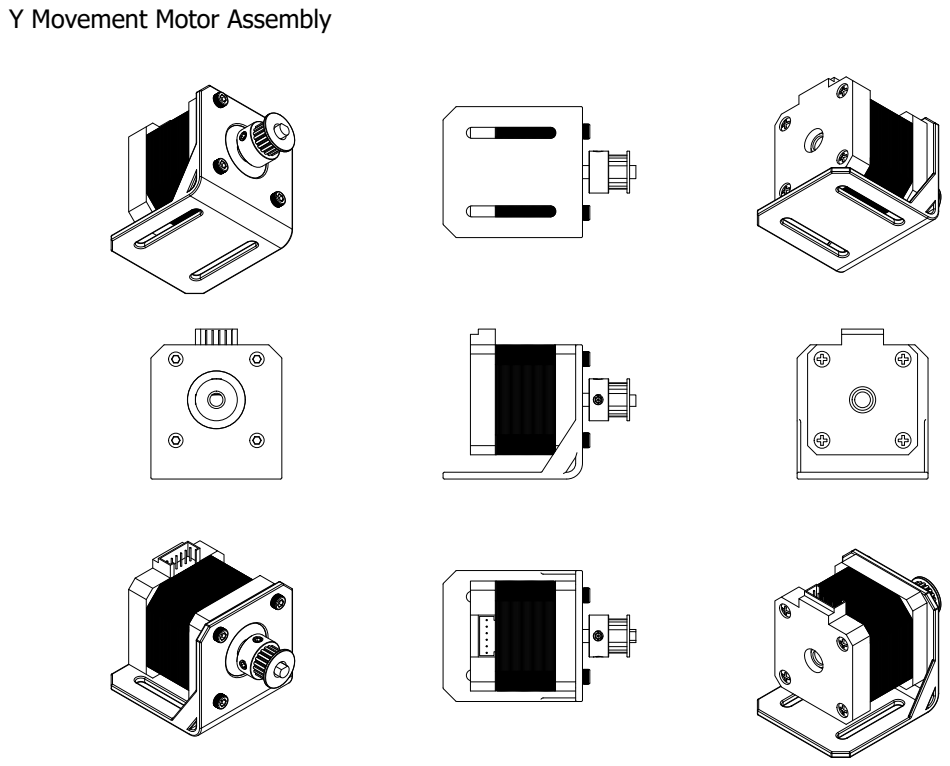
[picture p182: page 1]

Y Movement Motor Assembly

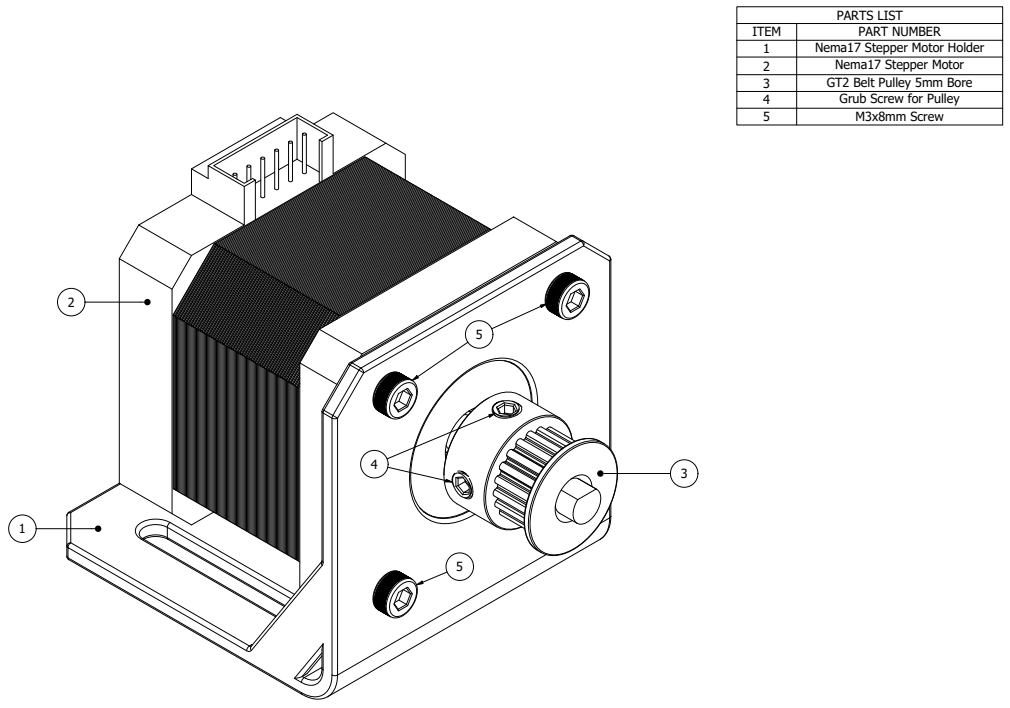
[picture p183: page 2]

I T E M | P A RT N U M B E R
1 | N e m a 1 7 S t e p p e r M o t o r H old e r
2 | N e m a 1 7 S t e p p e r M o t o r
3 | G T 2 B elt P ulle y 5 m m B o r e
4 | G r u b S c r e w fo r P ulle y
5 | M 3 x 8 m m S c r e w
