TactileImages/TactilePrinterOne-P4/Imprimanta 4 A4 Metal/Drawings/Z Movement Motor Assembly.pdf

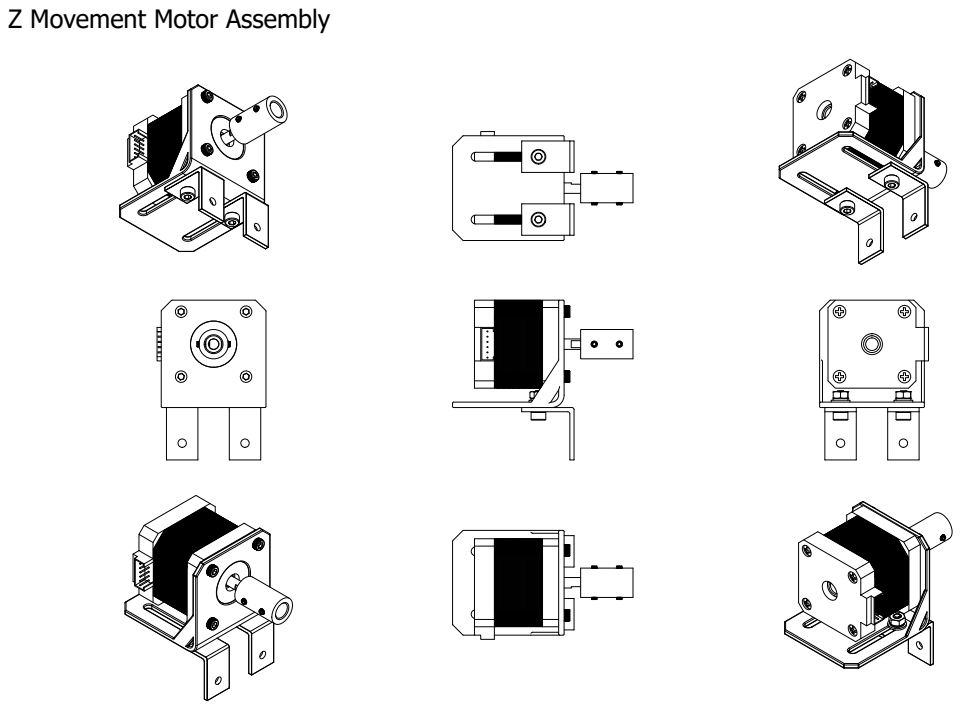
[picture p184: page 1]

Z Movement Motor Assembly

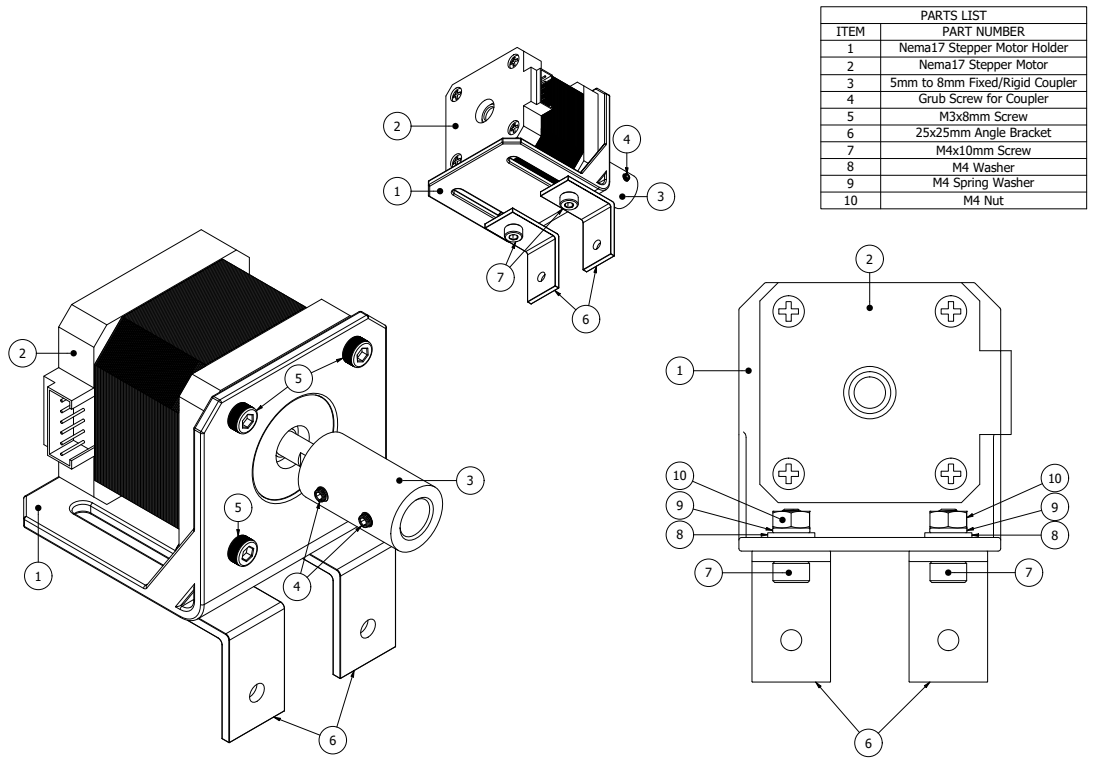
[picture p185: page 2]
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
