TactileImages/TactilePrinterOne-P4/Imprimanta 2 Metal A3/30 Injectomat/Drawings/30-07 Piece parts.pdf

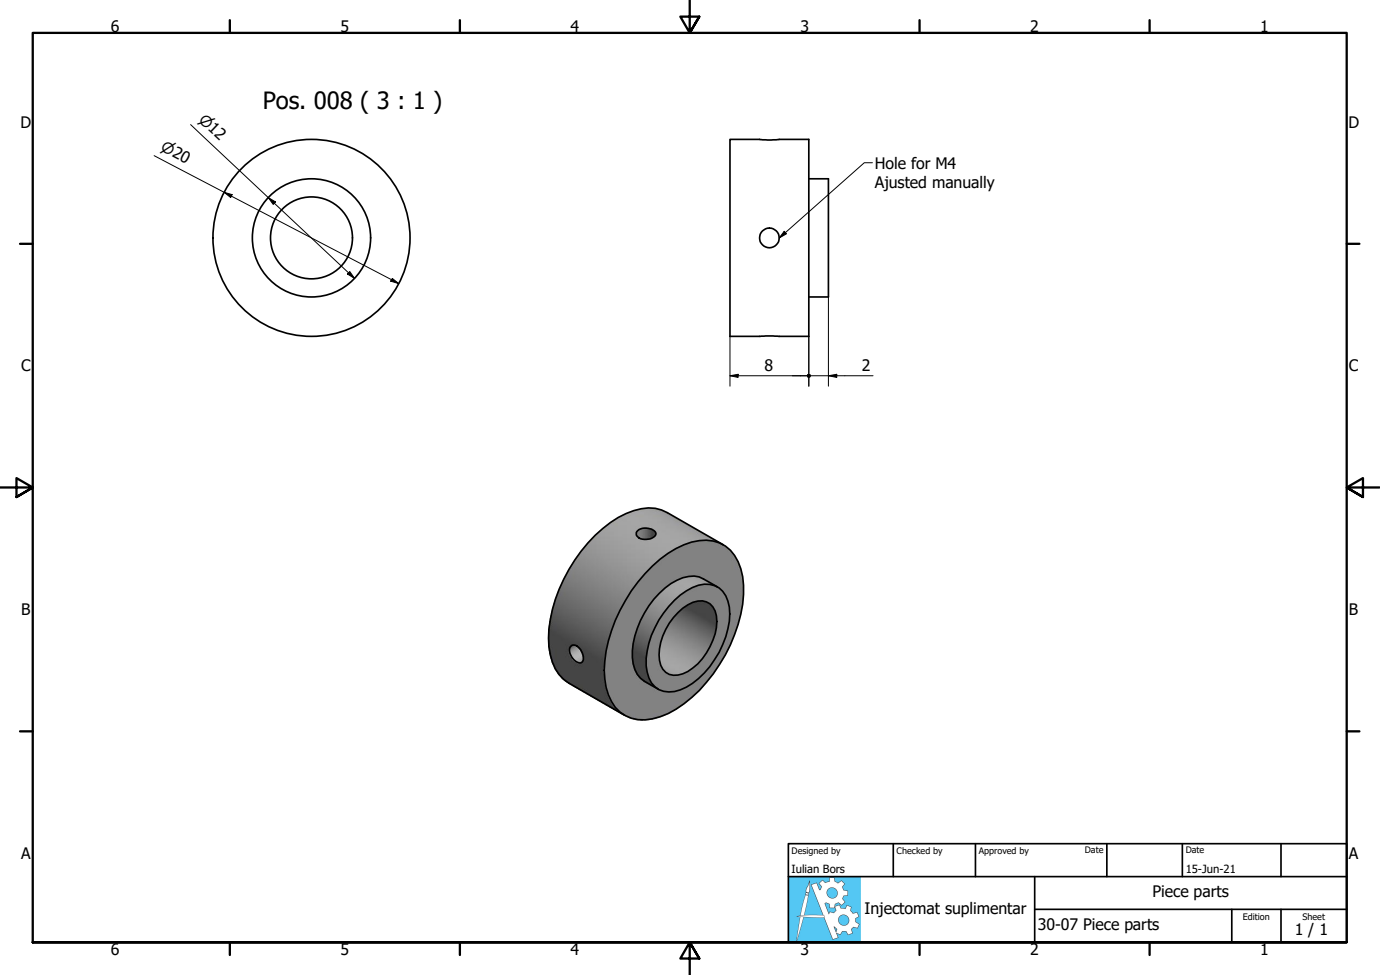
[picture p186: page 1]
Pos. 008 ( 3 : 1 ); Hole for M4 Ajusted manually

Designed by Iulian Bors | Checked by | Approved by Date | Date 15-Jun-21

Injectomat suplimentar | Piece parts

30-07 Piece parts | Edition | Sheet 1 / 1
