TactileImages/TactilePrinterOne-P4/Imprimanta 2 Metal A3/30 Injectomat/Drawings/30-14 Piece parts.pdf

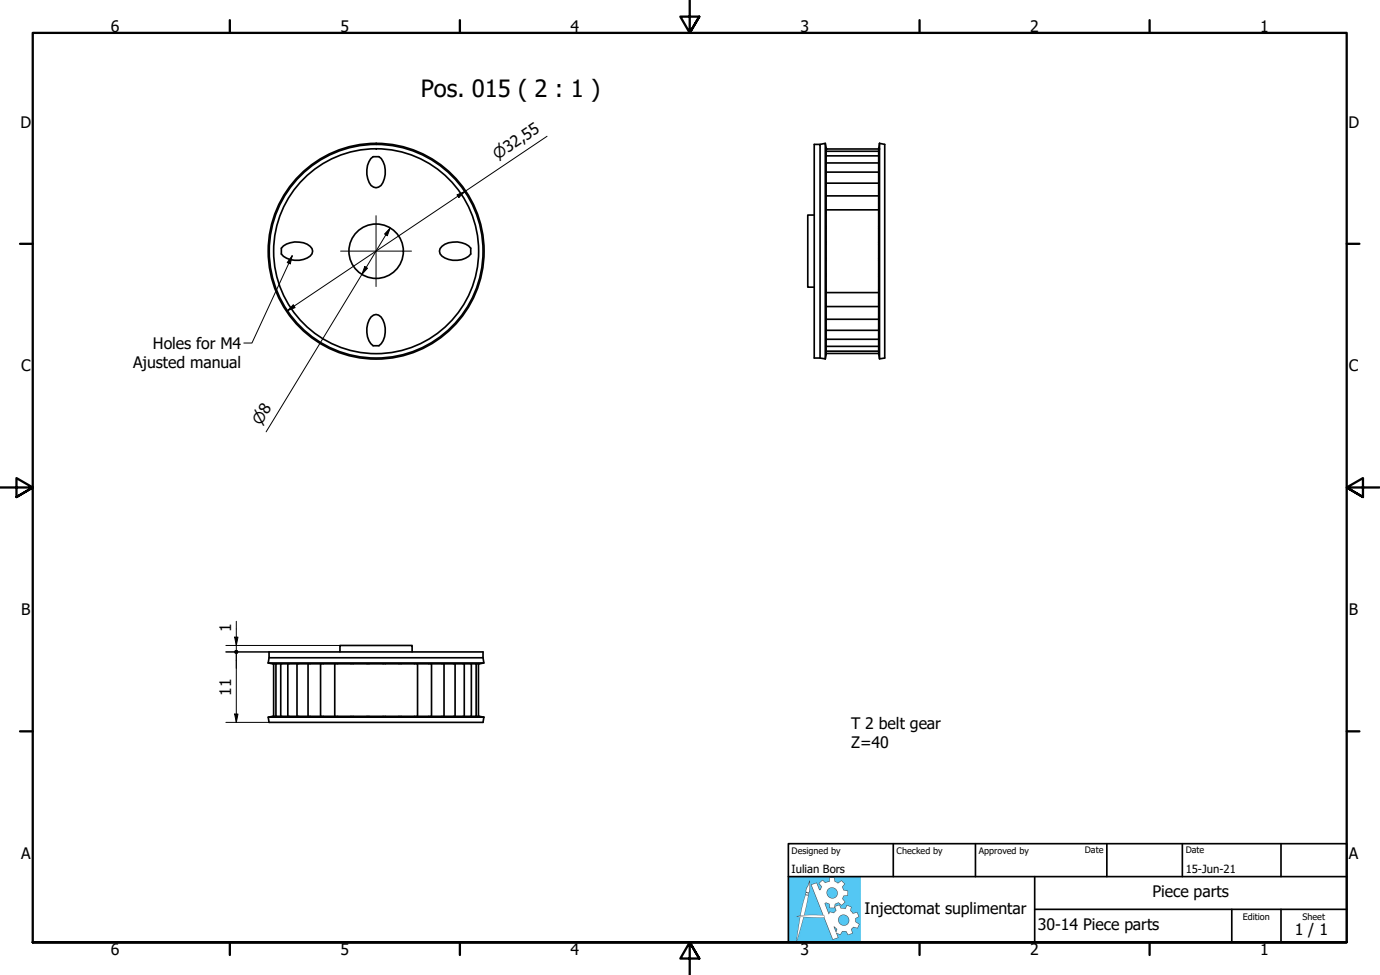
[picture p187: page 1]
Pos. 015 ( 2 : 1 ); Holes for M4 Ajusted manual; T 2 belt gear

Designed by Iulian Bors | Checked by | Approved by Date | Date 15-Jun-21

Injectomat suplimentar | Piece parts

30-14 Piece parts | Edition | Sheet 1 / 1
