TactileImages/TactilePrinterOne-P4/Imprimanta_1_Lemn/Drawings/0005-00-00 Ansamblu General.pdf

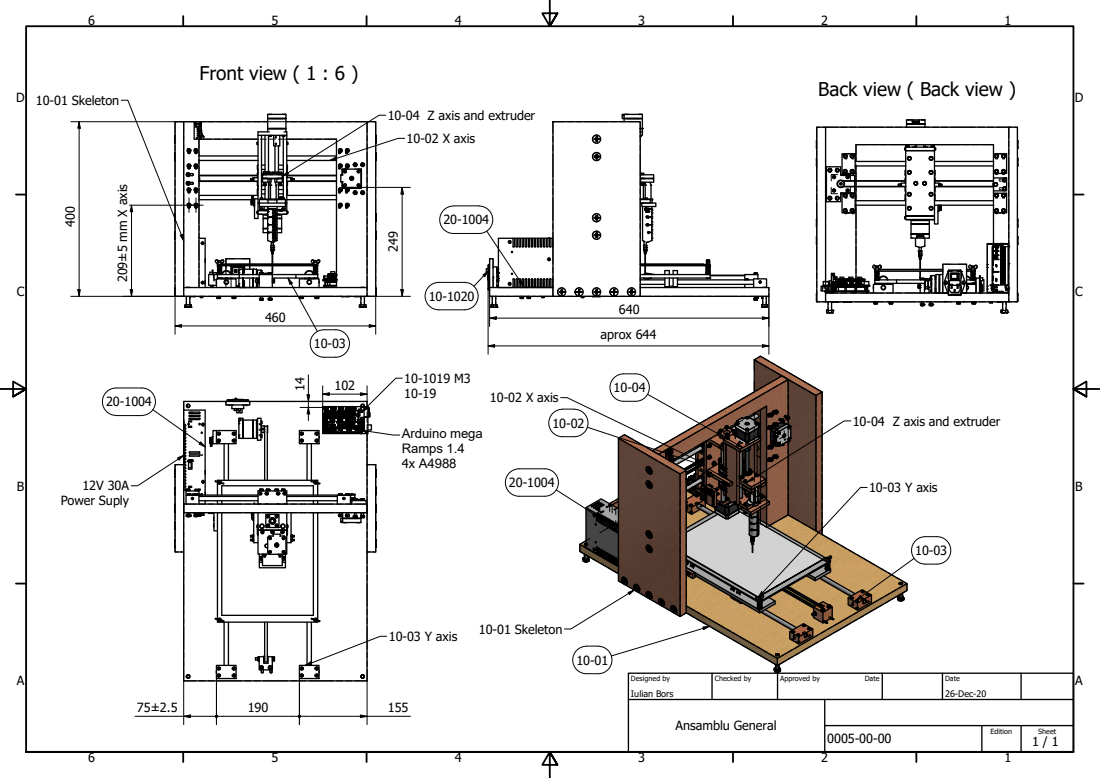
[picture p188: page 1]
Front view ( 1 : 6 ); Ansamblu General; Iulian Bors; 26-Dec-20; Designed by; Checked by; Approved by; Date; aprox 644; 10-01 Skeleton; 10-03 Y axis; Arduino mega Ramps 1.4 4x A4988; 12V 30A Power Suply; 10-02 X axis

Back view ( Back view )

10-04 Z axis and extruder
10-02 X axis
