TactileImages/TactilePrinterOne-P4/Imprimanta_1_Lemn/Drawings/0005-00-01.pdf

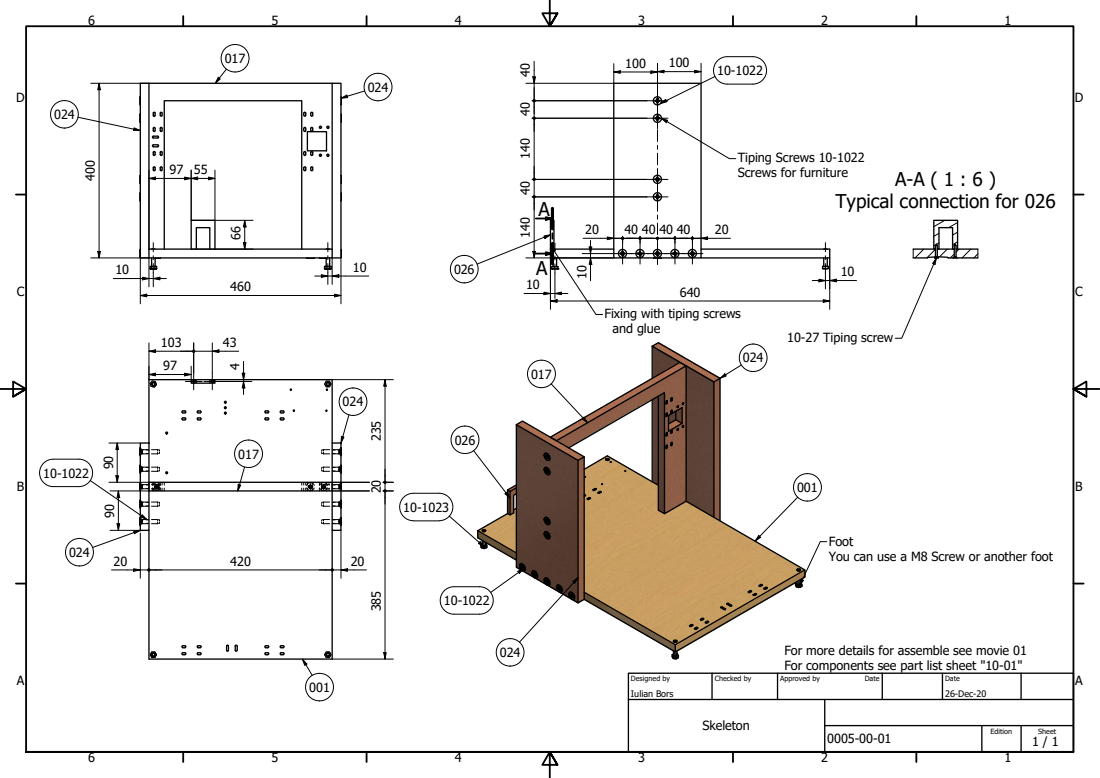
[picture p189: page 1]
10-27 Tiping screw

Tiping Screws 10-1022
Screws for furniture

Typical connection for 026

Fixing with tiping screws
and glue

Foot
You can use a M8 Screw or another foot

For more details for assemble see movie 01
For components see part list sheet "10-01"

Designed by Iulian Bors | Checked by | Approved by Date | Date 26-Dec-20

Skeleton

0005-00-01 | Edition | Sheet 1 / 1
