TactileImages/TactilePrinterOne-P4/Imprimanta_1_Lemn/Drawings/0005-00-02.pdf

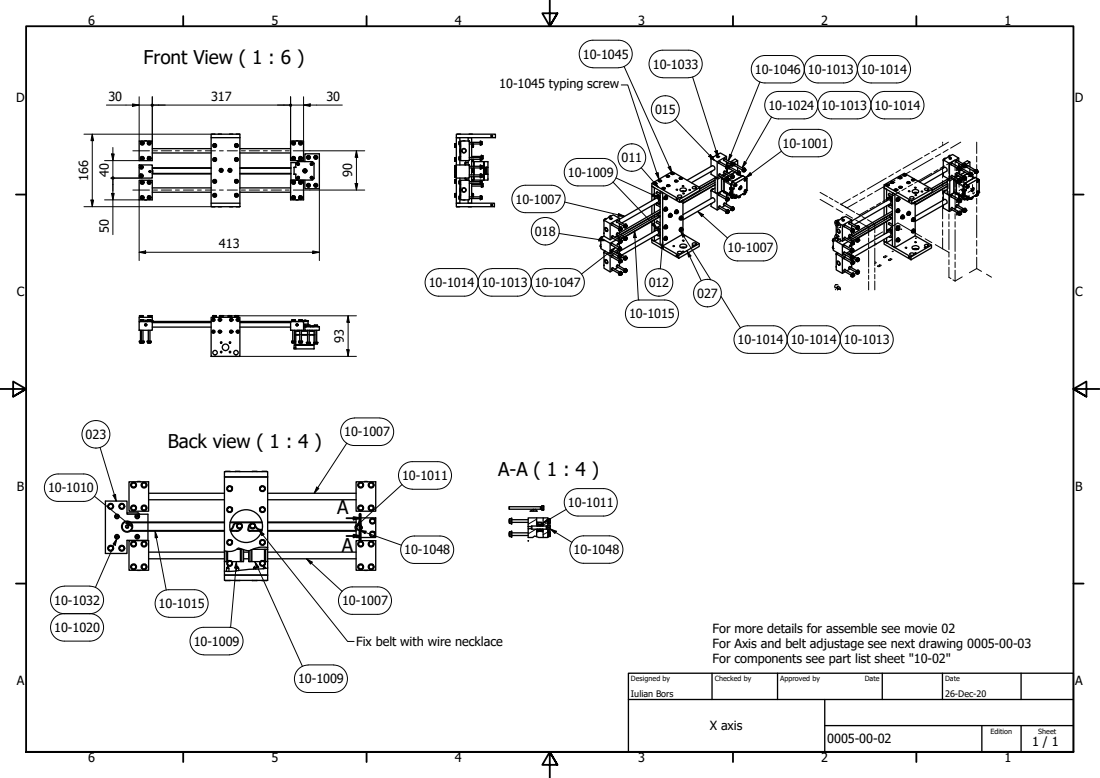
[picture p190: page 1]
Front View ( 1 : 6 ); Back view ( 1 : 4 ); X axis; Iulian Bors; 26-Dec-20; Designed by; Checked by; Approved by; Date; 10-1045 typing screw

For more details for assemble see movie 02
For Axis and belt adjustage see next drawing 0005-00-03
For components see part list sheet "10-02"

Fix belt with wire necklace
