TactileImages/TactilePrinterOne-P4/Imprimanta_1_Lemn/Drawings/0005-00-03.pdf

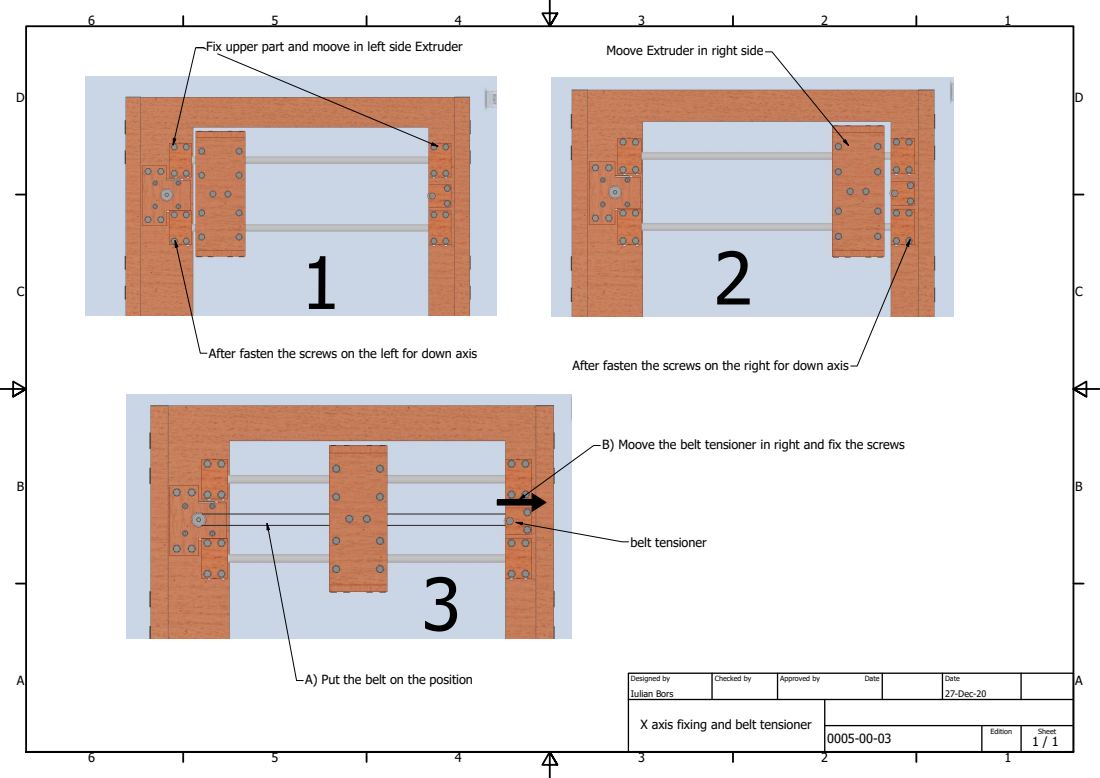
[picture p191: page 1]
belt tensioner

Fix upper part and moove in left side Extruder

Moove Extruder in right side

After fasten the screws on the left for down axis

After fasten the screws on the right for down axis

B) Moove the belt tensioner in right and fix the screws

A) Put the belt on the position

Designed by Iulian Bors | Checked by | Approved by Date | Date 27-Dec-20

X axis fixing and belt tensioner

0005-00-03 | Edition | Sheet 1 / 1
