TactileImages/TactilePrinterOne-P4/Imprimanta_1_Lemn/Drawings/0005-00-04.pdf

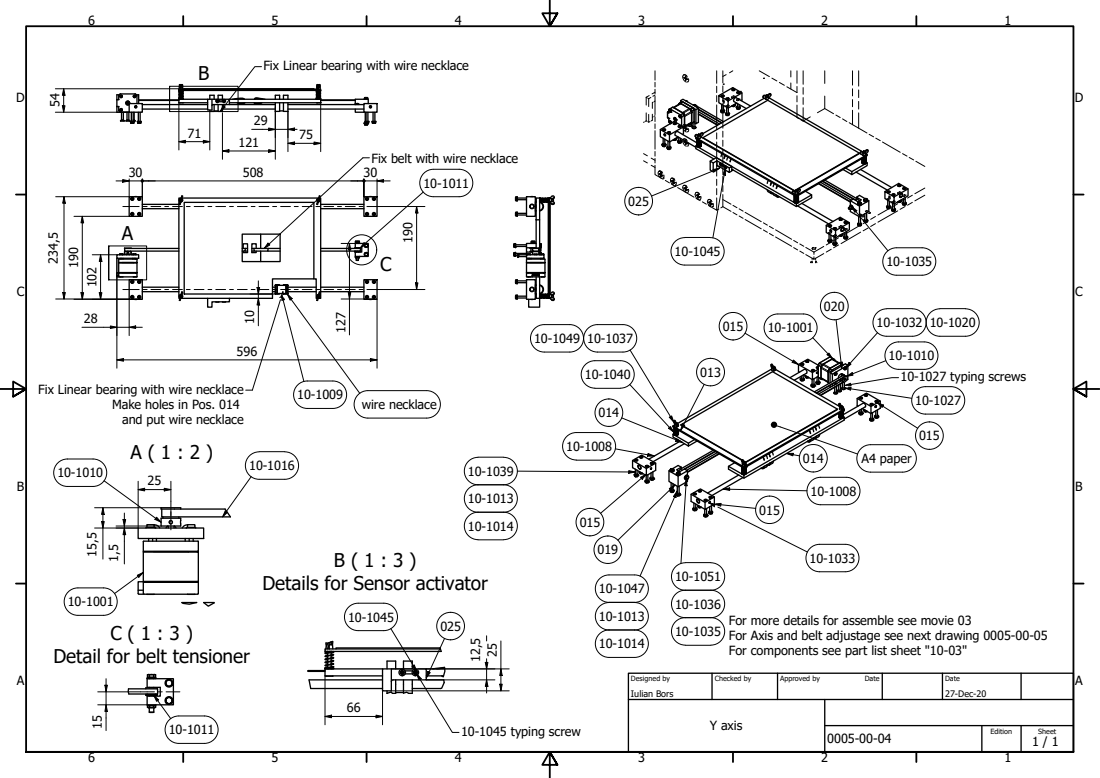
[picture p192: page 1]
A4 paper; 10-1045 typing screw; 10-1027 typing screws; wire necklace

Fix Linear bearing with wire necklace

29 121 | 75
71

Fix belt with wire necklace

Make holes in Pos. 014
and put wire necklace

Details for Sensor activator

For more details for assemble see movie 03
For Axis and belt adjustage see next drawing 0005-00-05
For components see part list sheet "10-03"

Detail for belt tensioner

Designed by Iulian Bors | Checked by | Approved by Date | Date 27-Dec-20

Y axis

0005-00-04 | Edition | Sheet 1 / 1
