TactileImages/TactilePrinterOne-P4/Imprimanta_1_Lemn/Drawings/0005-00-05.pdf

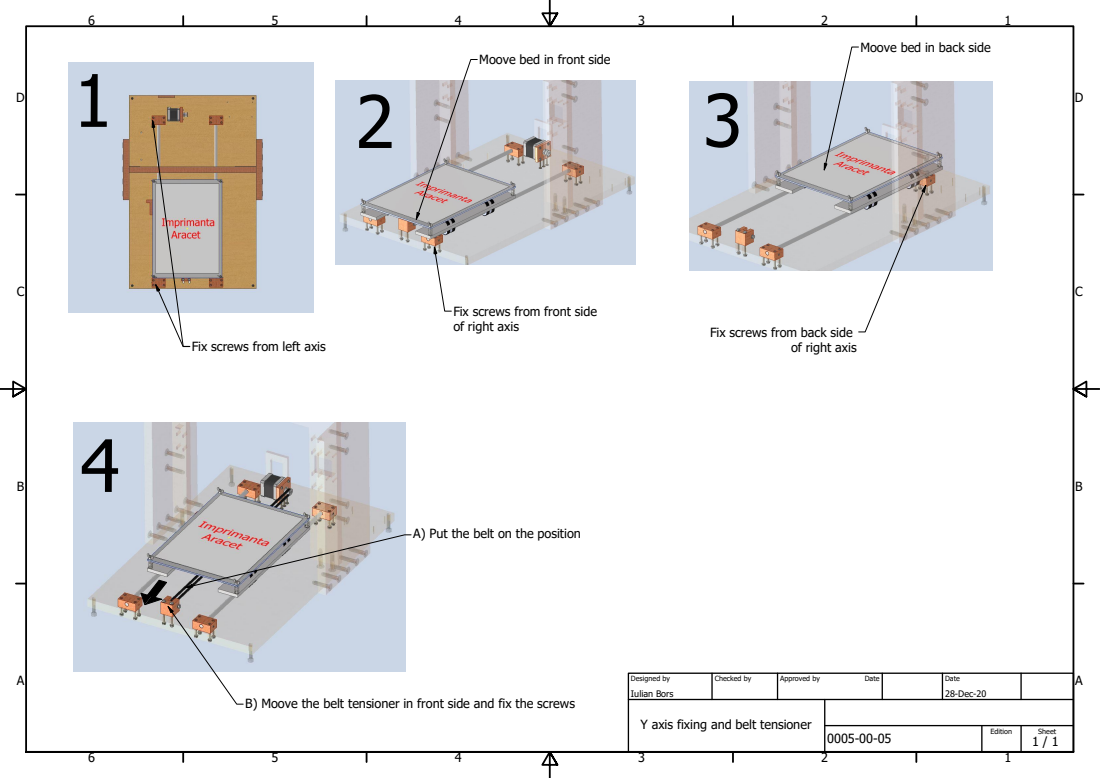
[picture p193: page 1]

Moove bed in back side

Moove bed in front side

Fix screws from front side
of right axis

Fix screws from back side

Fix screws from left axis

A) Put the belt on the position

Designed by Iulian Bors | Checked by | Approved by Date | Date 28-Dec-20

B) Moove the belt tensioner in front side and fix the screws

Y axis fixing and belt tensioner

0005-00-05 | Edition | Sheet 1 / 1
