TactileImages/TactilePrinterOne-P4/Imprimanta_1_Lemn/Drawings/0005-00-06.pdf

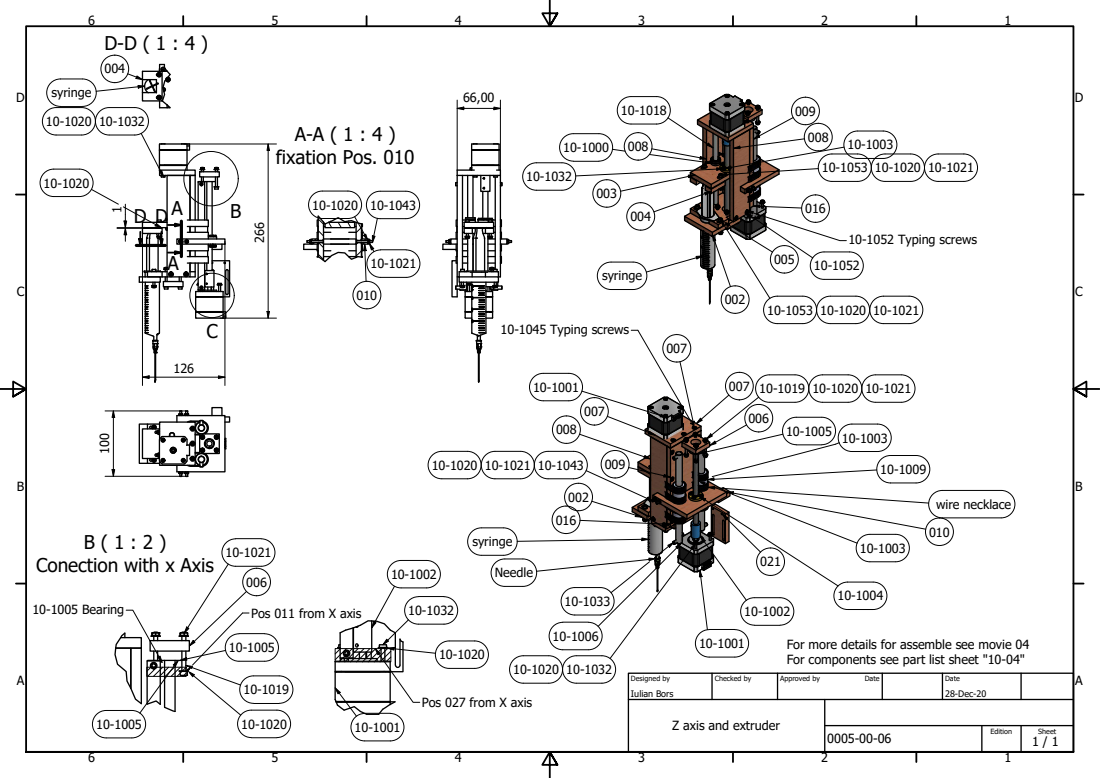
[picture p194: page 1]
A-A ( 1 : 4 ) fixation Pos. 010; wire necklace; 10-1045 Typing screws; 10-1052 Typing screws; 10-1005 Bearing

Conection with x Axis

Pos 011 from X axis

For more details for assemble see movie 04
For components see part list sheet "10-04"

Designed by Iulian Bors | Checked by | Approved by Date | Date 28-Dec-20

Pos 027 from X axis

Z axis and extruder

0005-00-06 | Edition | Sheet 1 / 1
