TactileImages/TactilePrinterOne-P4/Imprimanta_1_Lemn/Drawings/0005-20-00 Electric 1.pdf

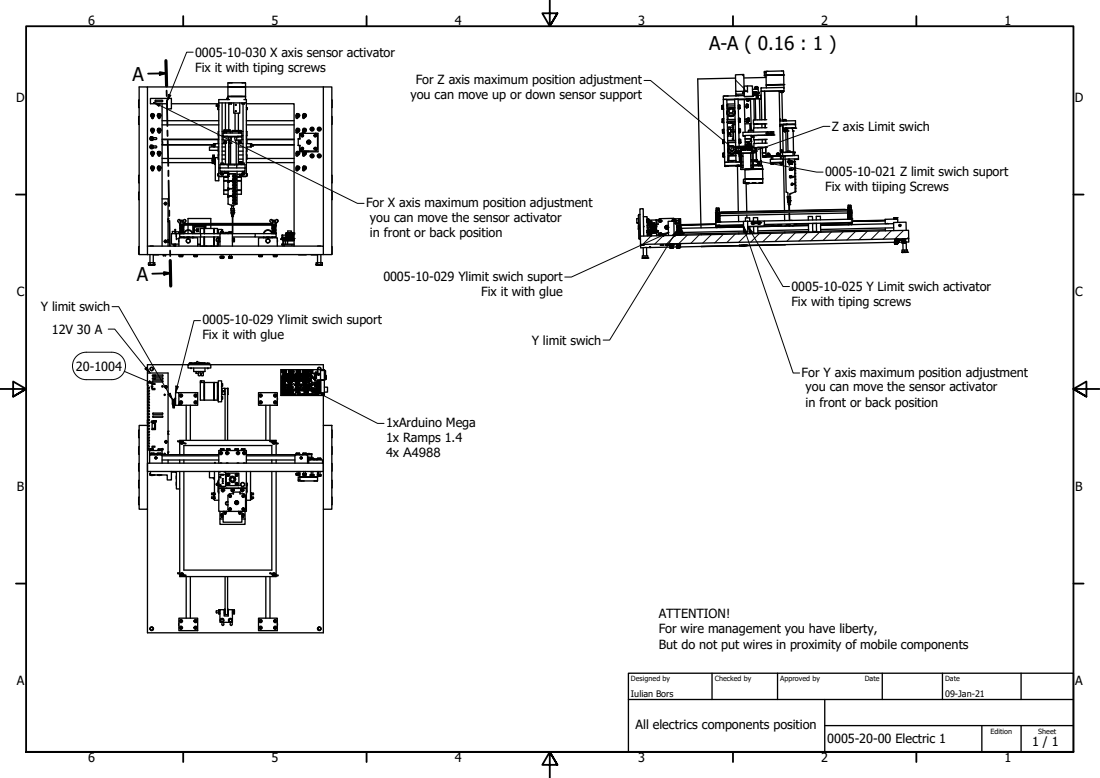
[picture p195: page 1]
0005-20-00 Electric 1; Iulian Bors; 09-Jan-21; Designed by; Checked by; Approved by; Date; 1xArduino Mega 1x Ramps 1.4 4x A4988; Y limit swich

0005-10-030 X axis sensor activator
Fix it with tiping screws

For Z axis maximum position adjustment
you can move up or down sensor support

Z axis Limit swich

0005-10-021 Z limit swich suport
Fix with tiiping Screws

For X axis maximum position adjustment
you can move the sensor activator
in front or back position

0005-10-029 Ylimit swich suport

0005-10-025 Y Limit swich activator
Fix with tiping screws

Fix it with glue

For Y axis maximum position adjustment

ATTENTION!
For wire management you have liberty,
But do not put wires in proximity of mobile components

All electrics components position
