TactileImages/TactilePrinterOne-P4/Imprimanta_1_Lemn/Drawings/0005-20-01 Electric 2.pdf

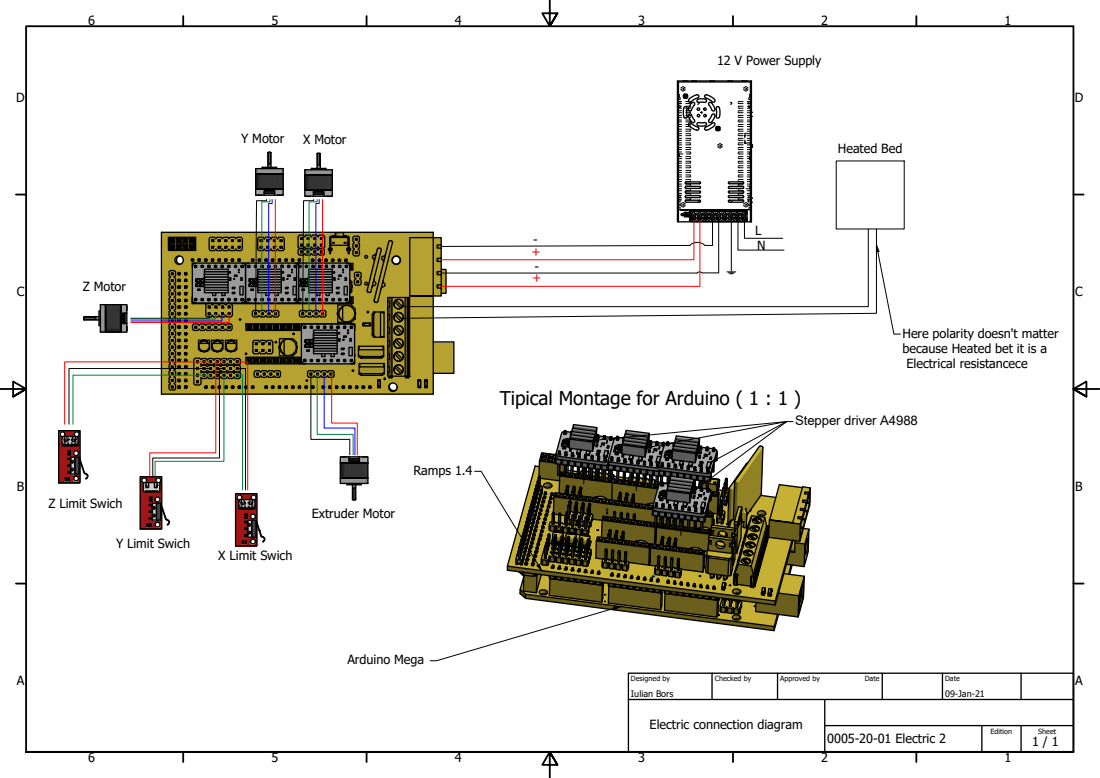
[picture p196: page 1]
0005-20-01 Electric 2; Iulian Bors; 09-Jan-21; Designed by; Checked by; Approved by; Date; 12 V Power Supply; Z Motor; Y Motor; X Motor; Extruder Motor; X Limit Swich; Y Limit Swich; Z Limit Swich; Arduino Mega; Ramps 1.4; Stepper driver A4988; Heated Bed

Here polarity doesn't matter
because Heated bet it is a
Electrical resistancece

Tipical Montage for Arduino ( 1 : 1 )

Electric connection diagram
