TactileImages/TactilePrinterOne-P4/Imprimanta 2 Metal A3/Drawings/0008-10-003.pdf

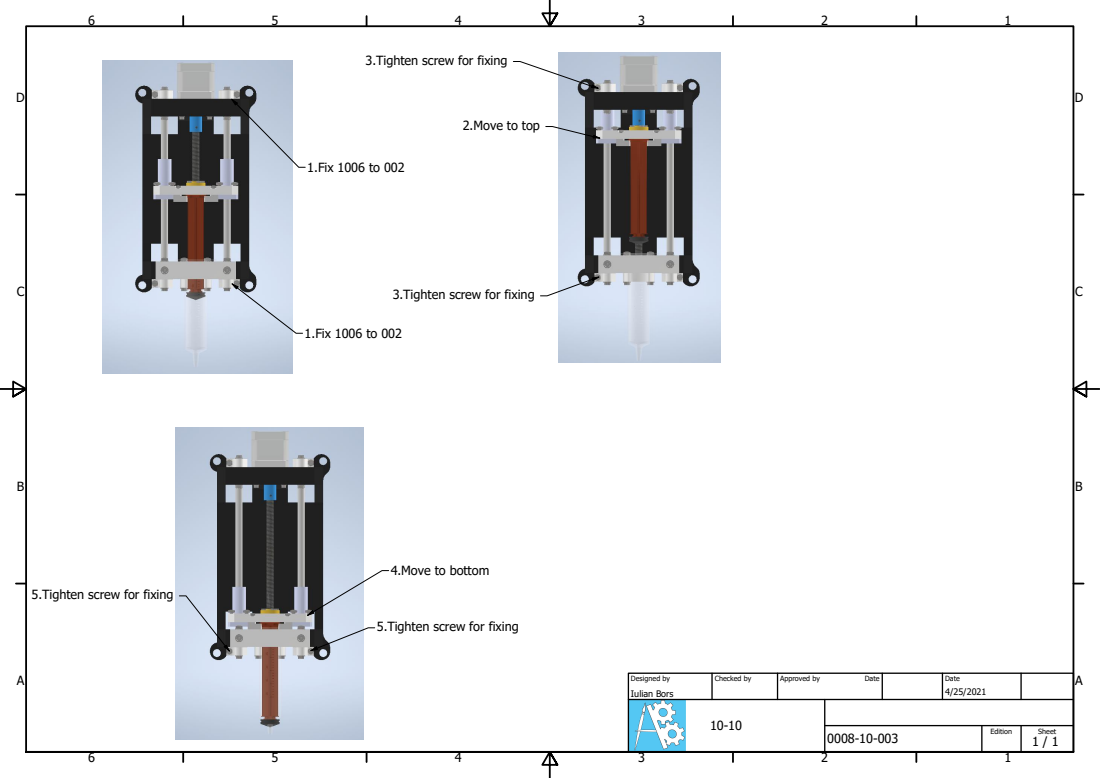
[picture p197: page 1]
1.Fix 1006 to 002

3.Tighten screw for fixing

2.Move to top

4.Move to bottom

5.Tighten screw for fixing

Designed by Iulian Bors | Checked by | Approved by Date | Date 4/25/2021

0008-10-003 | Edition | Sheet 1 / 1
