TactileImages/TactilePrinterOne-P4/Imprimanta 2 Metal A3/Drawings/0008-10-004.pdf

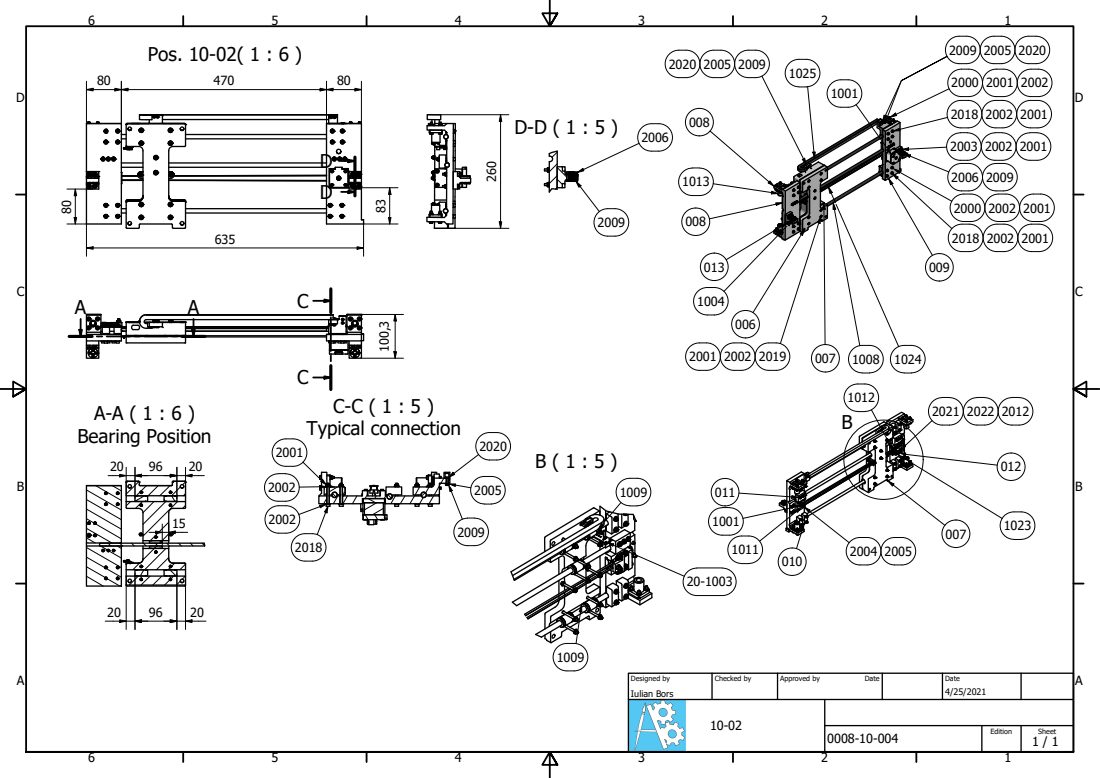
[picture p198: page 1]
Pos. 10-02( 1 : 6 ); A-A ( 1 : 6 ) Bearing Position; C-C ( 1 : 5 ) Typical connection; Iulian Bors; Designed by; Checked by; Approved by; Date
