TactileImages/TactilePrinterOne-P4/Imprimanta 2 Metal A3/Drawings/0008-10-005.pdf

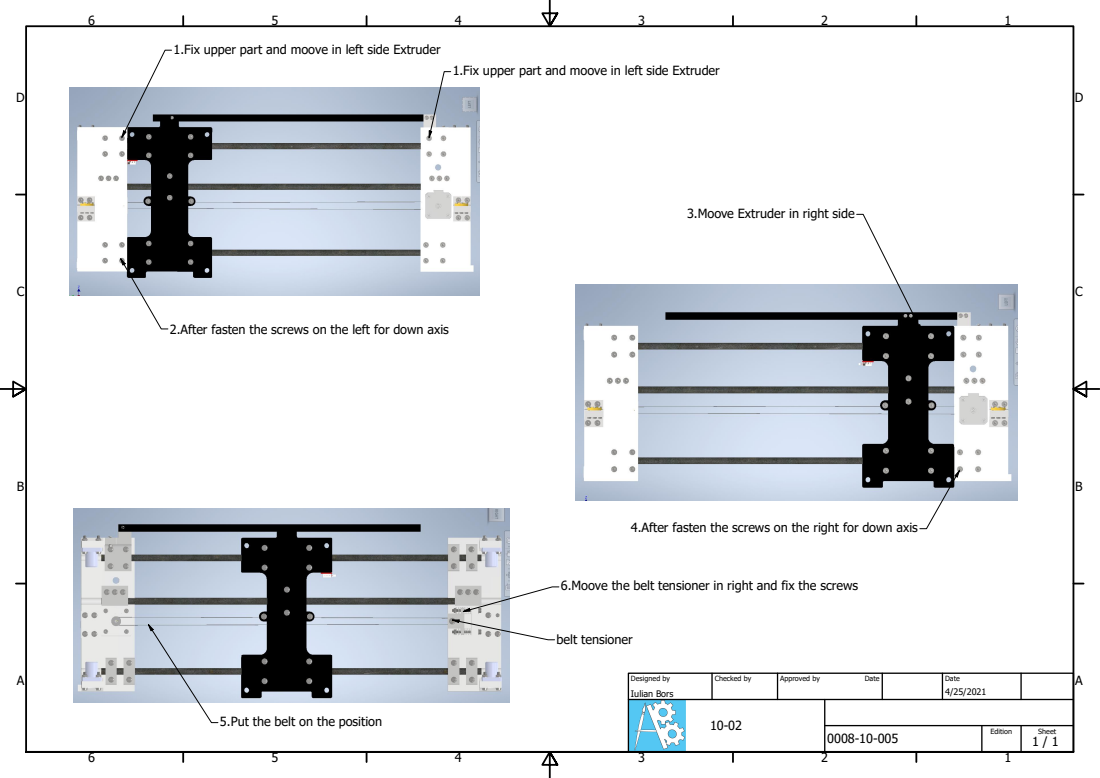
[picture p199: page 1]
belt tensioner

1.Fix upper part and moove in left side Extruder

3.Moove Extruder in right side

2.After fasten the screws on the left for down axis

4.After fasten the screws on the right for down axis

6.Moove the belt tensioner in right and fix the screws

Designed by Iulian Bors | Checked by | Approved by Date | Date 4/25/2021

5.Put the belt on the position

0008-10-005 | Edition | Sheet 1 / 1
