TactileImages/TactilePrinterOne-P4/Imprimanta 2 Metal A3/Drawings/0008-10-006.pdf

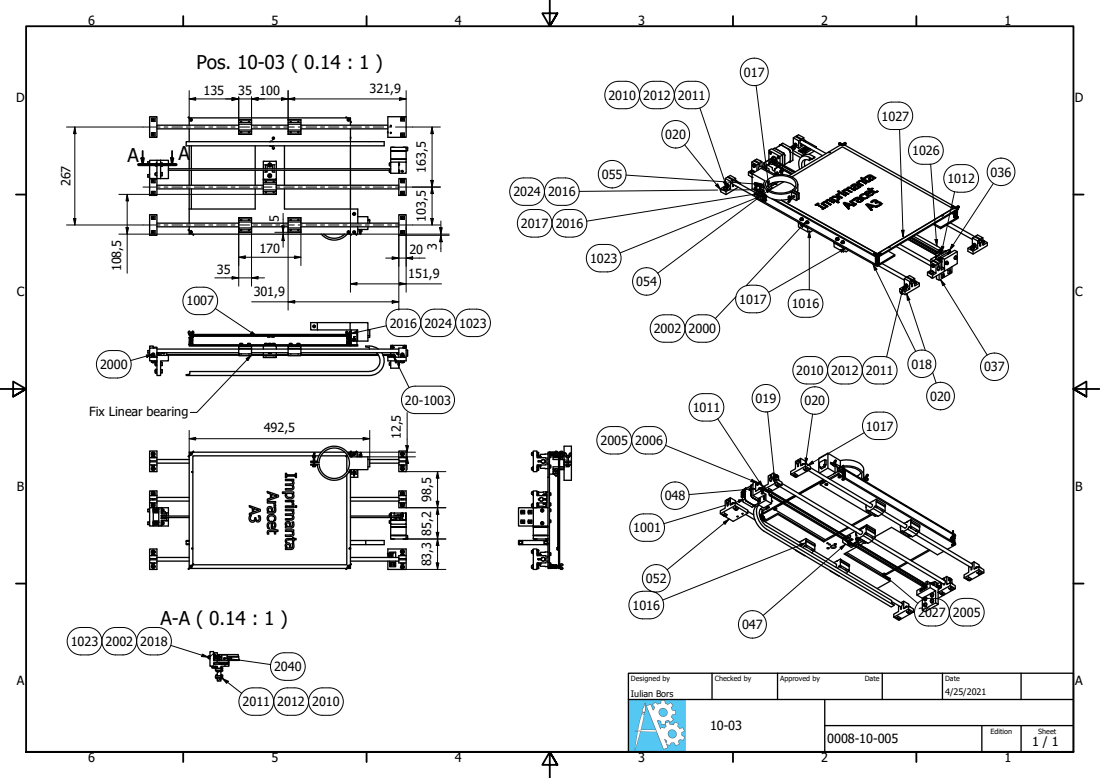
[picture p200: page 1]
Pos. 10-03 ( 0.14 : 1 ); Iulian Bors; Designed by; Checked by; Approved by; Date

Fix Linear bearing
