TactileImages/TactilePrinterOne-P4/Imprimanta 2 Metal A3/Drawings/0008-10-007.pdf

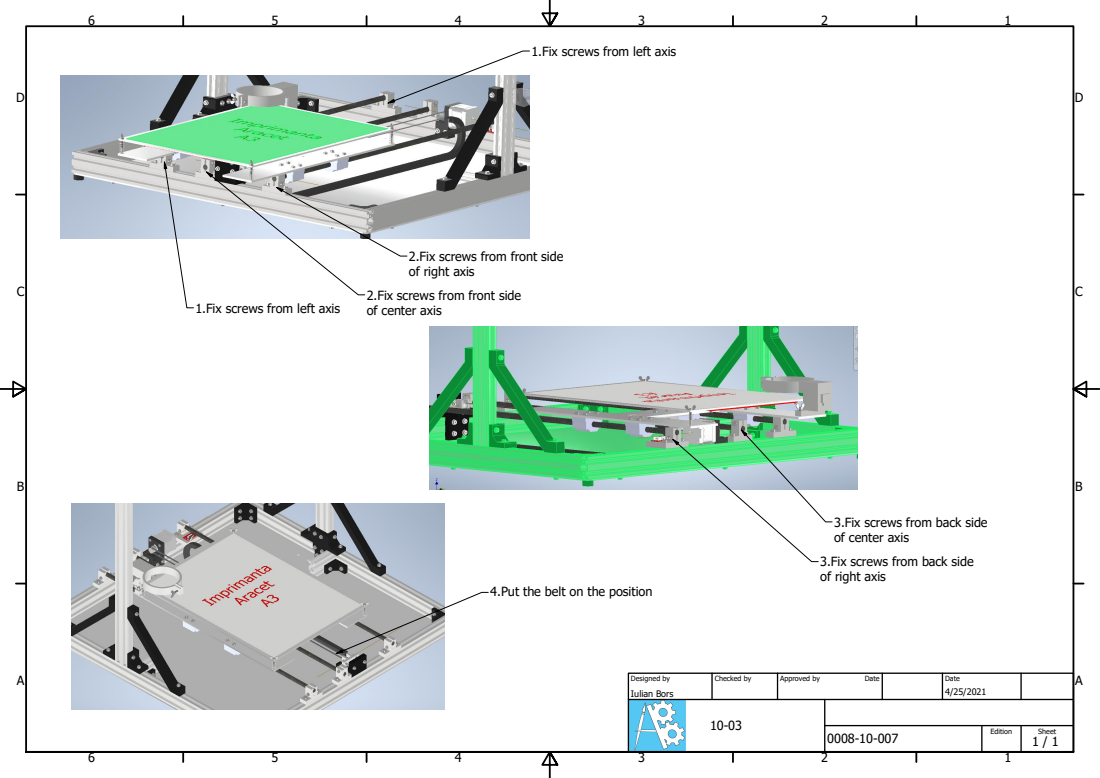
[picture p201: page 1]

1.Fix screws from left axis

2.Fix screws from front side
of right axis

of center axis

3.Fix screws from back side

4.Put the belt on the position

Designed by Iulian Bors | Checked by | Approved by Date | Date 4/25/2021

0008-10-007 | Edition | Sheet 1 / 1
