TactileImages/TactilePrinterOne-P4/Imprimanta 2 Metal A3/Drawings/0008-10-01 I.A.B 2.1 Aracet_Subansamble.pdf

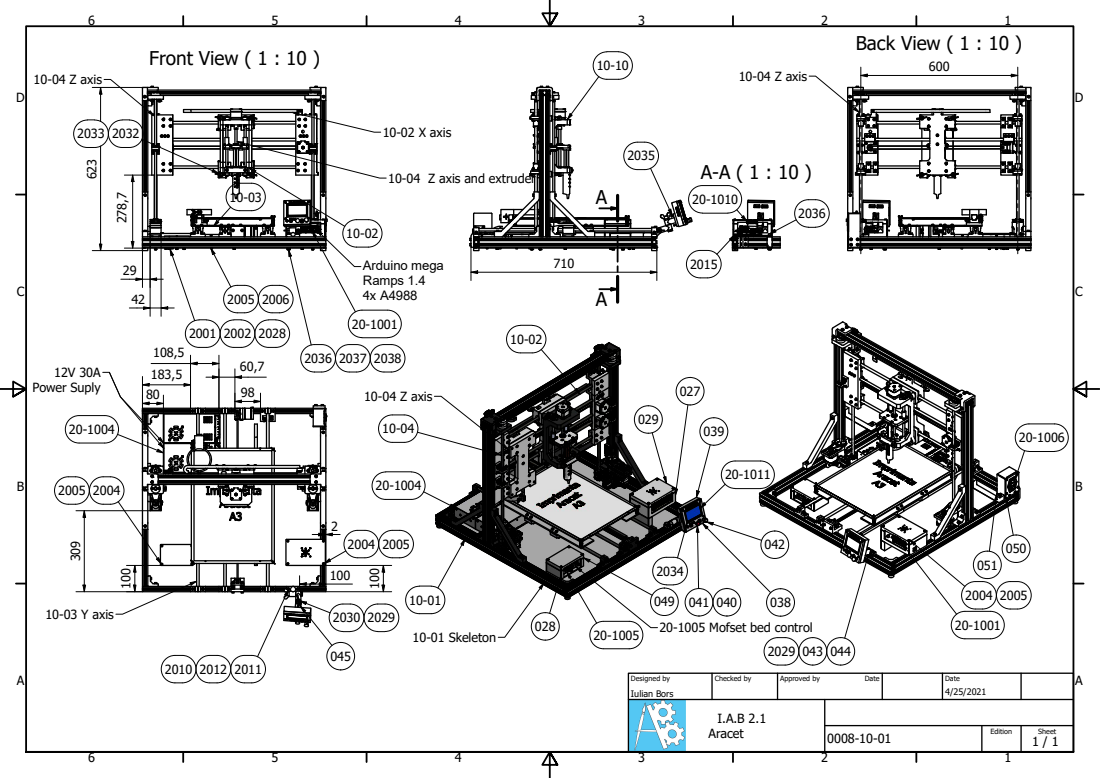
[picture p202: page 1]
Front View ( 1 : 10 ); Back View ( 1 : 10 ); Iulian Bors; Designed by; Checked by; Approved by; Date; 10-01 Skeleton; 10-04 Z axis; 12V 30A Power Suply; 10-03 Y axis; Arduino mega Ramps 1.4 4x A4988; 10-02 X axis

10-04 Z axis and extruder

20-1005 Mofset bed control
