TactileImages/TactilePrinterOne-P4/Imprimanta 2 Metal A3/30 Injectomat/Drawings/30-02 Piece parts.pdf

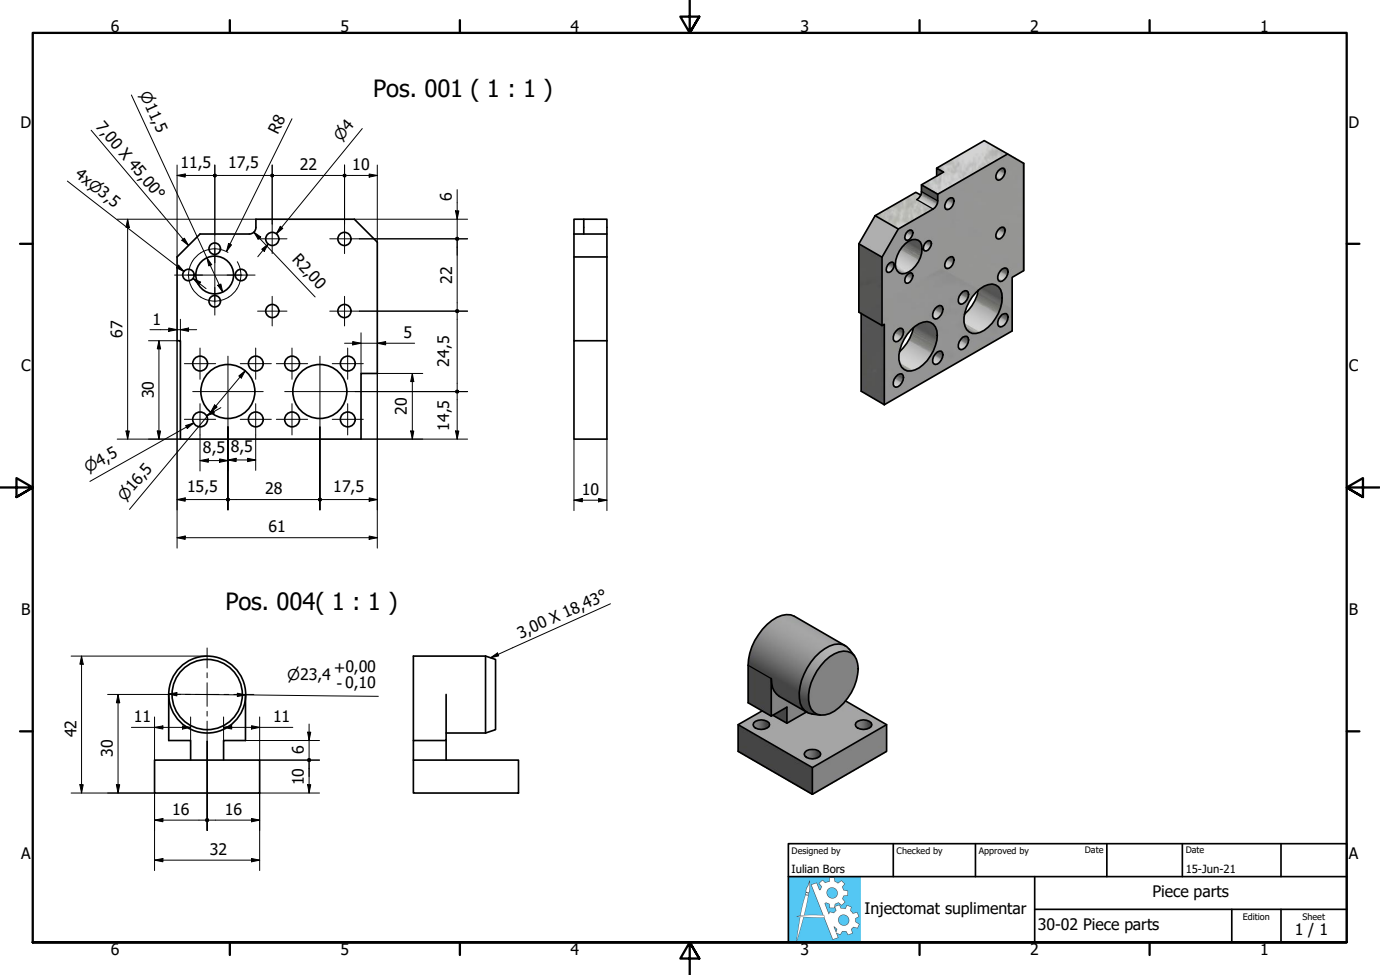
[picture p203: page 1]
Pos. 001 ( 1 : 1 ); Pos. 004( 1 : 1 )

Designed by Iulian Bors | Checked by | Approved by Date | Date 15-Jun-21

Injectomat suplimentar | Piece parts

30-02 Piece parts | Edition | Sheet 1 / 1
