TactileImages/TactilePrinterOne-P4/Imprimanta 2 Metal A3/30 Injectomat/Drawings/30-04 Piece parts.pdf

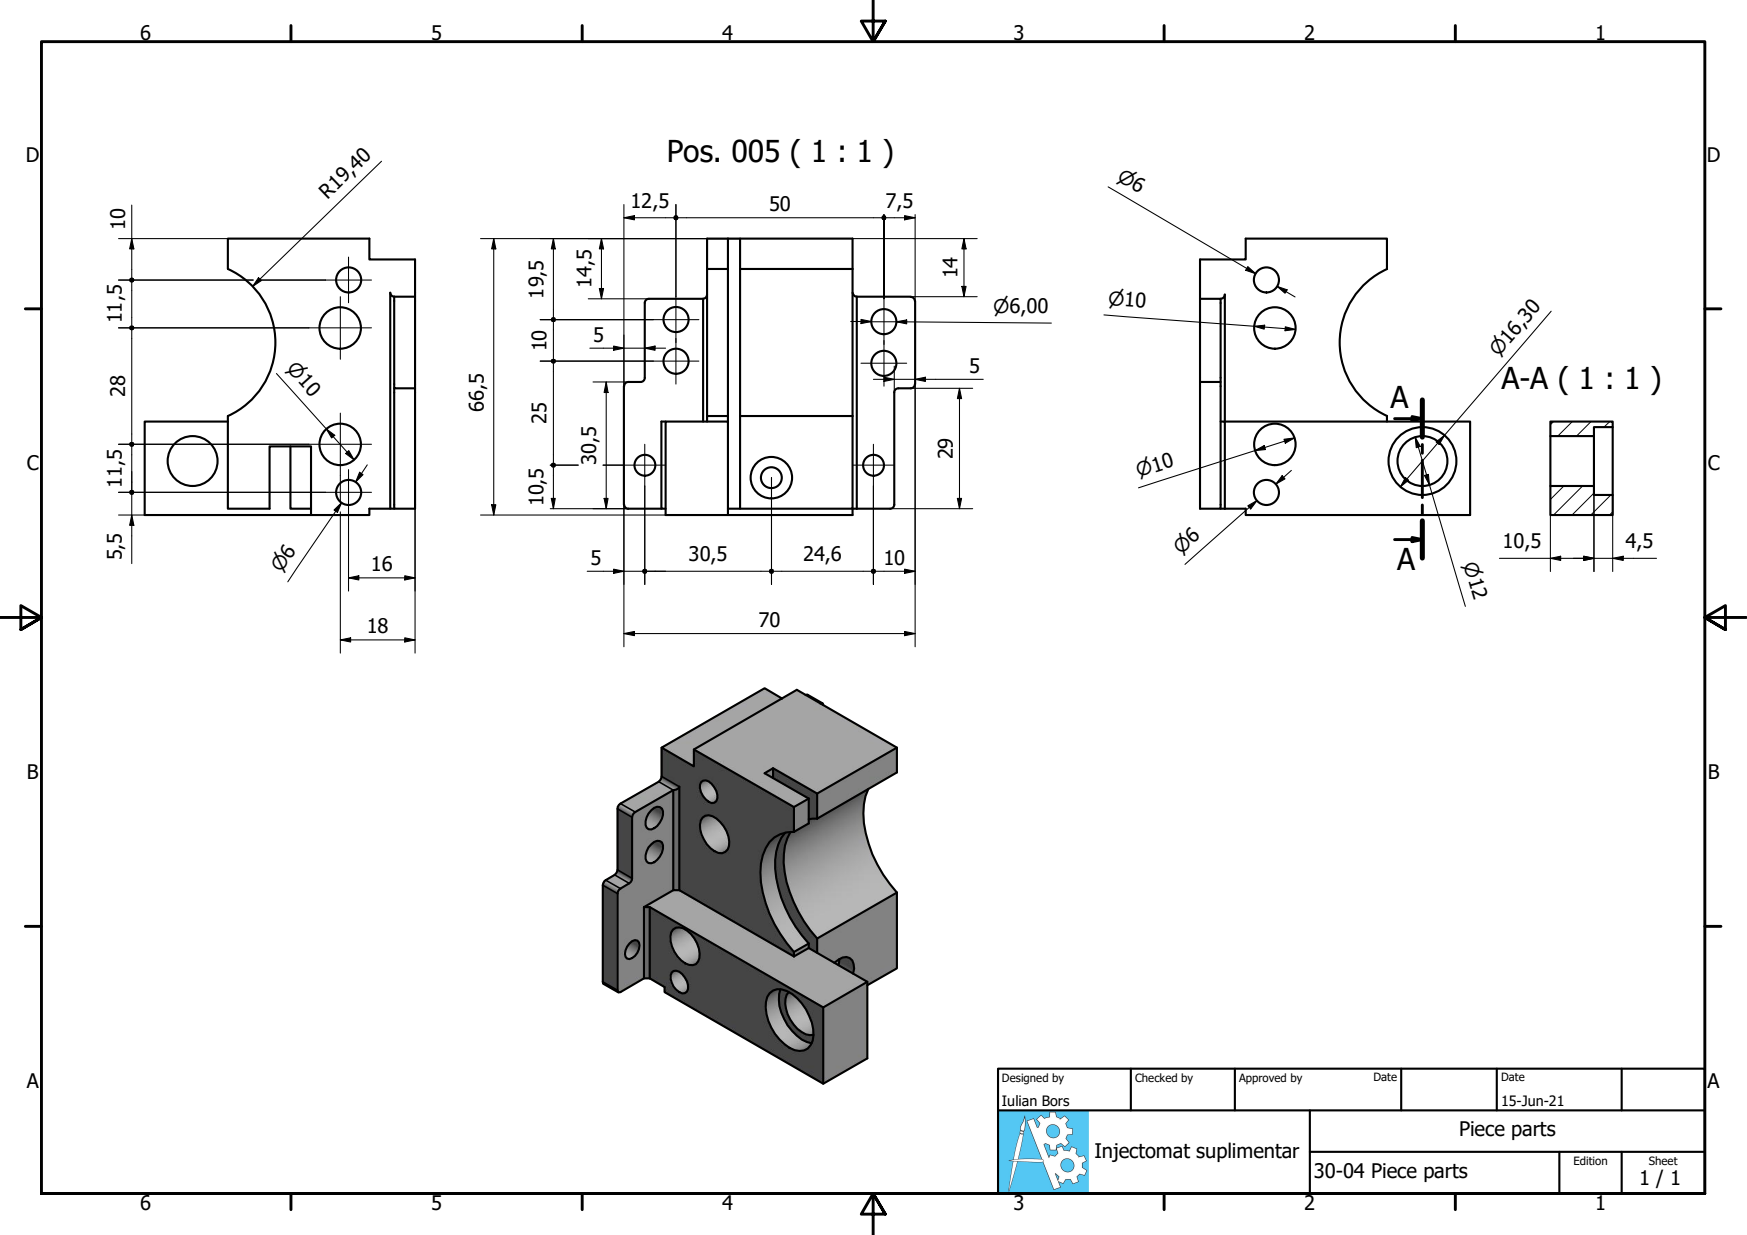
[picture p204: page 1]
Pos. 005 ( 1 : 1 )

Designed by Iulian Bors | Checked by | Approved by Date | Date 15-Jun-21

Injectomat suplimentar | Piece parts

30-04 Piece parts | Edition | Sheet 1 / 1
