TactileImages/TactilePrinterOne-P4/Imprimanta 2 Metal A3/30 Injectomat/Drawings/30-06 Piece parts.pdf

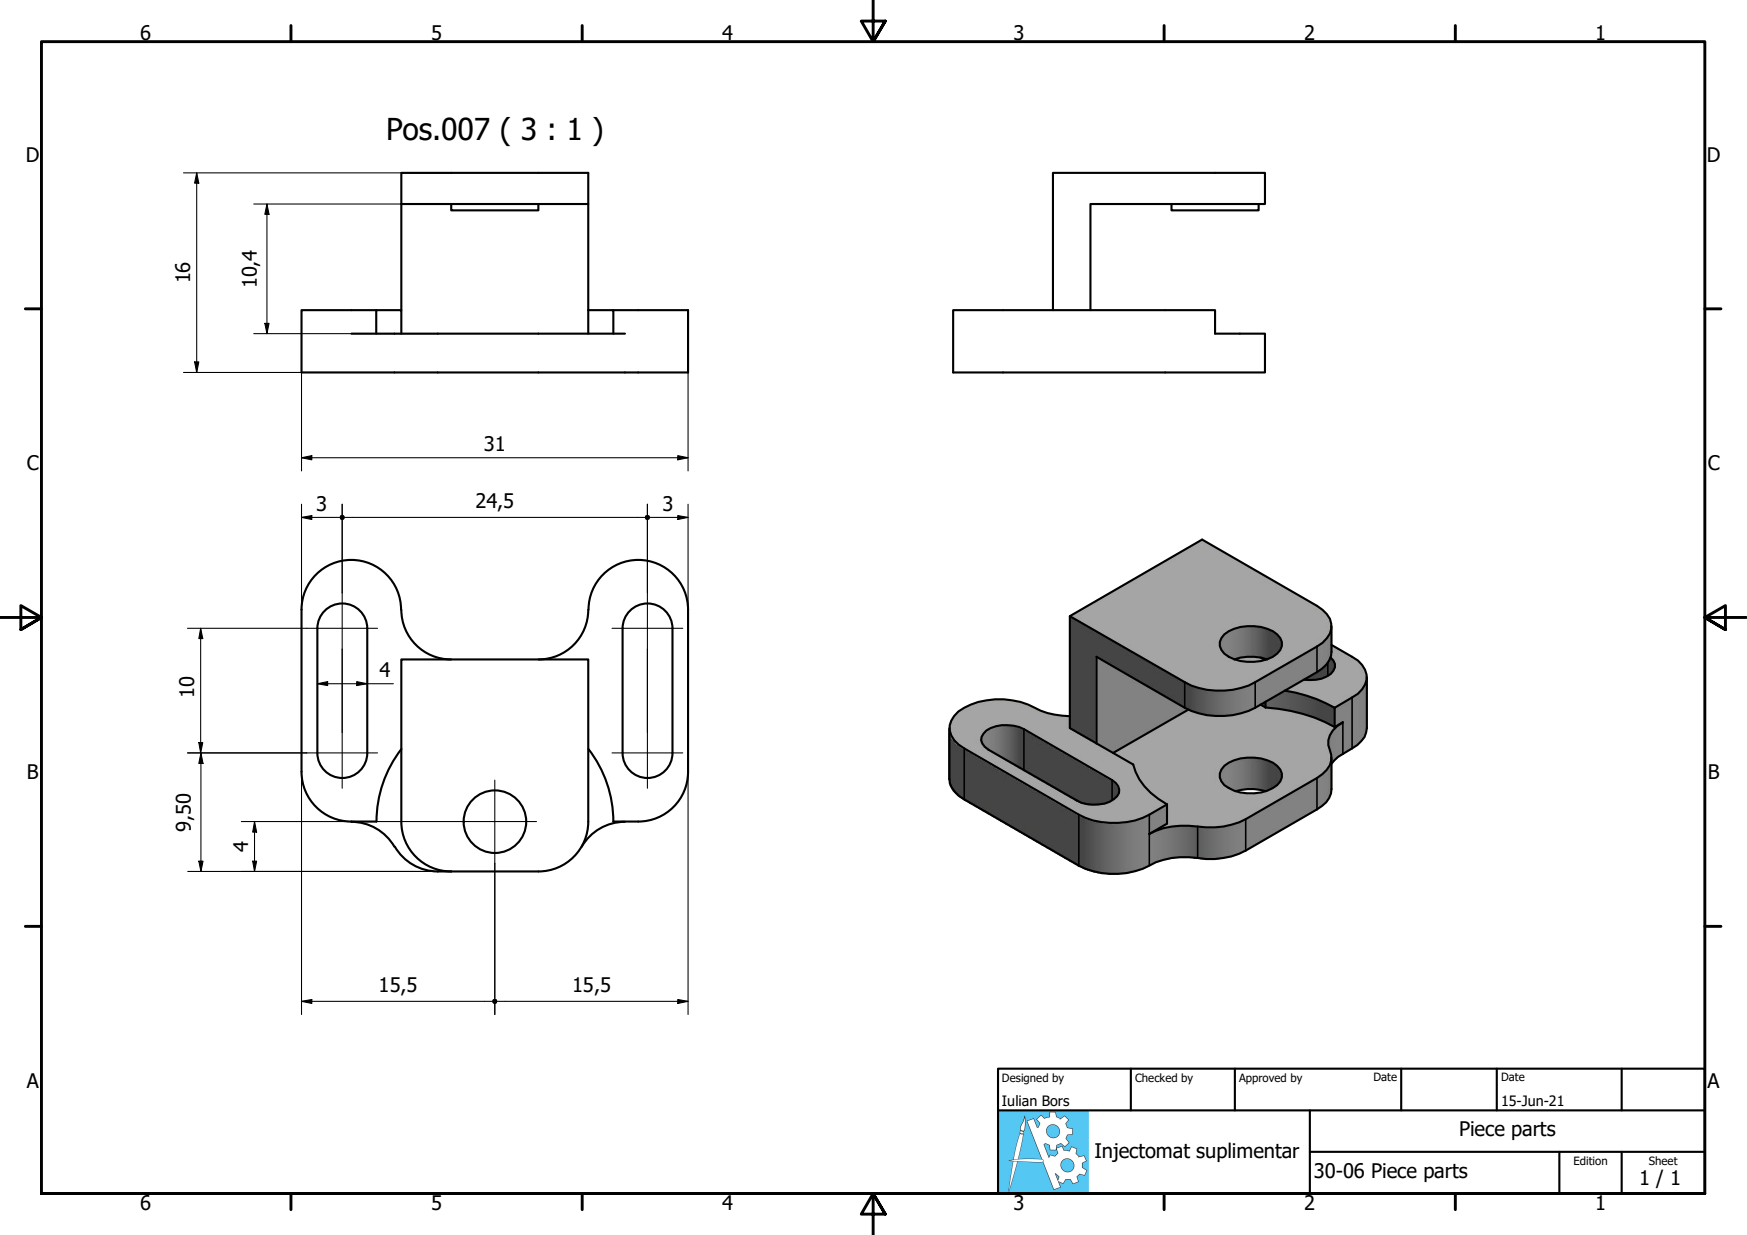
[picture p206: page 1]
Pos.007 ( 3 : 1 )

Designed by Iulian Bors | Checked by | Approved by Date | Date 15-Jun-21

Injectomat suplimentar | Piece parts

30-06 Piece parts | Edition | Sheet 1 / 1
