TactileImages/TactilePrinterOne-P4/Imprimanta 2 Metal A3/30 Injectomat/Drawings/30-15 Piece parts.pdf

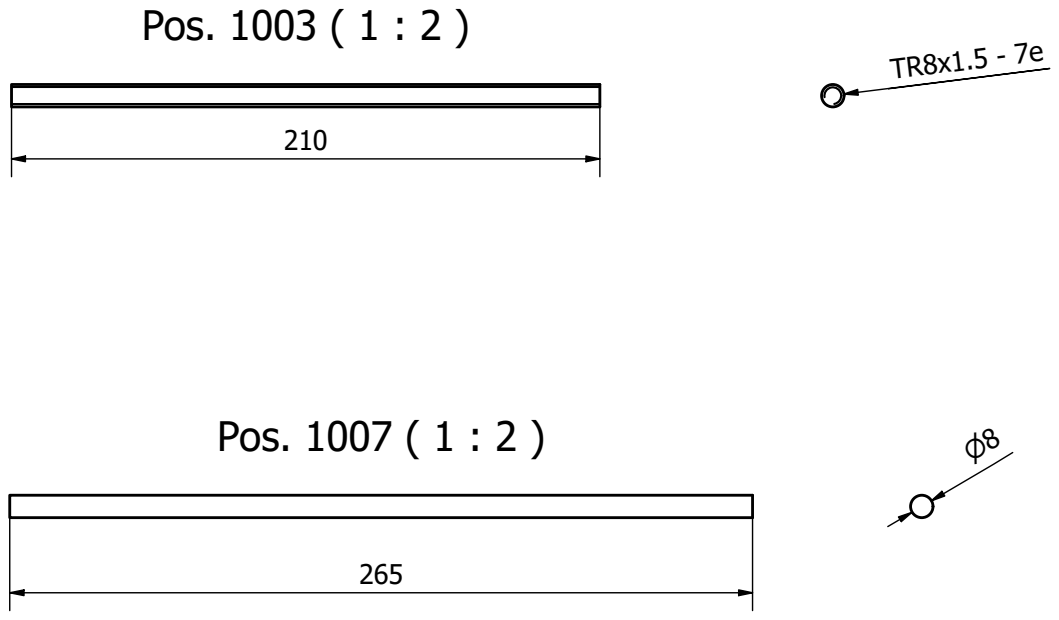
[picture p213: page 1]
Pos. 1003 ( 1 : 2 ); Pos. 1007 ( 1 : 2 )

Designed by Iulian Bors | Checked by | Approved by Date | Date 15-Jun-21

Injectomat suplimentar | Piece parts

30-15 Piece parts | Edition | Sheet 1 / 1
