TactileImages/TactilePrinterOne-P4/Imprimanta_1_Lemn/Drawings/0005-00-07.pdf

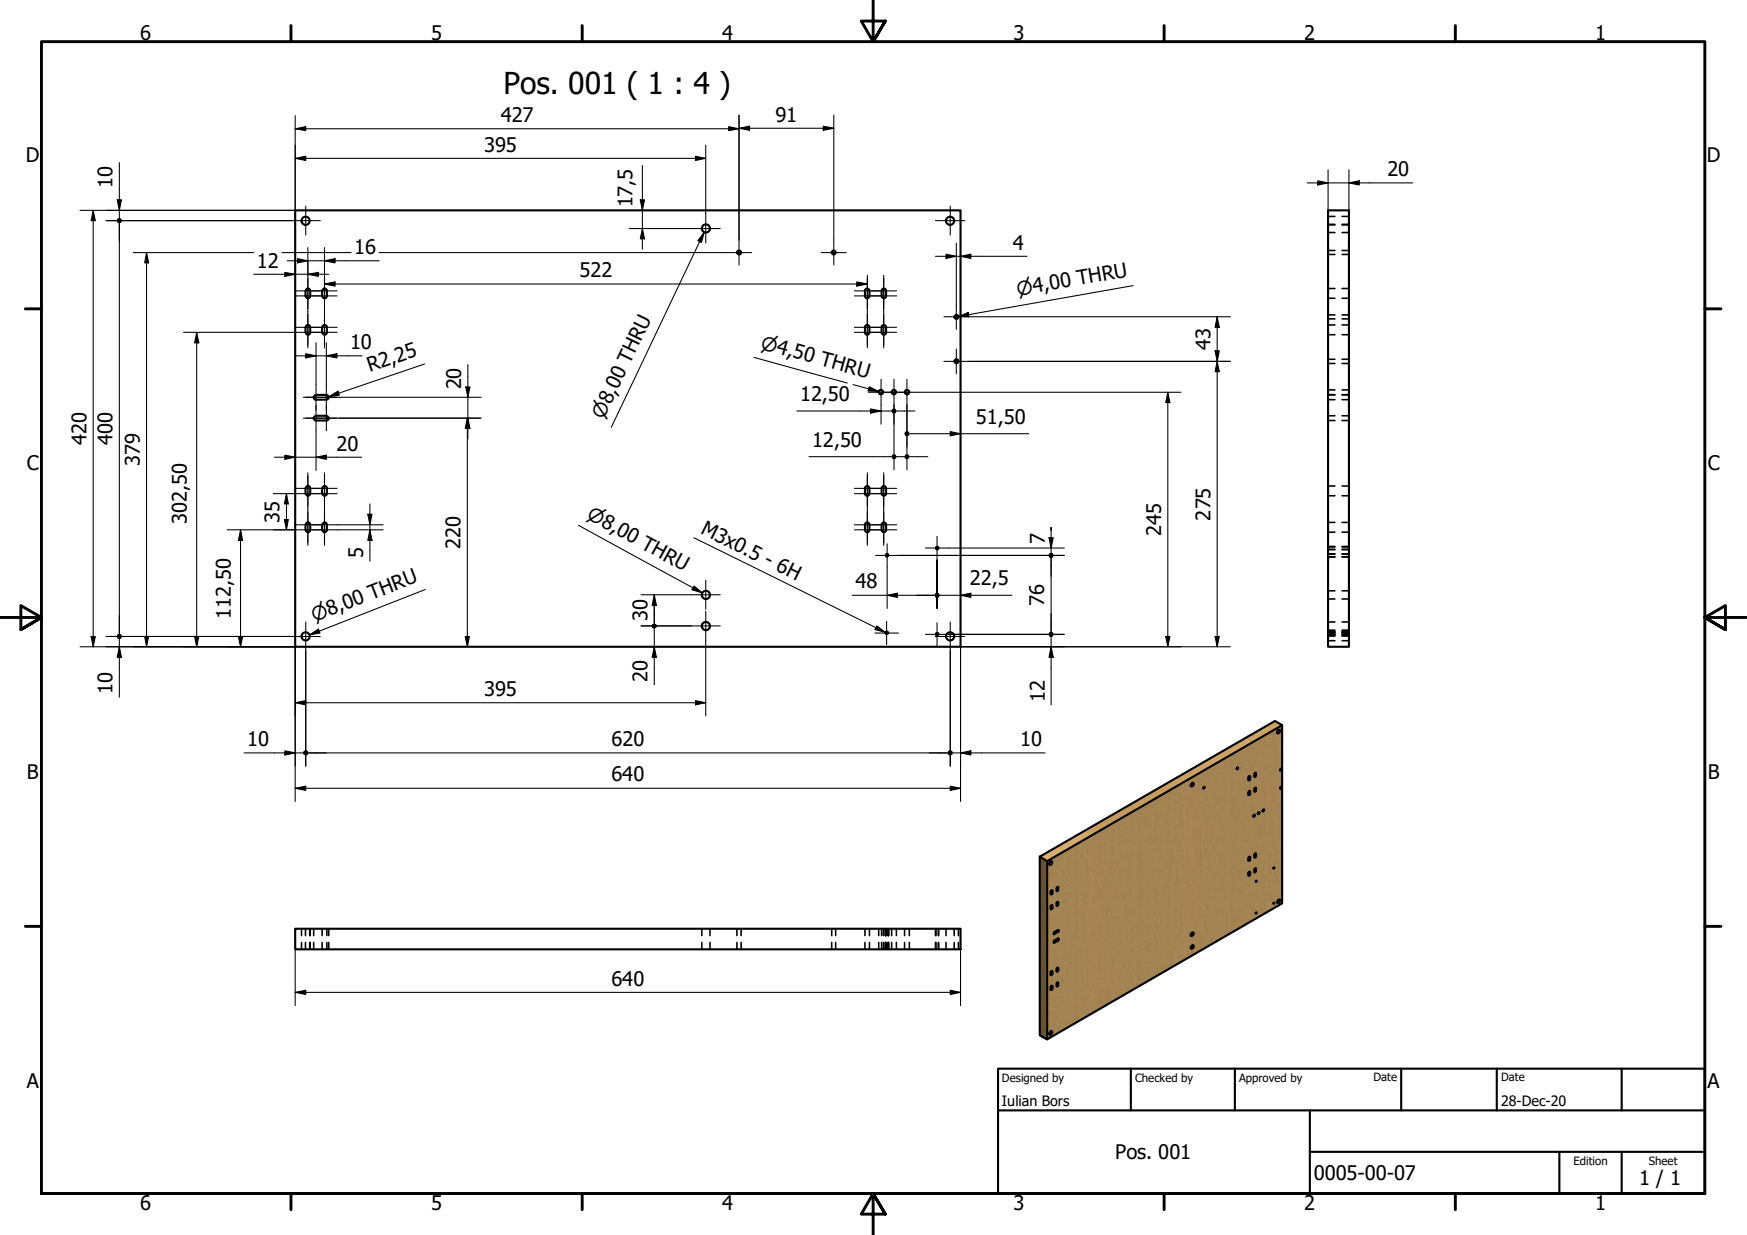
[picture p214: page 1]
Pos. 001 ( 1 : 4 )

Designed by Iulian Bors | Checked by | Approved by Date | Date 28-Dec-20

Pos. 001

0005-00-07 | Edition | Sheet 1 / 1
