TactileImages/TactilePrinterOne-P4/Imprimanta_1_Lemn/Drawings/0005-00-08.pdf

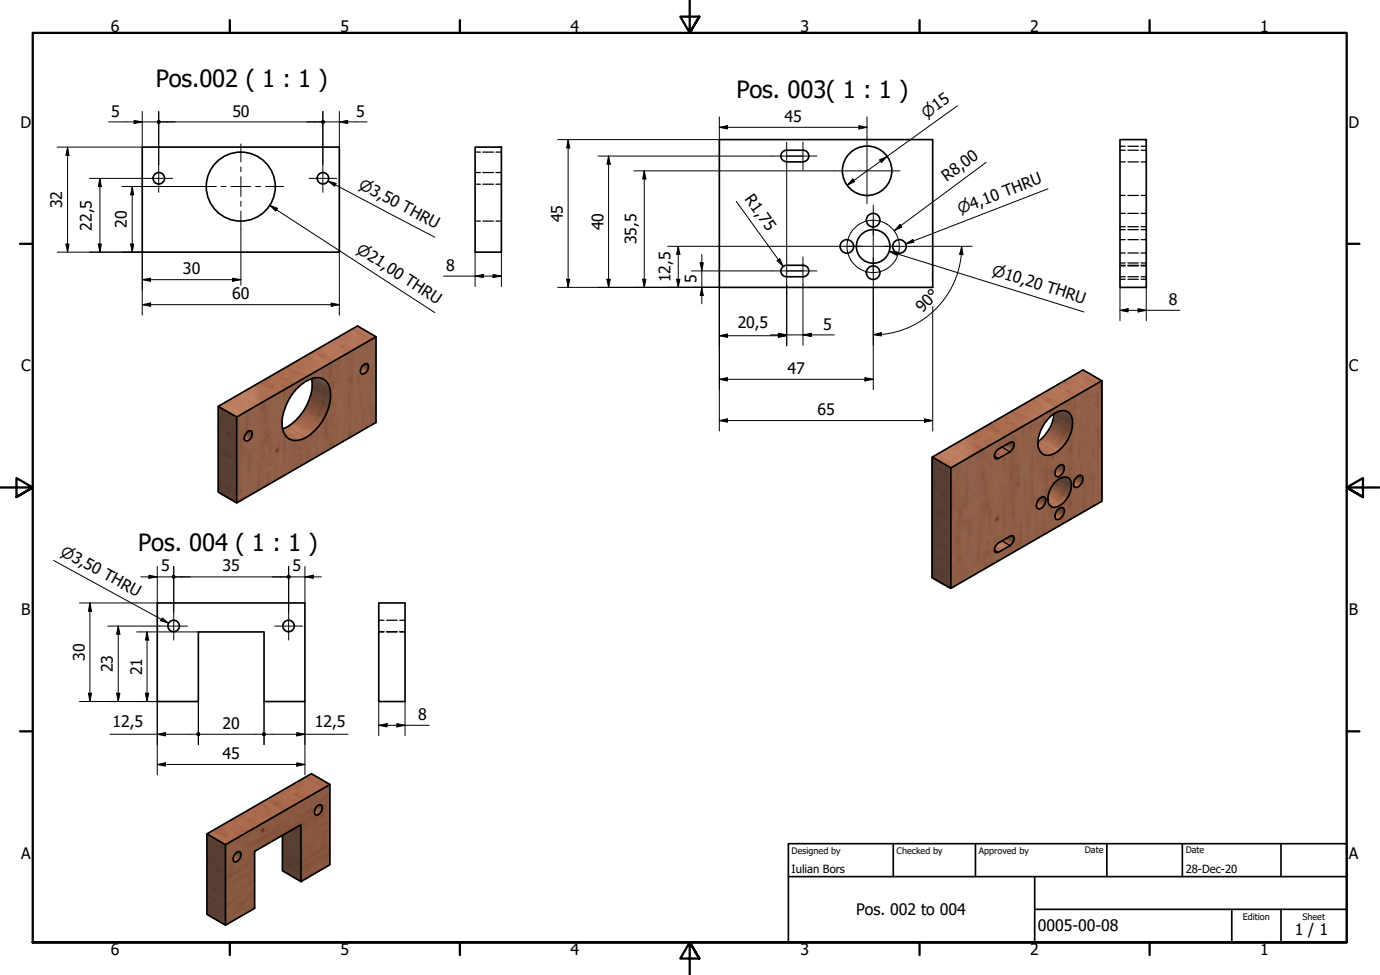
[picture p215: page 1]
Pos.002 ( 1 : 1 ); Pos. 003( 1 : 1 ); Pos. 004 ( 1 : 1 )

Designed by Iulian Bors | Checked by | Approved by Date | Date 28-Dec-20

Pos. 002 to 004

0005-00-08 | Edition | Sheet 1 / 1
