TactileImages/TactilePrinterOne-P4/Imprimanta_1_Lemn/Drawings/0005-00-09.pdf

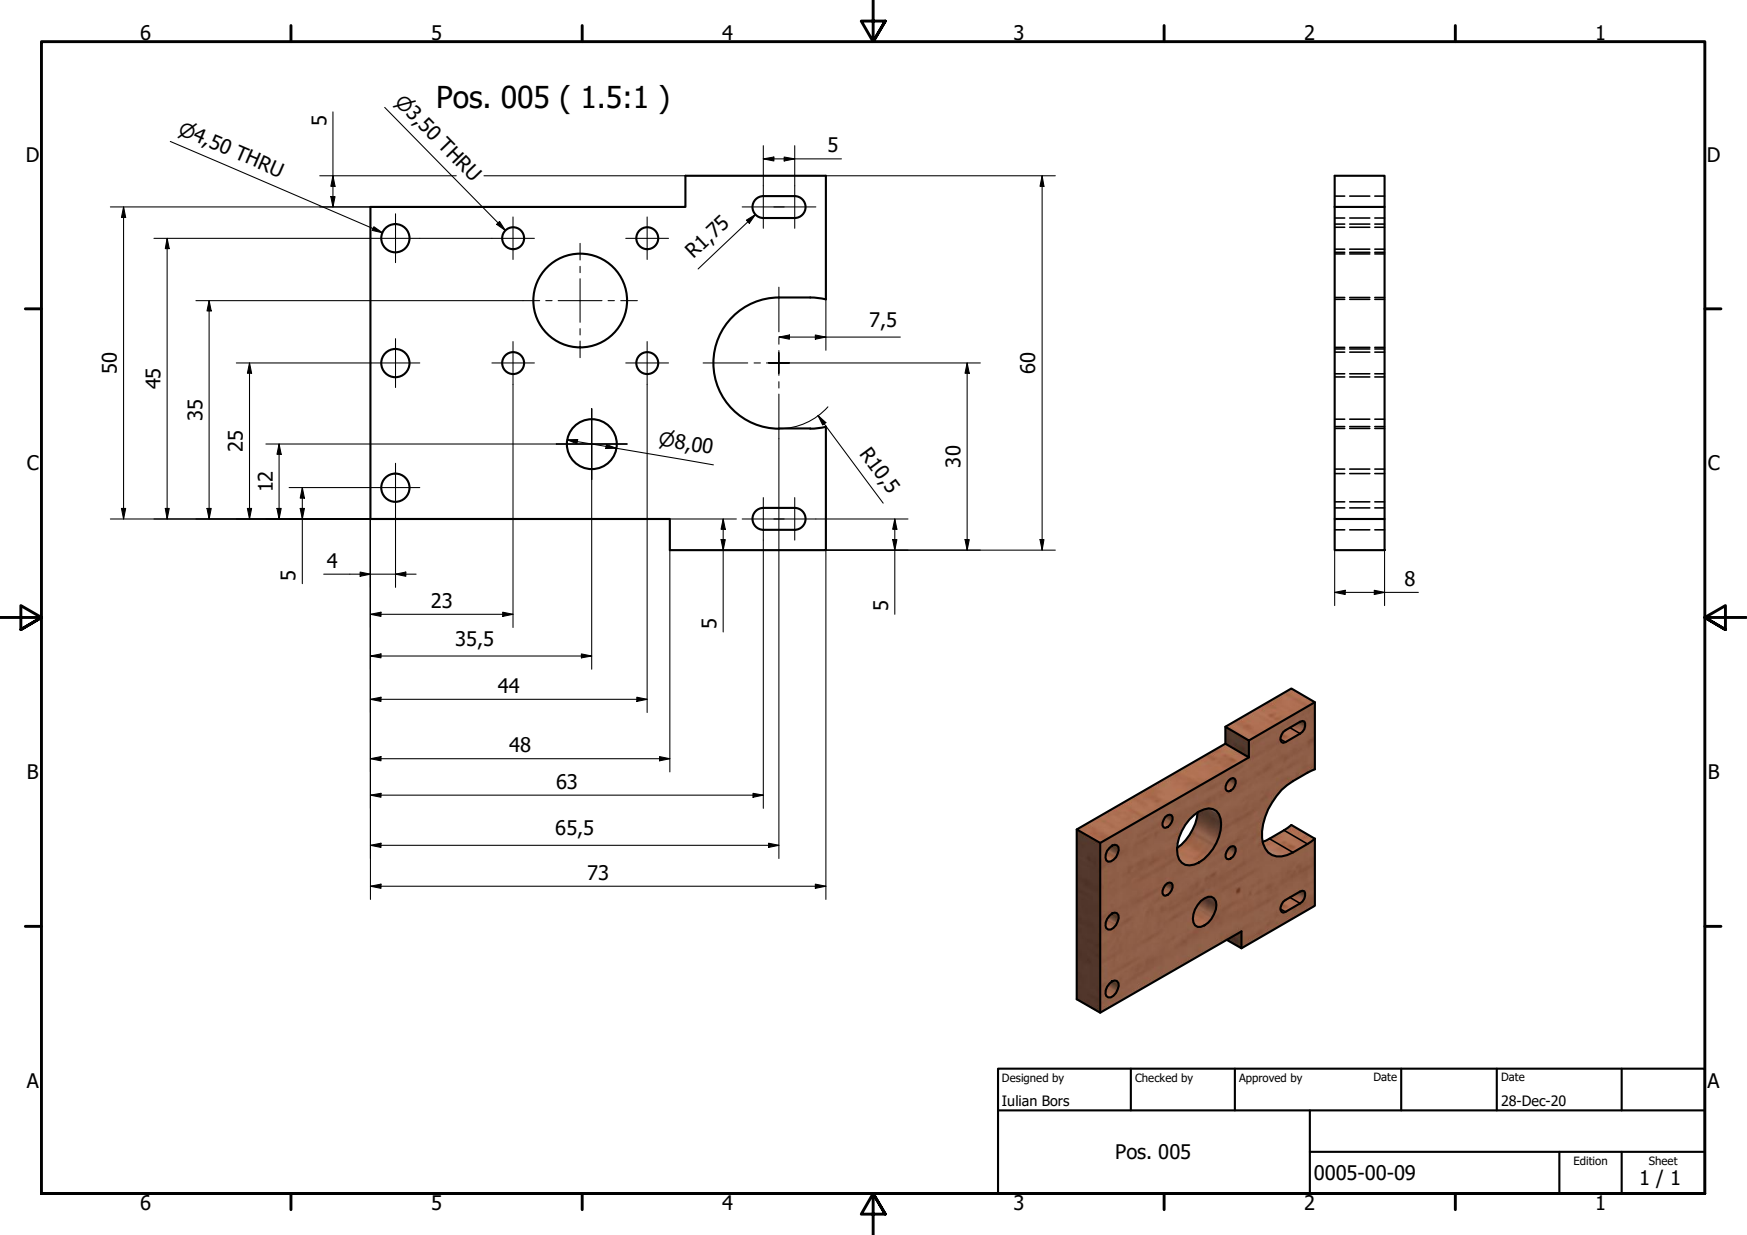
[picture p216: page 1]
Pos. 005 ( 1.5:1 )

Designed by Iulian Bors | Checked by | Approved by Date | Date 28-Dec-20

Pos. 005

0005-00-09 | Edition | Sheet 1 / 1
