TactileImages/TactilePrinterOne-P4/Imprimanta_1_Lemn/Drawings/0005-00-11.pdf

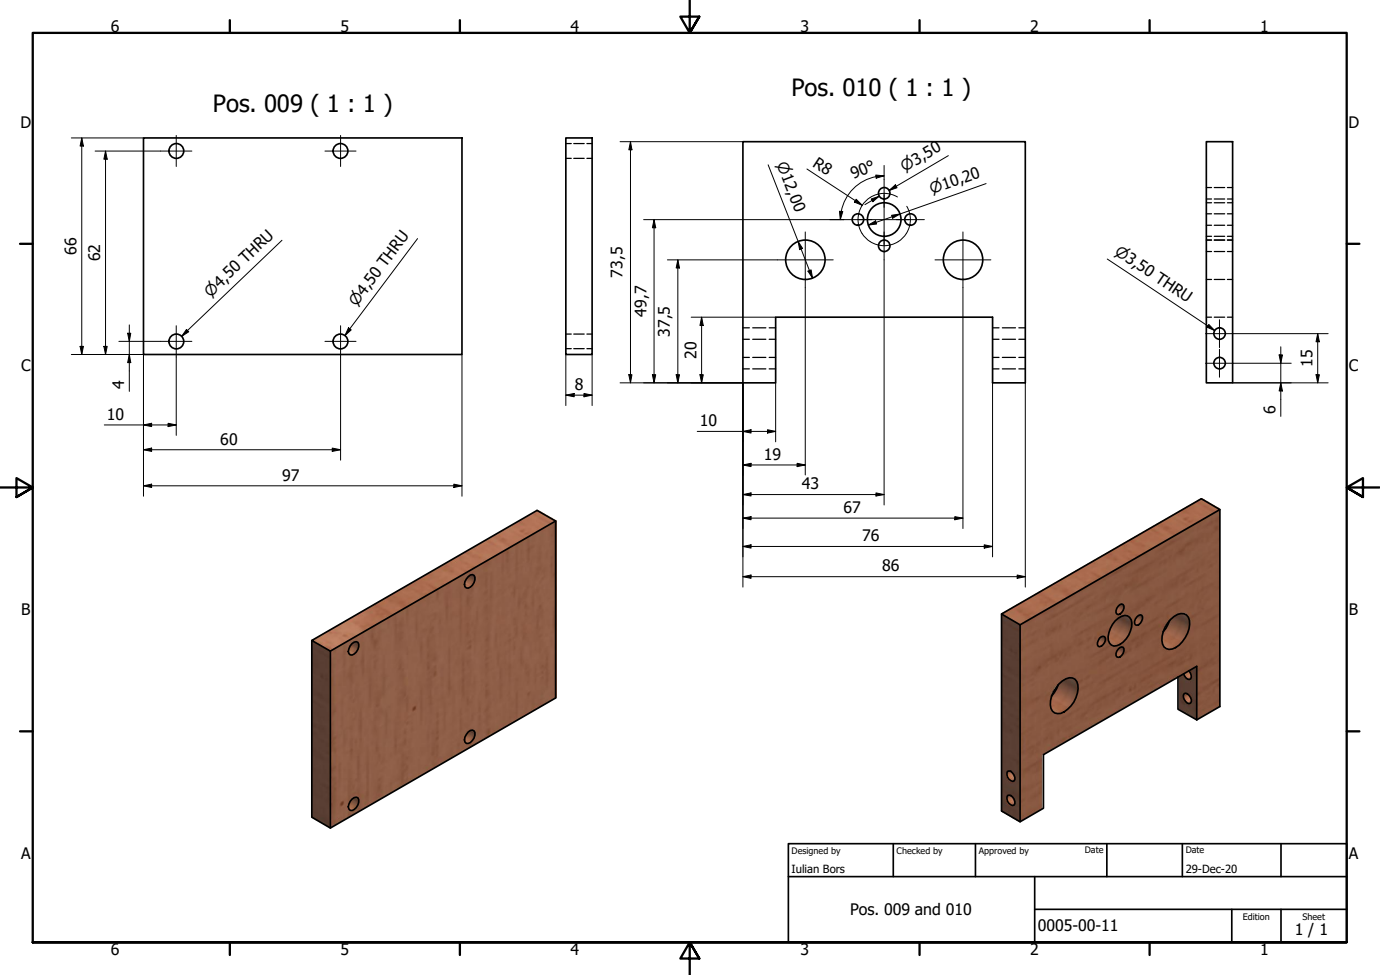
[picture p217: page 1]
Pos. 009 ( 1 : 1 ); Pos. 010 ( 1 : 1 )

Designed by Iulian Bors | Checked by | Approved by Date | Date 29-Dec-20

Pos. 009 and 010

0005-00-11 | Edition | Sheet 1 / 1
