TactileImages/TactilePrinterOne-P4/Imprimanta_1_Lemn/Drawings/0005-00-12.pdf

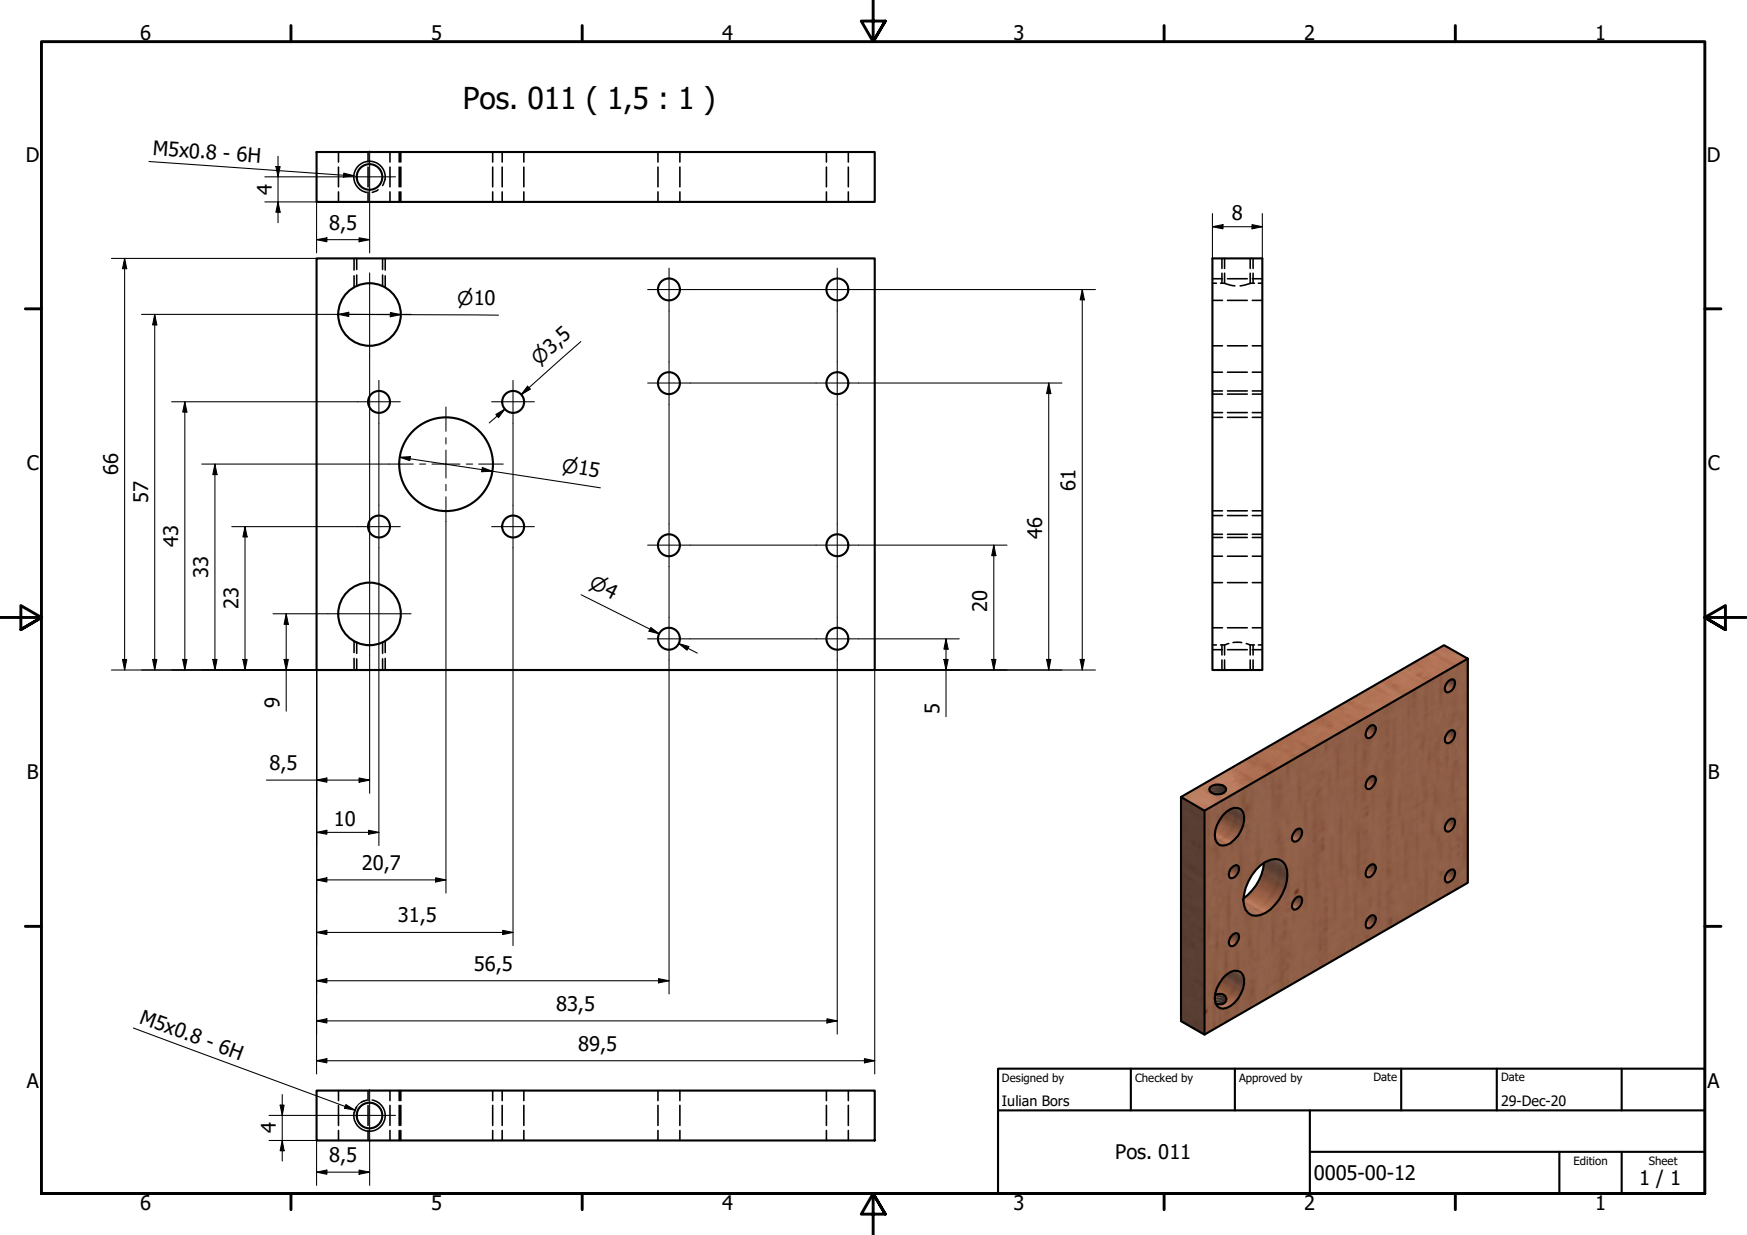
[picture p218: page 1]
Pos. 011 ( 1,5 : 1 )

Designed by Iulian Bors | Checked by | Approved by Date | Date 29-Dec-20

Pos. 011

0005-00-12 | Edition | Sheet 1 / 1
