TactileImages/TactilePrinterOne-P4/Imprimanta_1_Lemn/Drawings/0005-00-13.pdf

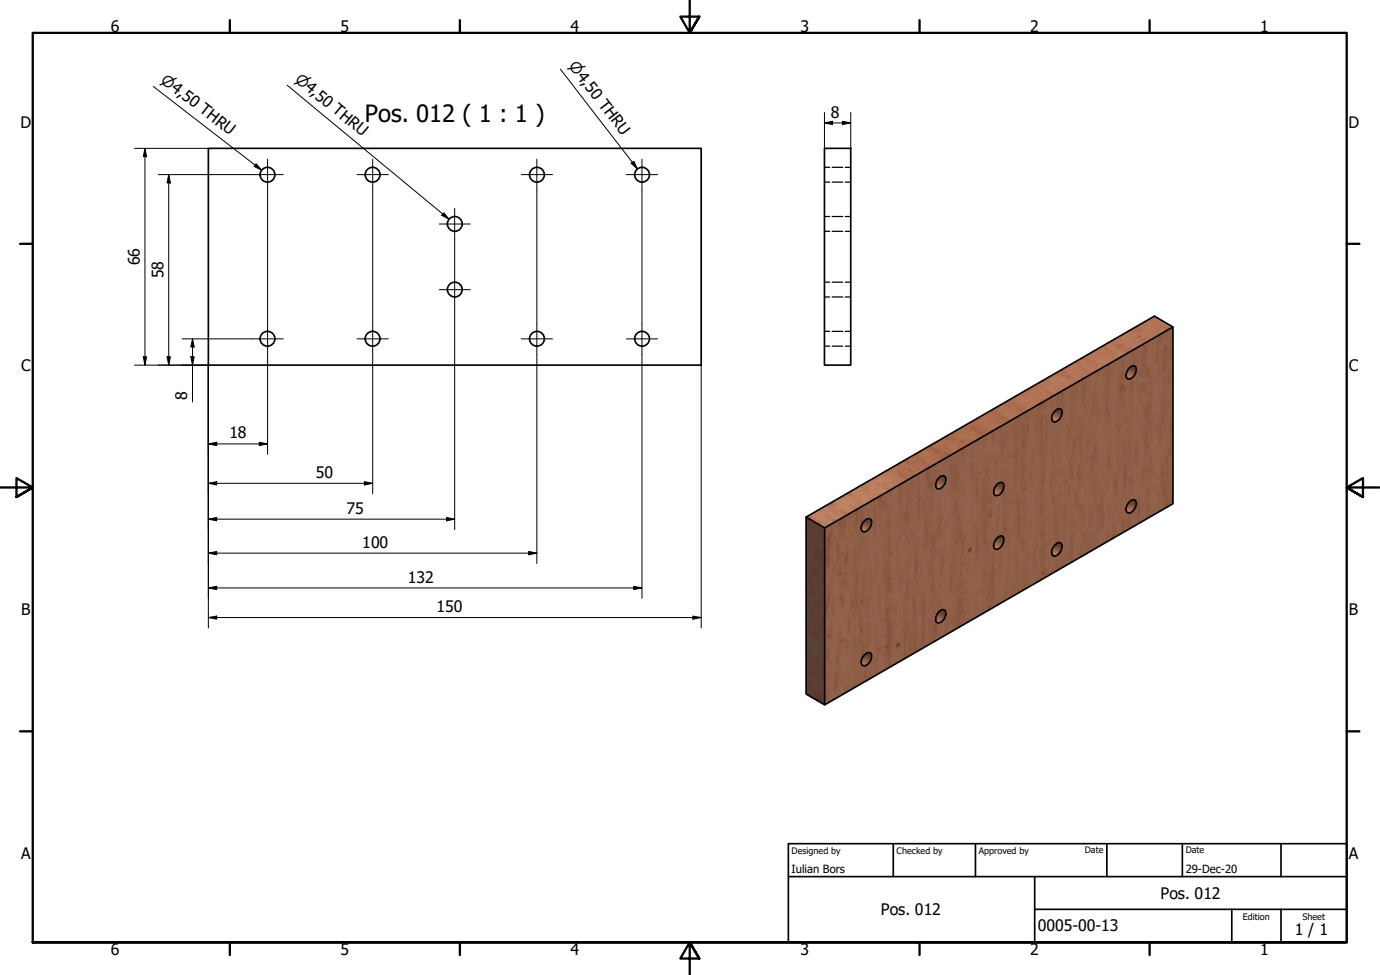
[picture p219: page 1]
Pos. 012 ( 1 : 1 )

Designed by Iulian Bors | Checked by | Approved by Date | Date 29-Dec-20

Pos. 012 | Pos. 012

0005-00-13 | Edition | Sheet 1 / 1
