TactileImages/TactilePrinterOne-P4/Imprimanta_1_Lemn/Drawings/0005-00-14.pdf

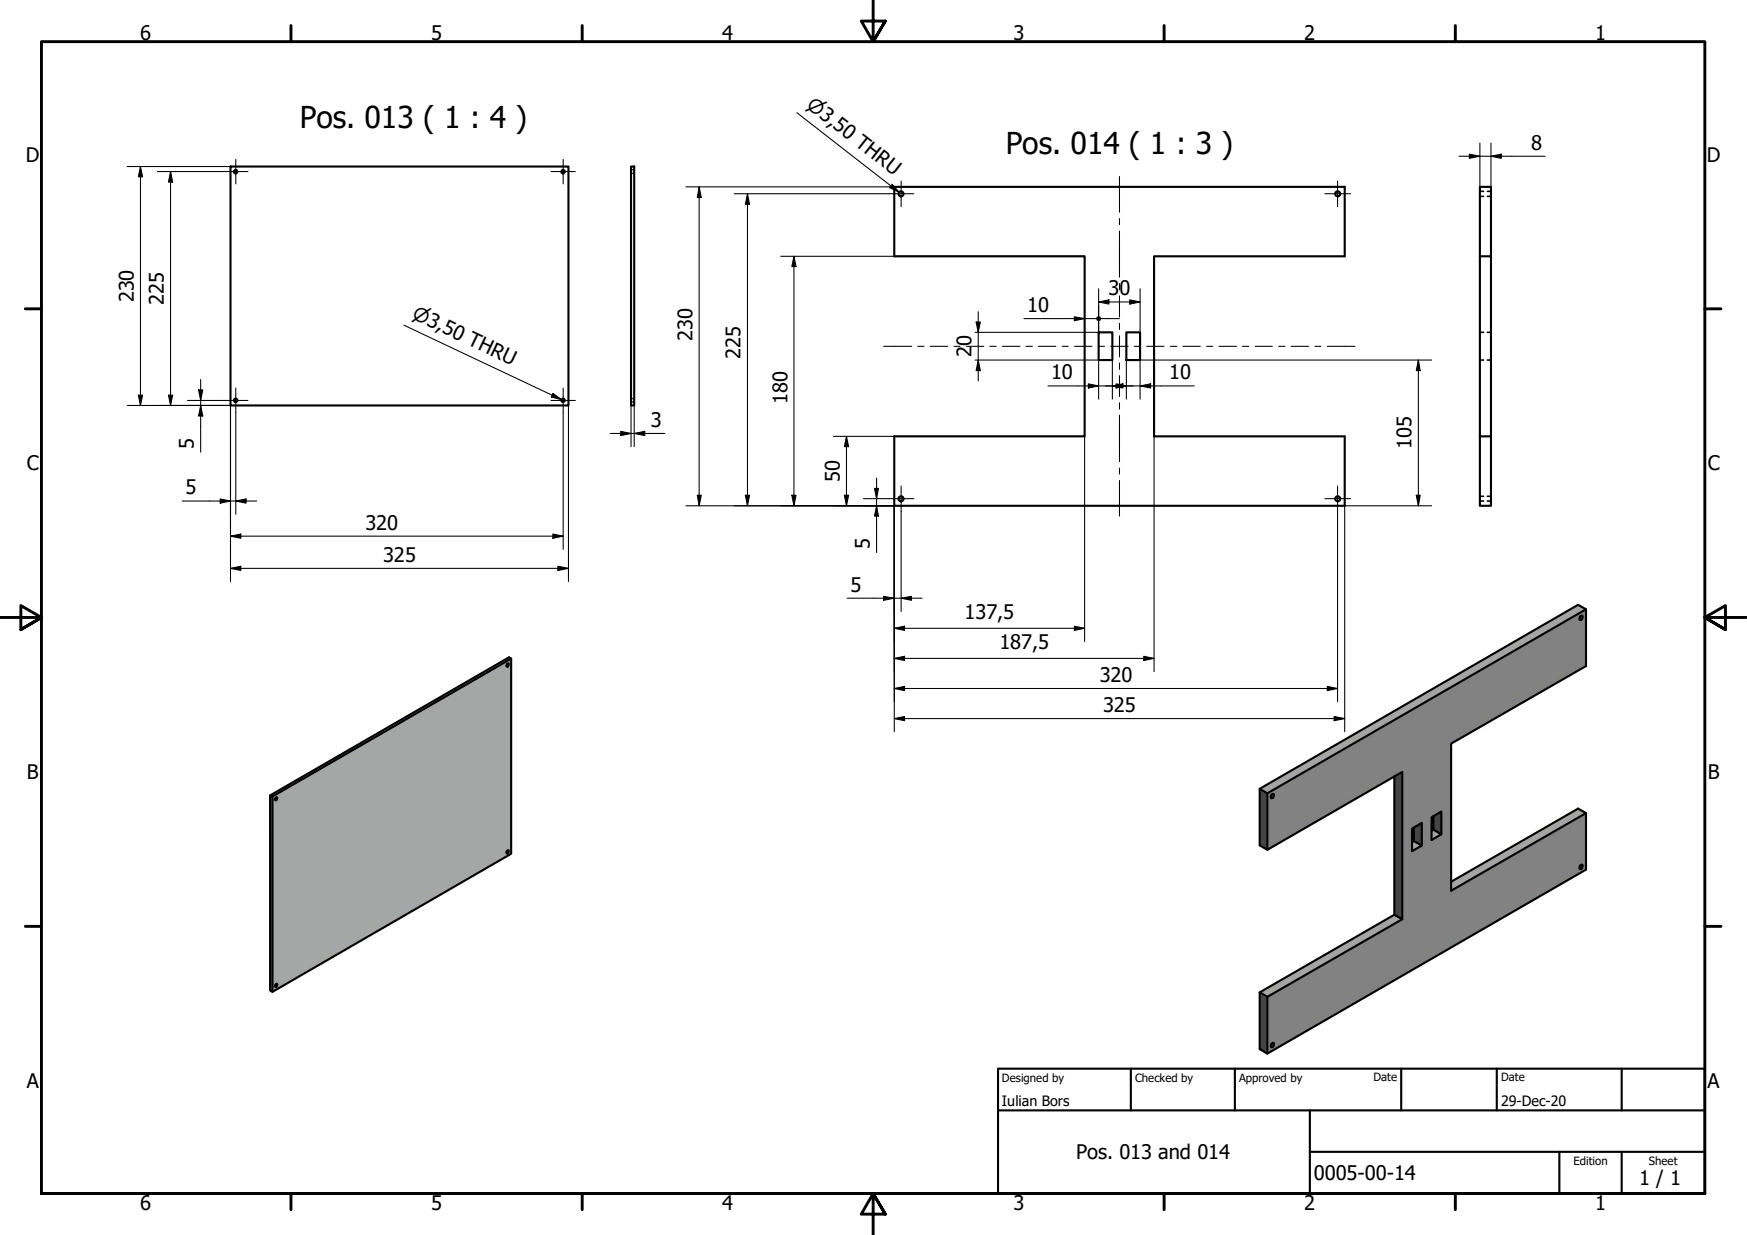
[picture p220: page 1]
Pos. 013 ( 1 : 4 ); Pos. 014 ( 1 : 3 )

Designed by Iulian Bors | Checked by | Approved by Date | Date 29-Dec-20

Pos. 013 and 014

0005-00-14 | Edition | Sheet 1 / 1
