TactileImages/TactilePrinterOne-P4/Imprimanta_1_Lemn/Drawings/0005-00-15.pdf

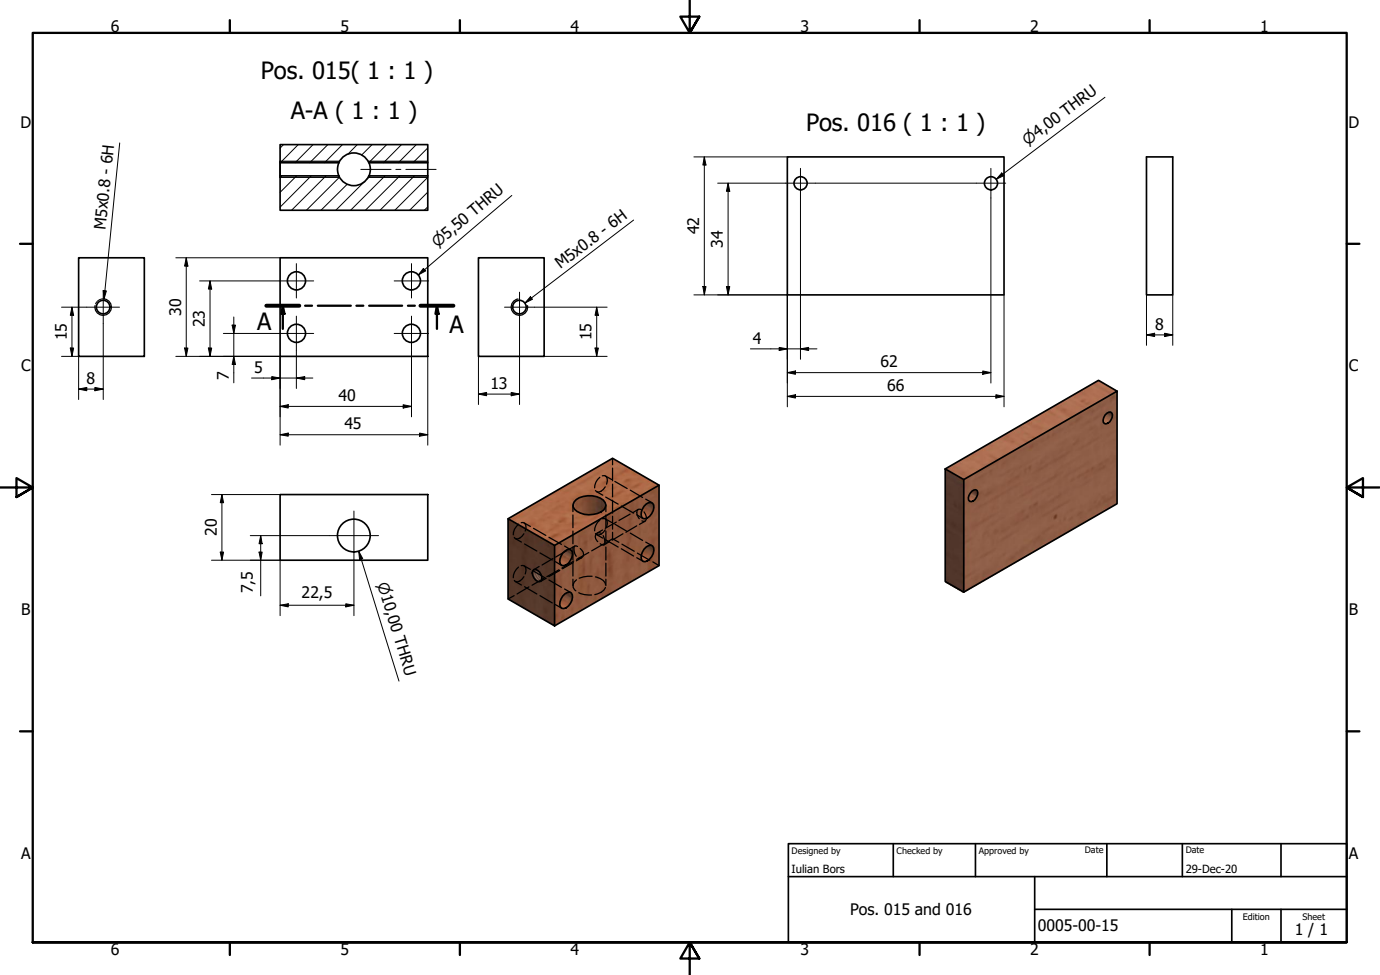
[picture p221: page 1]
Pos. 015( 1 : 1 ); Pos. 016 ( 1 : 1 )

Designed by Iulian Bors | Checked by | Approved by Date | Date 29-Dec-20

Pos. 015 and 016

0005-00-15 | Edition | Sheet 1 / 1
