TactileImages/TactilePrinterOne-P4/Imprimanta_1_Lemn/Drawings/0005-00-16.pdf

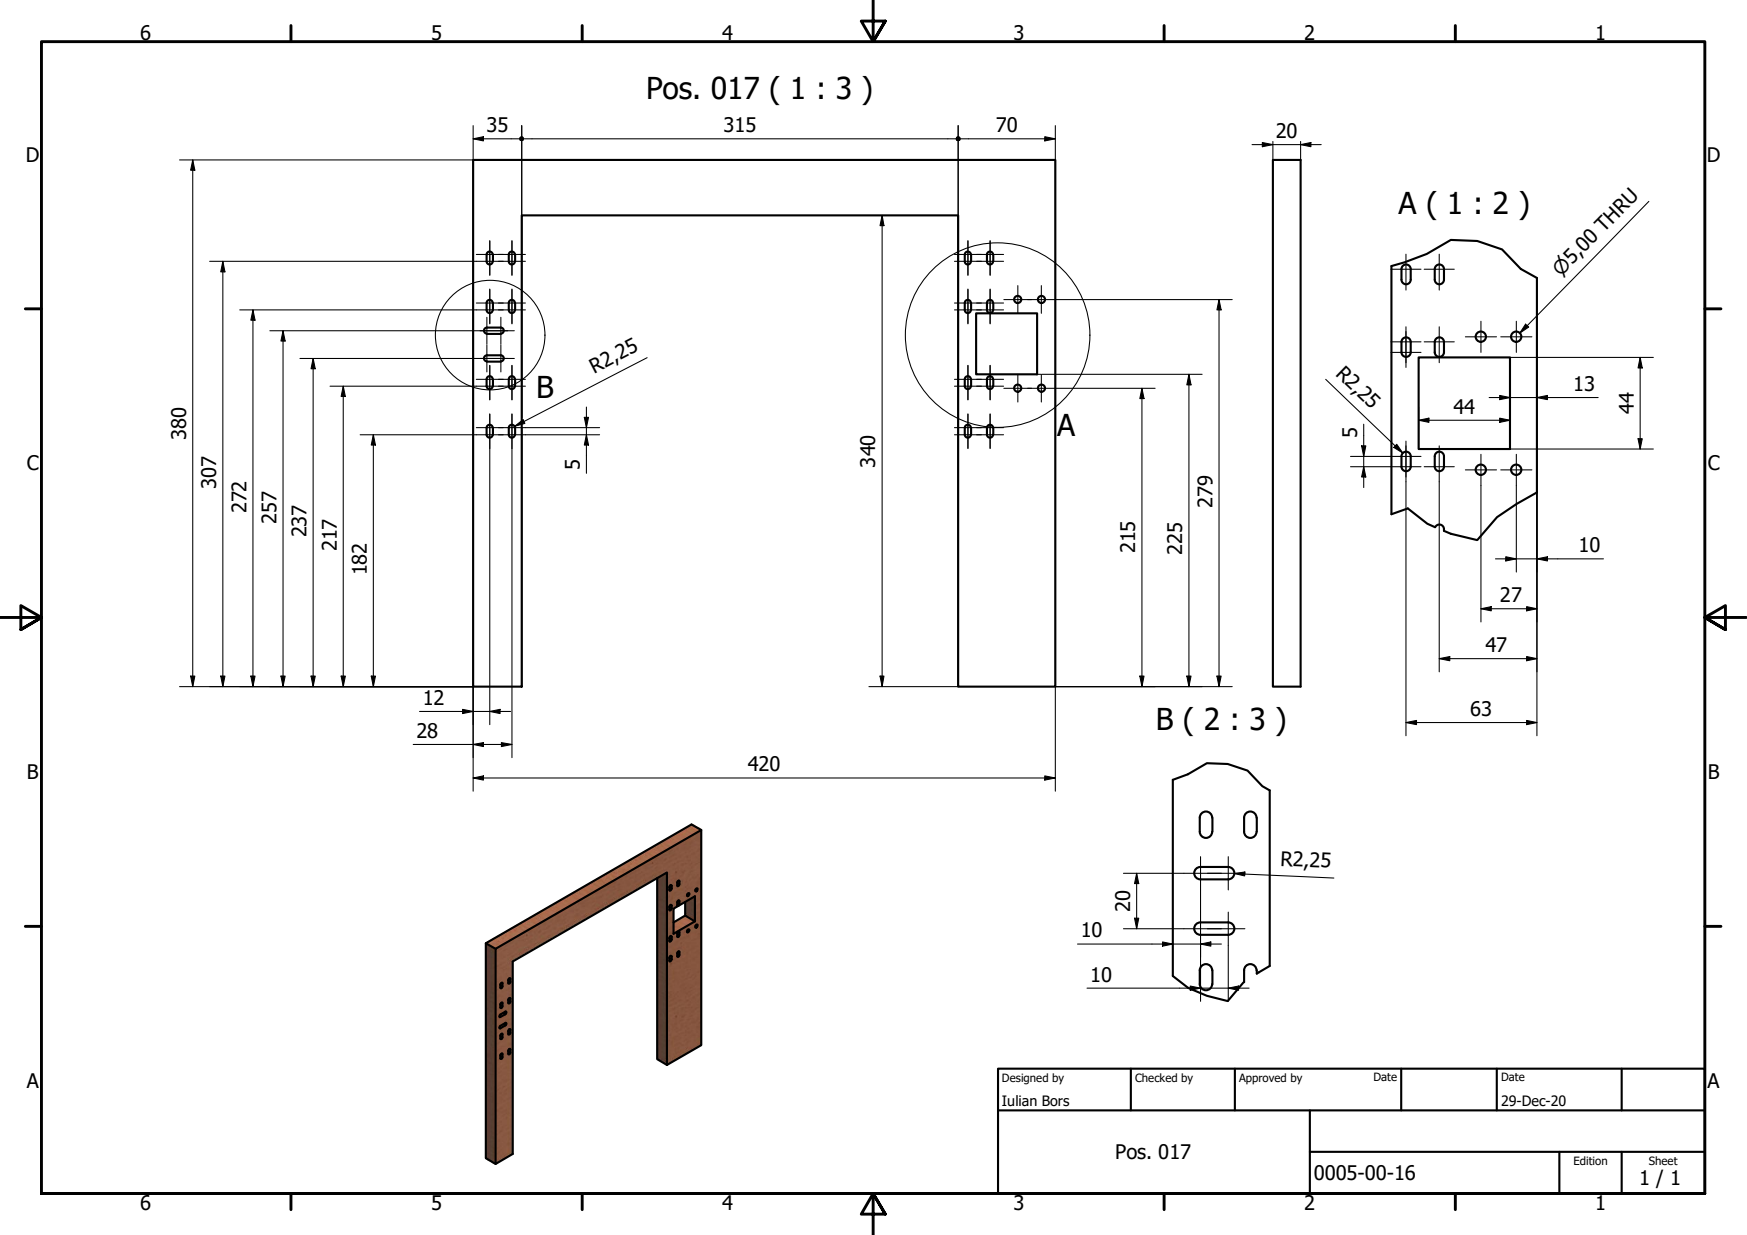
[picture p222: page 1]
Pos. 017 ( 1 : 3 )

Designed by Iulian Bors | Checked by | Approved by Date | Date 29-Dec-20

Pos. 017

0005-00-16 | Edition | Sheet 1 / 1
