TactileImages/TactilePrinterOne-P4/Imprimanta_1_Lemn/Drawings/0005-00-17.pdf

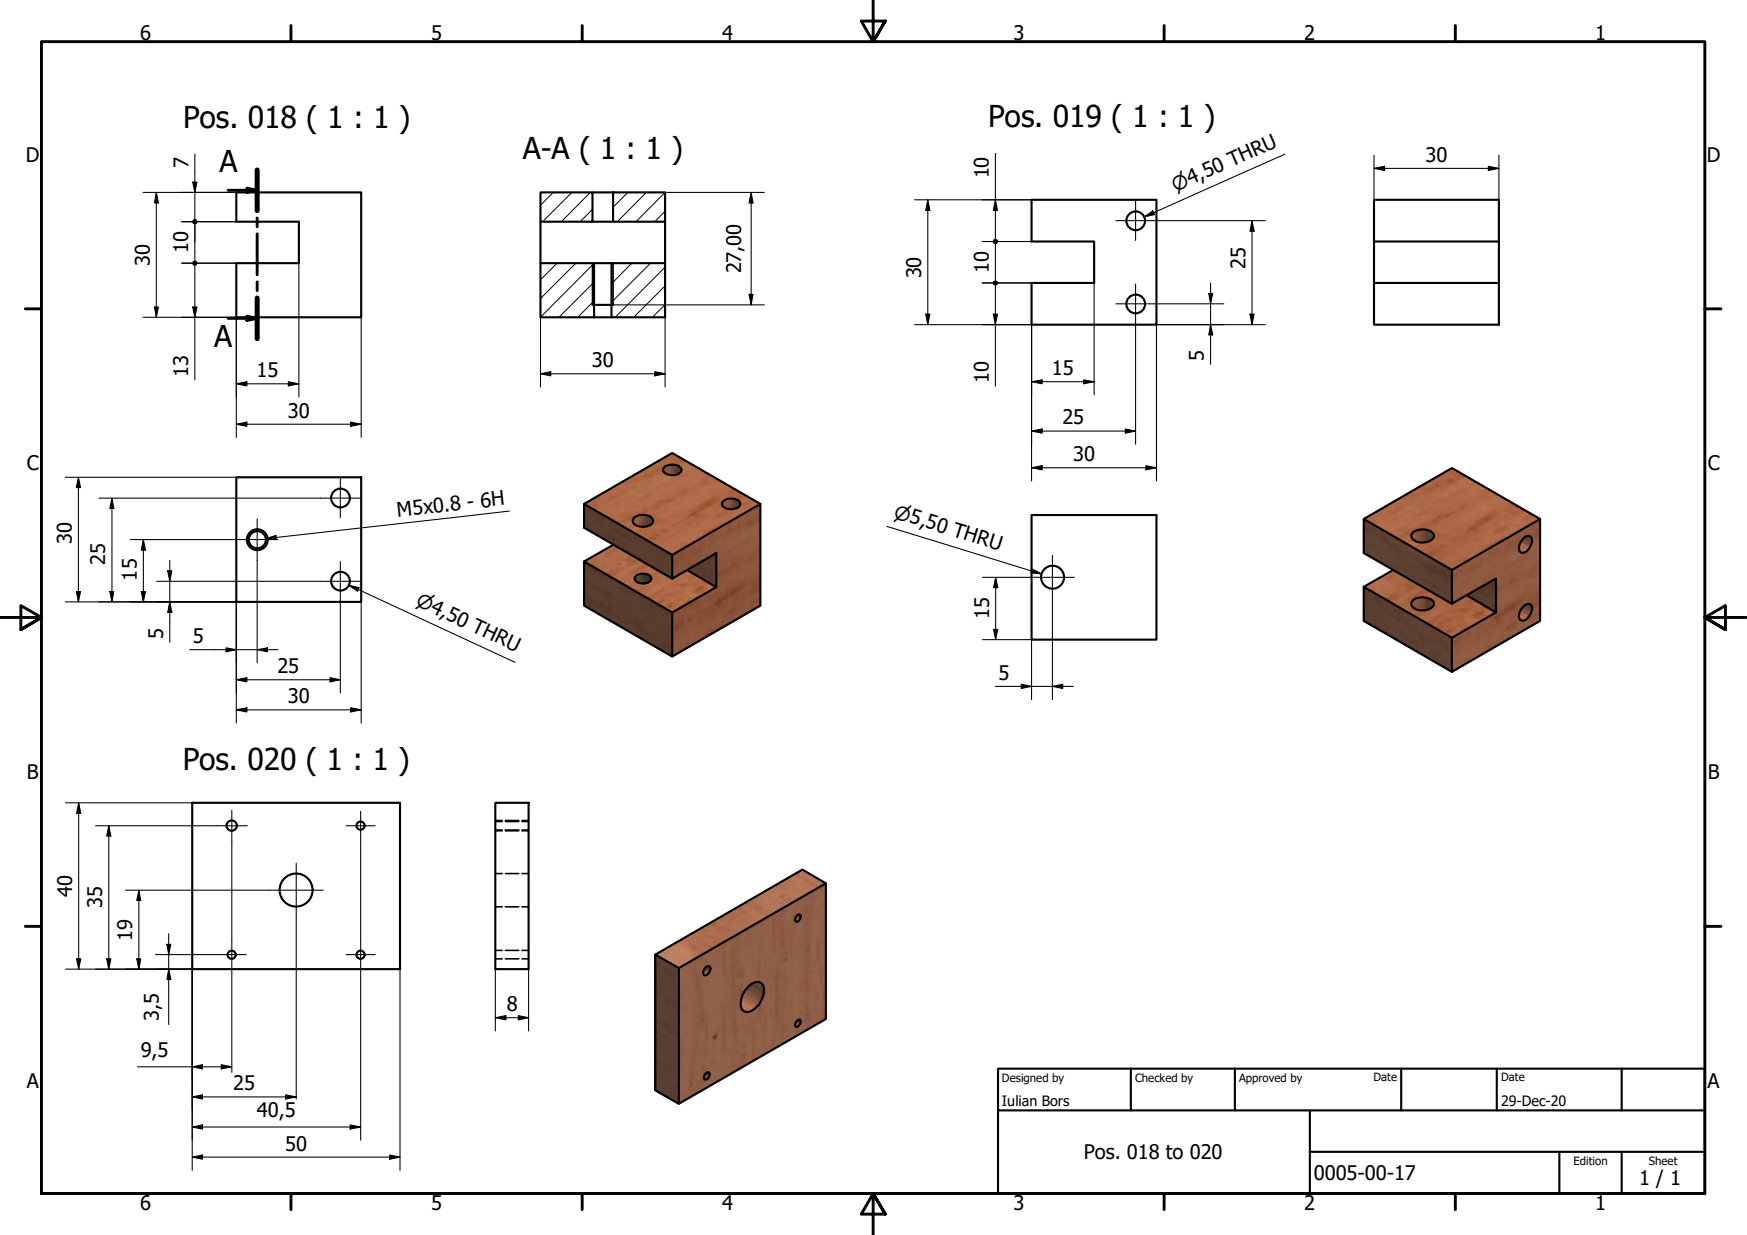
[picture p223: page 1]
Pos. 018 ( 1 : 1 ); Pos. 019 ( 1 : 1 ); Pos. 020 ( 1 : 1 )

Designed by Iulian Bors | Checked by | Approved by Date | Date 29-Dec-20

Pos. 018 to 020

0005-00-17 | Edition | Sheet 1 / 1
