TactileImages/TactilePrinterOne-P4/Imprimanta_1_Lemn/Drawings/0005-00-18.pdf

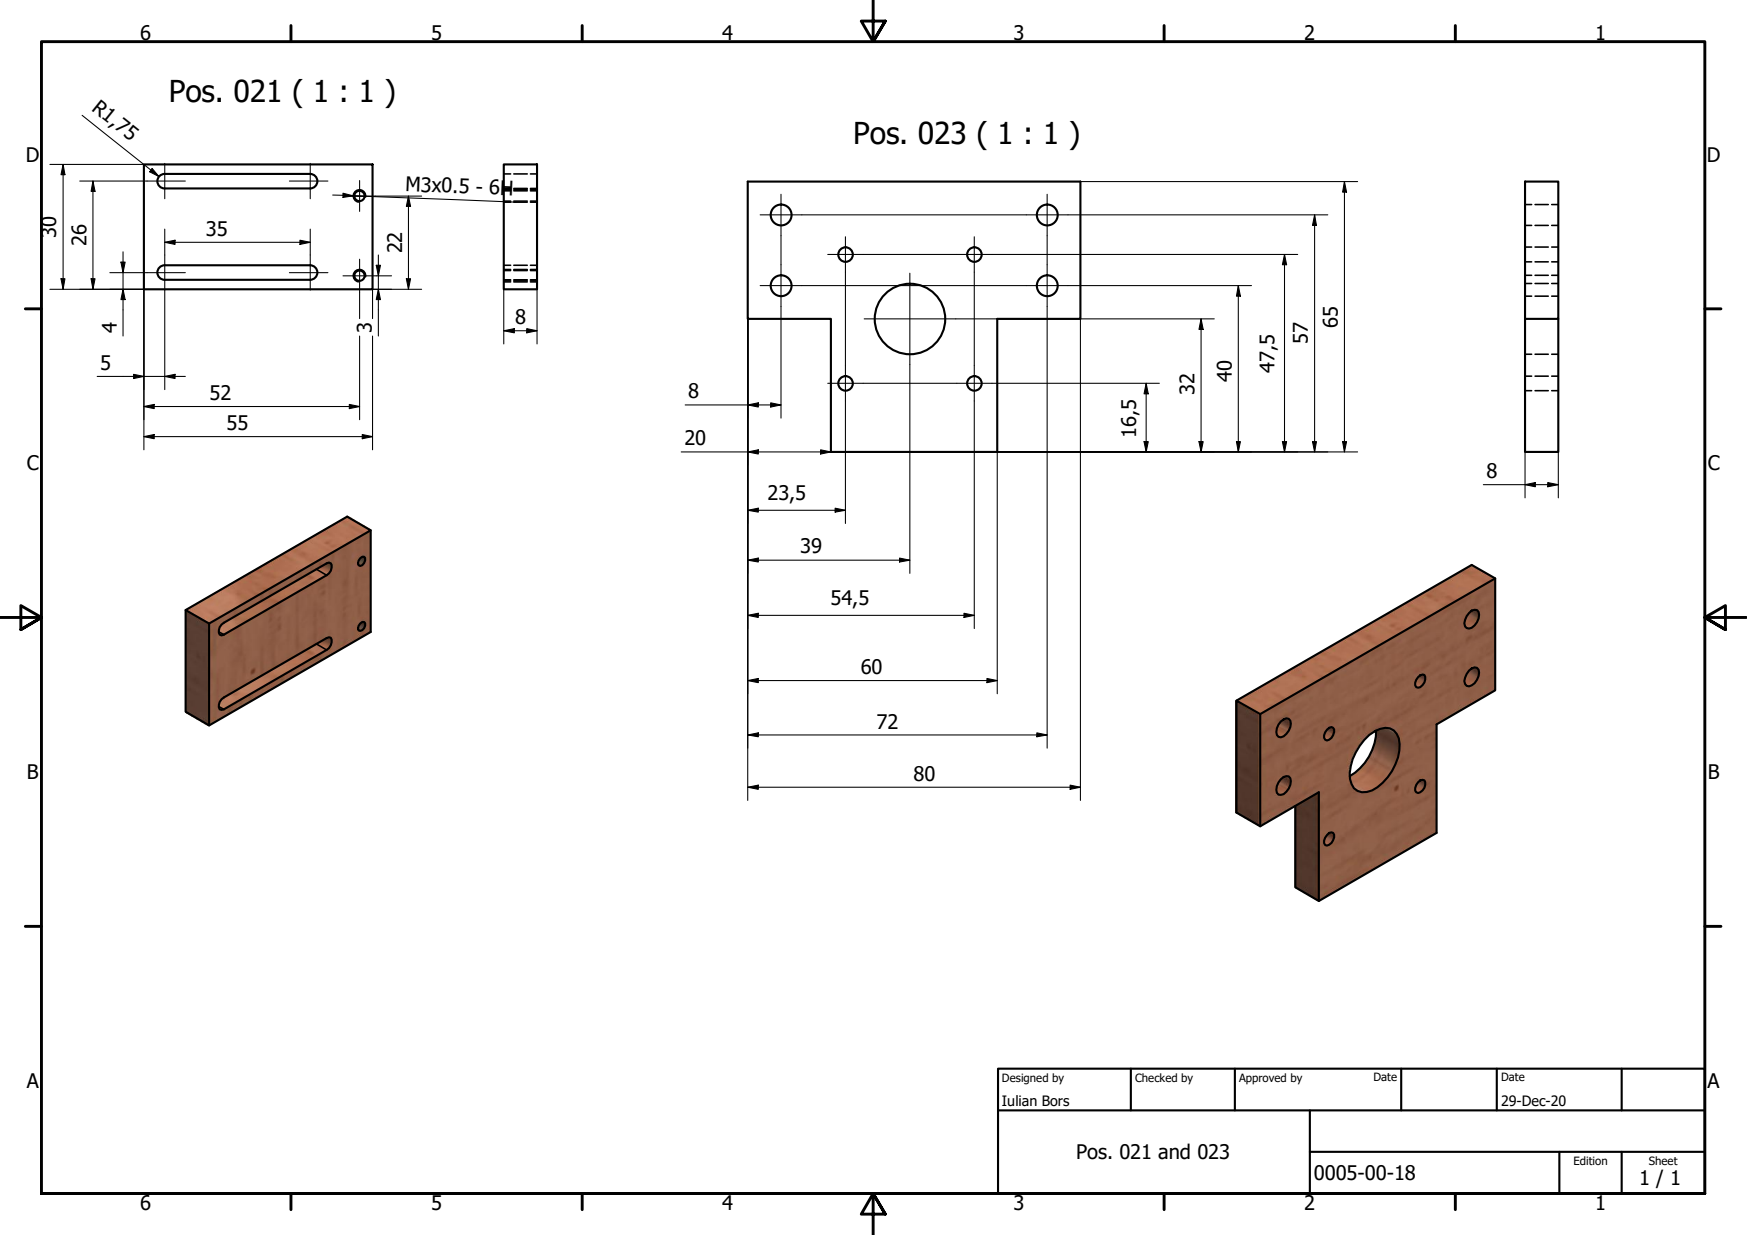
[picture p224: page 1]
Pos. 021 ( 1 : 1 ); Pos. 023 ( 1 : 1 )

Designed by Iulian Bors | Checked by | Approved by Date | Date 29-Dec-20

Pos. 021 and 023

0005-00-18 | Edition | Sheet 1 / 1
