TactileImages/TactilePrinterOne-P4/Imprimanta_1_Lemn/Drawings/0005-00-19.pdf

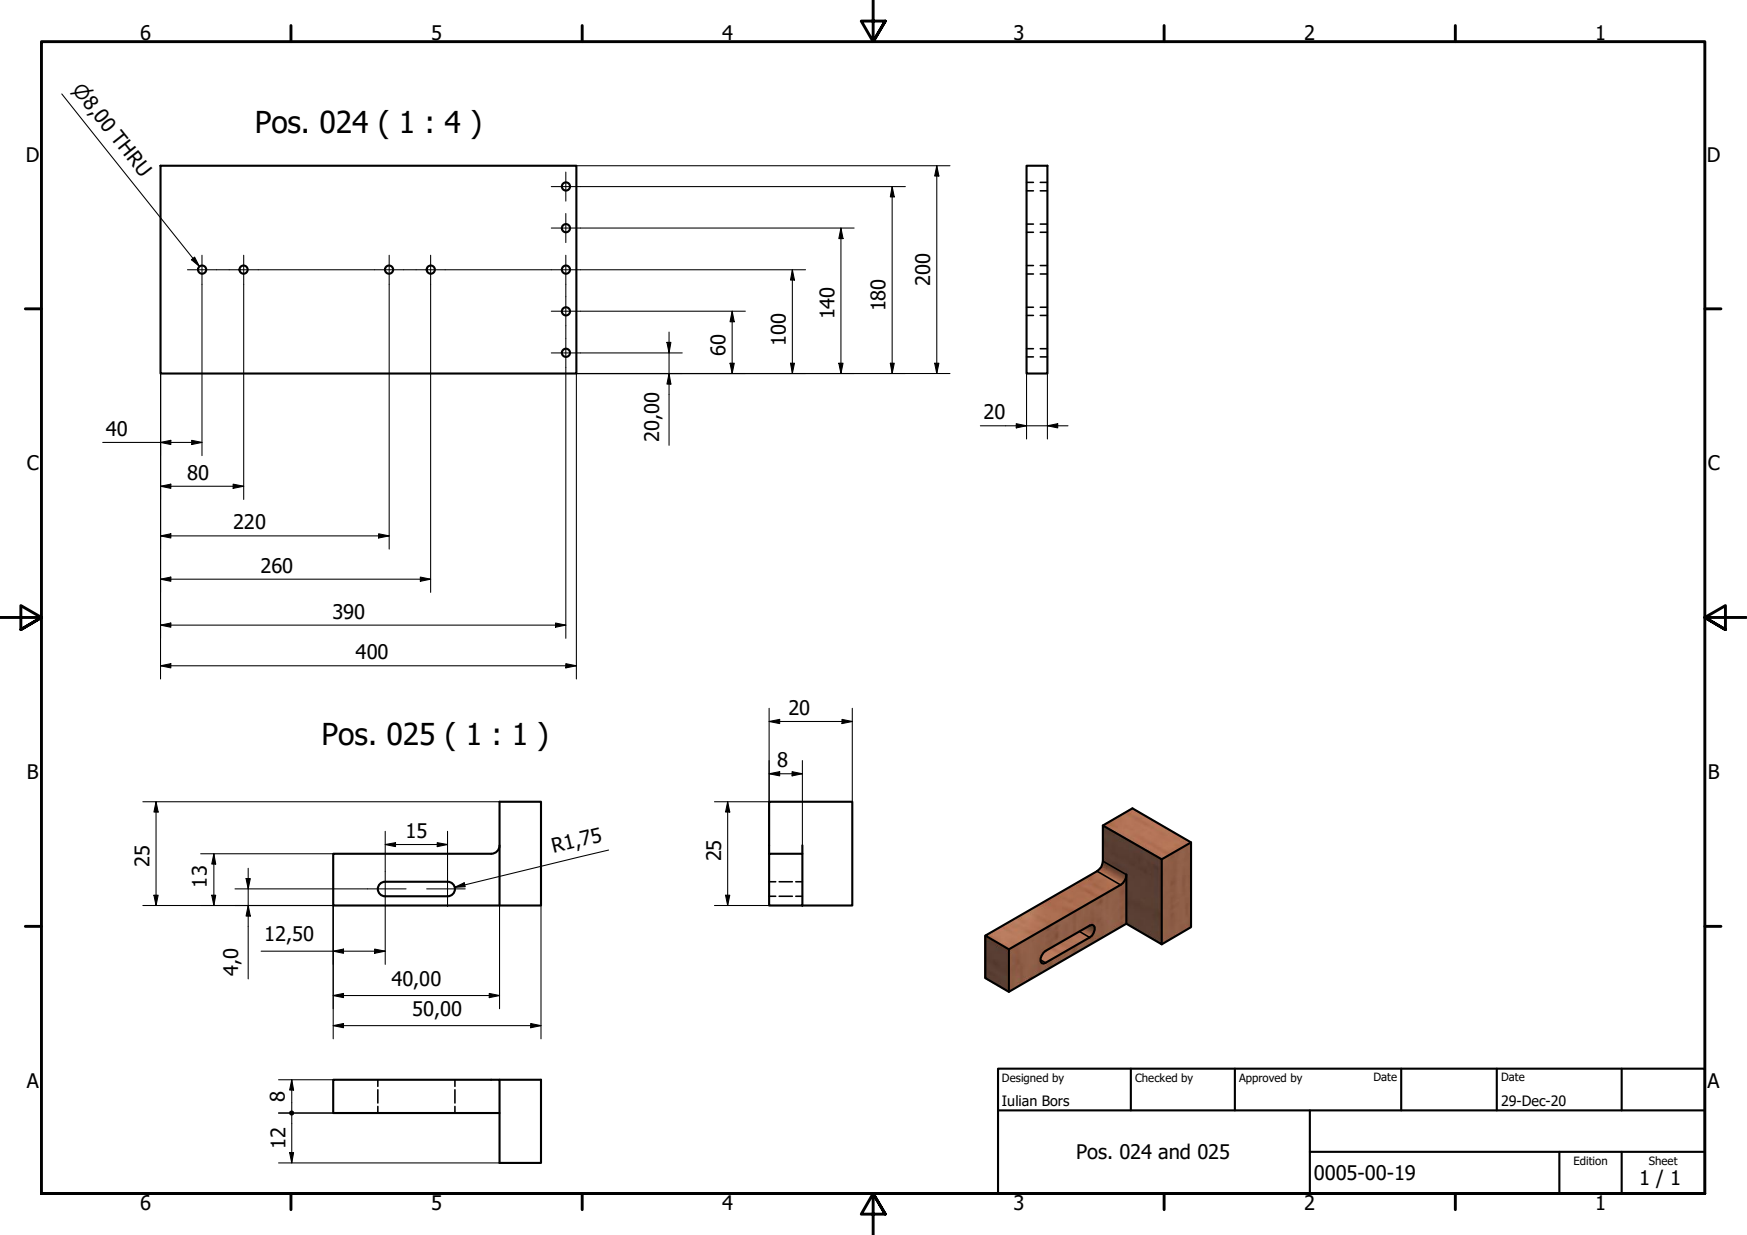
[picture p225: page 1]
Pos. 024 ( 1 : 4 ); Pos. 025 ( 1 : 1 )

Designed by Iulian Bors | Checked by | Approved by Date | Date 29-Dec-20

Pos. 024 and 025

0005-00-19 | Edition | Sheet 1 / 1
