TactileImages/TactilePrinterOne-P4/Imprimanta_1_Lemn/Drawings/0005-00-21.pdf

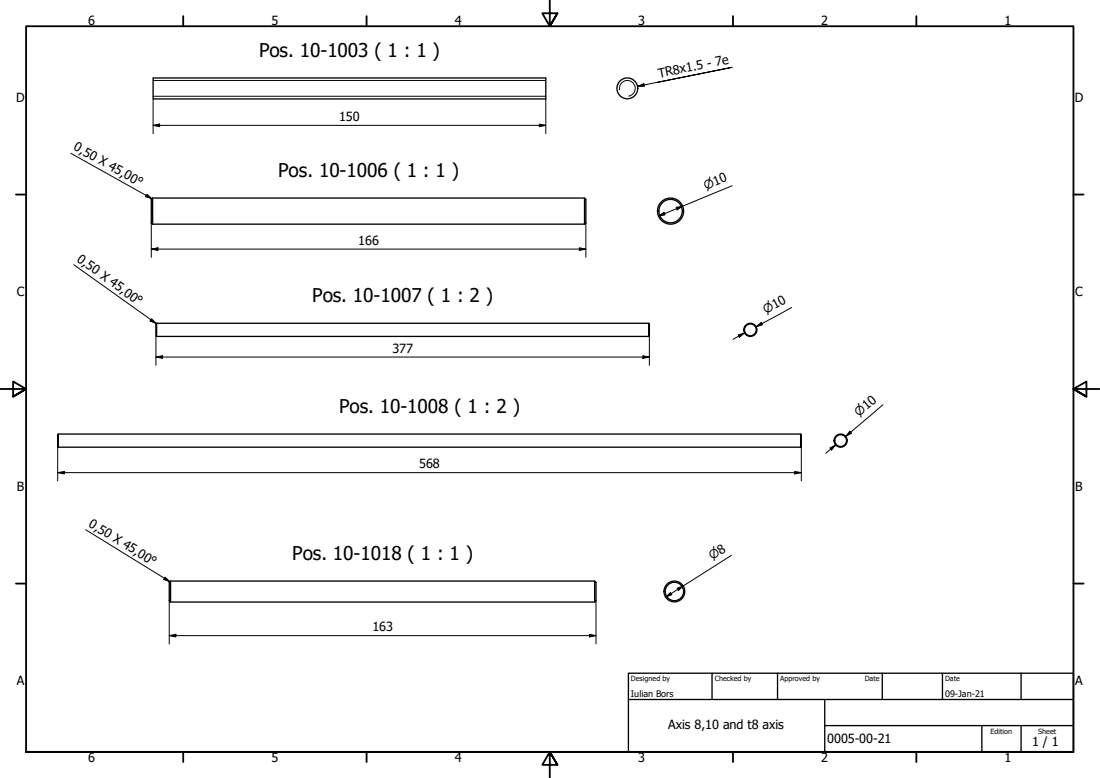
[picture p226: page 1]
Pos. 10-1006 ( 1 : 1 ); Pos. 10-1018 ( 1 : 1 ); Pos. 10-1008 ( 1 : 2 ); Pos. 10-1007 ( 1 : 2 ); Pos. 10-1003 ( 1 : 1 )

Designed by Iulian Bors | Checked by | Approved by Date | Date 09-Jan-21

Axis 8,10 and t8 axis

0005-00-21 | Edition | Sheet 1 / 1
