TactileImages/TactilePrinterOne-P4/Imprimanta_1_Lemn/Drawings/0005-00-22.pdf

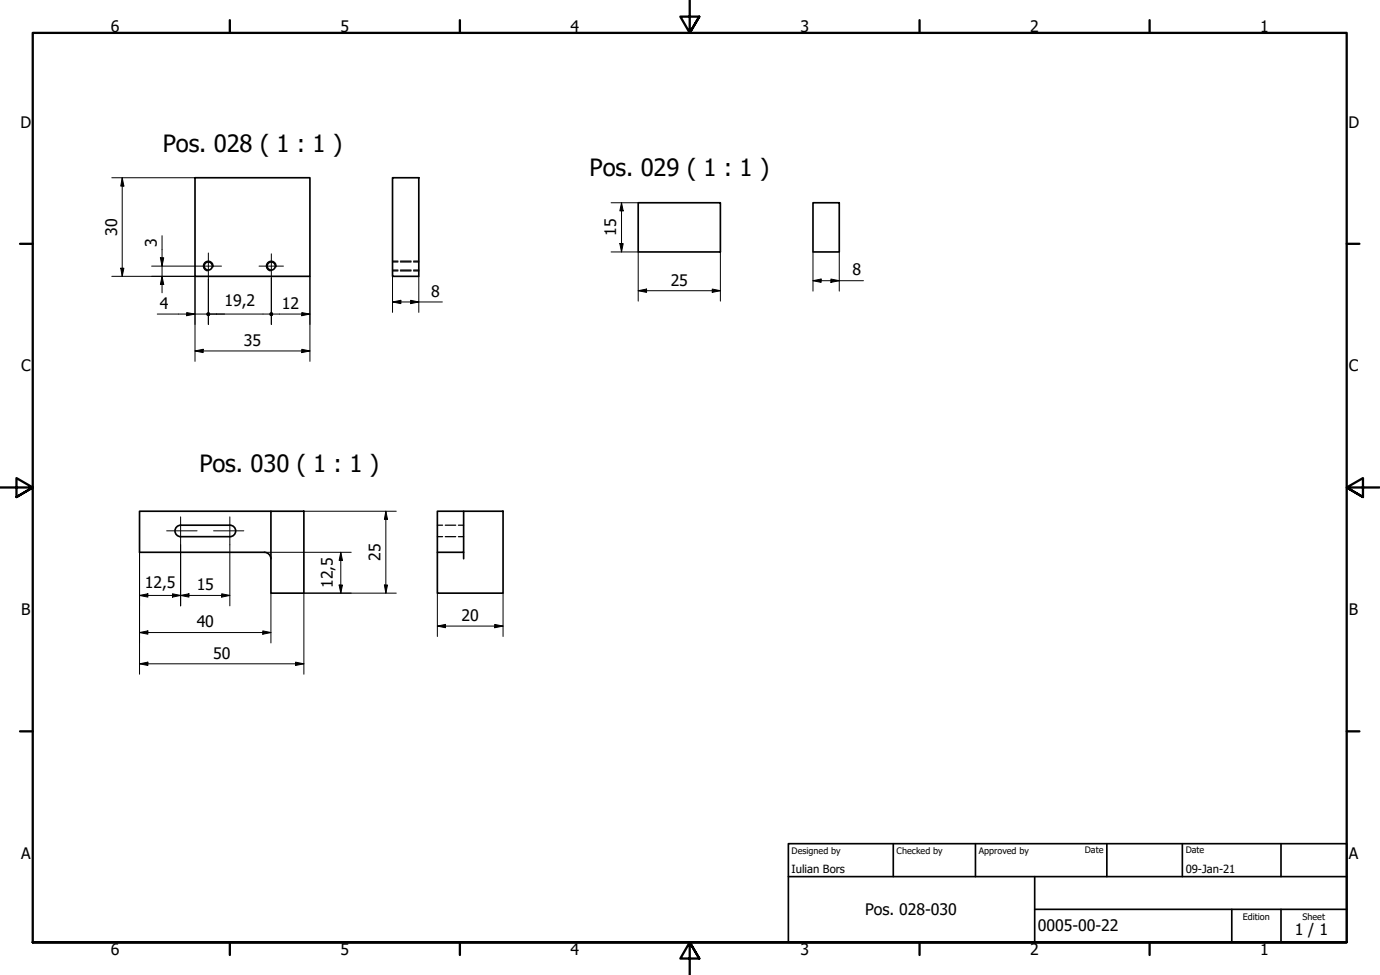
[picture p227: page 1]
Pos. 028 ( 1 : 1 ); Pos. 029 ( 1 : 1 ); Pos. 030 ( 1 : 1 )

Designed by Iulian Bors | Checked by | Approved by Date | Date 09-Jan-21

Pos. 028-030

0005-00-22 | Edition | Sheet 1 / 1
