TactileImages/TactilePrinterOne-P4/Imprimanta 2 Metal A3/Drawings/0008-10-001.pdf

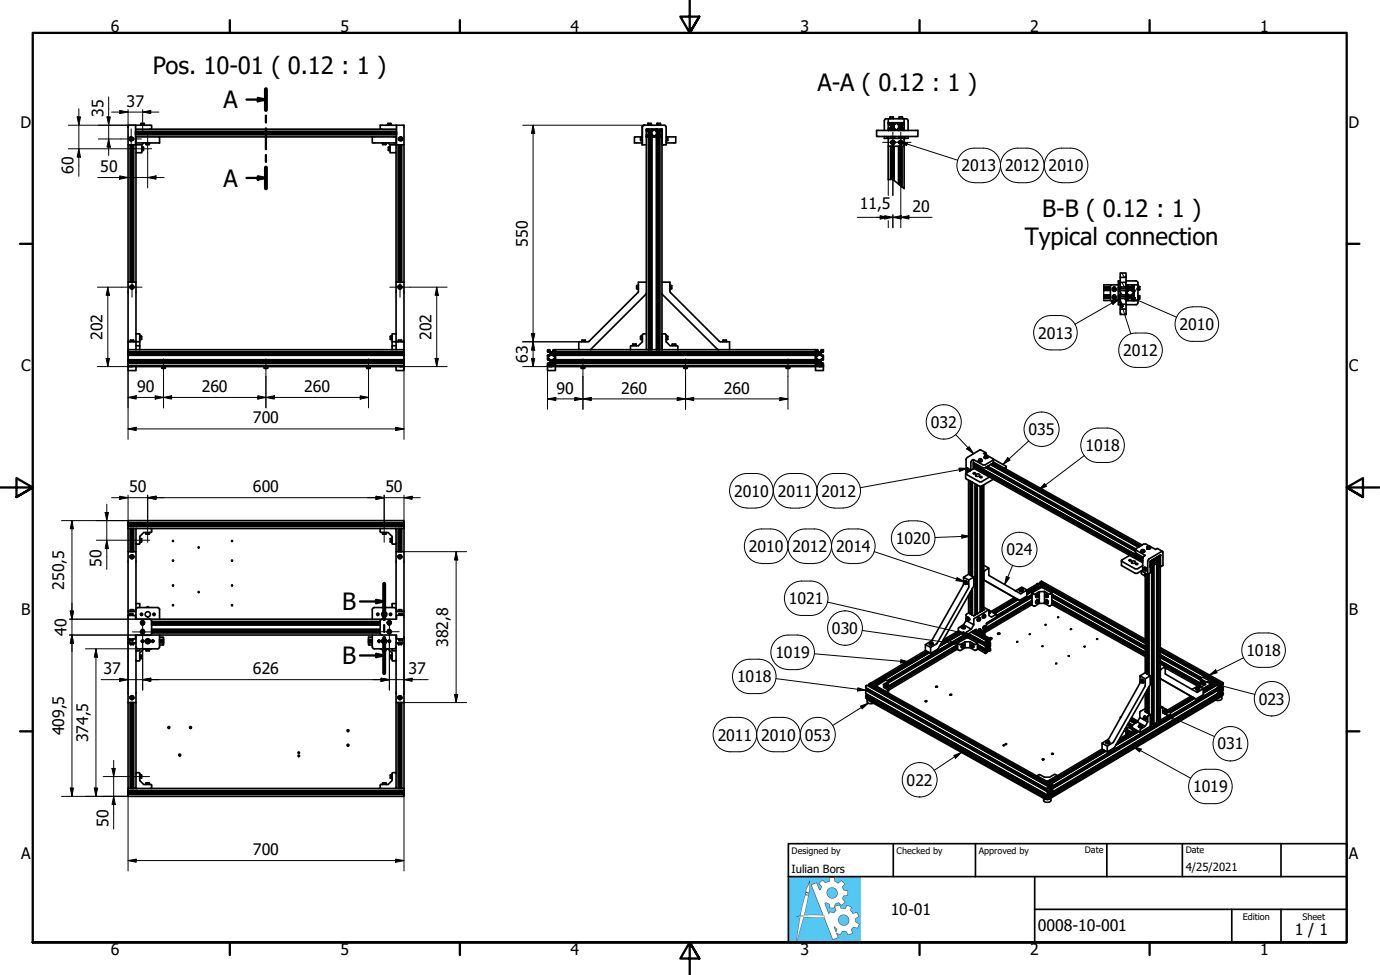
[picture p228: page 1]
Pos. 10-01 ( 0.12 : 1 ); B-B ( 0.12 : 1 ) Typical connection

Designed by Iulian Bors | Checked by | Approved by Date | Date 4/25/2021

0008-10-001 | Edition | Sheet 1 / 1
