TactileImages/TactilePrinterOne-P4/Imprimanta 2 Metal A3/Drawings/0008-10-002.pdf

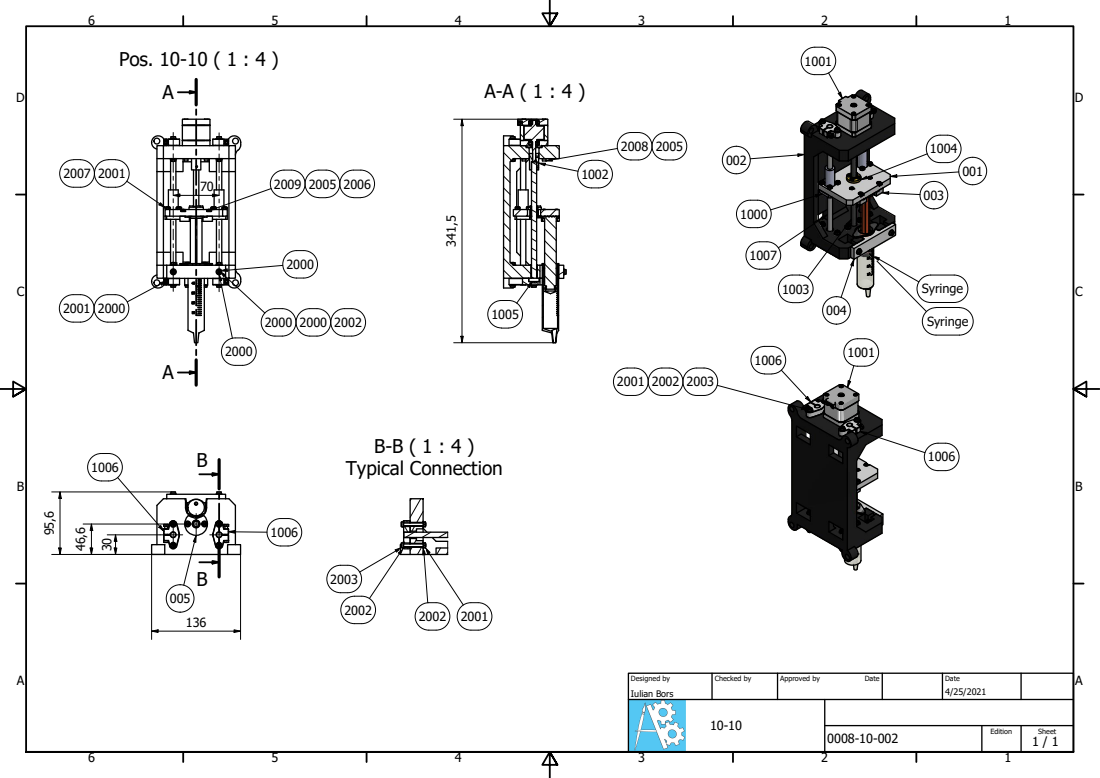
[picture p229: page 1]
Pos. 10-10 ( 1 : 4 ); B-B ( 1 : 4 ) Typical Connection

Designed by Iulian Bors | Checked by | Approved by Date | Date 4/25/2021

0008-10-002 | Edition | Sheet 1 / 1
