TactileImages/TactilePrinterOne-P4/Imprimanta 2 Metal A3/Drawings/0008-10-008.pdf

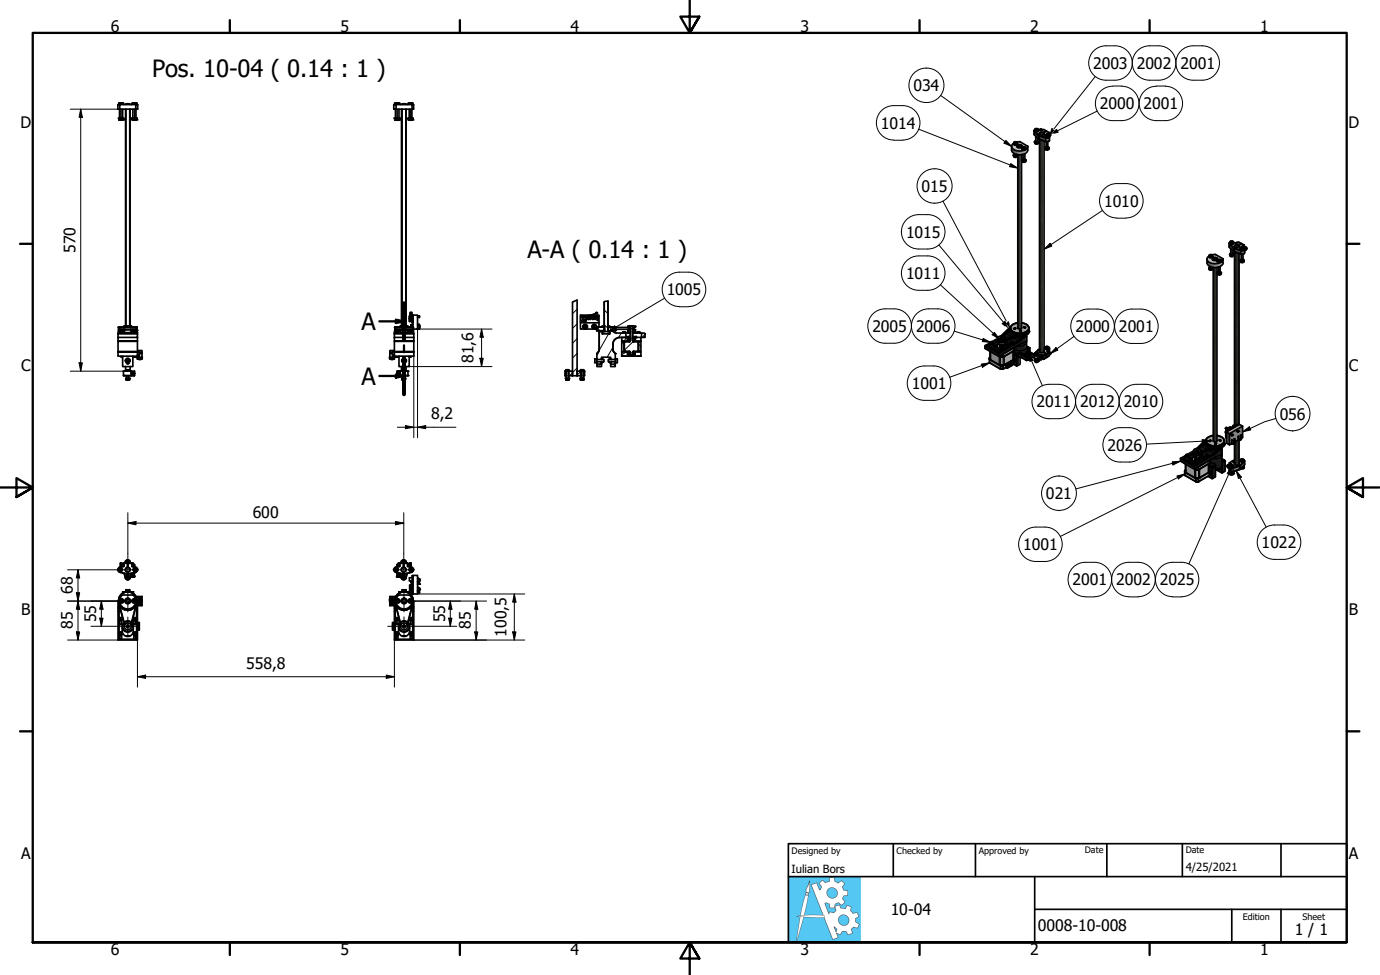
[picture p230: page 1]
Pos. 10-04 ( 0.14 : 1 )

Designed by Iulian Bors | Checked by | Approved by Date | Date 4/25/2021

0008-10-008 | Edition | Sheet 1 / 1
