TactileImages/TactilePrinterOne-P4/Imprimanta 2 Metal A3/Drawings/0008-10-009.pdf

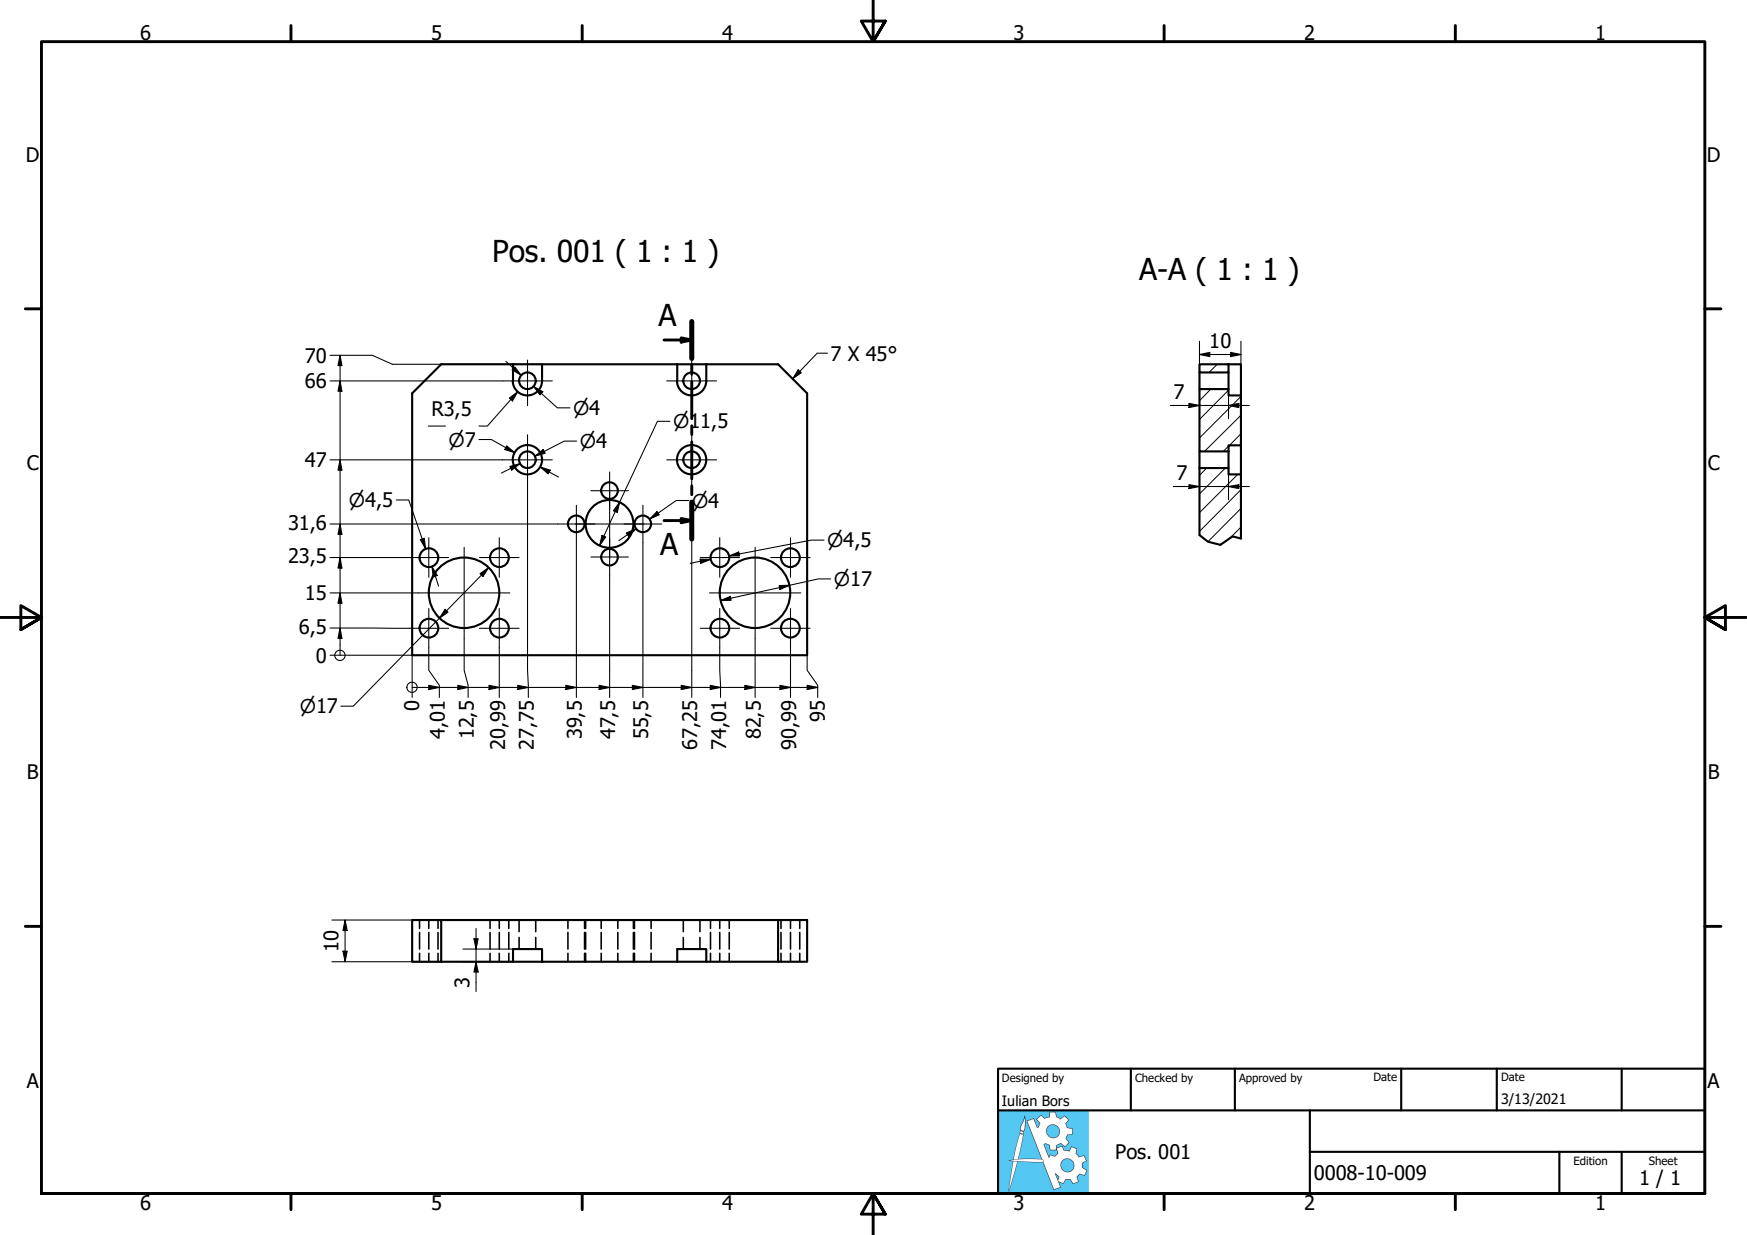
[picture p231: page 1]
Pos. 001 ( 1 : 1 )

Designed by Iulian Bors | Checked by | Approved by Date | Date 3/13/2021

Pos. 001

0008-10-009 | Edition | Sheet 1 / 1
