TactileImages/TactilePrinterOne-P4/Imprimanta 2 Metal A3/Drawings/0008-10-011.pdf

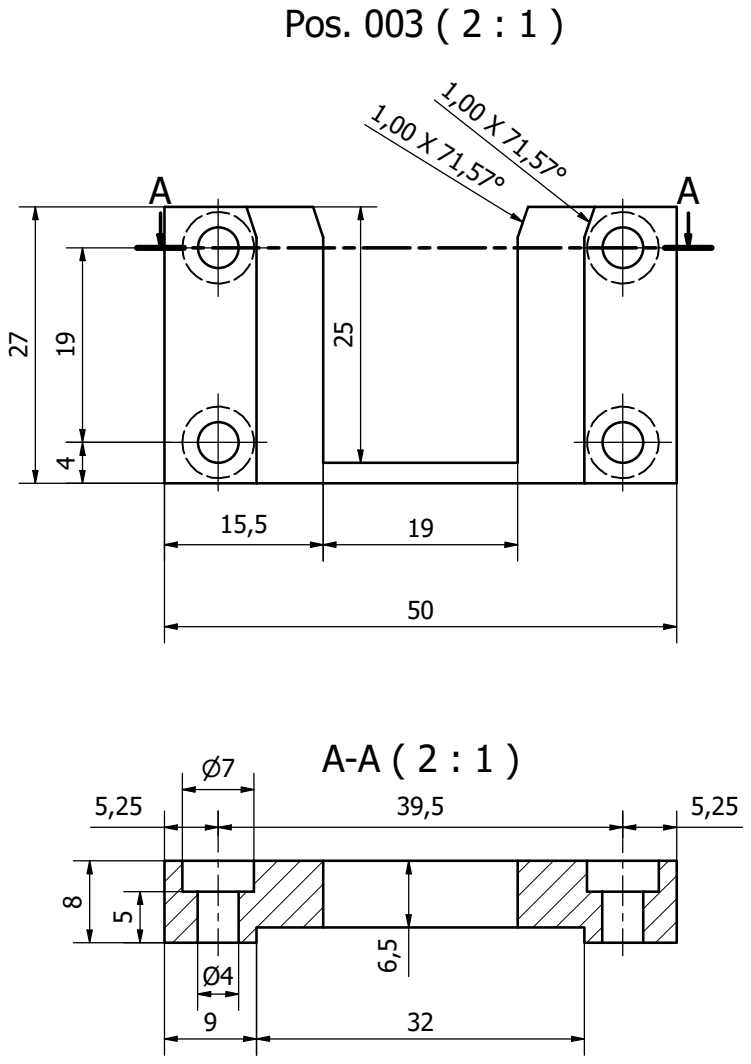
[picture p232: page 1]
Pos. 003 ( 2 : 1 )

Designed by Iulian Bors | Checked by | Approved by Date | Date 3/13/2021

Pos. 003

0008-10-011 | Edition | Sheet 1 / 1
