TactileImages/TactilePrinterOne-P4/Imprimanta 2 Metal A3/Drawings/0008-10-012.pdf

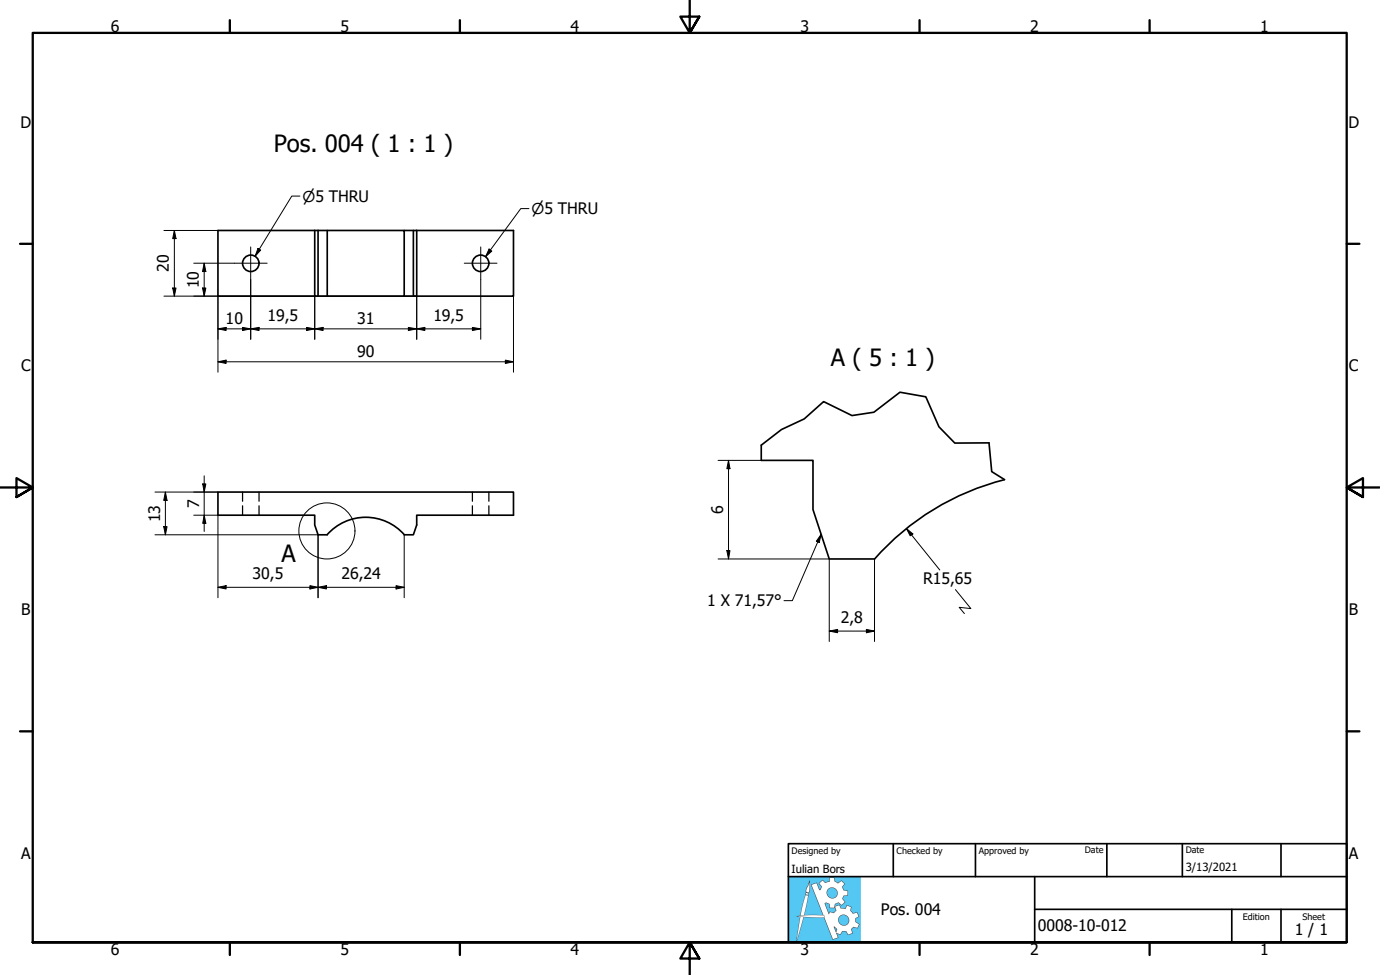
[picture p233: page 1]
Pos. 004 ( 1 : 1 )

Designed by Iulian Bors | Checked by | Approved by Date | Date 3/13/2021

Pos. 004

0008-10-012 | Edition | Sheet 1 / 1
