TactileImages/TactilePrinterOne-P4/Imprimanta 2 Metal A3/Drawings/0008-10-013.pdf

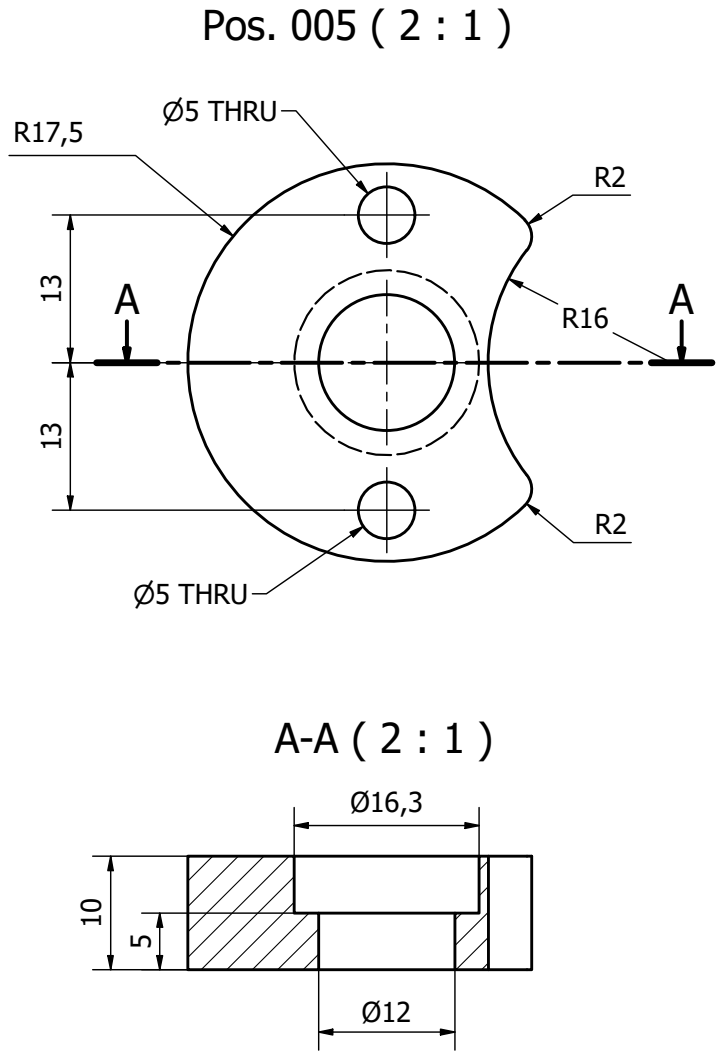
[picture p234: page 1]
Pos. 005 ( 2 : 1 )

Designed by Iulian Bors | Checked by | Approved by Date | Date 3/13/2021

Pos. 005

0008-10-013 | Edition | Sheet 1 / 1
