TactileImages/TactilePrinterOne-P4/Imprimanta 2 Metal A3/Drawings/0008-10-014.pdf

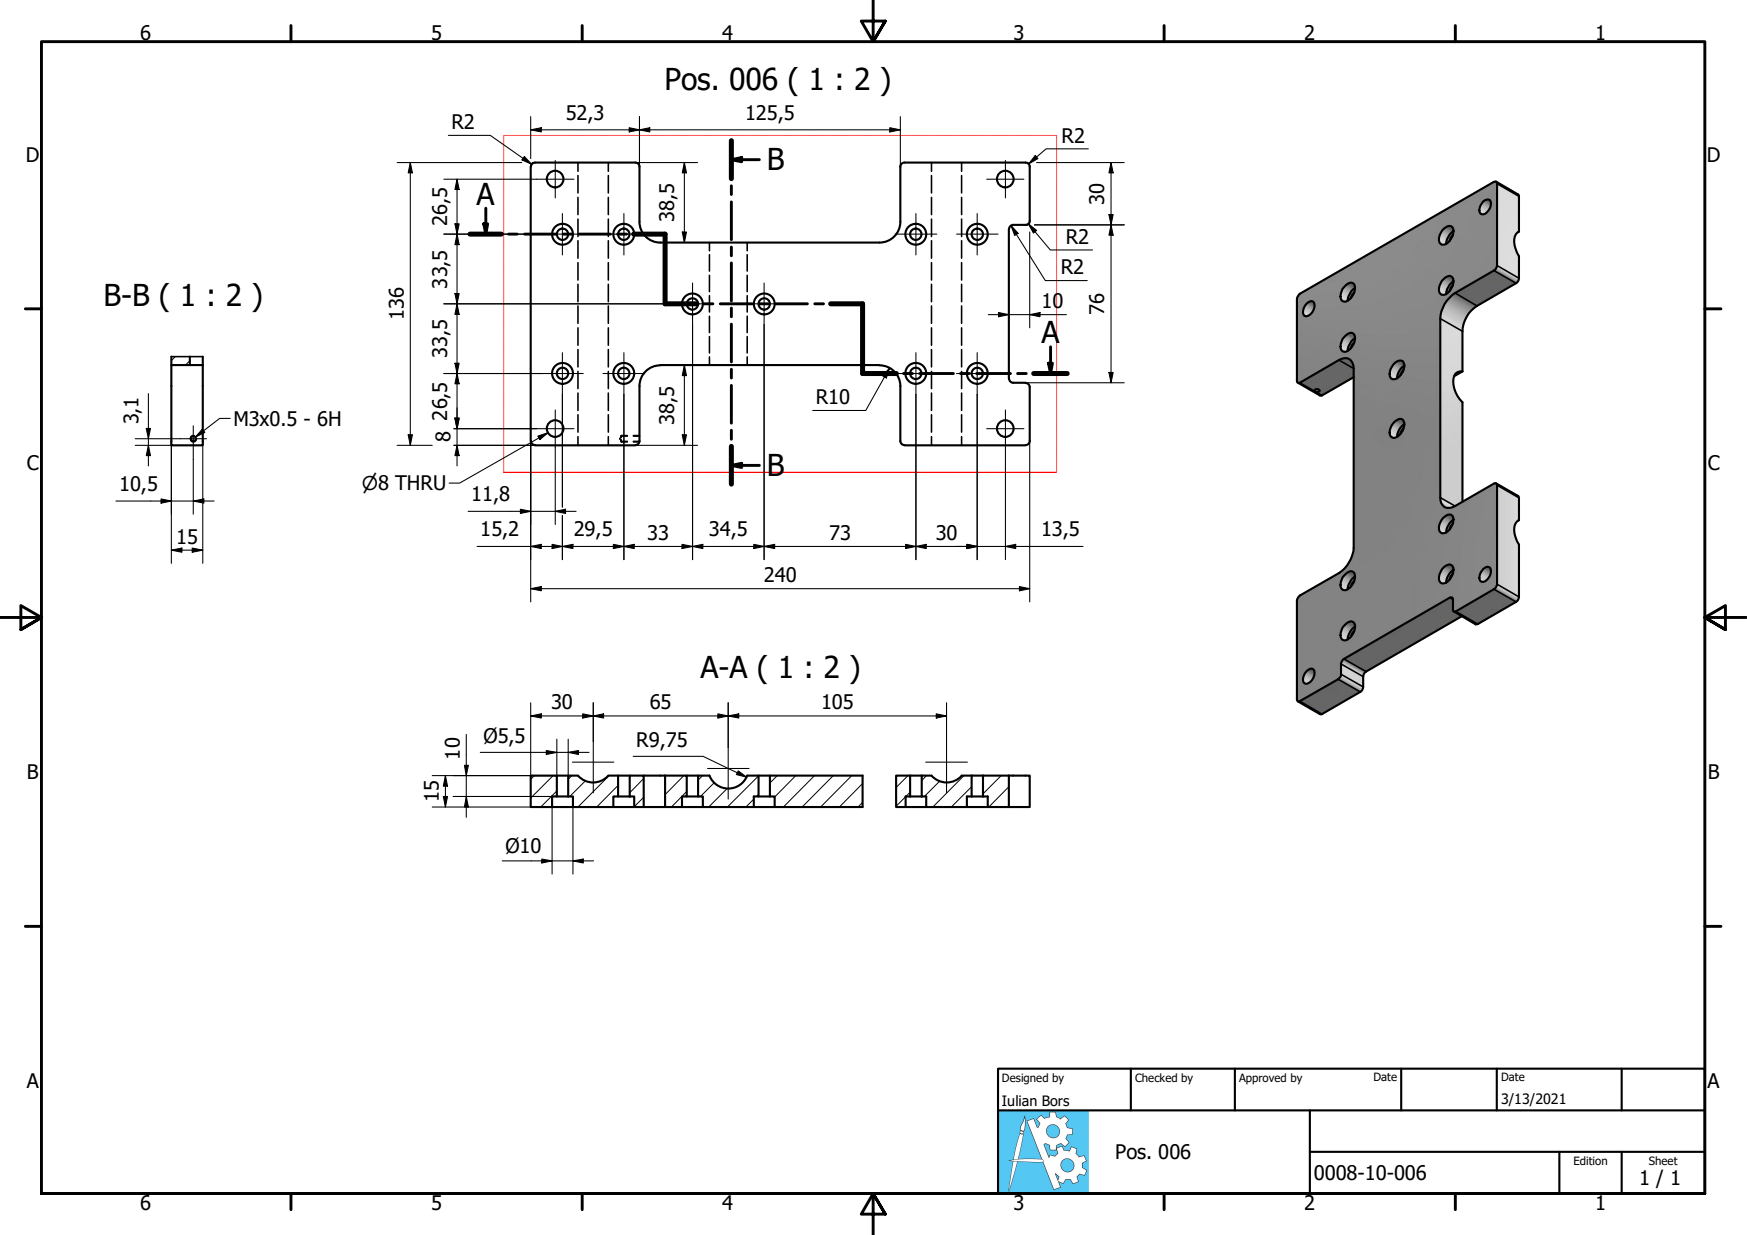
[picture p235: page 1]
Pos. 006 ( 1 : 2 )

Designed by Iulian Bors | Checked by | Approved by Date | Date 3/13/2021

Pos. 006

0008-10-006 | Edition | Sheet 1 / 1
