TactileImages/TactilePrinterOne-P4/Imprimanta 2 Metal A3/Drawings/0008-10-015.pdf

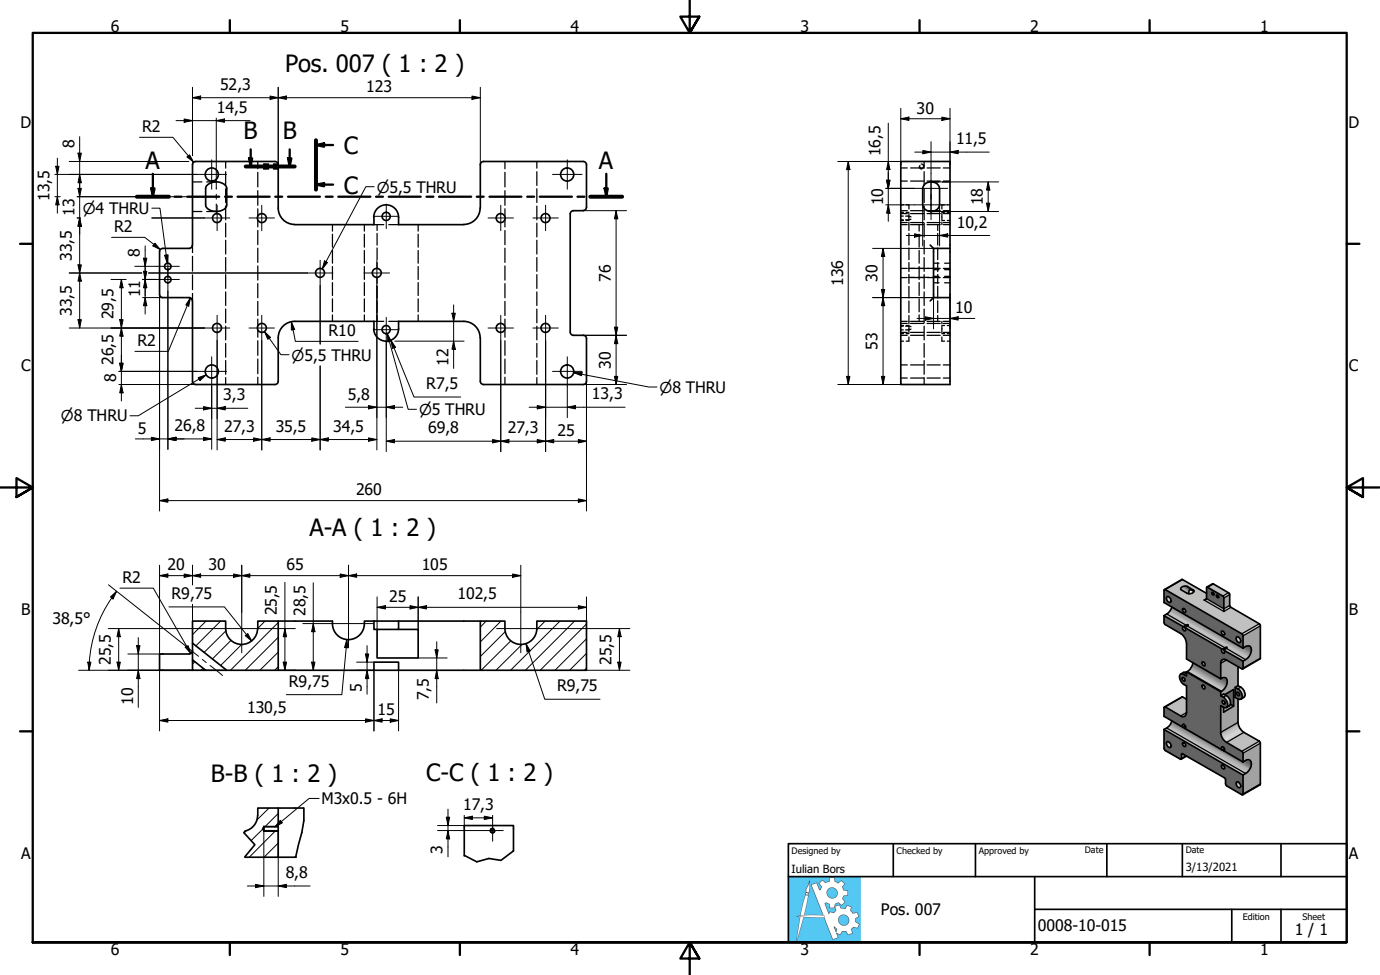
[picture p236: page 1]
Pos. 007 ( 1 : 2 )

Designed by Iulian Bors | Checked by | Approved by Date | Date 3/13/2021

Pos. 007

0008-10-015 | Edition | Sheet 1 / 1
