TactileImages/TactilePrinterOne-P4/Imprimanta 2 Metal A3/Drawings/0008-10-016.pdf

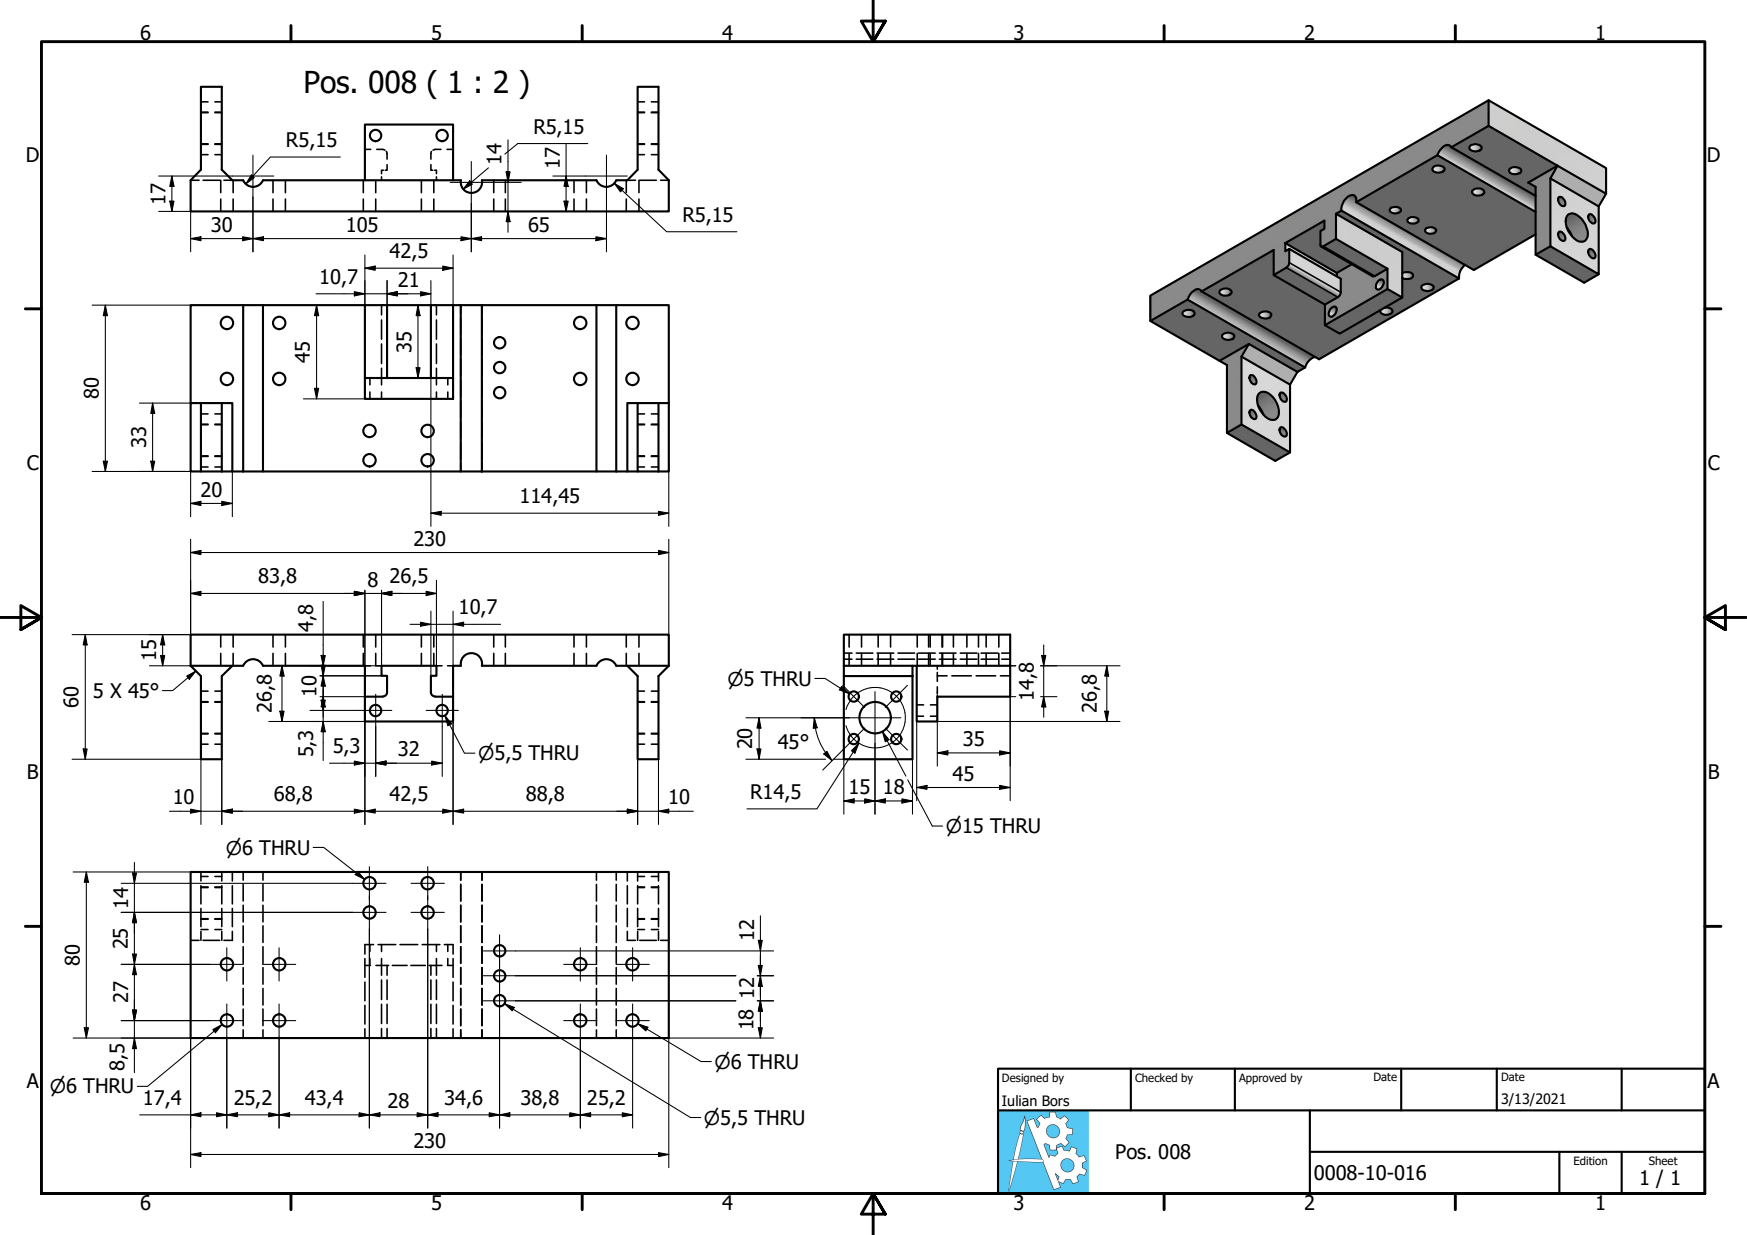
[picture p237: page 1]
Pos. 008 ( 1 : 2 )

Designed by Iulian Bors | Checked by | Approved by Date | Date 3/13/2021

Pos. 008

0008-10-016 | Edition | Sheet 1 / 1
