TactileImages/TactilePrinterOne-P4/Imprimanta 2 Metal A3/Drawings/0008-10-017.pdf

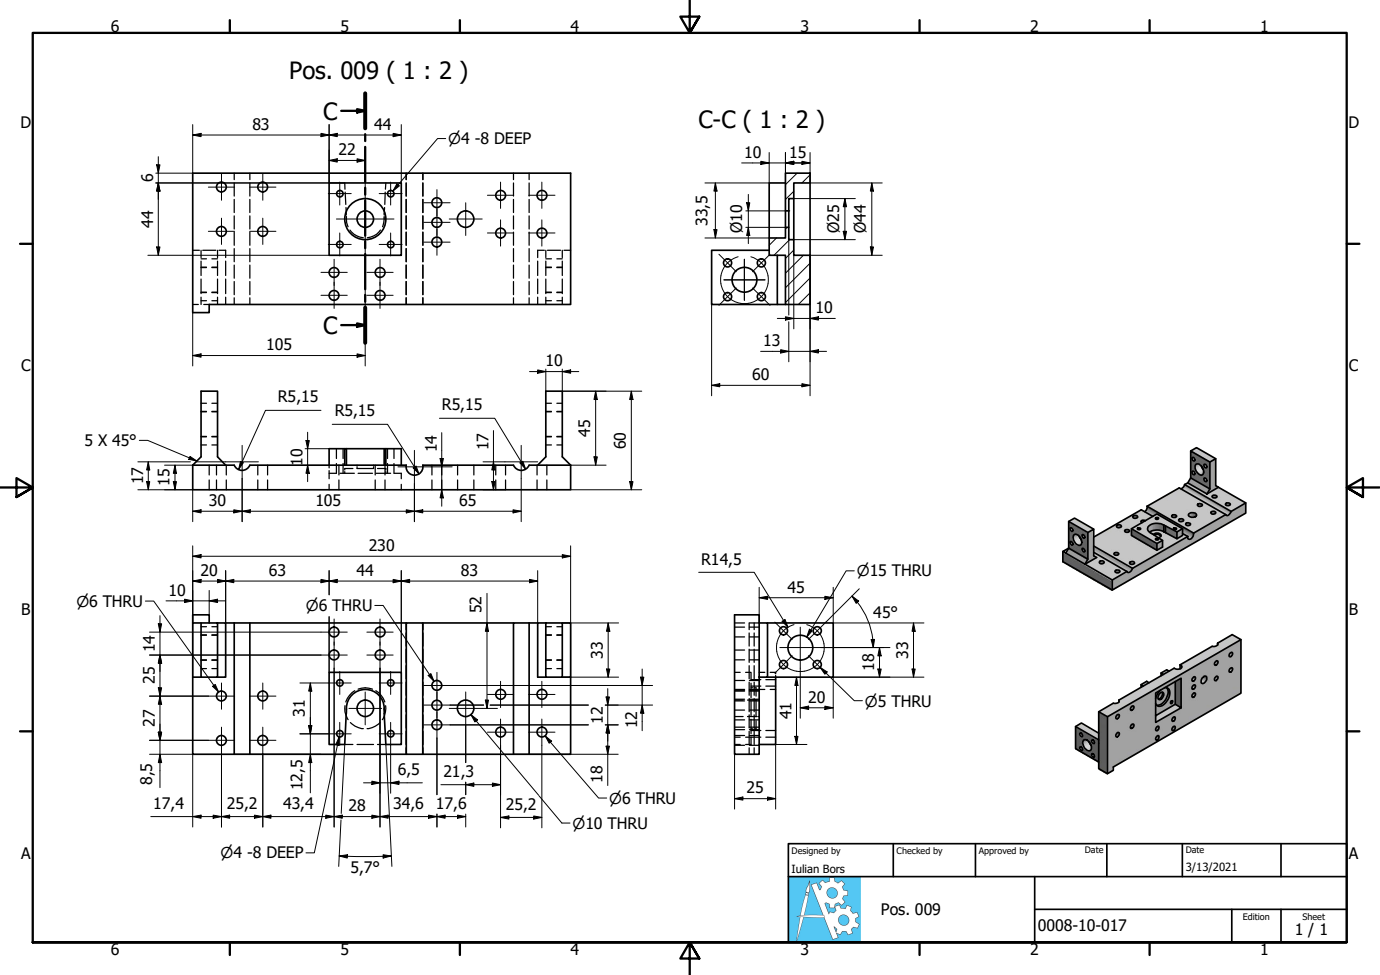
[picture p238: page 1]
Pos. 009 ( 1 : 2 )

Designed by Iulian Bors | Checked by | Approved by Date | Date 3/13/2021

Pos. 009

0008-10-017 | Edition | Sheet 1 / 1
