TactileImages/TactilePrinterOne-P4/Imprimanta 2 Metal A3/Drawings/0008-10-018.pdf

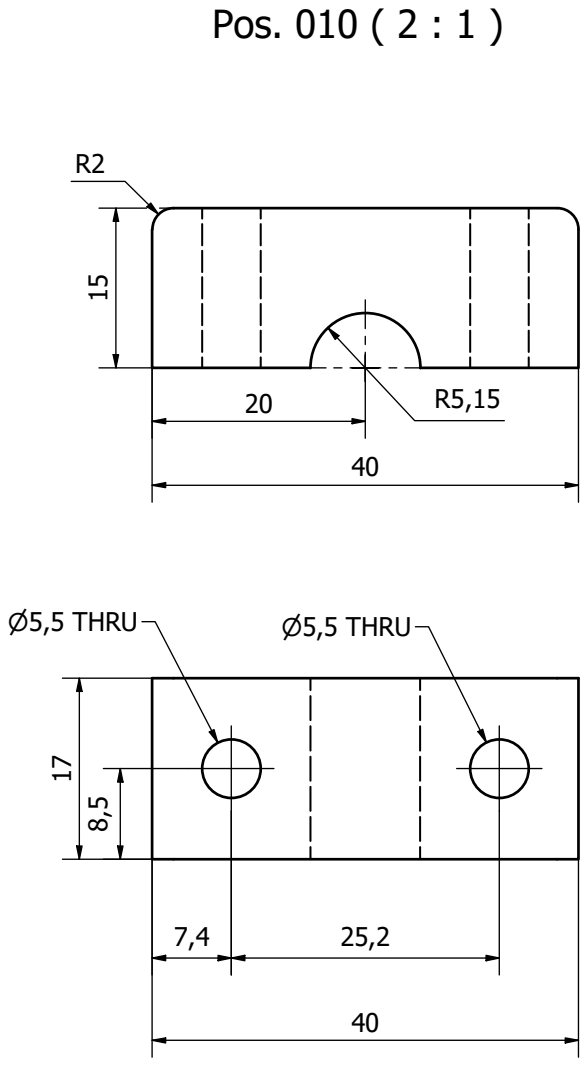
[picture p239: page 1]
Pos. 010 ( 2 : 1 )

Designed by Iulian Bors | Checked by | Approved by Date | Date 3/13/2021

Pos. 010

0008-10-018 | Edition | Sheet 1 / 1
