TactileImages/TactilePrinterOne-P4/(commit log)

2021-09-20 Imprimanta 4 A4 Metal
    [Arduino Case Body.stl, Arduino Case Cover.stl, BOM Aluminum 3D Printer.xlsx, Connector Case Body.stl, Connector Case Cover.stl, Needle Parking Plastic Body.stl, Plastic Backplate.stl, Plastic T8 Nut Housing.stl]
2021-09-20 Imprimanta 3 A4 Lemn Patf Fixa
    [Arduino Case Cover.stl, Arduino Case.stl, BOM 3D Printer.xlsx, Connector Case Cover.stl, Connector Case.stl, Extruder Carrier Plastic Body.stl, Extruder Carrier Plastic Protective Cover.stl, Holder Z Movement Plastic Body.stl]
2021-09-20 Imprimanta 2 Metal A3
    [00008-20-1004 PowerSupplyLedMax500.ipt, 0005-20-00 Electric 1.0009.idw, 0005-20-01 Electric 2.0033.idw, 0008-00-00 Partlist.xls, 0008-10-001 (1).idw, 0008-10-001.dwg, 0008-10-001.idw, 0008-10-001.ipt]
2021-09-20 Imprimanta 1 Lemn
    [00005-20-1004 PowerSupplyLedMax500.0001.ipt, 00005-20-1004 PowerSupplyLedMax500.ipt, 0005-00-00 Ansamblu General.0019.idw, 0005-00-00 Ansamblu General.dwg, 0005-00-00 Ansamblu General.idw, 0005-00-00 Ansamblu_General.0168.iam, 0005-00-00 Ansamblu_General.iam, 0005-00-00 Ansamblu_General_V1.0025.iam]
